cskilbeck/clock_monsieur/firmware/todo.txt

X add reset button
X use GPIO0 for one of the buttons
X fix usb/jtag
X half-bridge driver for anodes + n channel level shifter
X 4 layers
X shrink clock face radius
X flip clock leds, anode on the outside
X A15/A14 at the top (the long ones)
X test points everywhere
X tweak TLC5948 footprint
X fix esp-prog header pinout
X provisioning stuff in factory partition
X OTA firmware update
X measure/tweak cc drain capacitors
X save/load settings in NVS
X small font for menus
X diagnose esp-prog boot / reset problem
X back compatible settings format changes
X save timezone in settings
X Fix factory reset UI
X menus
    X 12/24
    X Seconds mode
    X Colon mode
    X Auto brightness on/off
    X Clock font
    X Brightness
    X Set timezone
    X Show mac address
    X Tick mode on/off/dim/track
X Auto-save settings
X bigger less ridiculous buttons
X put ambient light sensor on the front
X tweak Ambient light sensor gamma ramp
X fancy menu scrolling
X test timezone transition (poke something into the database)

- fancy scrolling in timezone chooser
- button auto-repeat
- AM/PM font for 12 hour clock
- frosted glass/gel problem
