cskilbeck/clock_monsieur/Clock Monsieur.docx

# Clock Monsieur

# Table of Contents

# Assembly

sdadads

# Wi-Fi Instructions

To set up the Wi-Fi on your device

1. On your phone, install App ESP BLE Provisioning

Note: App is not required for normal operation; you can remove it when the setup is complete

2. In the ESP BLE Provisioning app, scan the QR code on the back of the device
3. Select your Wi-Fi network
4. Enter Wi-Fi password (if there is one)

# Factory Reset

Lksdfjlksd flksd j

# Firmware Flashing

adsfasdfd

# Timezone

dssd

# Menus

asdasdas

# Troubleshooting

jkhkjh
