cskilbeck/clock_monsieur/pcb/Outputs/2026-02-18/Bill of Materials-clock_led.xlsx

Comment | Designator | Footprint | JLCPCB Part #
SW-SMD_YZA-072-7.0 | BOOT | FSM-SWITCH-6x6x7.0 | C722968
BUZZER_MLT-7525 | BUZZER | BUZZER_XHXDZ_SMD8530 | C95299
100nF | C1 | CAPC_0603_1608X08L | C7501158
100nF | C2 | CAPC_0603_1608X08L | C7501158
1uF | C3 | CAPC_1206_3216X16L | C5448921
100nF | C4 | CAPC_0603_1608X08L | C7501158
100pF | C5 | CAP_0402 | C1546
100pF | C6 | CAP_0402 | C1546
100pF | C7 | CAP_0402 | C1546
100pF | C8 | CAP_0402 | C1546
100pF | C9 | CAP_0402 | C1546
100pF | C10 | CAP_0402 | C1546
100pF | C11 | CAP_0402 | C1546
100pF | C12 | CAP_0402 | C1546
100pF | C13 | CAP_0402 | C1546
100pF | C14 | CAP_0402 | C1546
100pF | C15 | CAP_0402 | C1546
100pF | C16 | CAP_0402 | C1546
100pF | C17 | CAP_0402 | C1546
100pF | C18 | CAP_0402 | C1546
100pF | C19 | CAP_0402 | C1546
100pF | C20 | CAP_0402 | C1546
100nF | C21_D1 | CAP_0402 | ????
100nF | C21_D2 | CAP_0402 | ????
100nF | C21_D3 | CAP_0402 | ????
100nF | C21_D4 | CAP_0402 | ????
100nF | C21_D5 | CAP_0402 | ????
100nF | C21_D6 | CAP_0402 | ????
100nF | C21_D7 | CAP_0402 | ????
100nF | C21_D8 | CAP_0402 | ????
1uF | C22 | CAPC_1206_3216X16L | C5448921
100nF | C23 | CAPC_0603_1608X08L | C7501158
1uF | C24 | CAPC_1206_3216X16L | C5448921
1uF | C25 | CAPC_1206_3216X16L | C5448921
LED | D1 | LED_0402 | C25503345
LED | D2 | LED_0402 | C25503345
LED | D3 | LED_0402 | C25503345
LED | D4 | LED_0402 | C25503345
LED | D5 | LED_0402 | C25503345
LED | D6 | LED_0402 | C25503345
LED | D7 | LED_0402 | C25503345
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
SW-SMD_YZA-072-7.0 | SW3 | FSM-SWITCH-6x6x7.0 | C722968
SW-SMD_YZA-072-7.0 | SW4 | FSM-SWITCH-6x6x7.0 | C722968
GT-USB-7055BB | USB | USB-C-TH_GT-USB-7055BB | C7450621
ESP32-S3-WROOM-1-N4 | WiFi_Module | XCVR_ESP32-S3-WROOM-1-N16R2 | C2913197
