cskilbeck/clock_monsieur/pcb/Models/SW-SMD-6x6x5.5.step

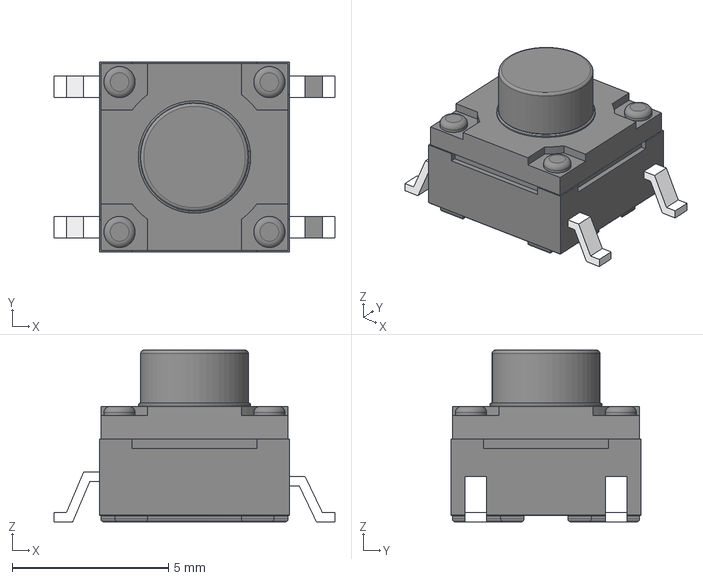
[picture p1: CAD file, 2025-12-19]
pcb/Models/SW-SMD-6x6x5.5.step
9.00 x 6.10 x 5.50 mm
