cskilbeck/clock_monsieur/pcb/Outputs/2026-02-18/clock_led.step

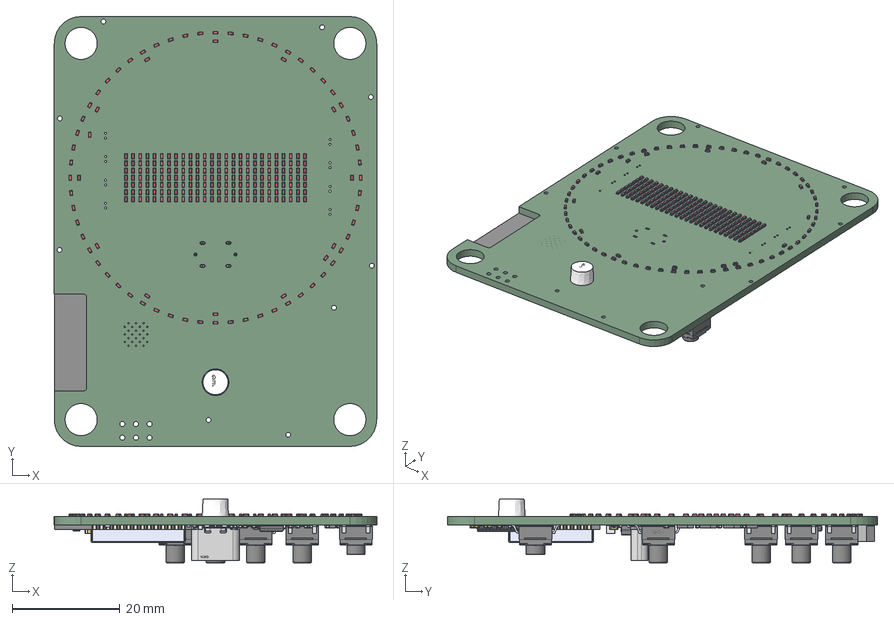
[picture p2: CAD file, 2026-02-19]
pcb/Outputs/2026-02-18/clock_led.step
60.0 x 80.0 x 11.8 mm
lead x 6
Leader x 27
BUZ-SMD_4P-L8.5-W8.5_FUET-8530-05~BUZ-SMD_4P-L8.5-W8.5-H3.0_ FUET-8530-05~5bKo x 9
0402 resistor x 8
EVERLIGHT_ALS-PT243-3C
SW-SMD-6x6x7.0 x 5
DFN-8_L2.0-W2.0-P0.50-BL-EP~DFN-8_L2.0-W2.0-H0.8-P0.50~jj2n x 8
SW-SMD-6x6x5.5
Lead x 3
Tab
USB-C-TH_GT-USB-7055BB_ORIGIN
LED0402 x 256
