cskilbeck/clock_monsieur/enclosure/stand.SLDPRT

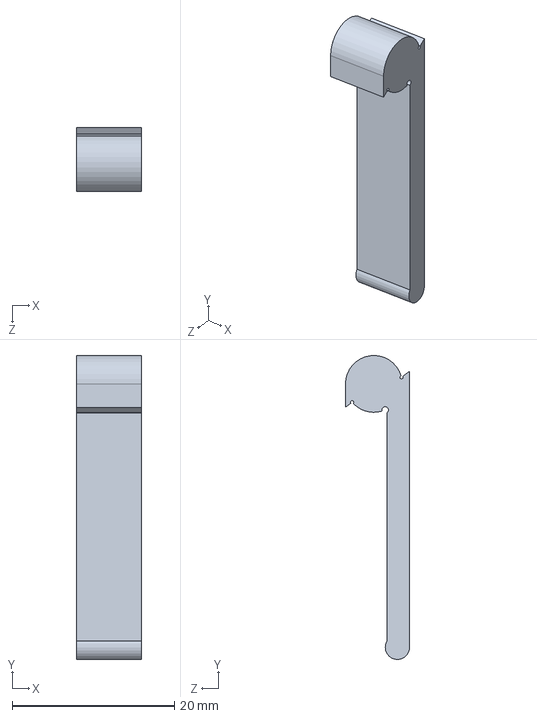
[picture p3: CAD file, 2026-02-23]
enclosure/stand.SLDPRT
8.00 x 37.4 x 7.90 mm
