cskilbeck/clock_monsieur/pcb/Models/SW-SMD-6x6x7.0.step

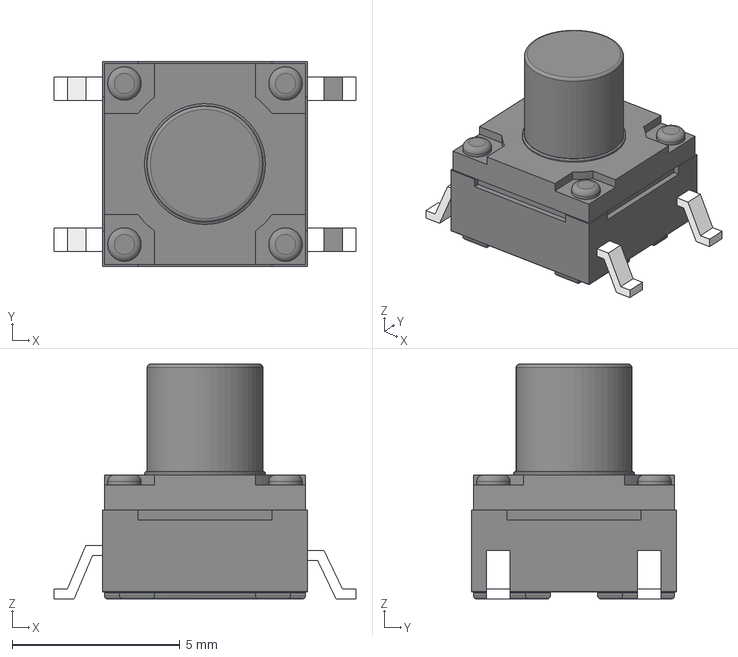
[picture p4: CAD file, 2025-12-19]
pcb/Models/SW-SMD-6x6x7.0.step
9.00 x 6.10 x 7.00 mm
