cskilbeck/clock_monsieur/enclosure/glass.SLDPRT

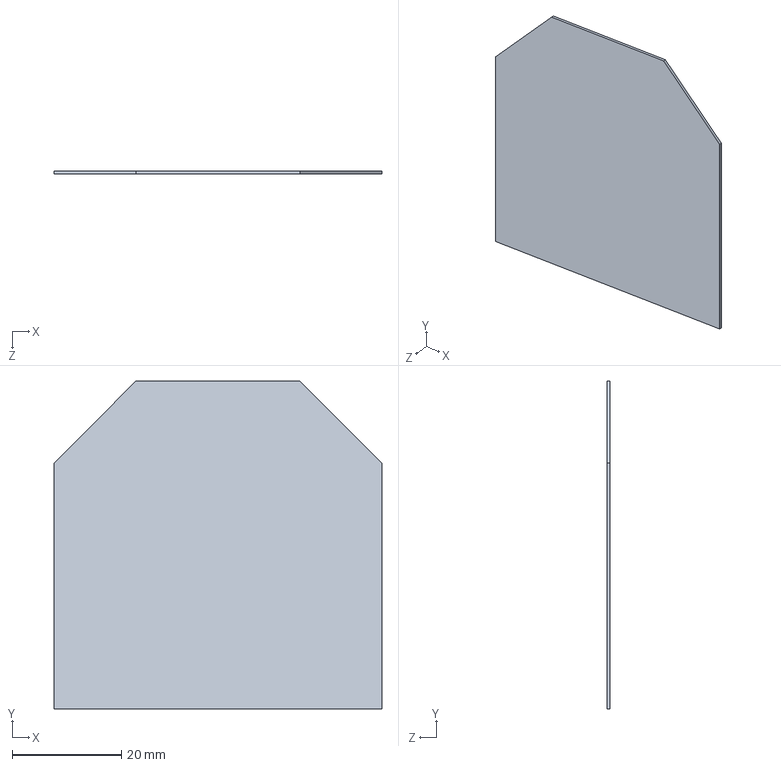
[picture p5: CAD file, 2026-02-23]
enclosure/glass.SLDPRT
60.0 x 60.0 x 0.61 mm
