cskilbeck/clock_monsieur/enclosure/screw_st2_2x6_5_c_0.SLDPRT

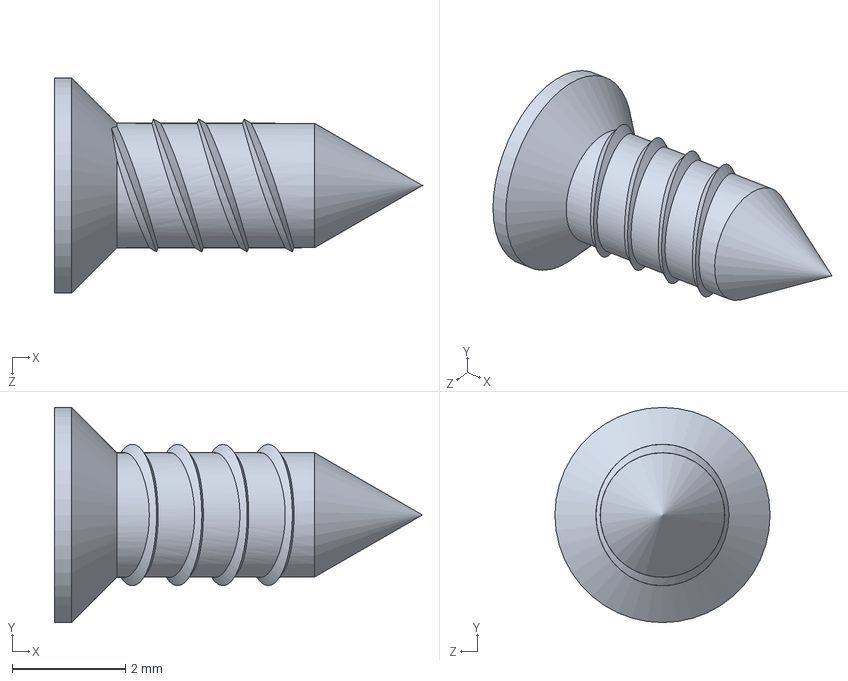
[picture p6: CAD file, 2025-12-19]
enclosure/screw_st2_2x6_5_c_0.SLDPRT
6.50 x 3.80 x 3.80 mm
