cskilbeck/clock_monsieur/pcb/Outputs/2025-11-04/clock_led.step

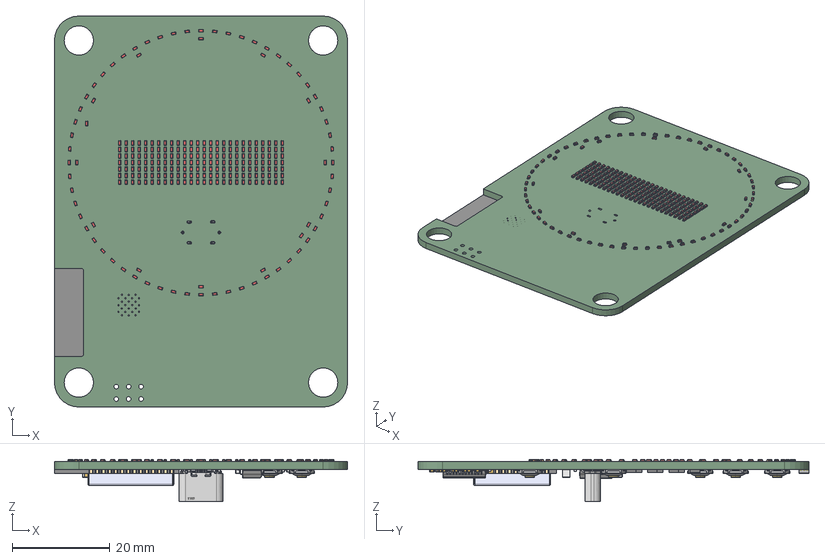
[picture p7: CAD file, 2025-11-04, an earlier design]
pcb/Outputs/2025-11-04/clock_led.step
60.0 x 80.0 x 8.62 mm
swt0220-016016gsa x 6
Leader x 24
Thermal_Shape x 8
Pin_Shape x 64
0402 resistor x 5
U1~TDFN-6_L2.0-W2.0-P0.65-BL~TDFN-6_L2.0-W2.0-H0.8-P0.65-BL~aoMD - TDFN-6_L2.0-W2.0-P0.65-BL~TDFN-6_L2.0-W2.0-H0.8-P0.65-BL~aoMD
Lead x 3
Tab
USB-C-TH_GT-USB-7055BB_ORIGIN
LED0402 x 256
