cskilbeck/clock_monsieur/enclosure/clock_monsieur.SLDASM

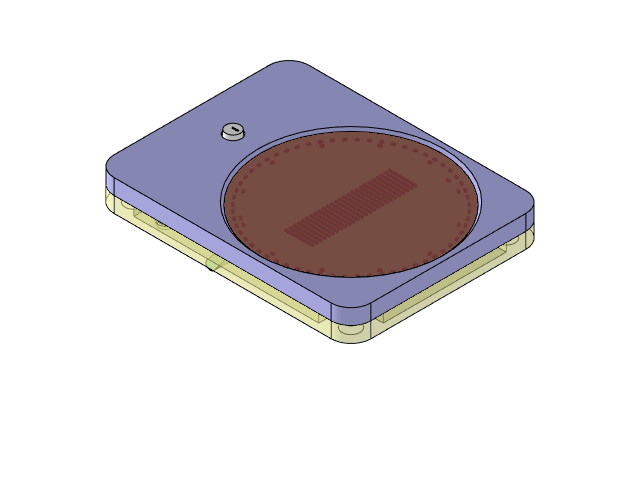
[picture p8: CAD file, 2026-02-23]
enclosure/clock_monsieur.SLDASM
front
glass
back
screw_st2_2x6_5_c_0
stand
clock_led_pcb
