cskilbeck/clock_monsieur/enclosure/enclosure.SLDASM

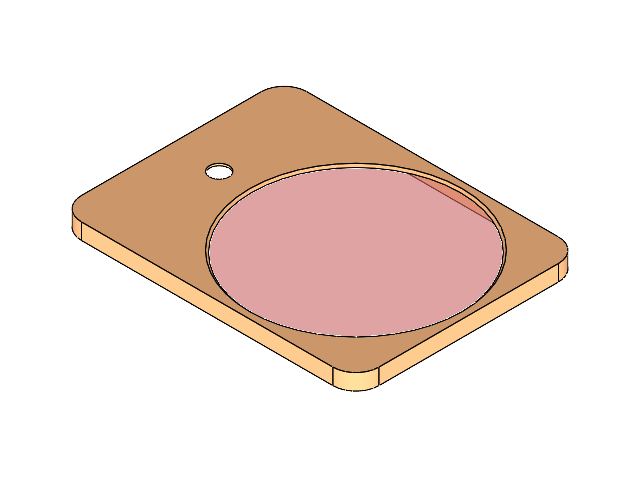
[picture p9: CAD file, 2026-02-23]
enclosure/enclosure.SLDASM
front
glass
back
