cskilbeck/clock_monsieur/(list of files, cad)

Other CAD files:
enclosure/front.SLDPRT
enclosure/clock_led_pcb.SLDPRT
enclosure/back.SLDPRT
enclosure/clock_led.step
pcb/Outputs/2025-12-19/clock_led.step
pcb/Outputs/2025-12-22/clock_led.step
pcb/Outputs/2026-01-08/clock_led.step
pcb/Outputs/2026-01-17/clock_led.step
