cskilbeck/clock_monsieur/Instructions.docx

Clock Monsieur

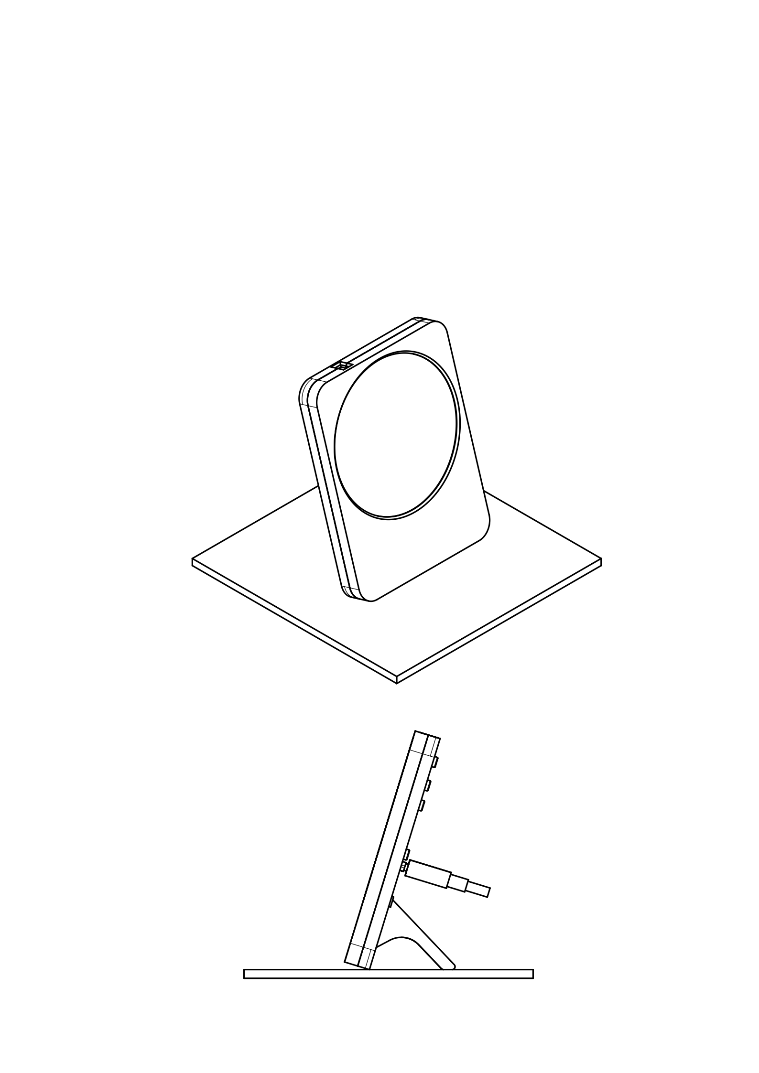
[picture p10: figure]

# Features

- The clock is Wi-Fi enabled, so it's ALWAYS right
- Continuously monitors multiple network time servers for redundancy
- Global timezone database stores all Daylight Savings Times to the exact second
- Daylight savings time is updated instantly at the correct millisecond
- Select timezone manually or automatically (using Geo-IP database lookup)
- Bright LED display is super visible in any conditions
- Ambient light sensor for auto brightness
- Fully configurable display - seconds, font, colon etc
- Wi-Fi provisioning via standard Espressif App (ESP BLE Provisioning)
- Over-the-air firmware update capability

# Dimensions

- Display 60mm diameter
- Digits 10mm high
- Body 63mm wide, 84mm tall, 10mm deep

# Connectivity

- Wi-Fi (Global time synchronization, firmware update)
- USB-C (Power, firmware update)

# Power

- USB 5V, 500mA

# Buttons

There are 6 buttons…

- Reset – reset the clock
- Up/Down/Left/Right – Navigate menus
- Select – select menu item
- Hold any of Up/Down/Left/Right/Select while the clock is reset or powering up to enter Factory Reset mode.

# Factory Reset

How to factory reset.

# Provisioning

To provision your device…

# Menus

Press the Select key to activate the menu system.

| Menu | | | Function
| Settings
| | Mode | | Choose clock 12/24-hour mode
| | Brightness | | Brightness settings
| | | Auto/Fixed | Set Auto/Fixed brightness
| | | Level | Brightness Level - Low, Medium, High, Max
| | Seconds | | Set Seconds mode
| | | Single | Only current second
| | | Fixed | All seconds so far in this minute
| | | Long | Long tail of seconds
| | | Medium | Medium tail of seconds
| | | Short | Short tail of seconds
| | Colon | | Set colon mode
| | | Off | No colon
| | | On | Colon normal
| | | Dim | Colon dimmed
| | | Pulse | Colon pulses at 0.5Hz
| | Ticks
| | | On | 5-minute Ticks are always on
| | | Off | Ticks always off
| | | Dim | Ticks always dim
| | | Track | Ticks track seconds
| | Font | | Choose clock time font Normal/Square
| | Fade | | Set second-to-second fade
| | | Low | 0.25 second fade
| | | Medium | 0.5 second fade
| | | High | 1 second fade
| | | Off | No fade, seconds/time instant transition
| Timezone | | | Timezone settings
| | Auto | | Use IP lookup for auto timezone location
| | Select | | Choose timezone location manually
| System | | | System info/settings
| | Version | | Show software version
| | IP Address | | Show IP address
| | MAC Address | | Show MAC Address
| | Factory reset | | Factory reset (all user and wifi settings)
