cskilbeck/clock_monsieur/pcb/Outputs/2026-02-18/clock_led.pdf

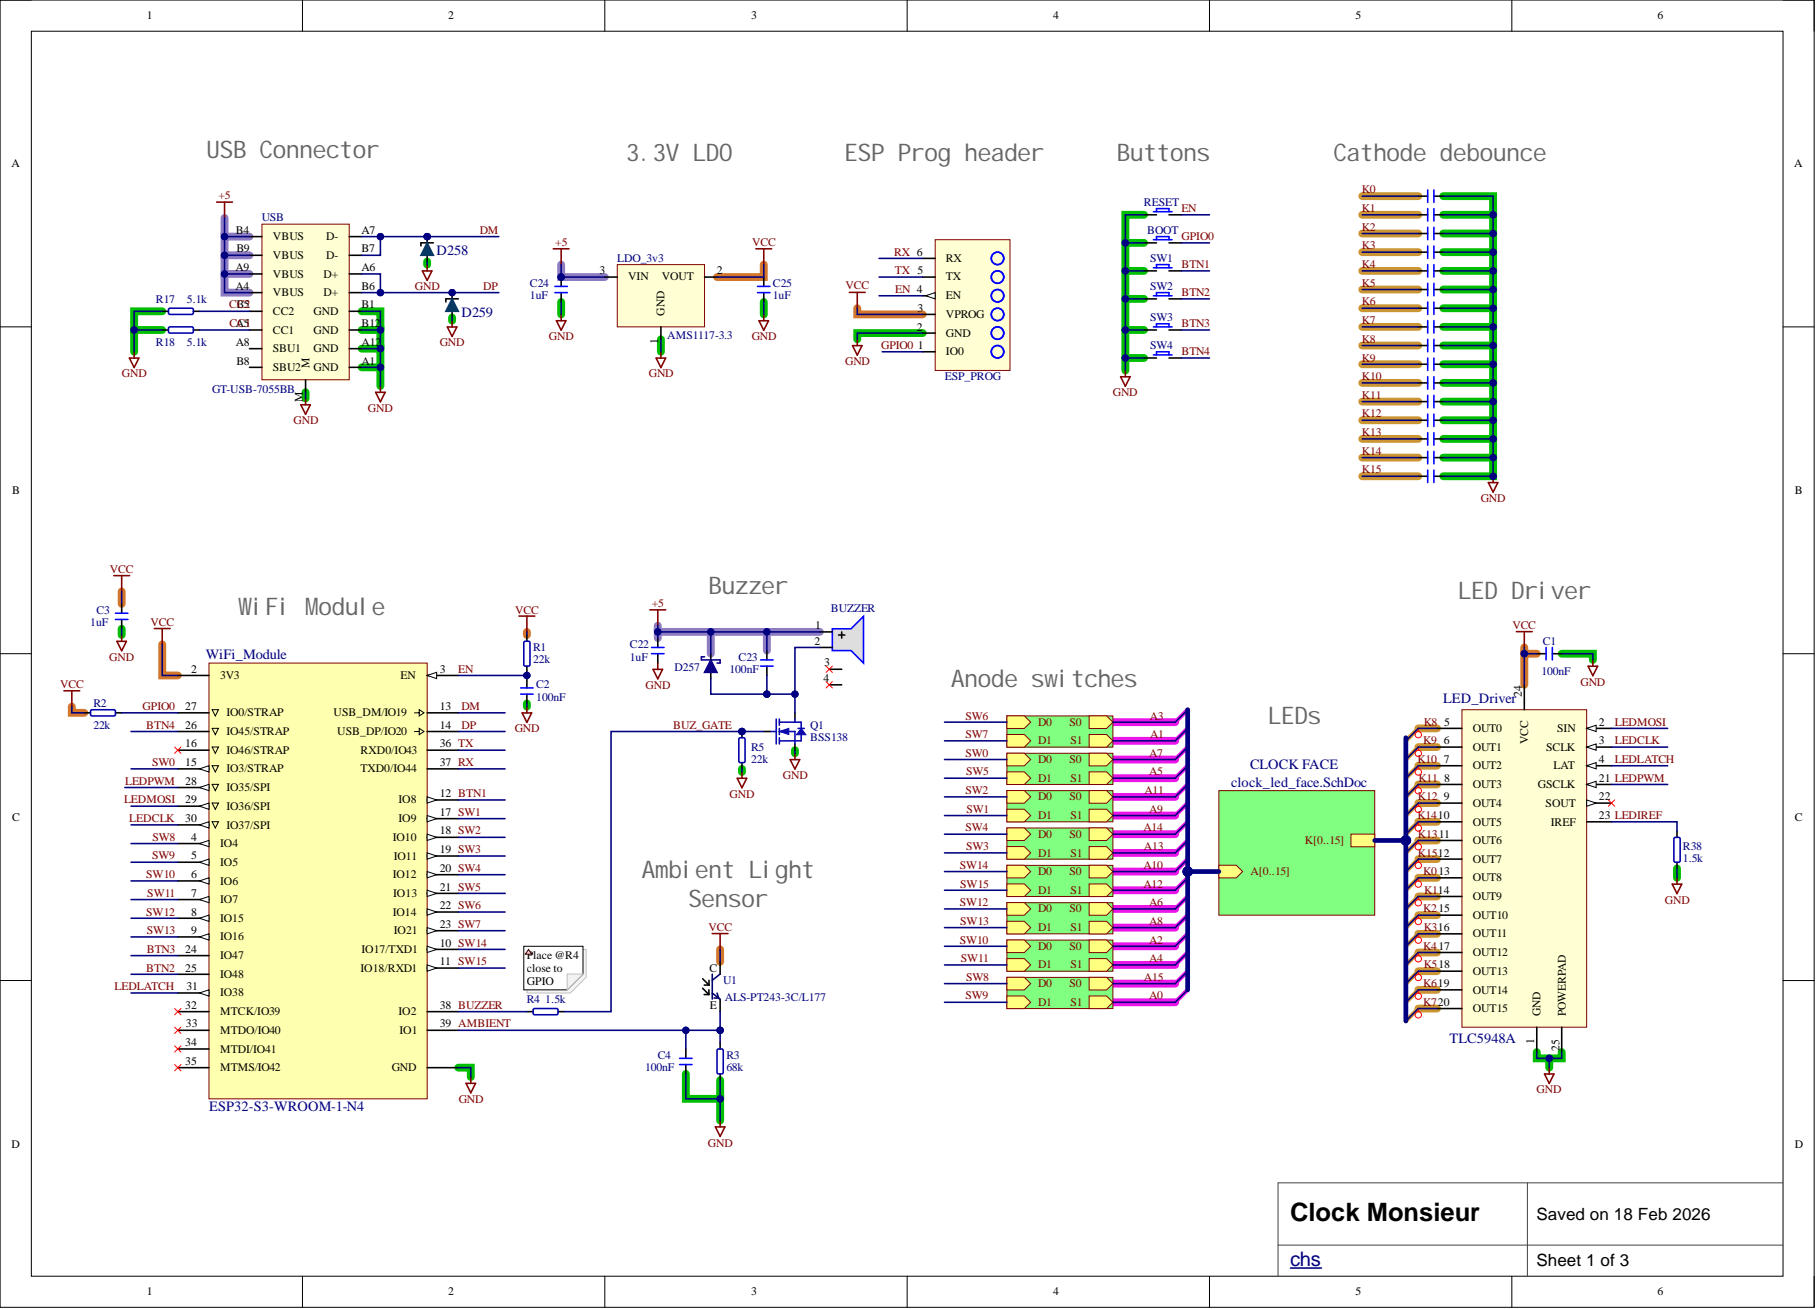
[picture p11: page 1]

A 9 | A 6
A4

Sheet 1 of 3 Saved on 18 Feb 2026

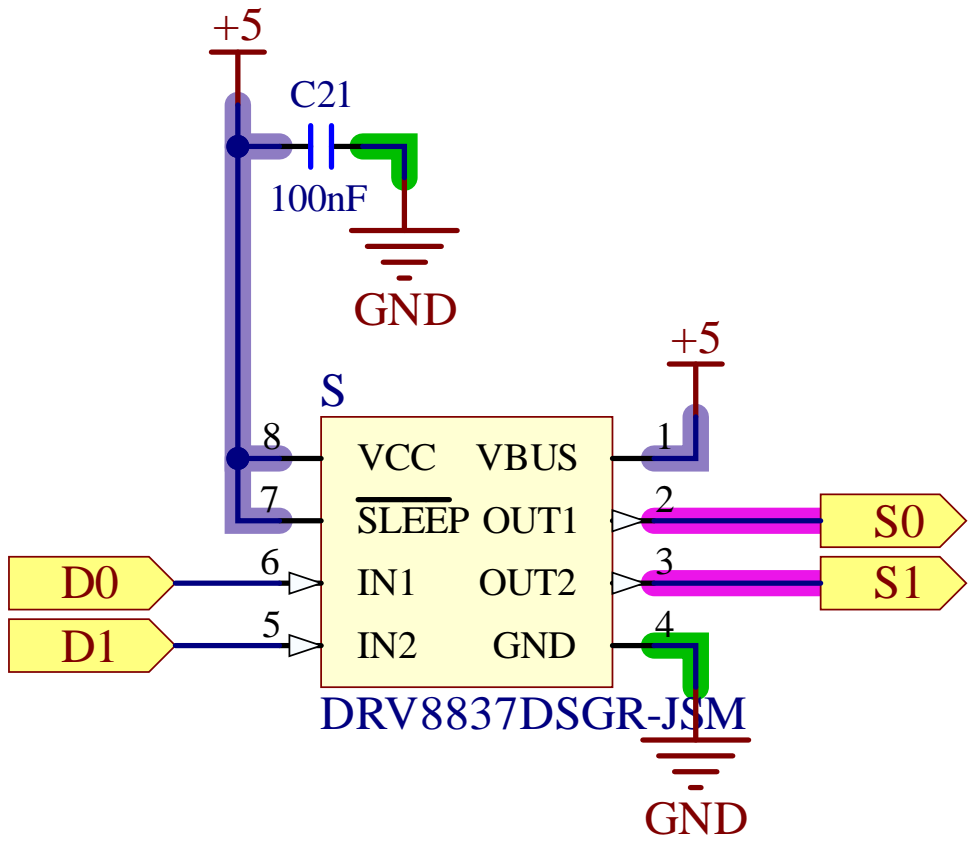
[picture p12: page 2]

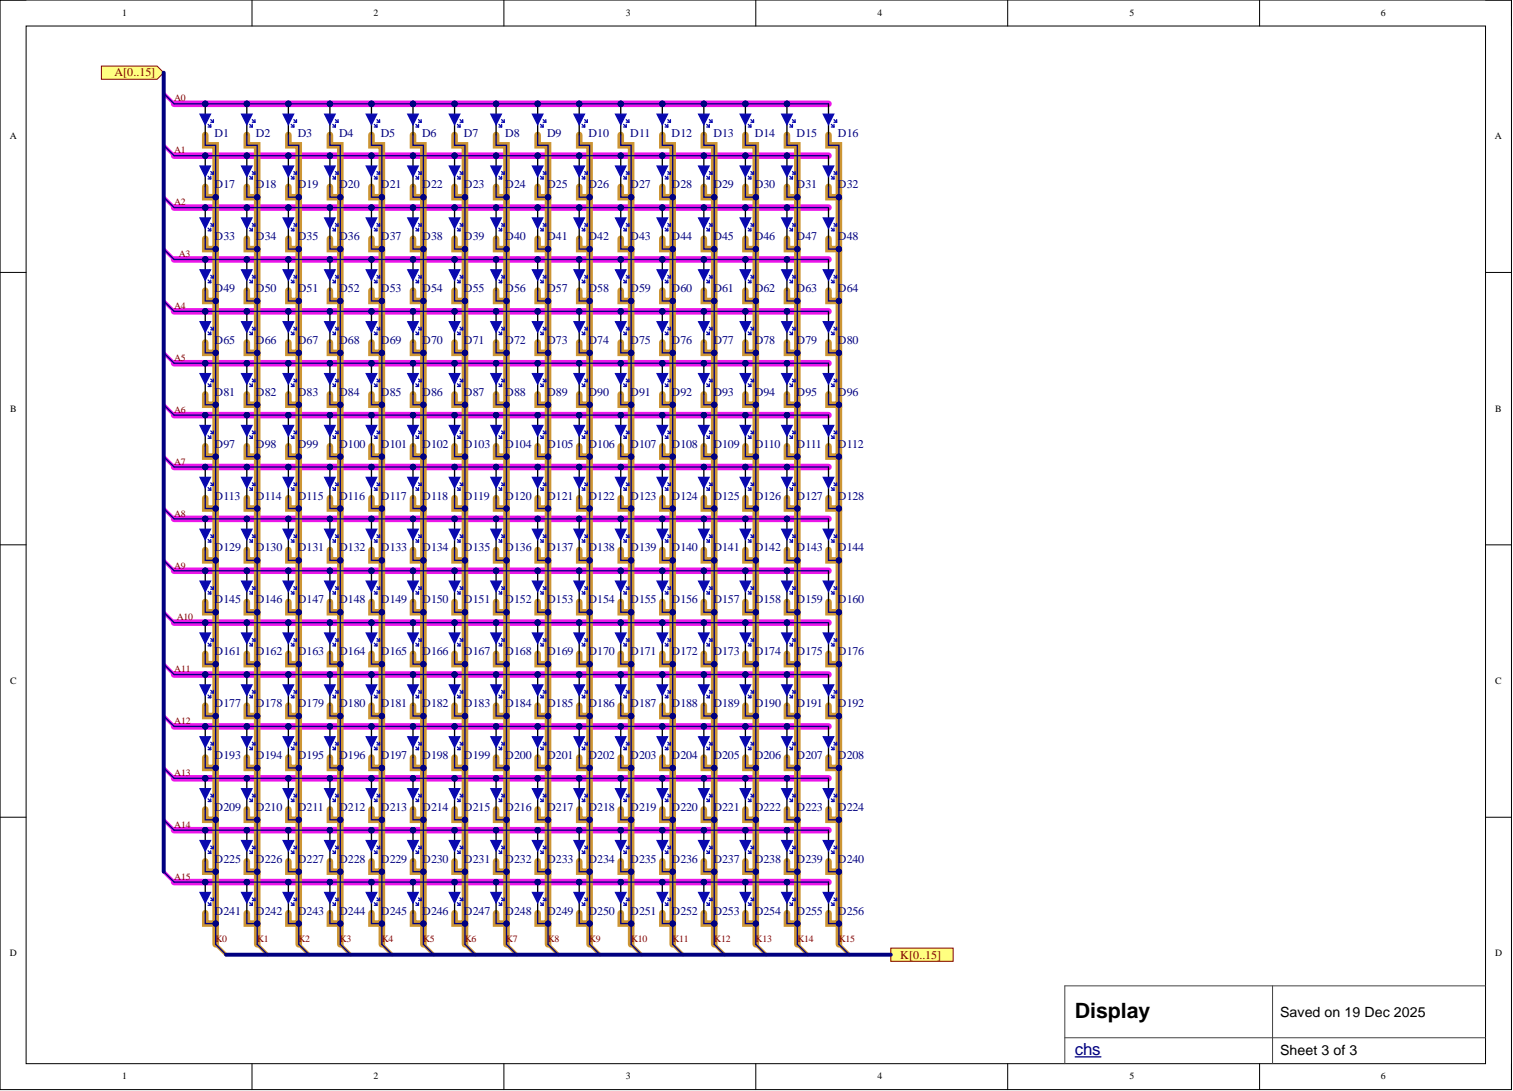
[picture p13: page 3]

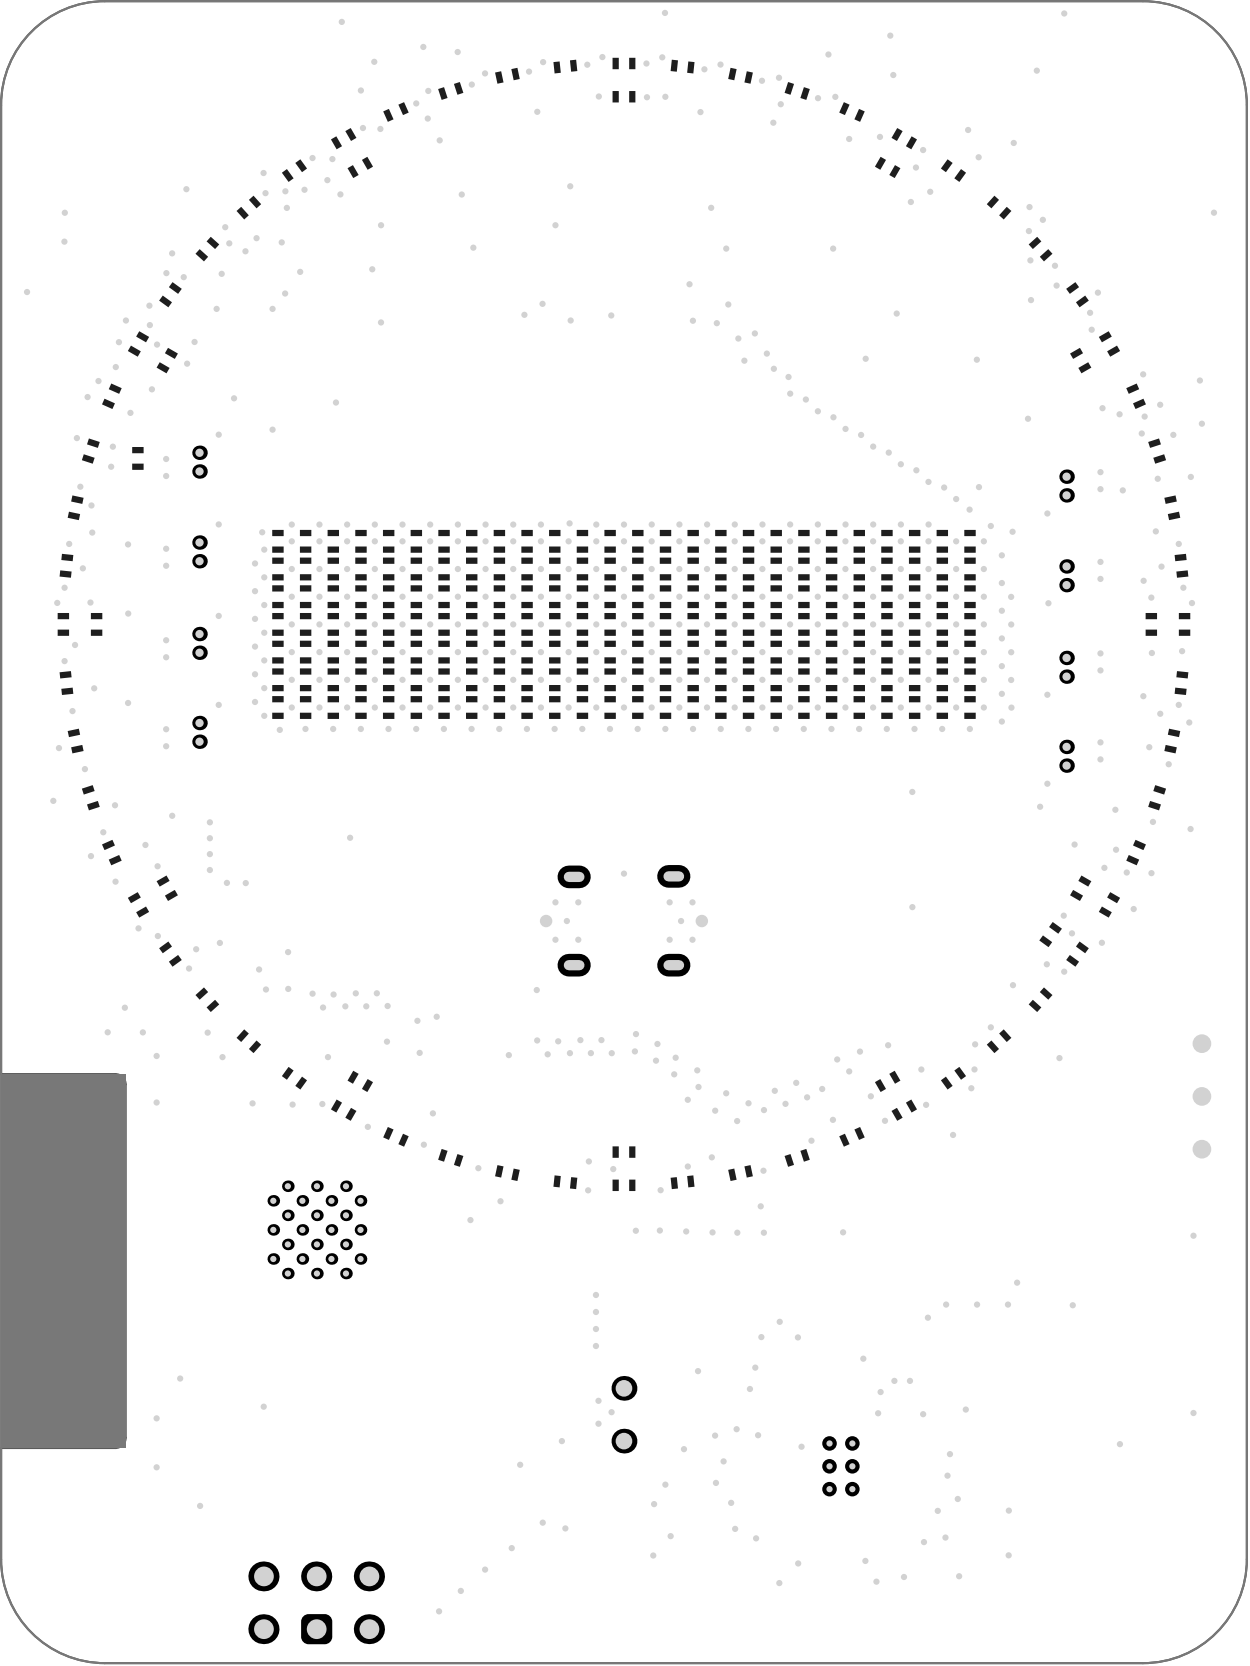
[picture p14: page 4]

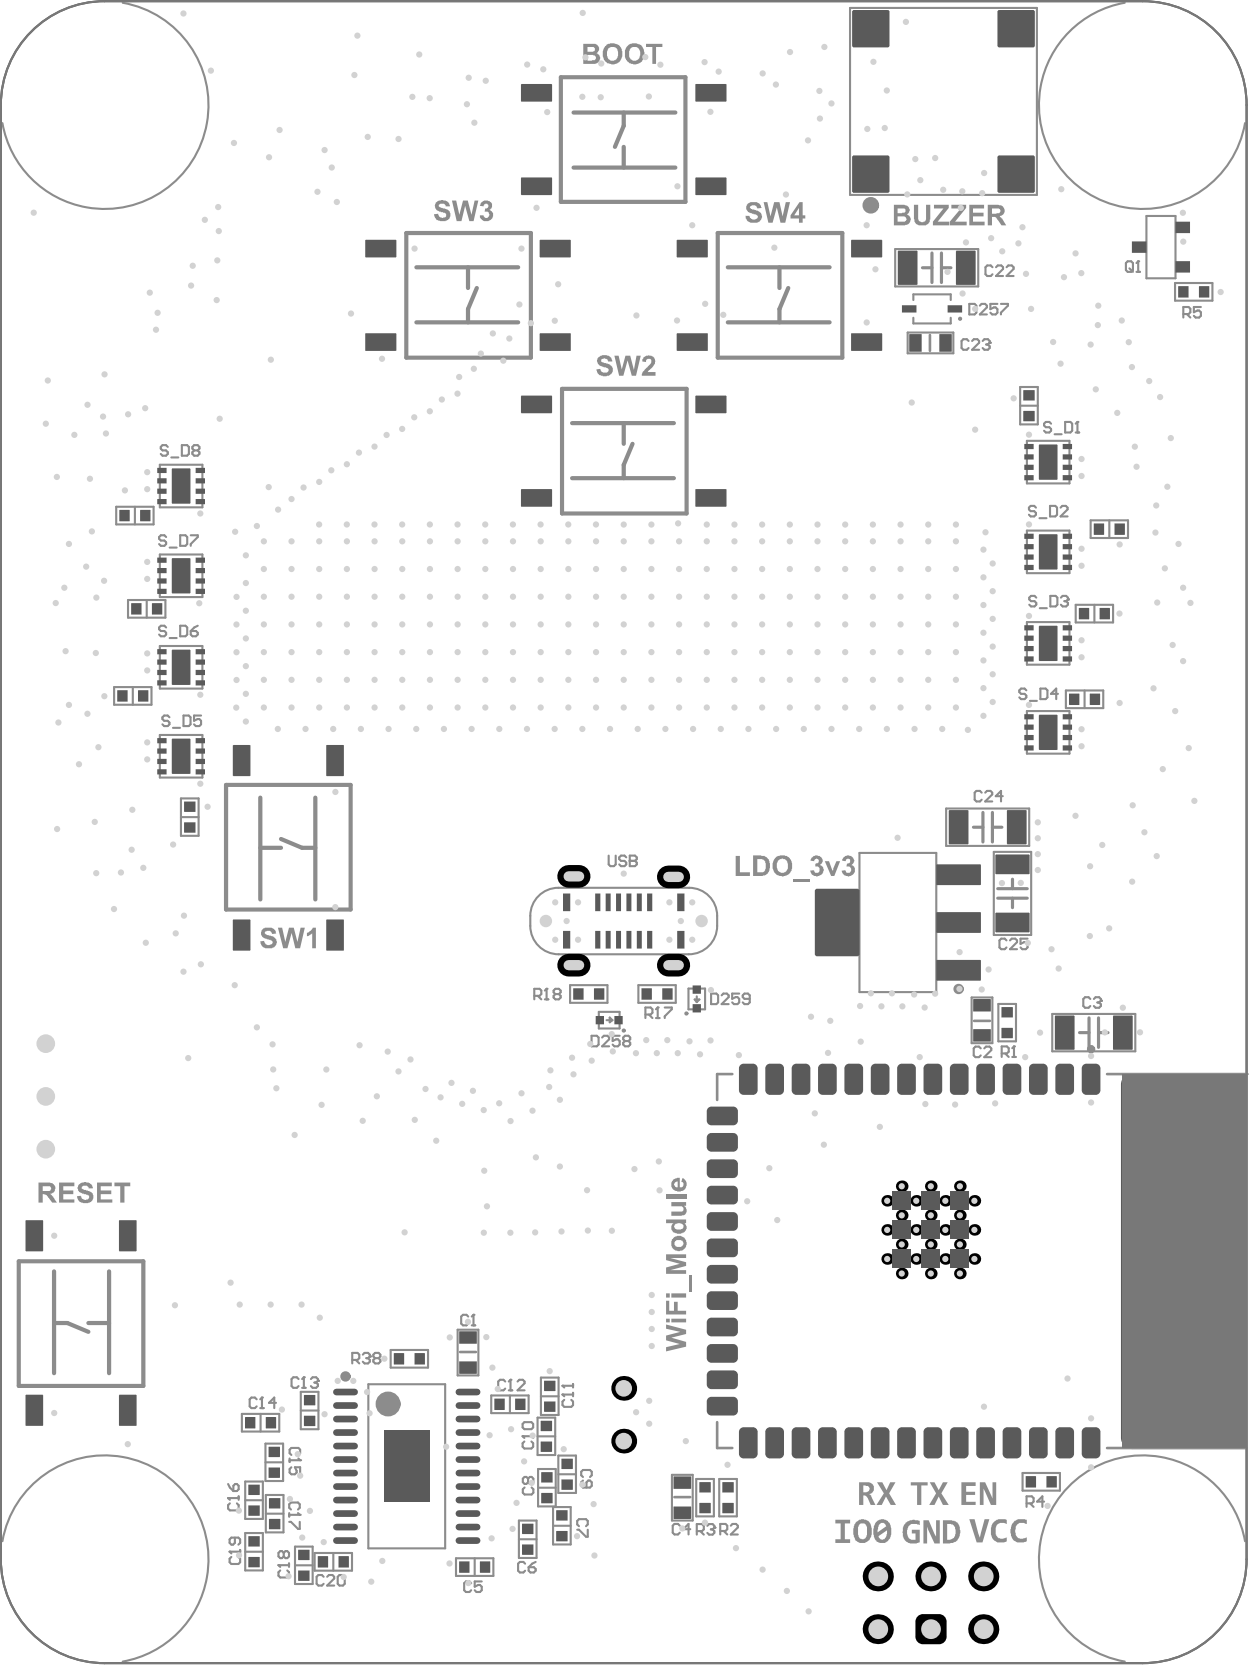
[picture p15: page 5]

# Electrical Rules Check Report

Class | Document | Message Successful Compile for clock_led.PrjPcb
Wednesday 18 Feb 2026 11:54:08 PM | Page 1 of 1

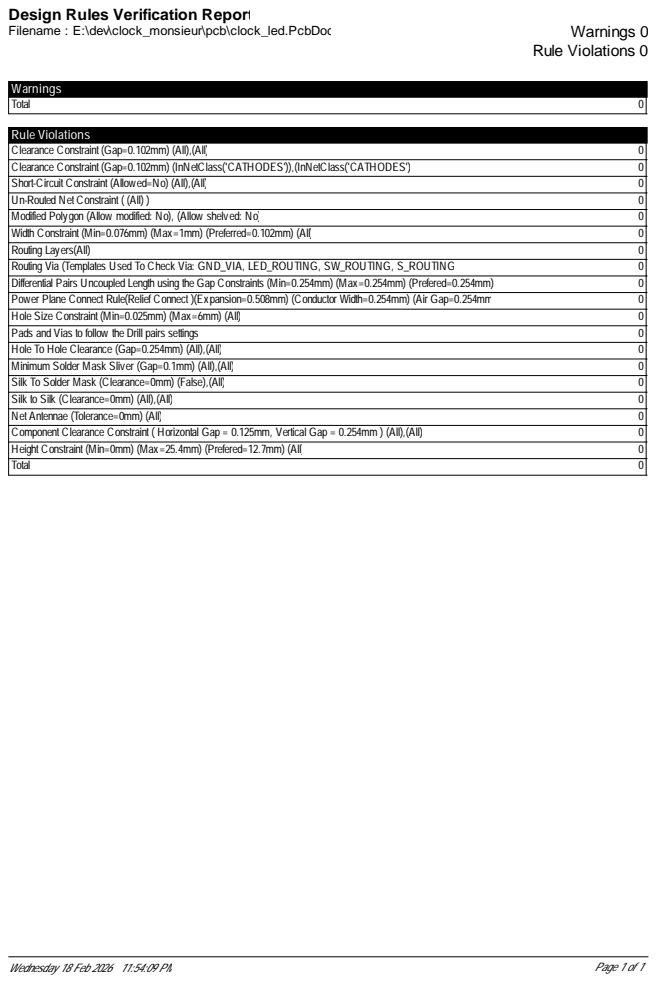
[picture p16: page 7]

Design Rules Verification Report

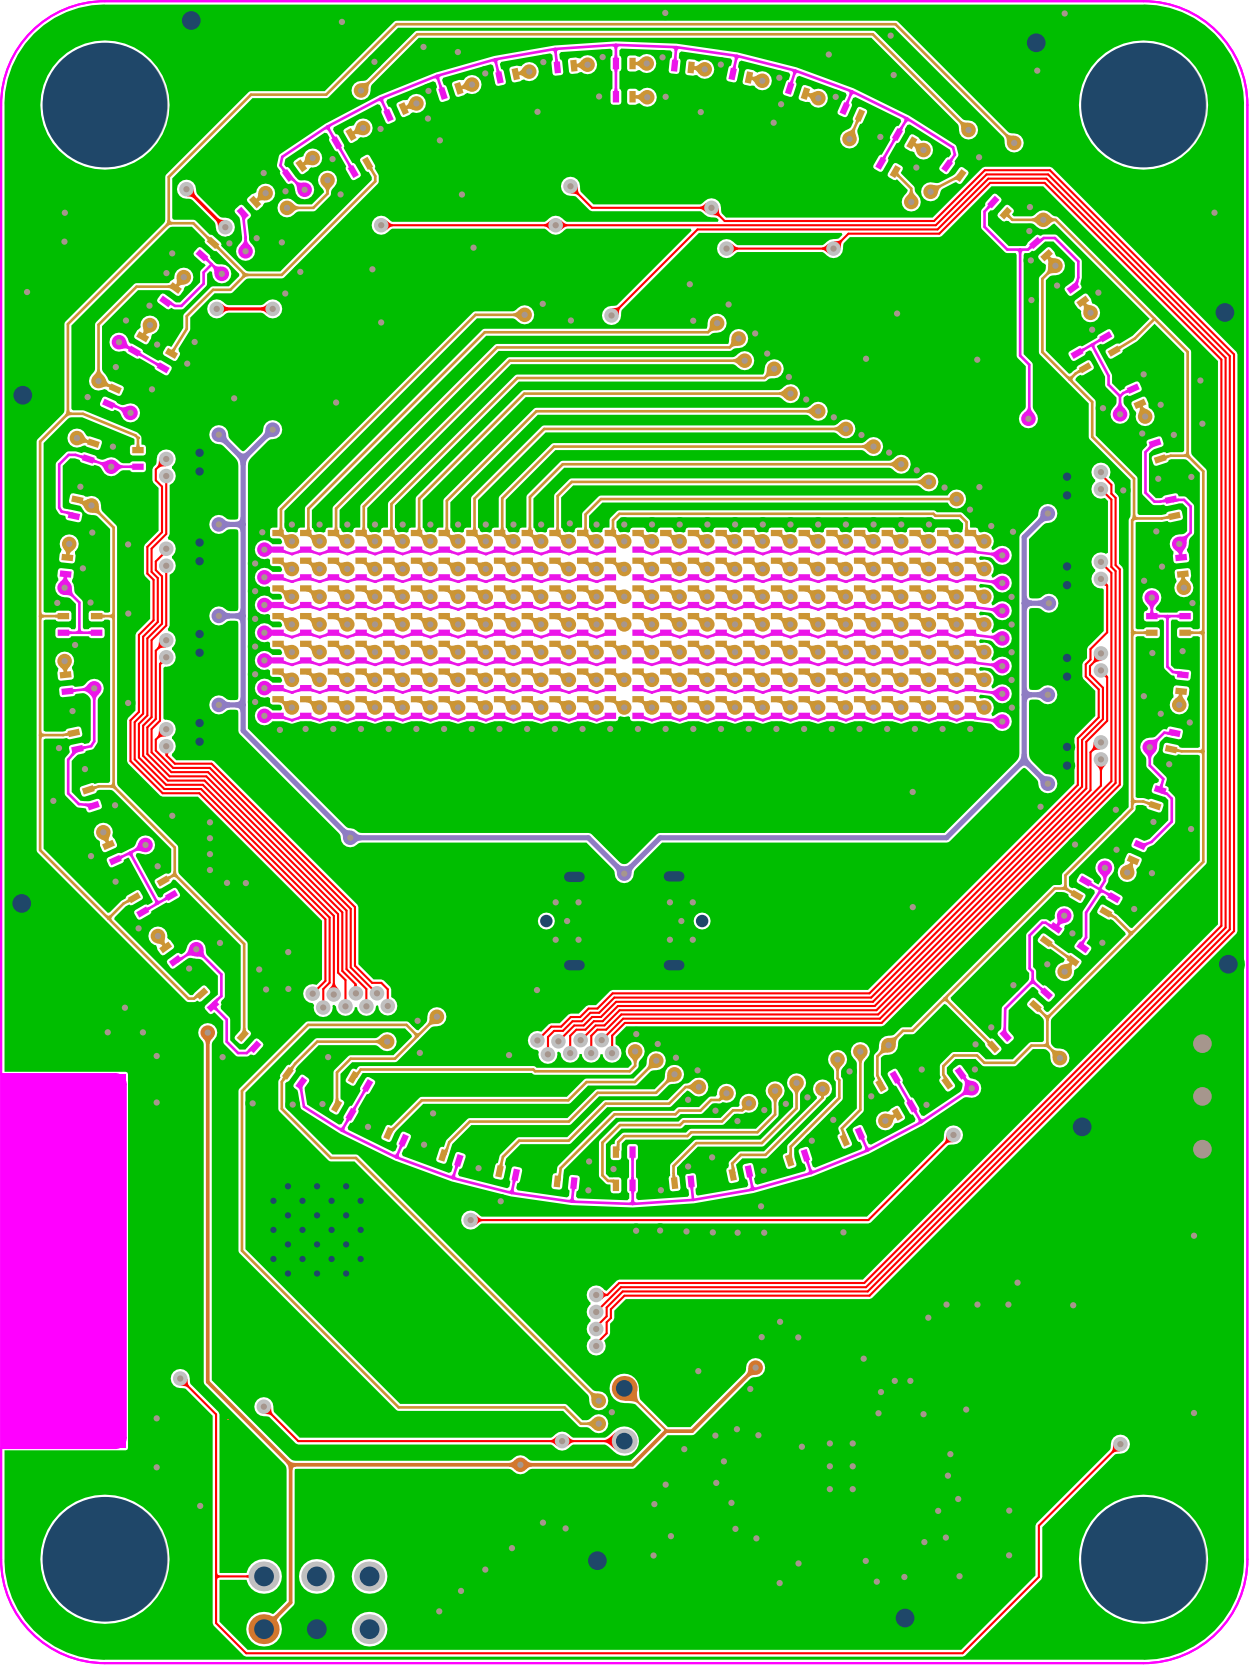
[picture p17: page 8]

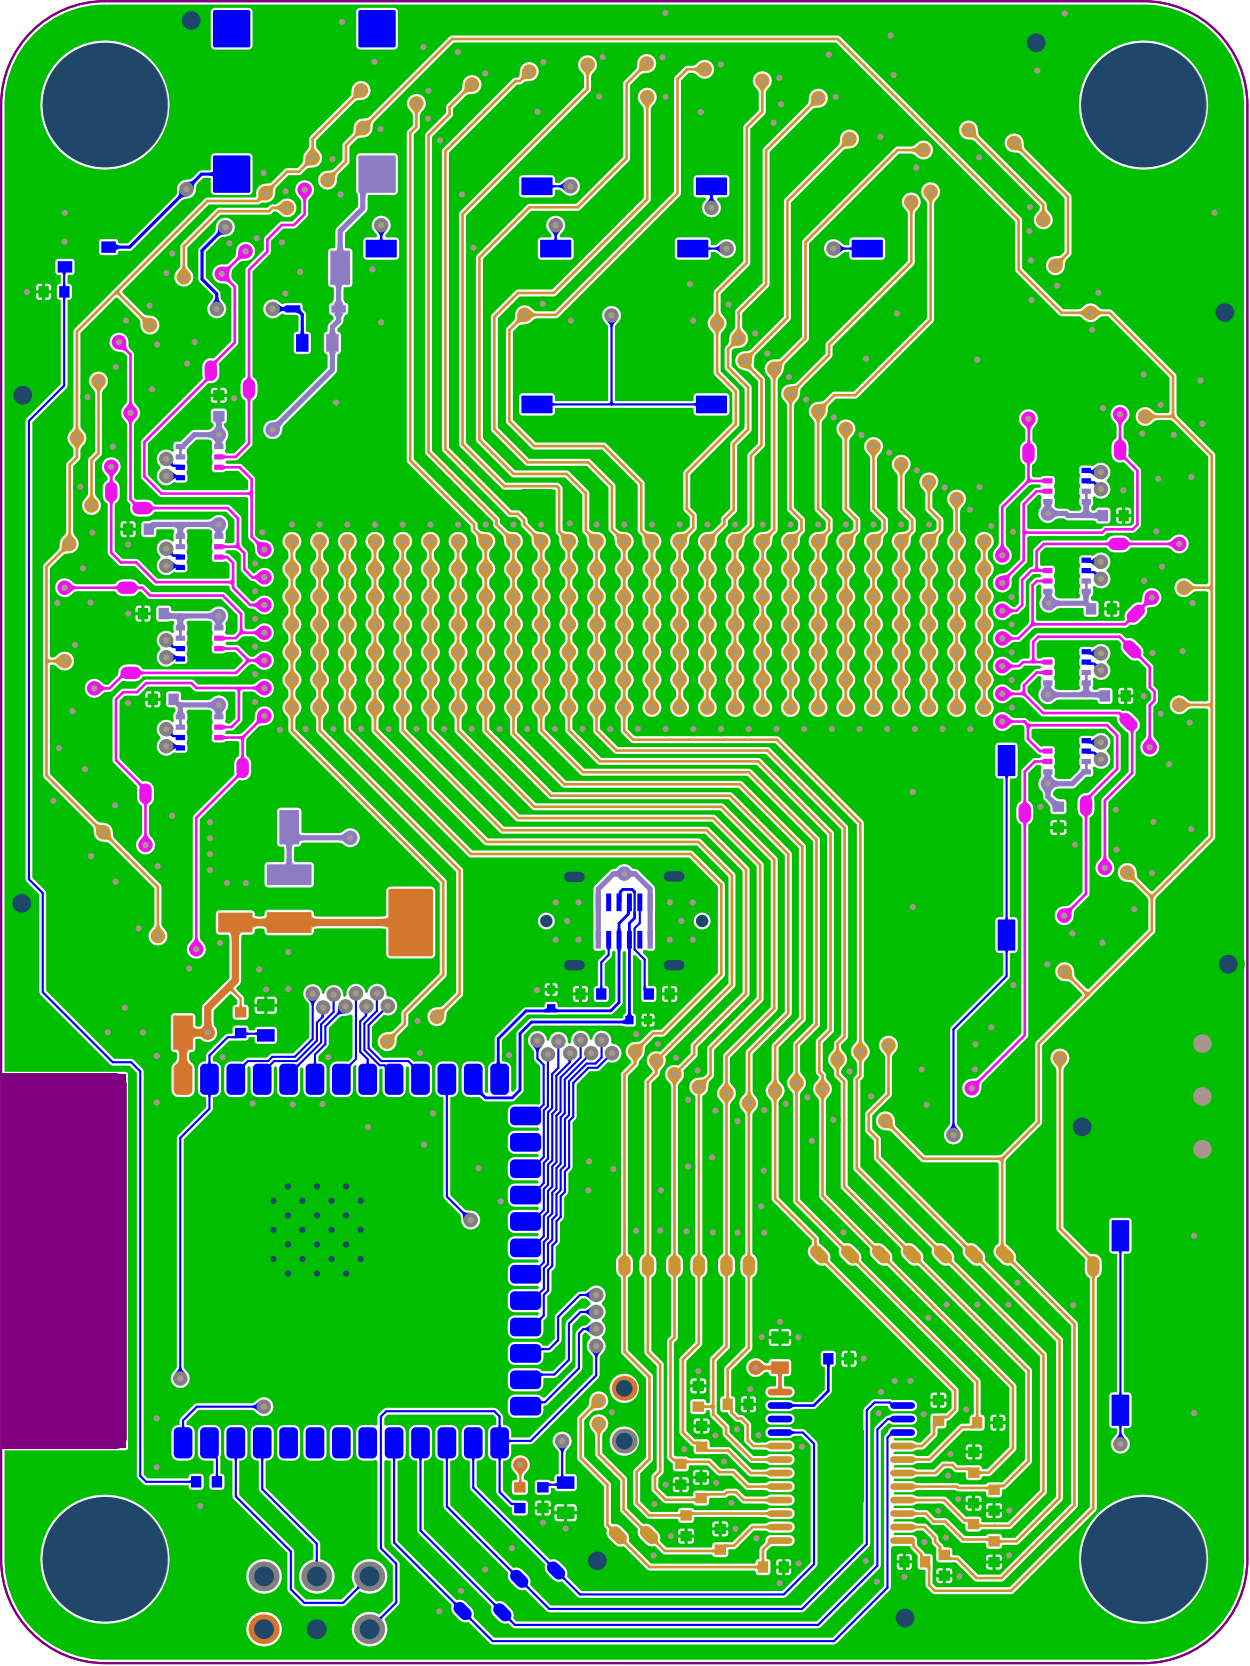
[picture p18: page 9]

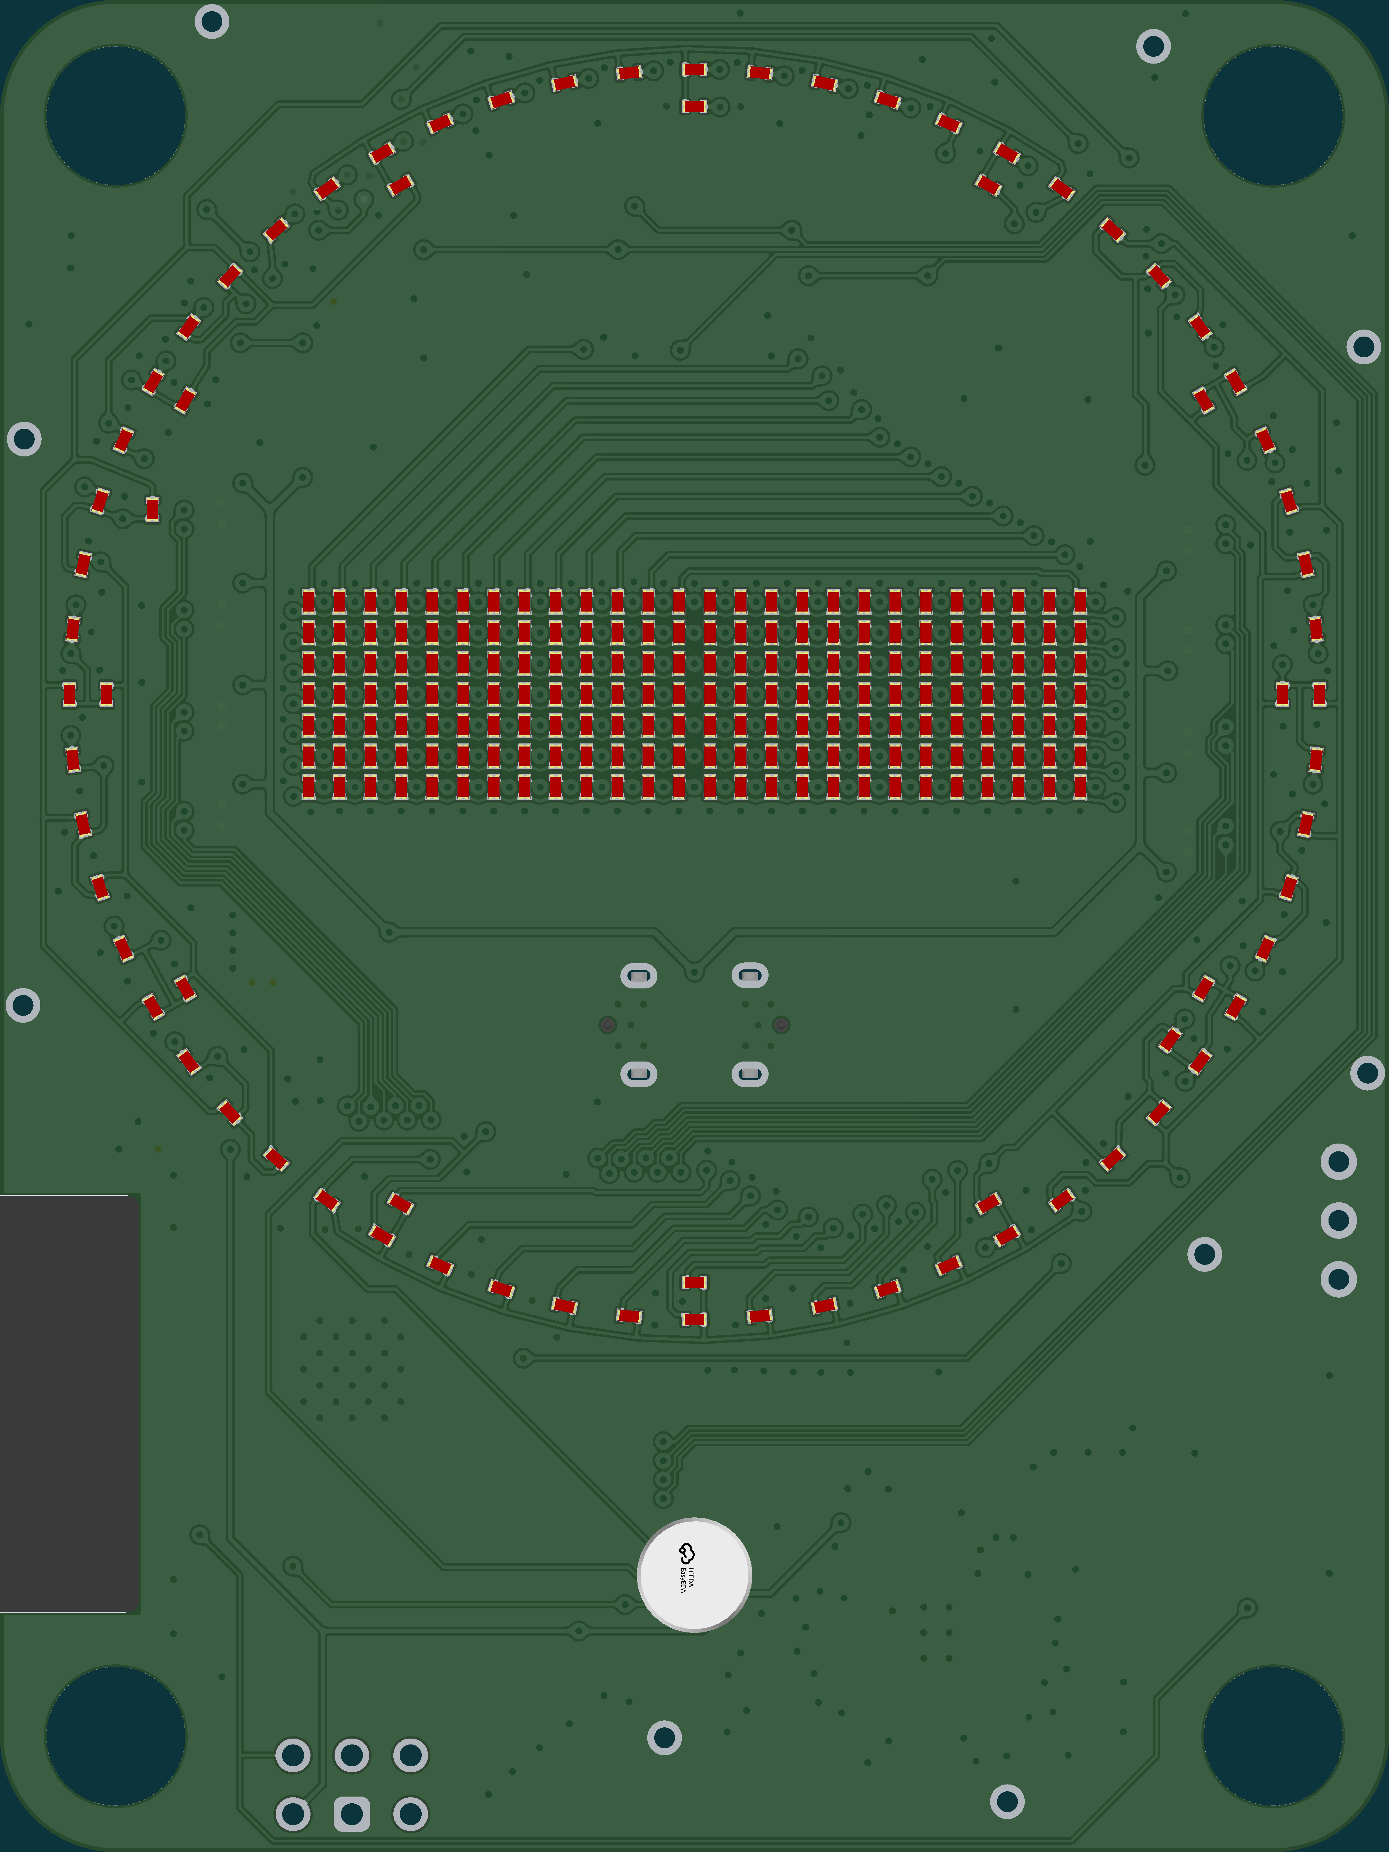
[picture p19: page 10]

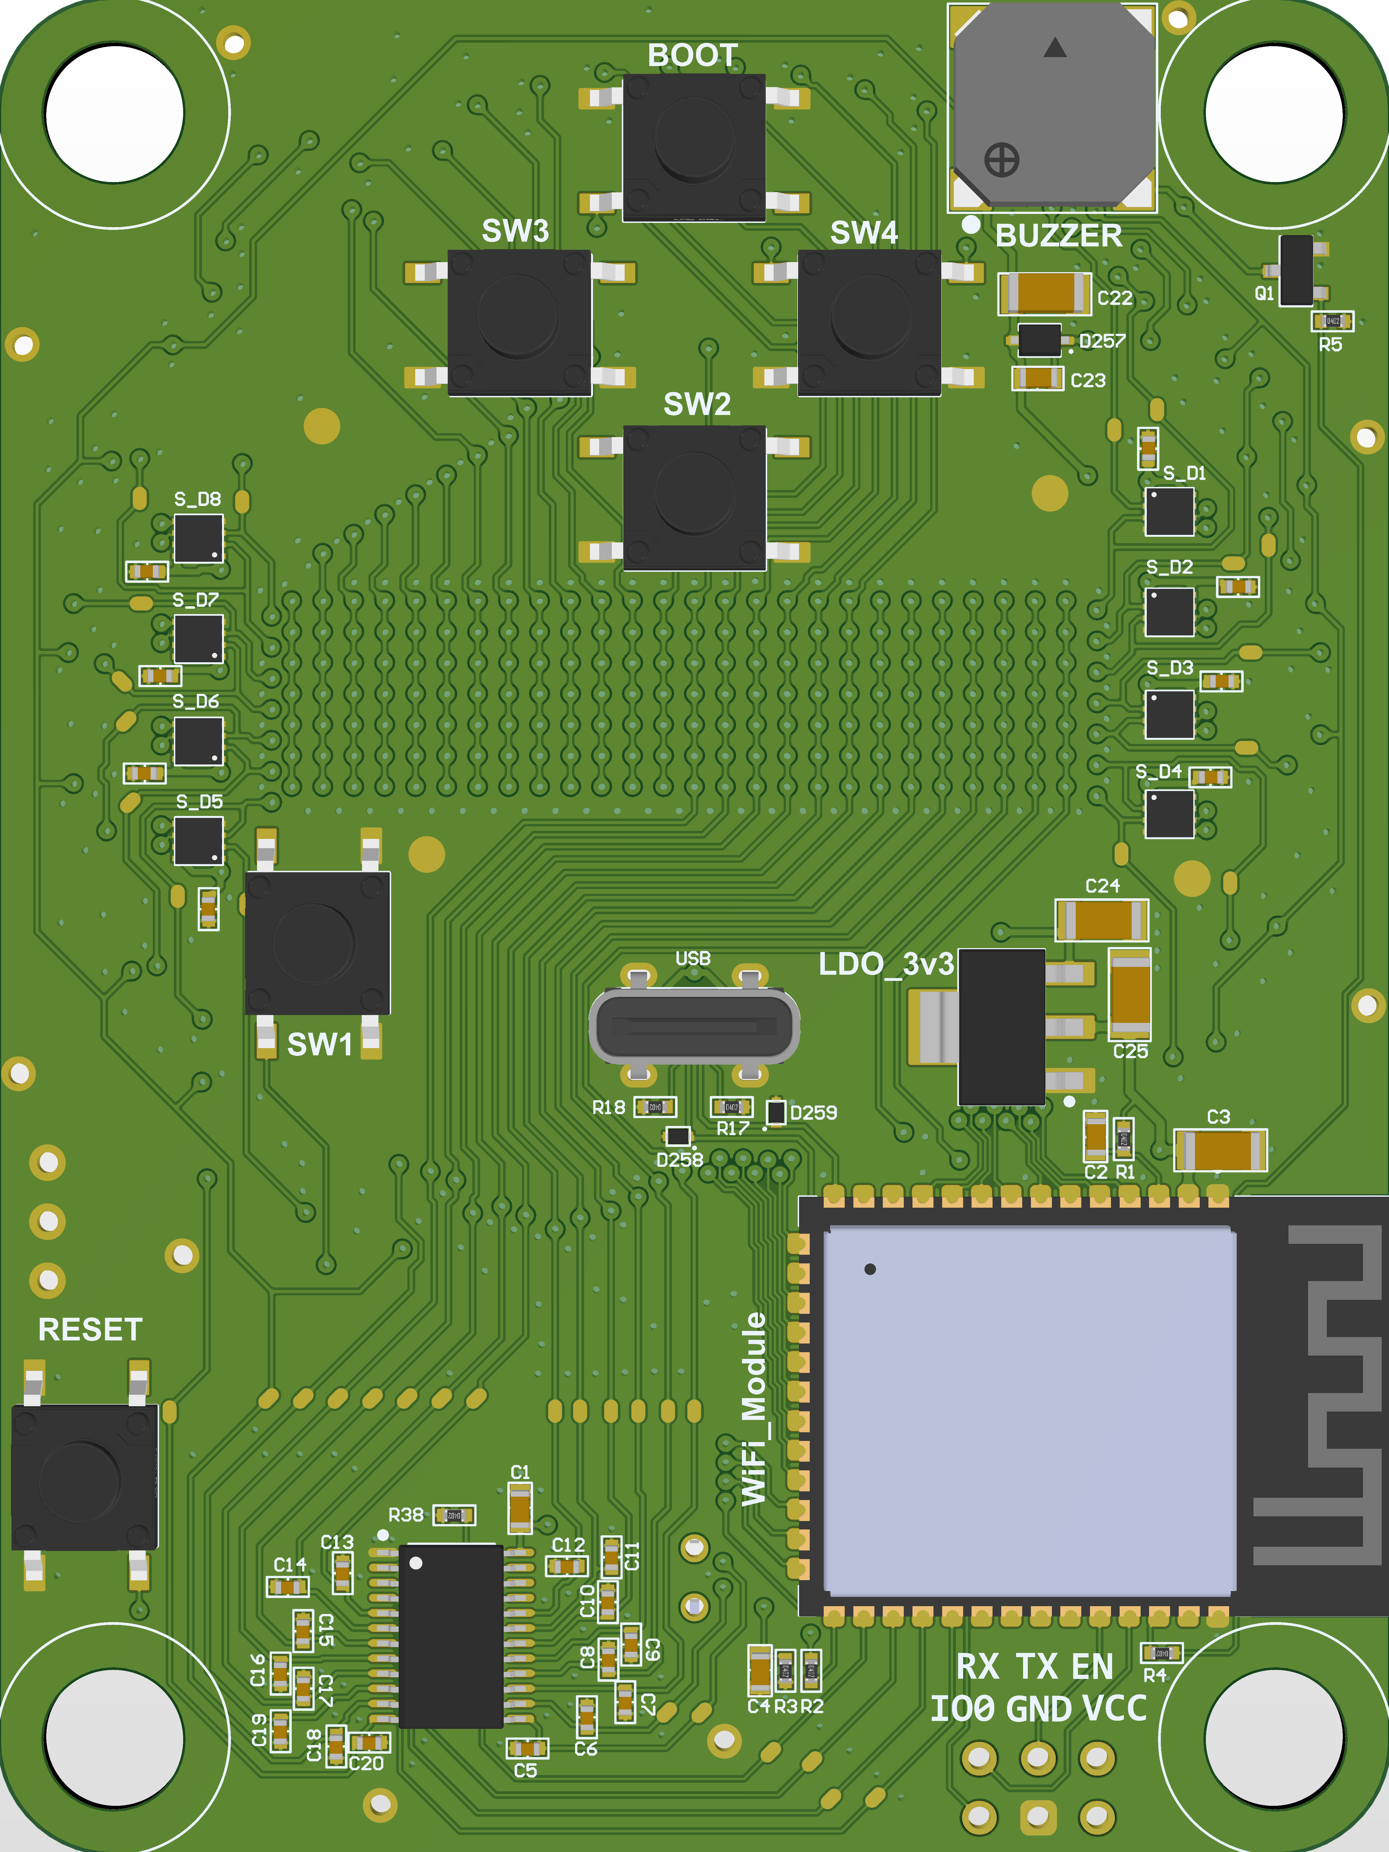
[picture p20: page 11]
