cskilbeck/clock_monsieur/pcb/Outputs/2026-01-17/clock_led.pdf

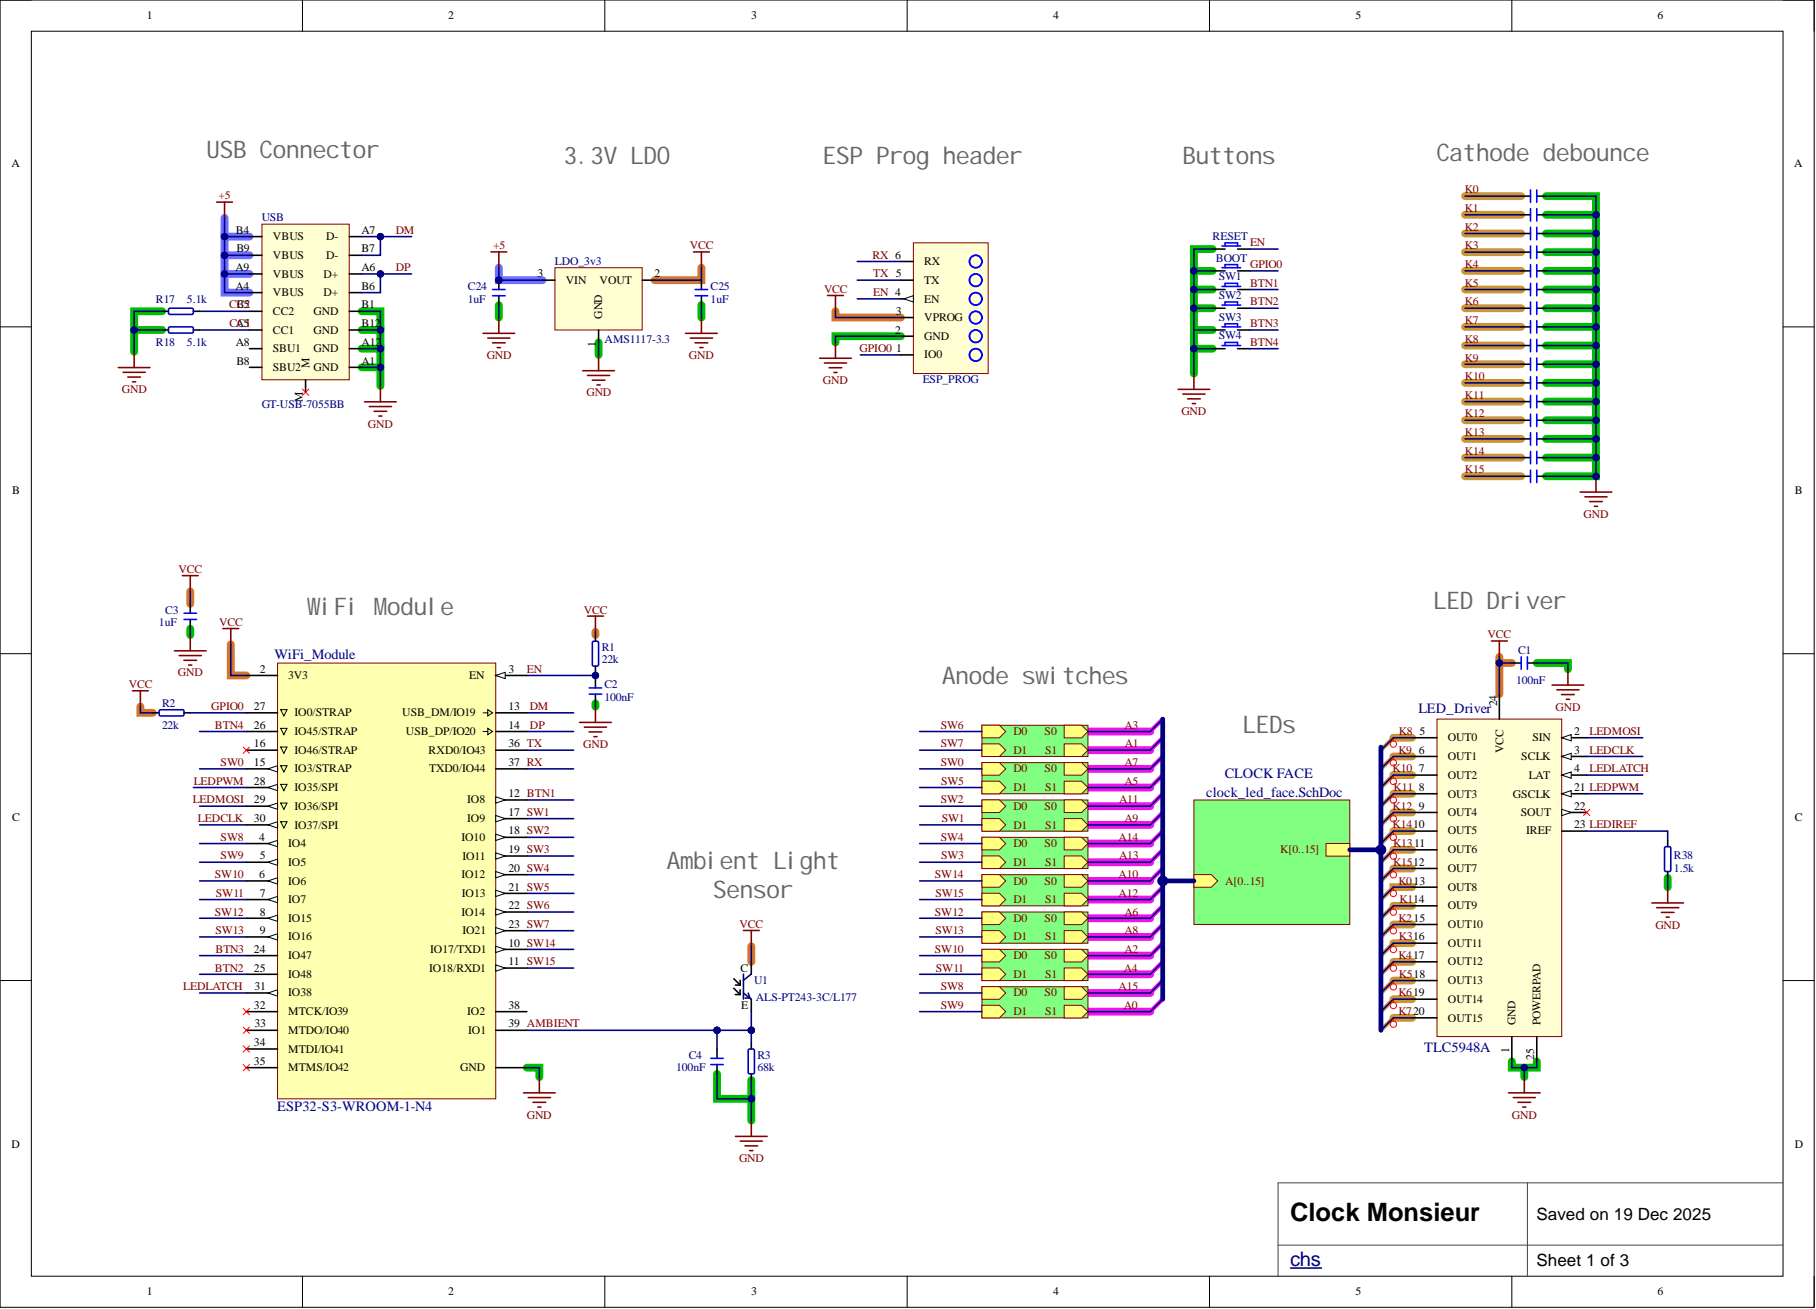
[picture p21: page 1]

A 9 | A 6
A4

Sheet 1 of 3 Saved on 19 Dec 2025

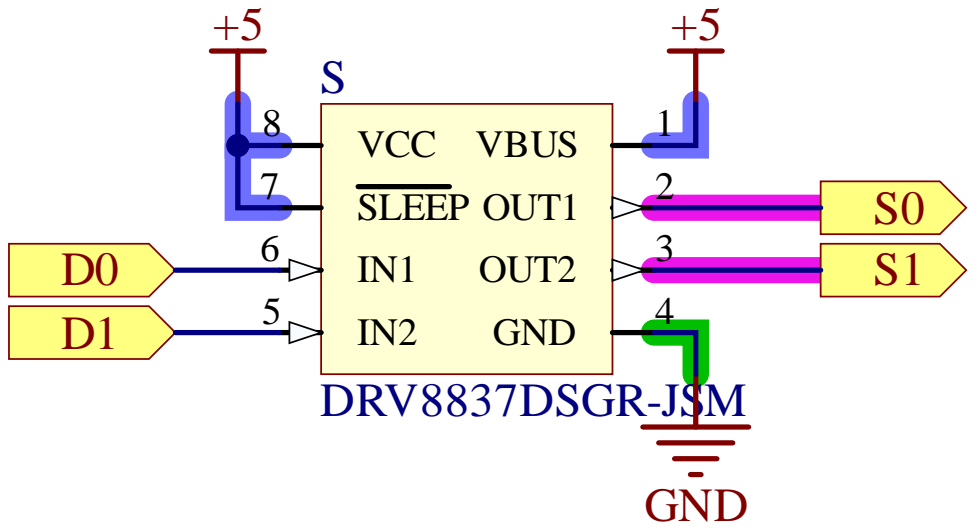
[picture p22: page 2]

Sheet 2 of 3 Saved on 19 Dec 2025


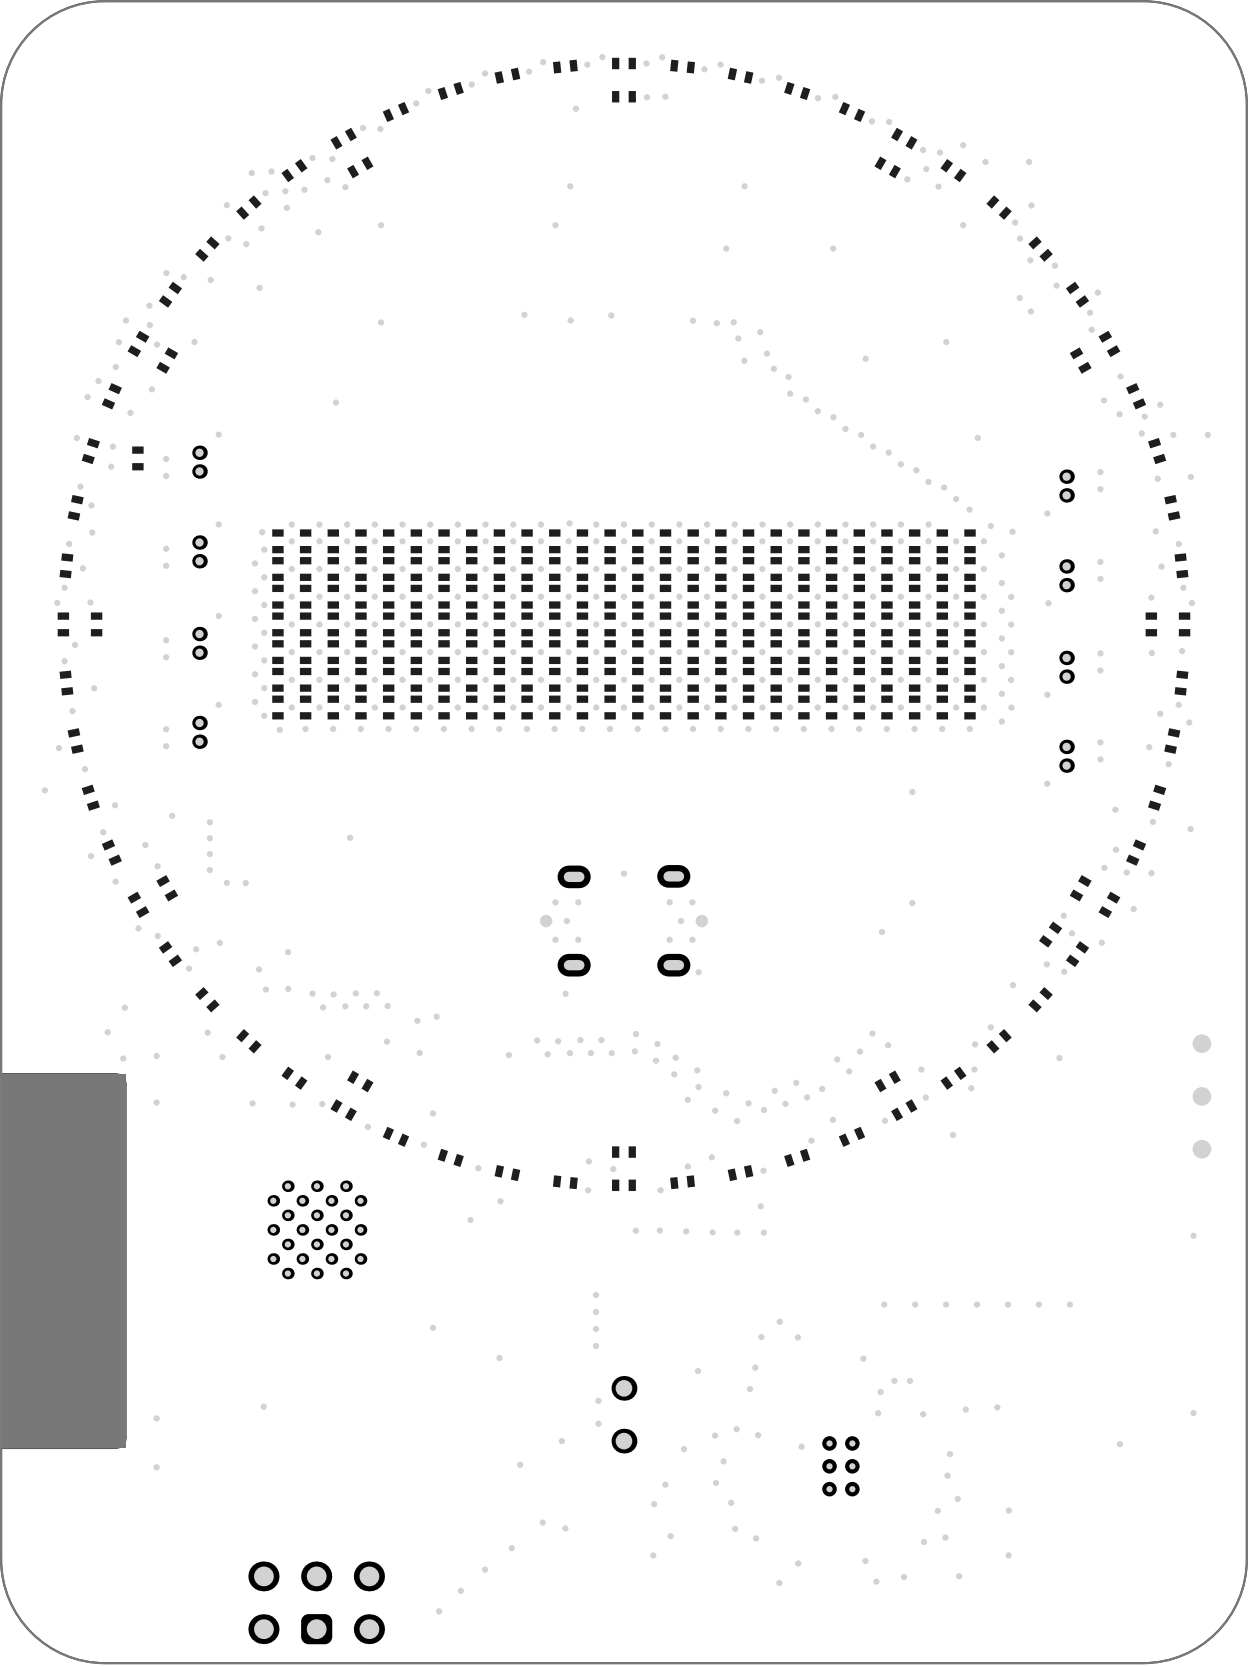
[picture p23: page 4]

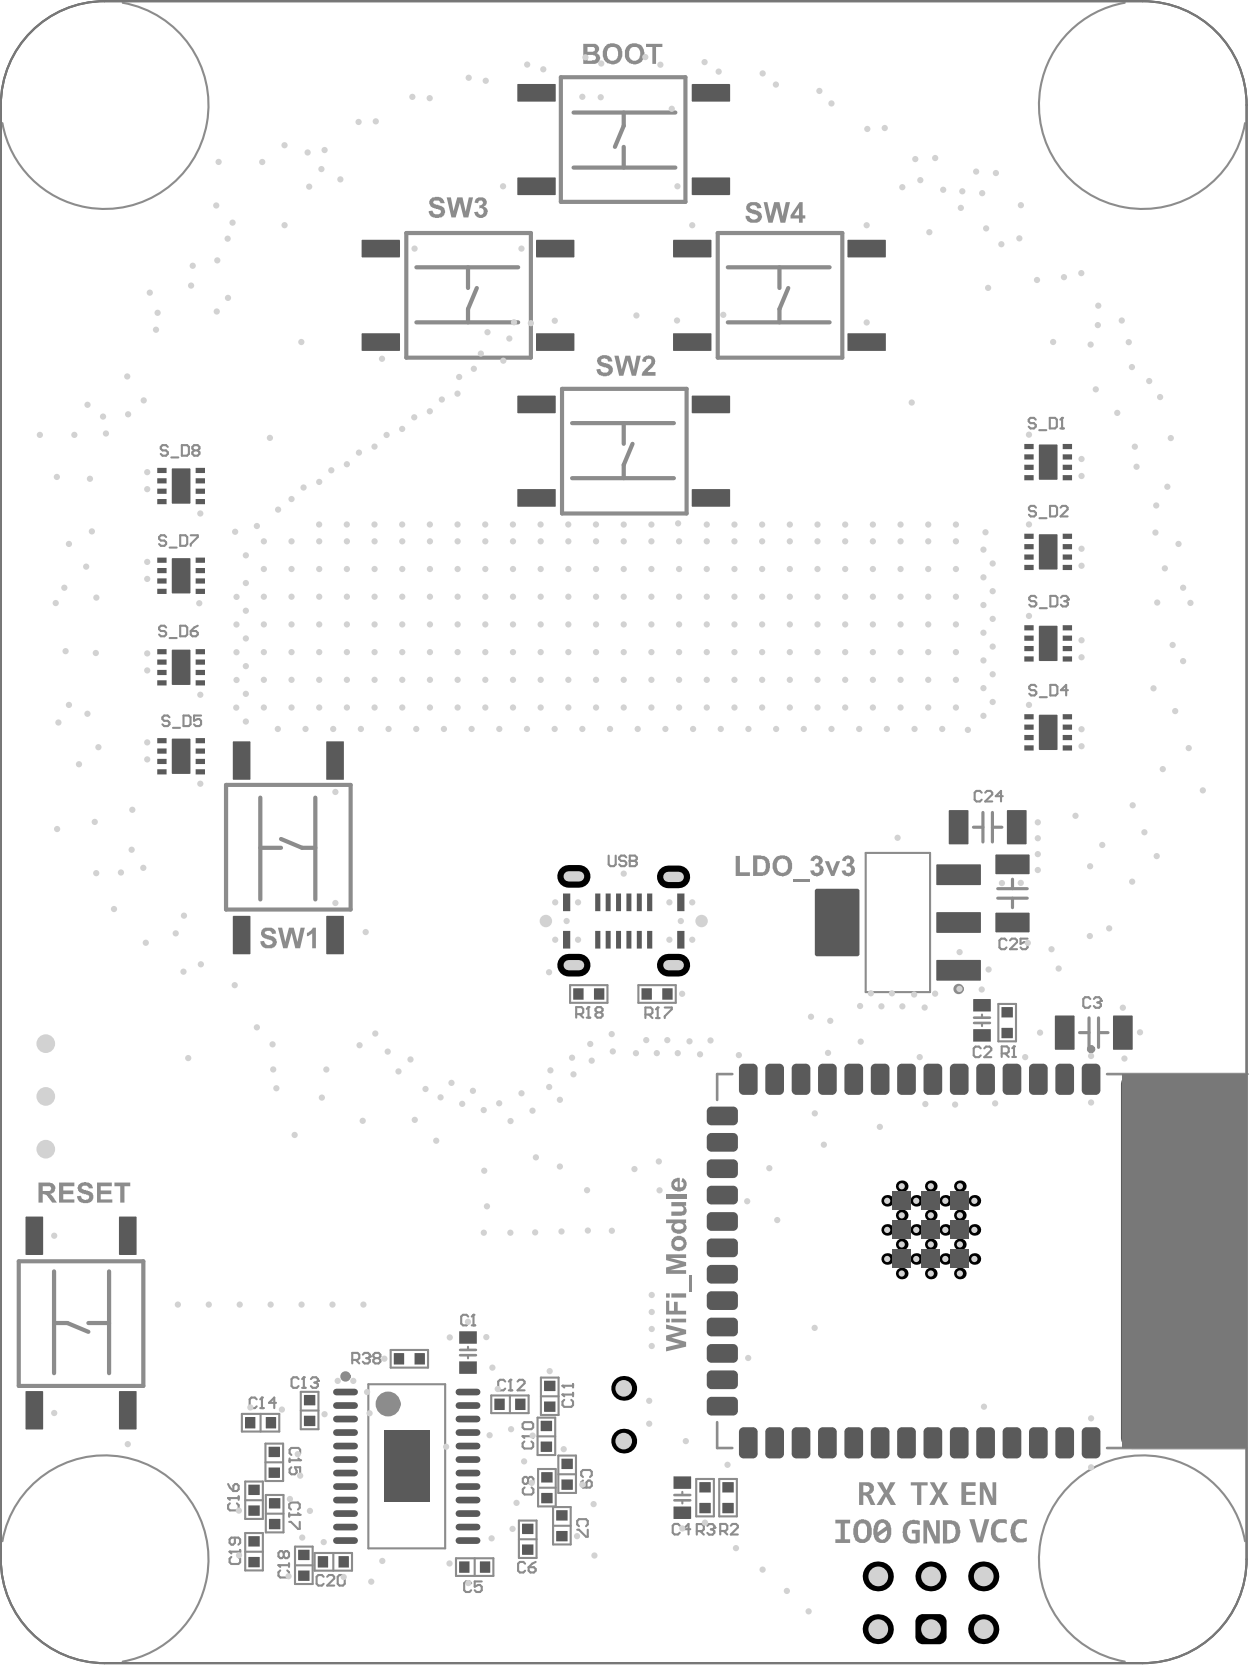
[picture p24: page 5]

### Electrical Rules Check Report

Class | Document | Message Successful Compile for clock_led.PrjPcb
Saturday 17 Jan 2026 11:38:24 AM | Page 1 of 1

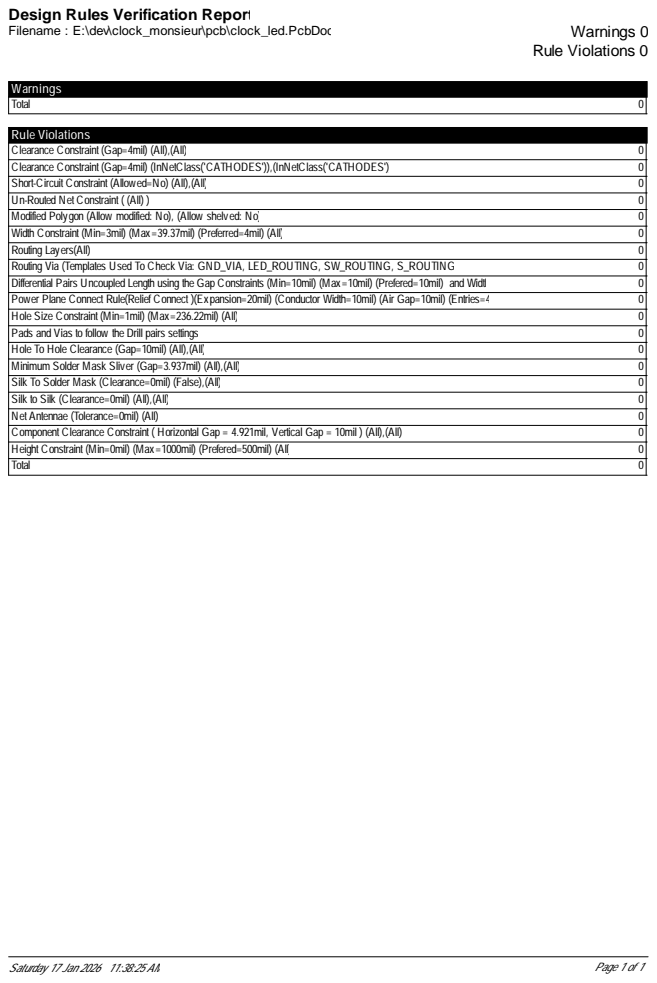
[picture p25: page 7]

Design Rules Verification Report

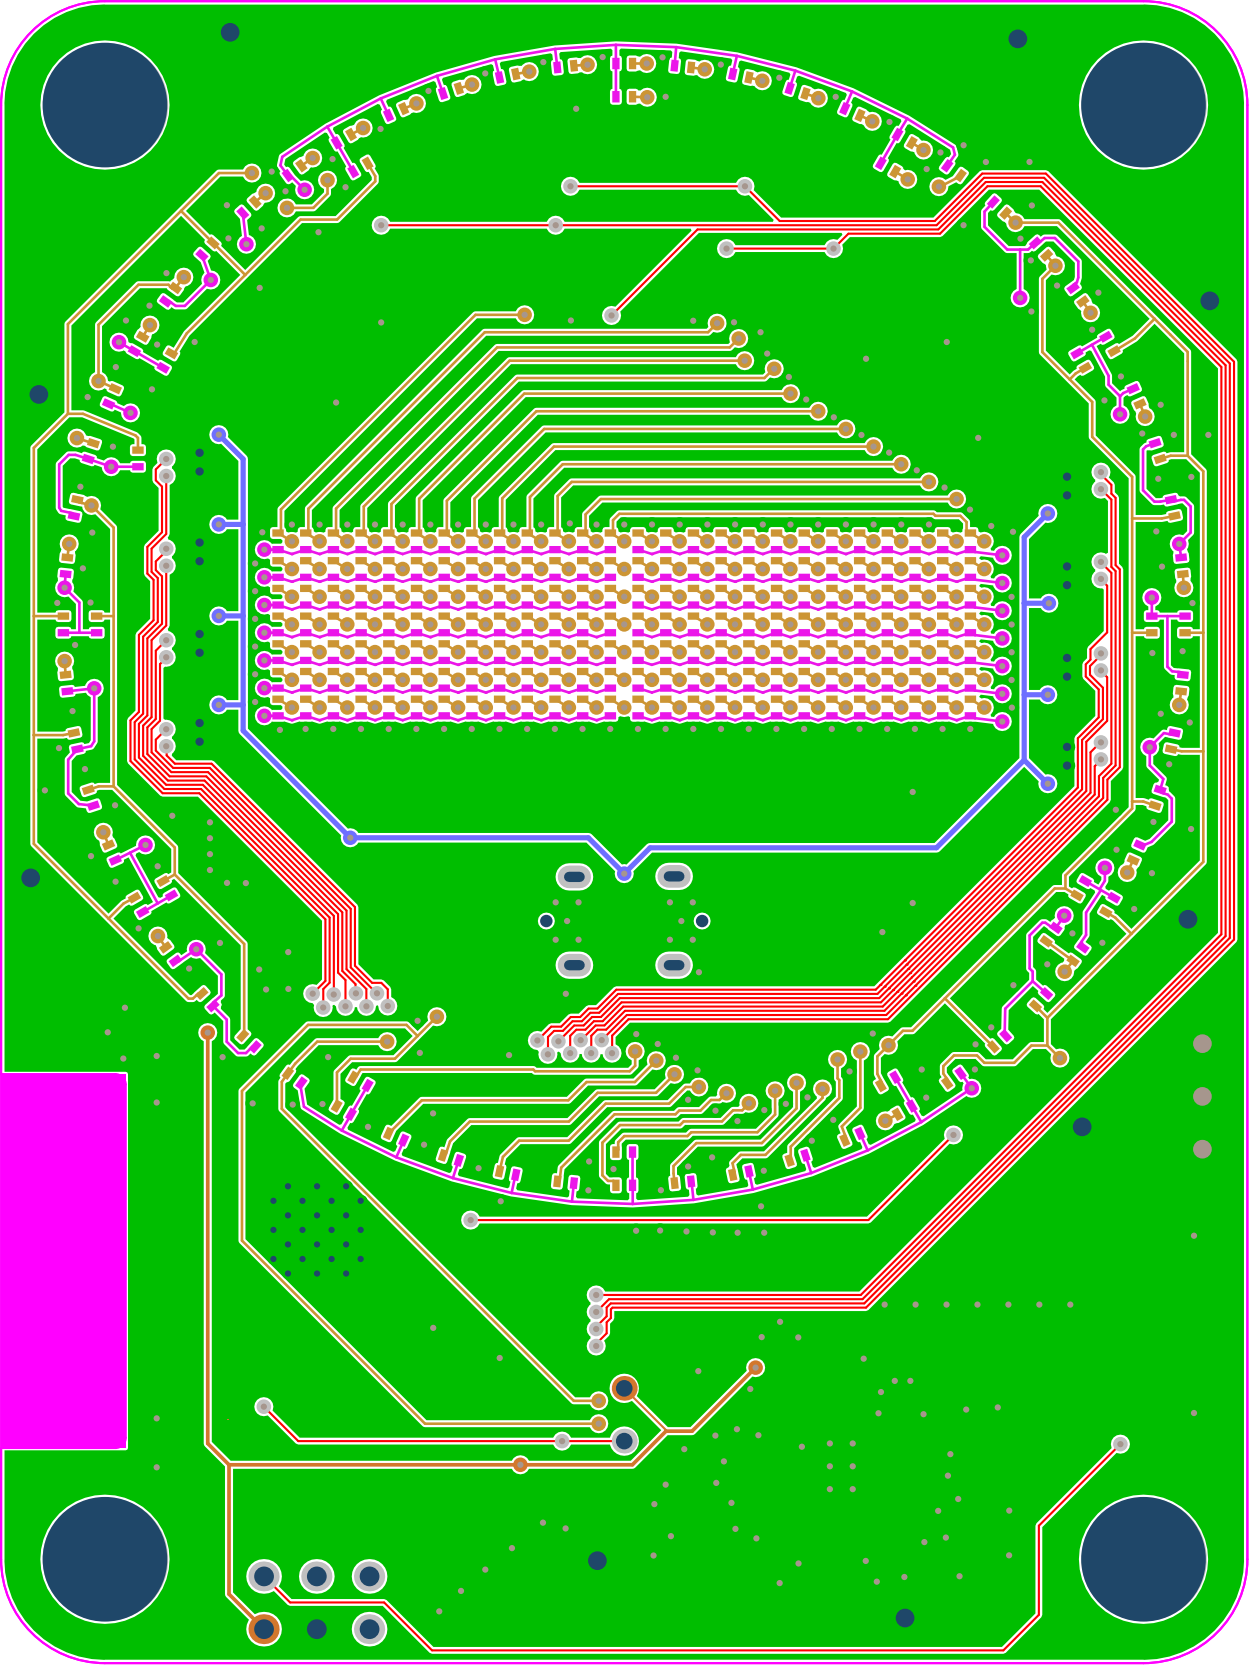
[picture p26: page 8]

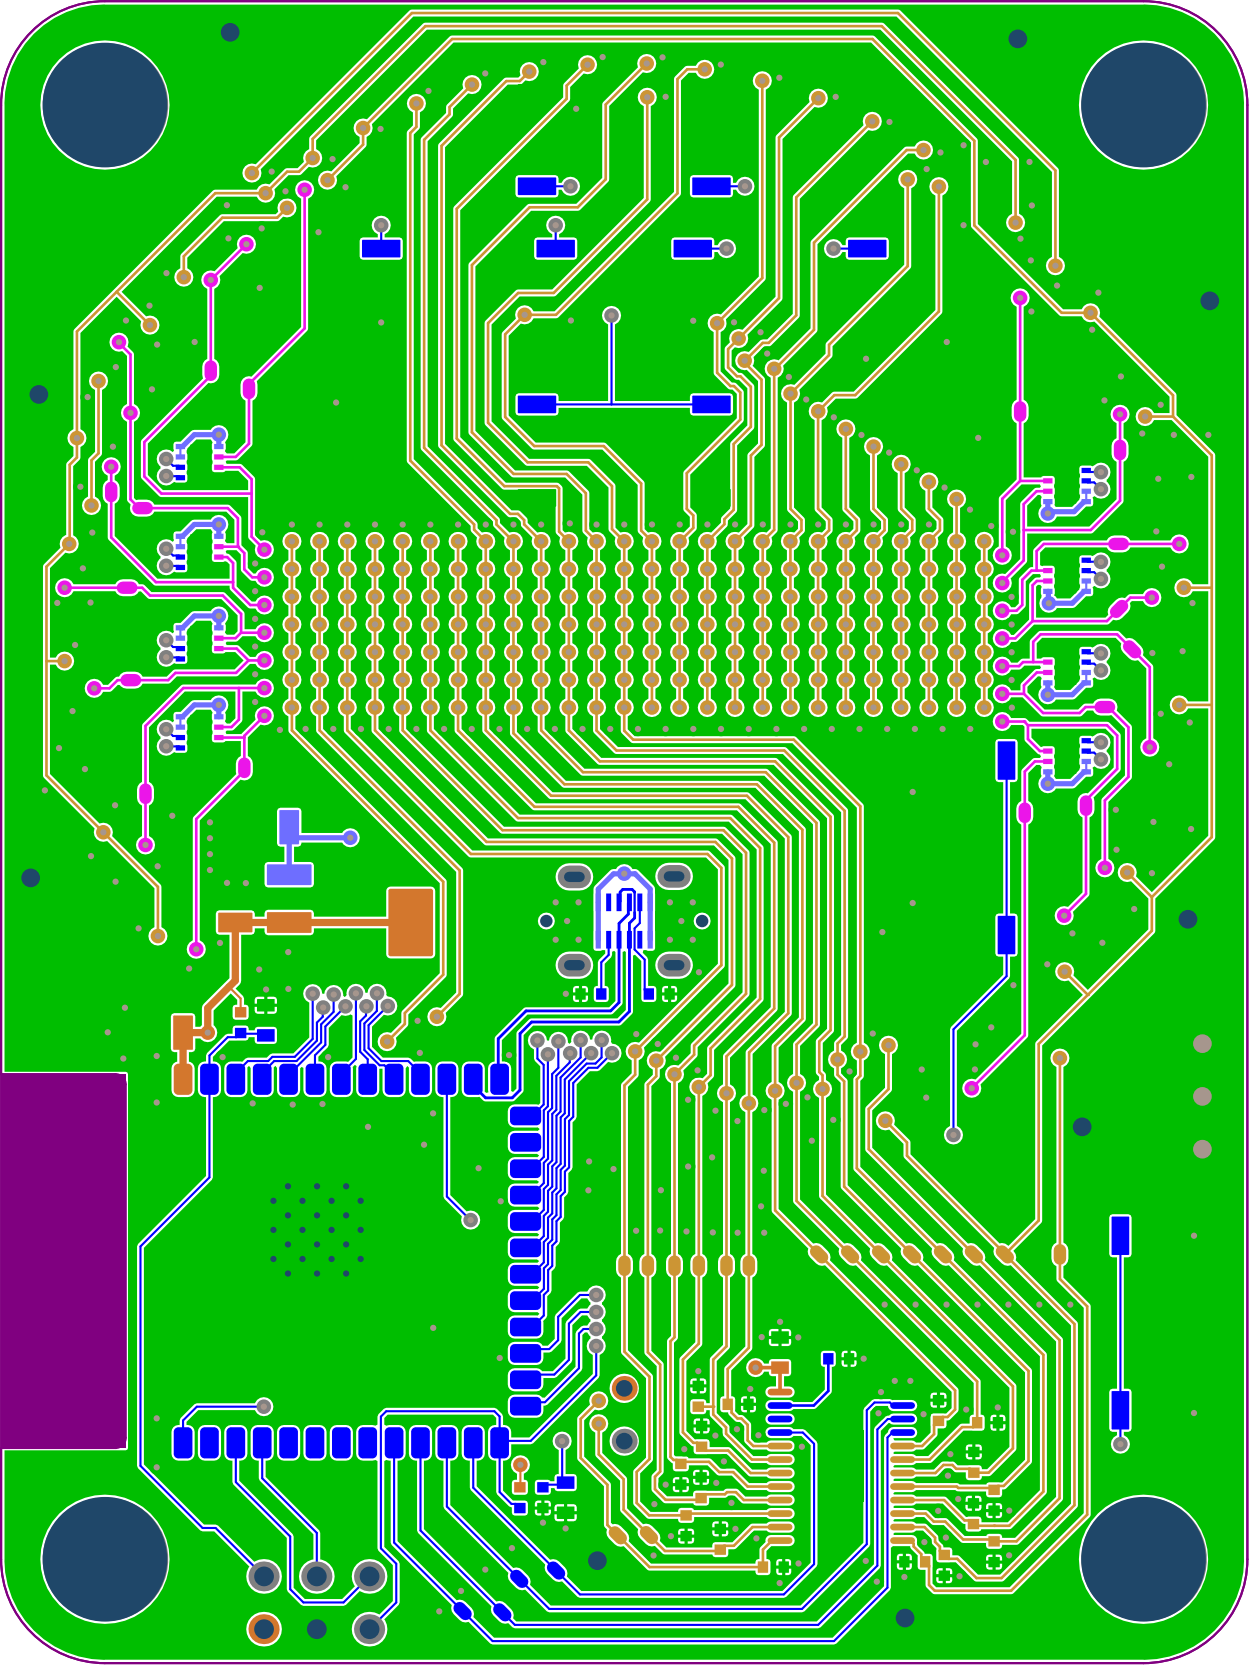
[picture p27: page 9]

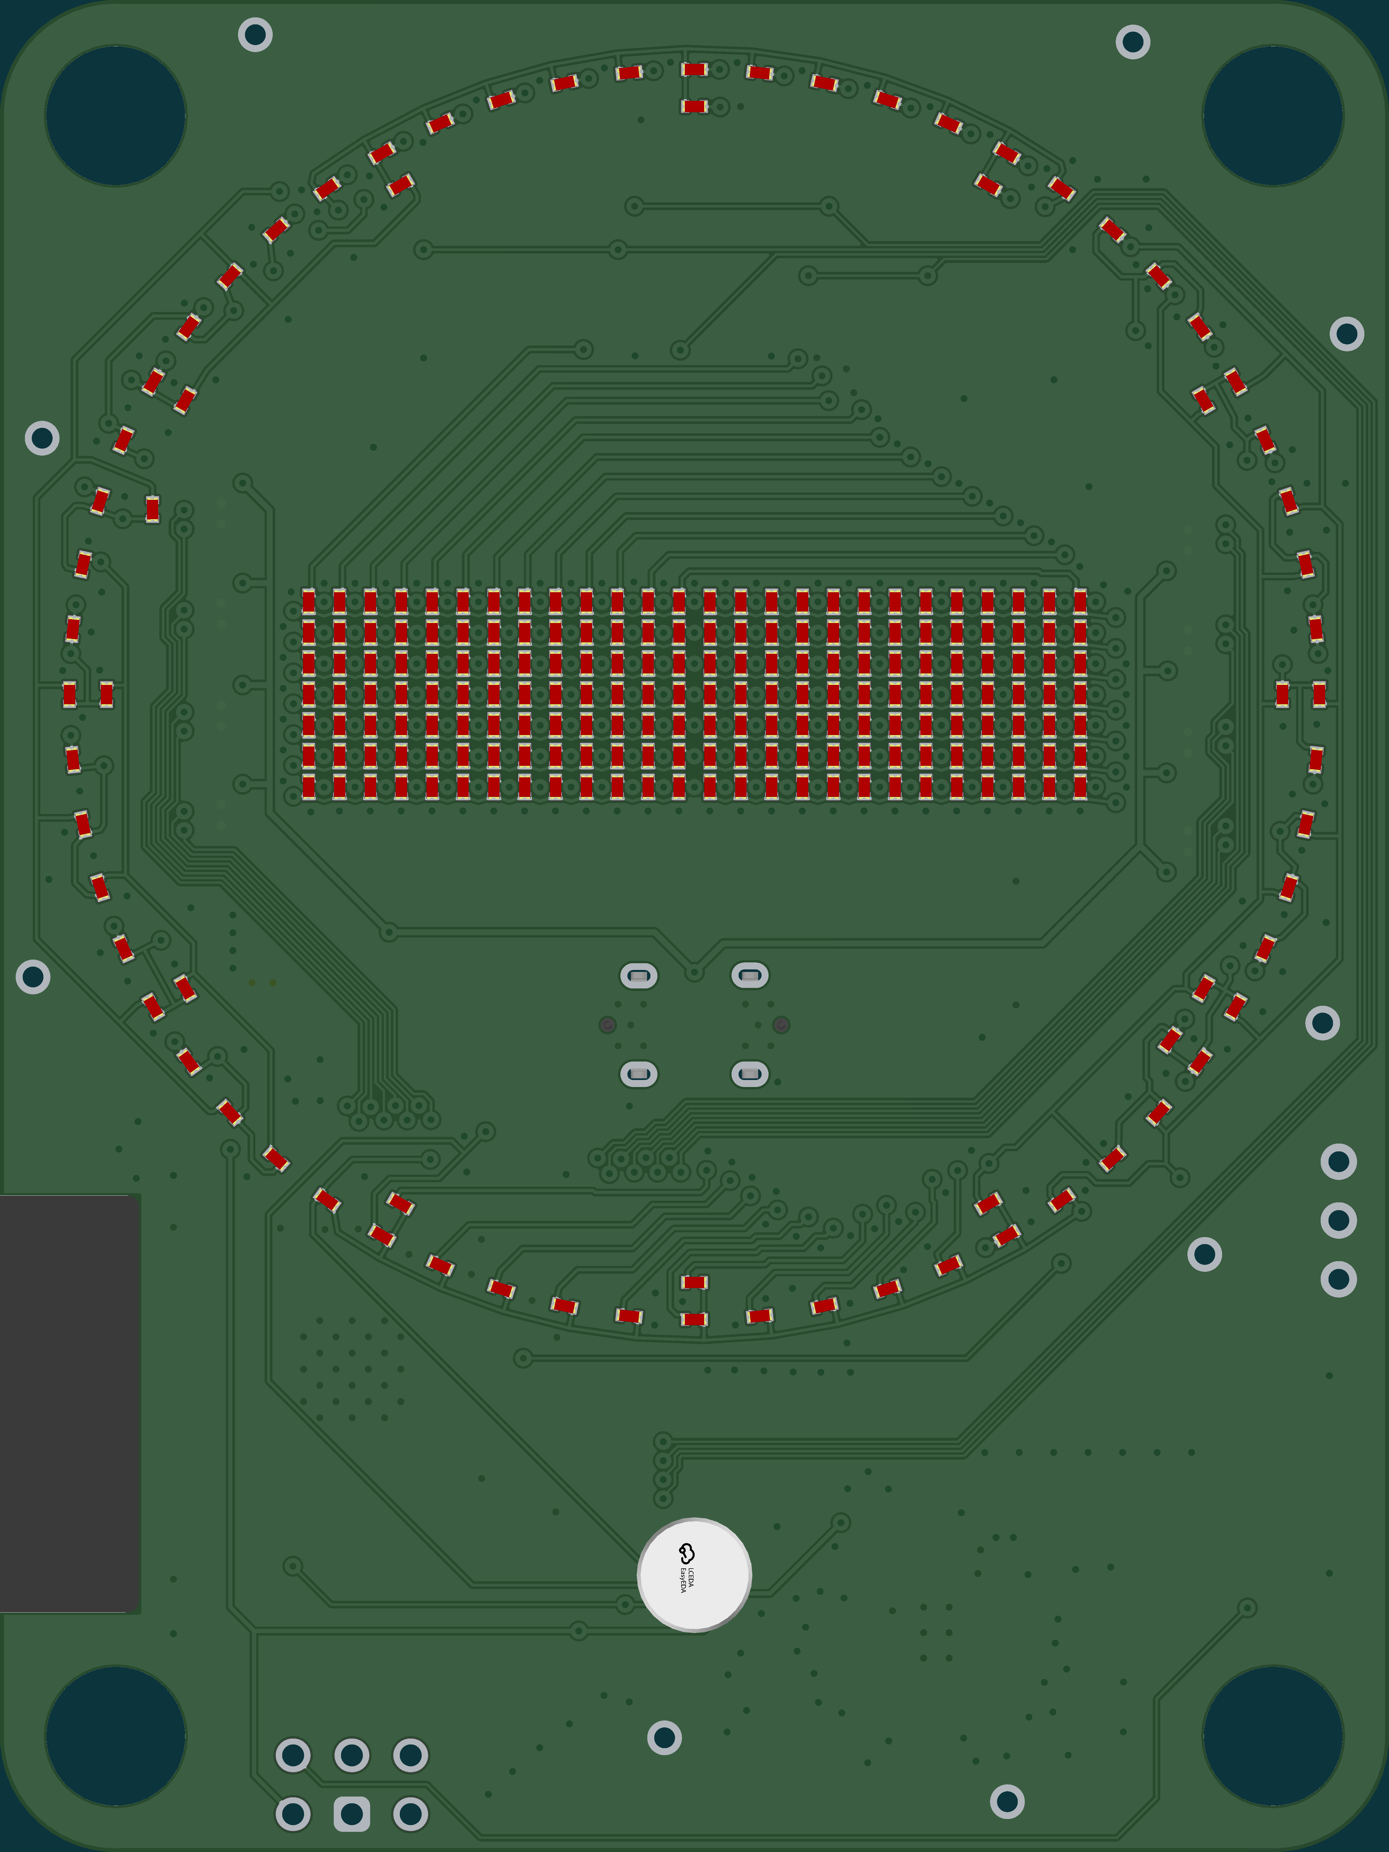
[picture p28: page 10]

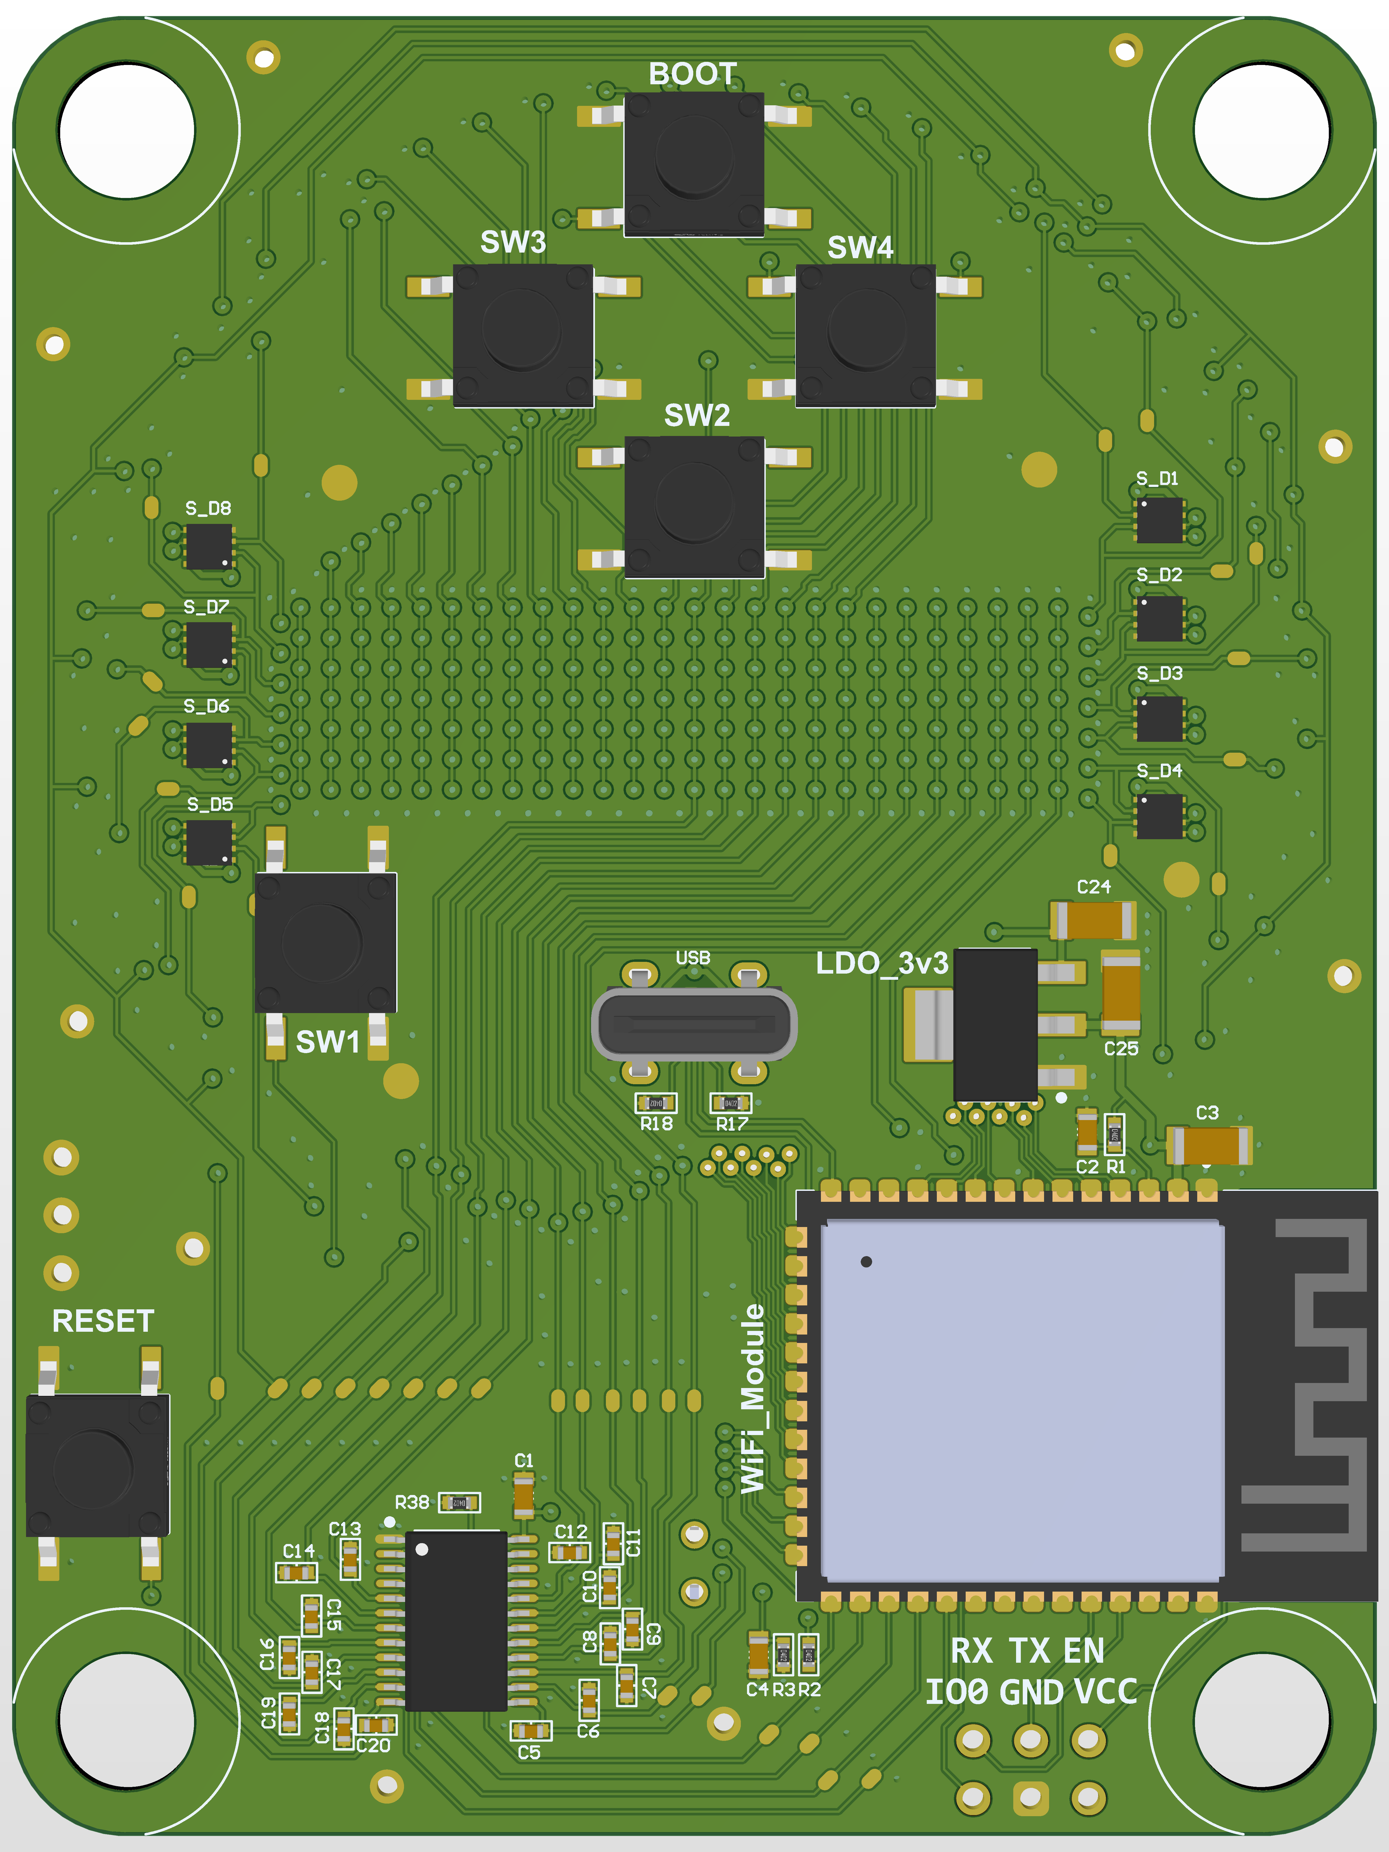
[picture p29: page 11]
