cskilbeck/clock_monsieur/pcb/Outputs/2026-01-08/clock_led.pdf

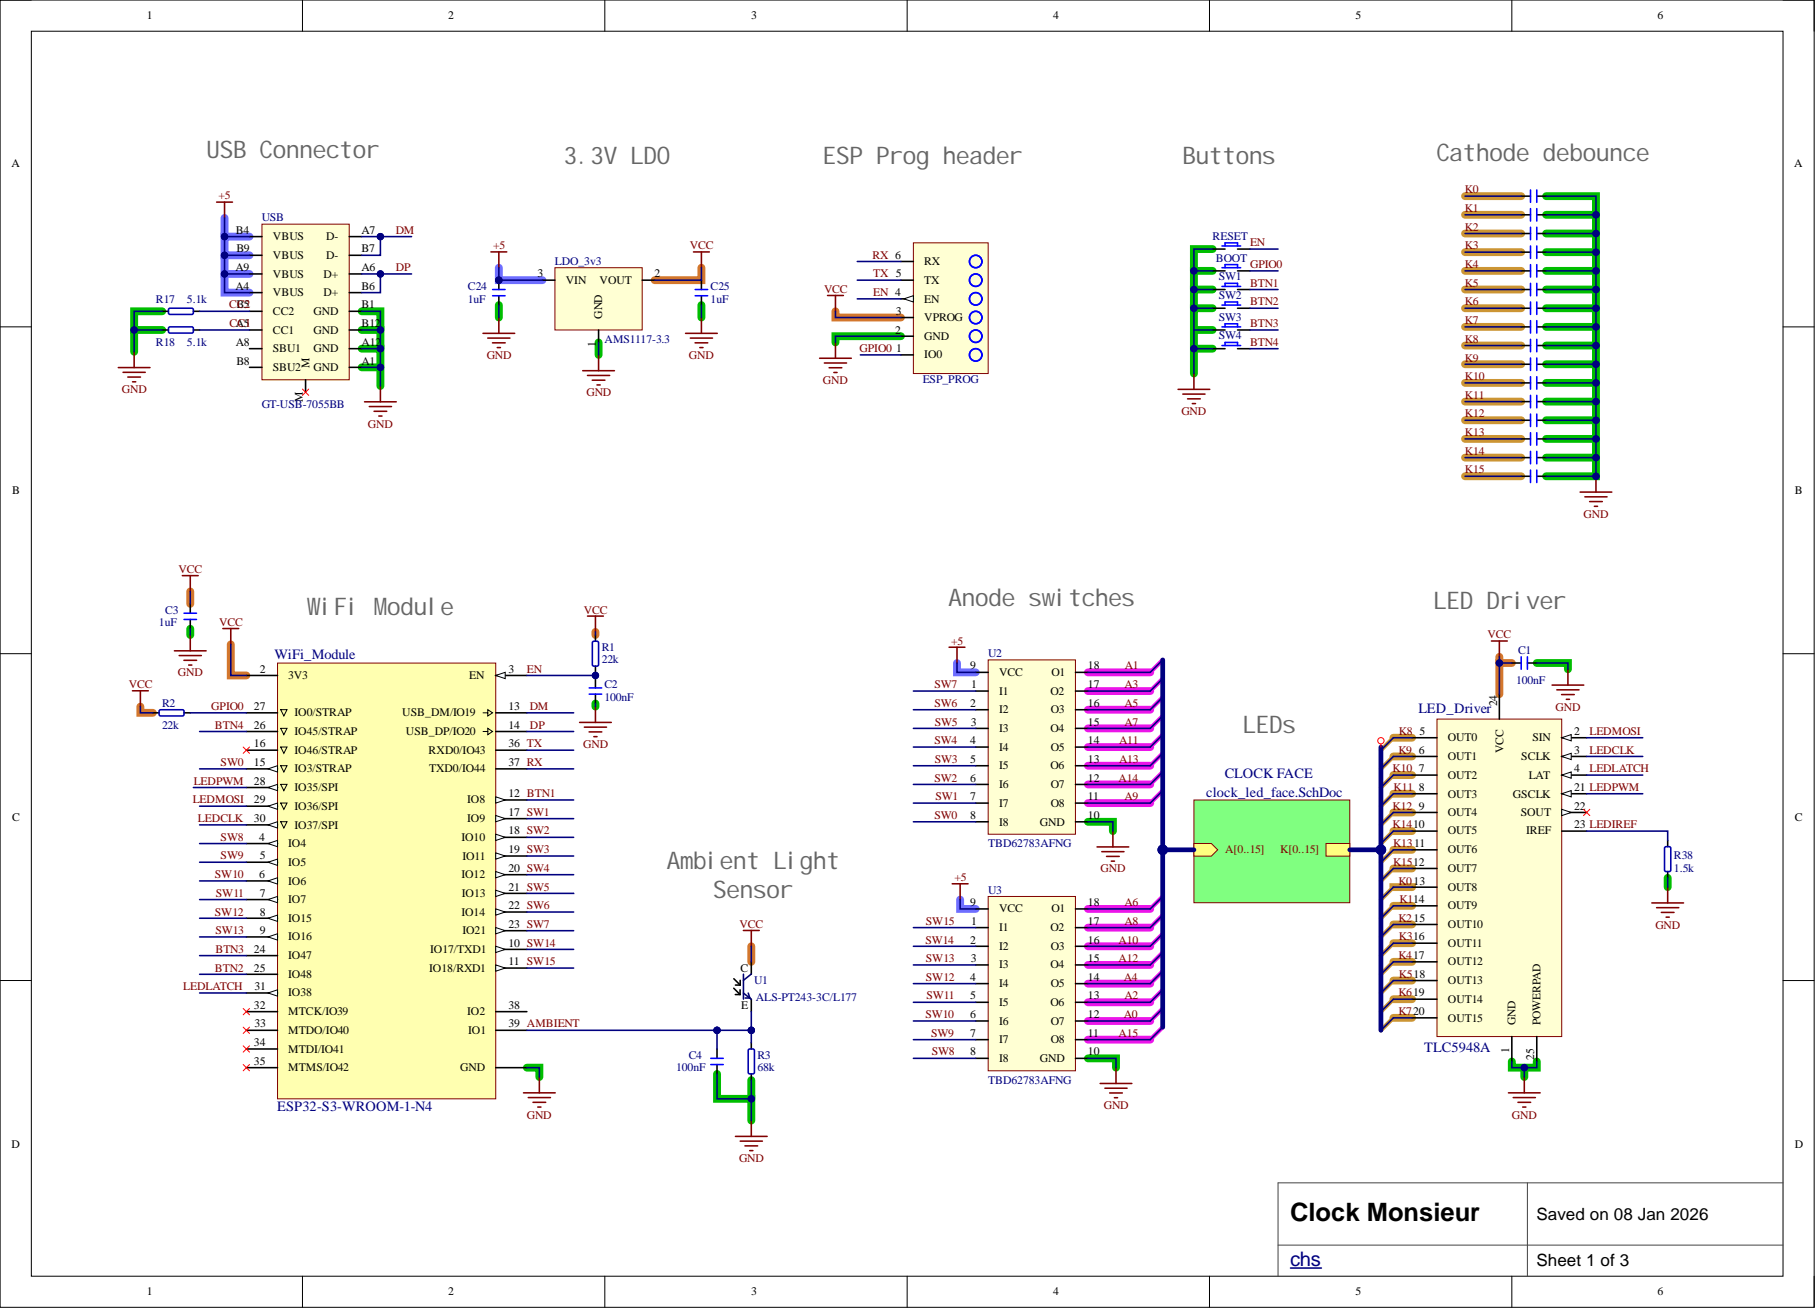
[picture p30: page 1]

A 9 | A 6
A4

Sheet 1 of 3 Saved on 08 Jan 2026

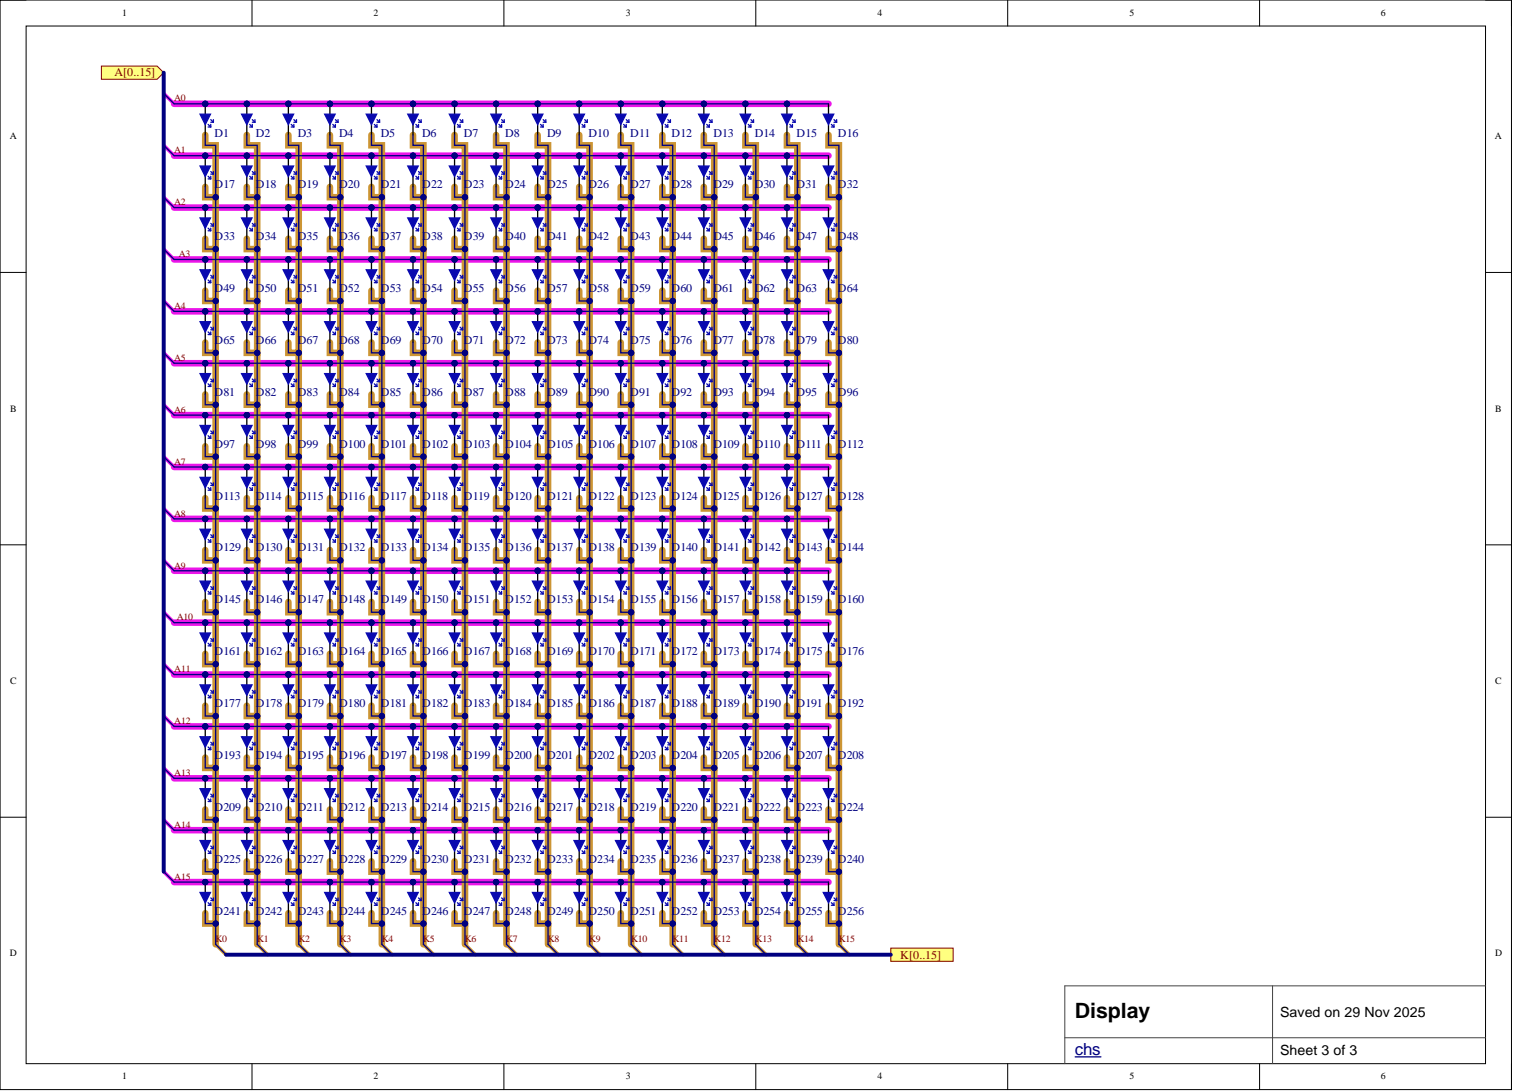
[picture p31: page 2]

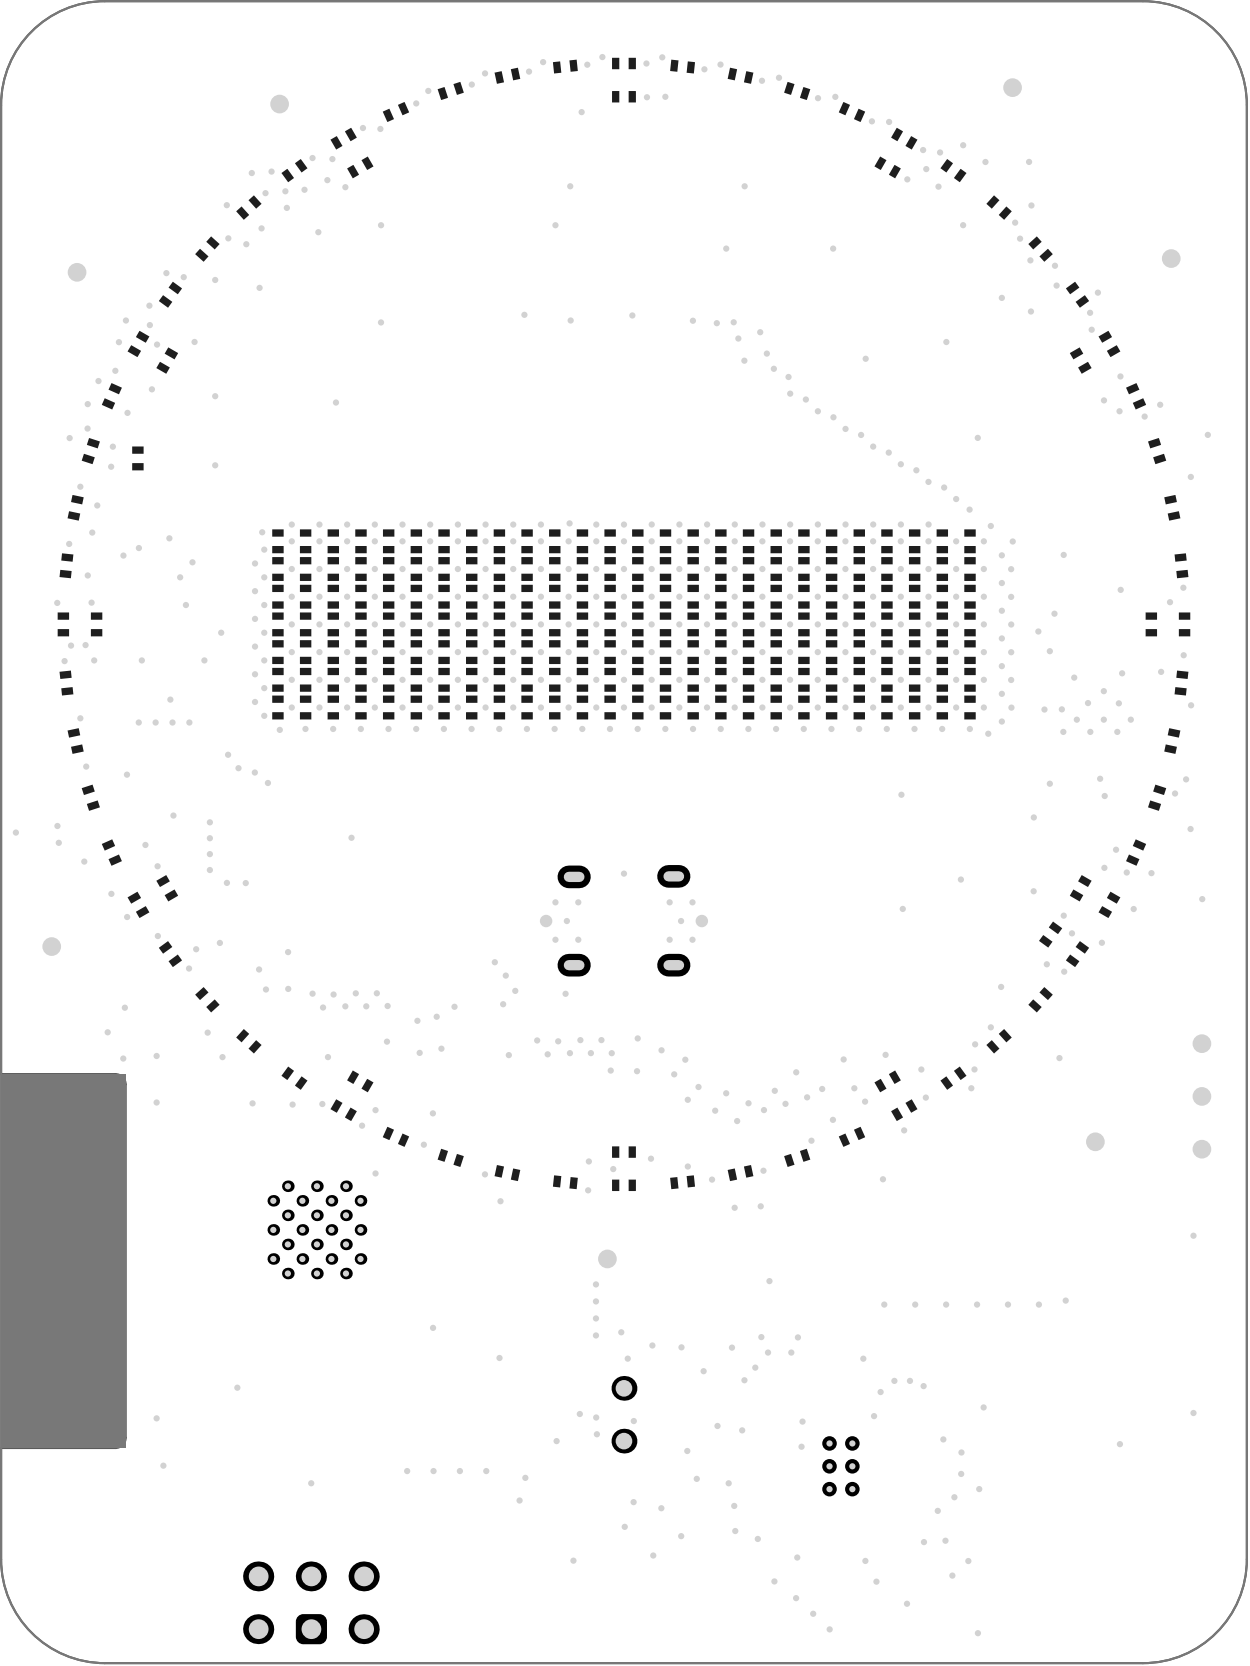
[picture p32: page 3]

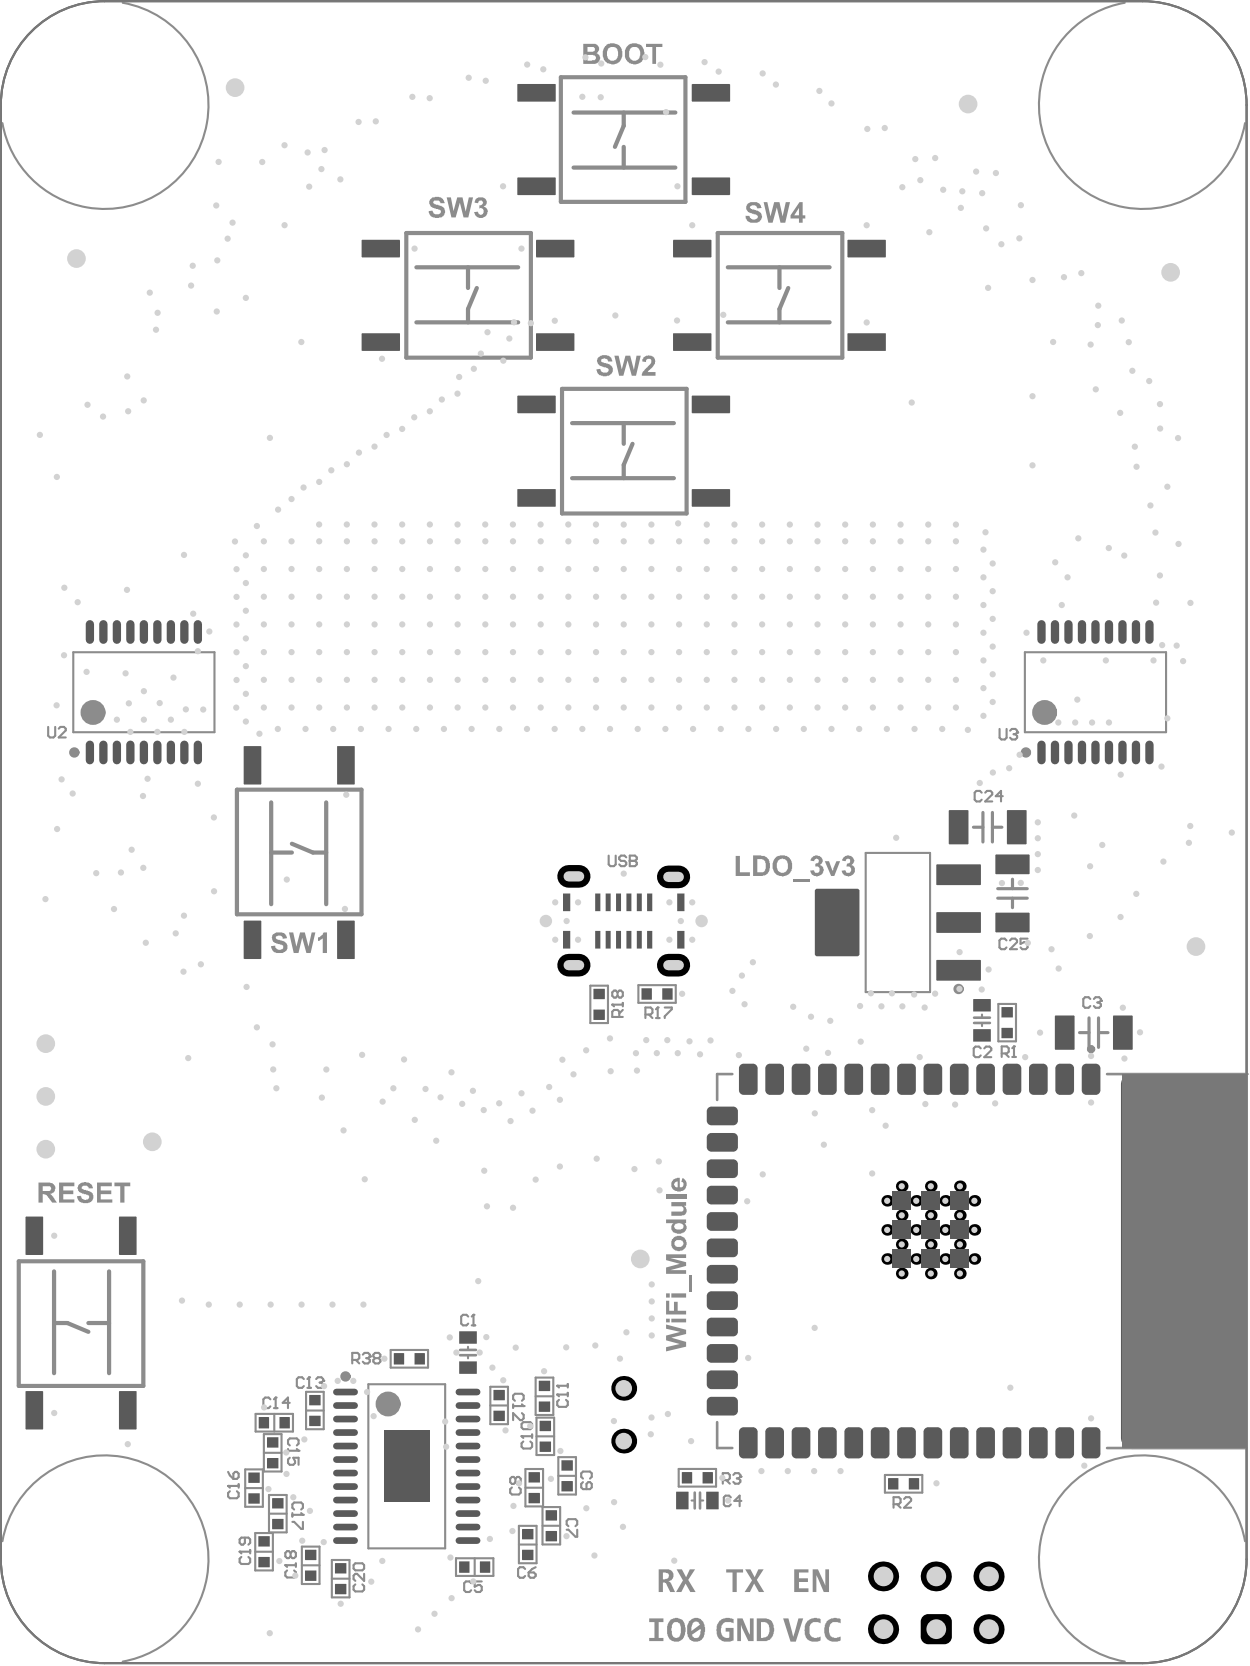
[picture p33: page 4]

### Electrical Rules Check Report

Class | Document | Message Successful Compile for clock_led.PrjPcb
Thursday 8 Jan 2026 4:26:20 PM | Page 1 of 1

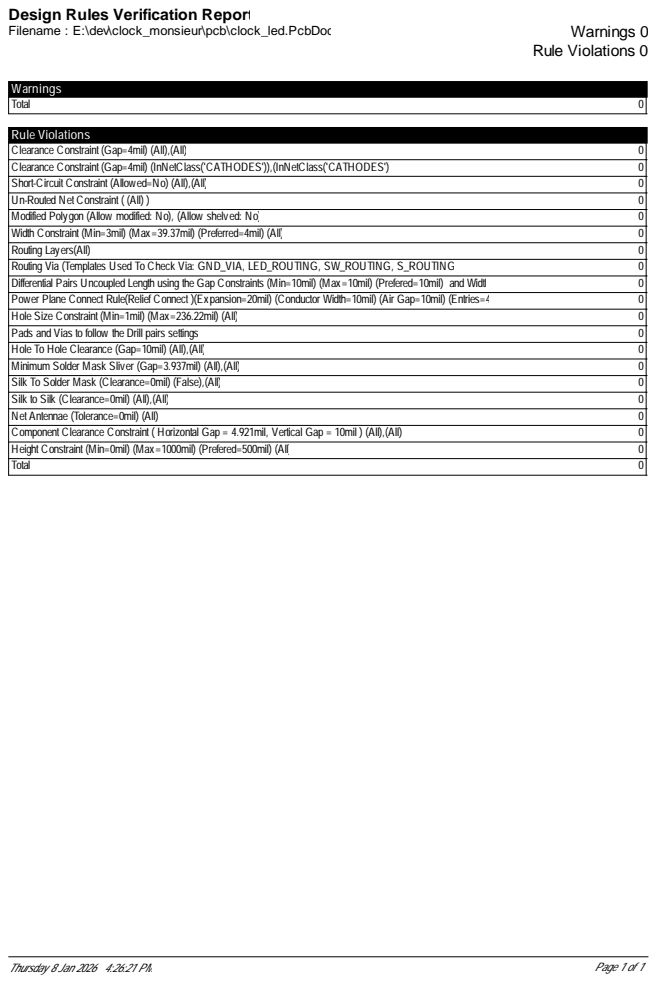
[picture p34: page 6]

Design Rules Verification Report

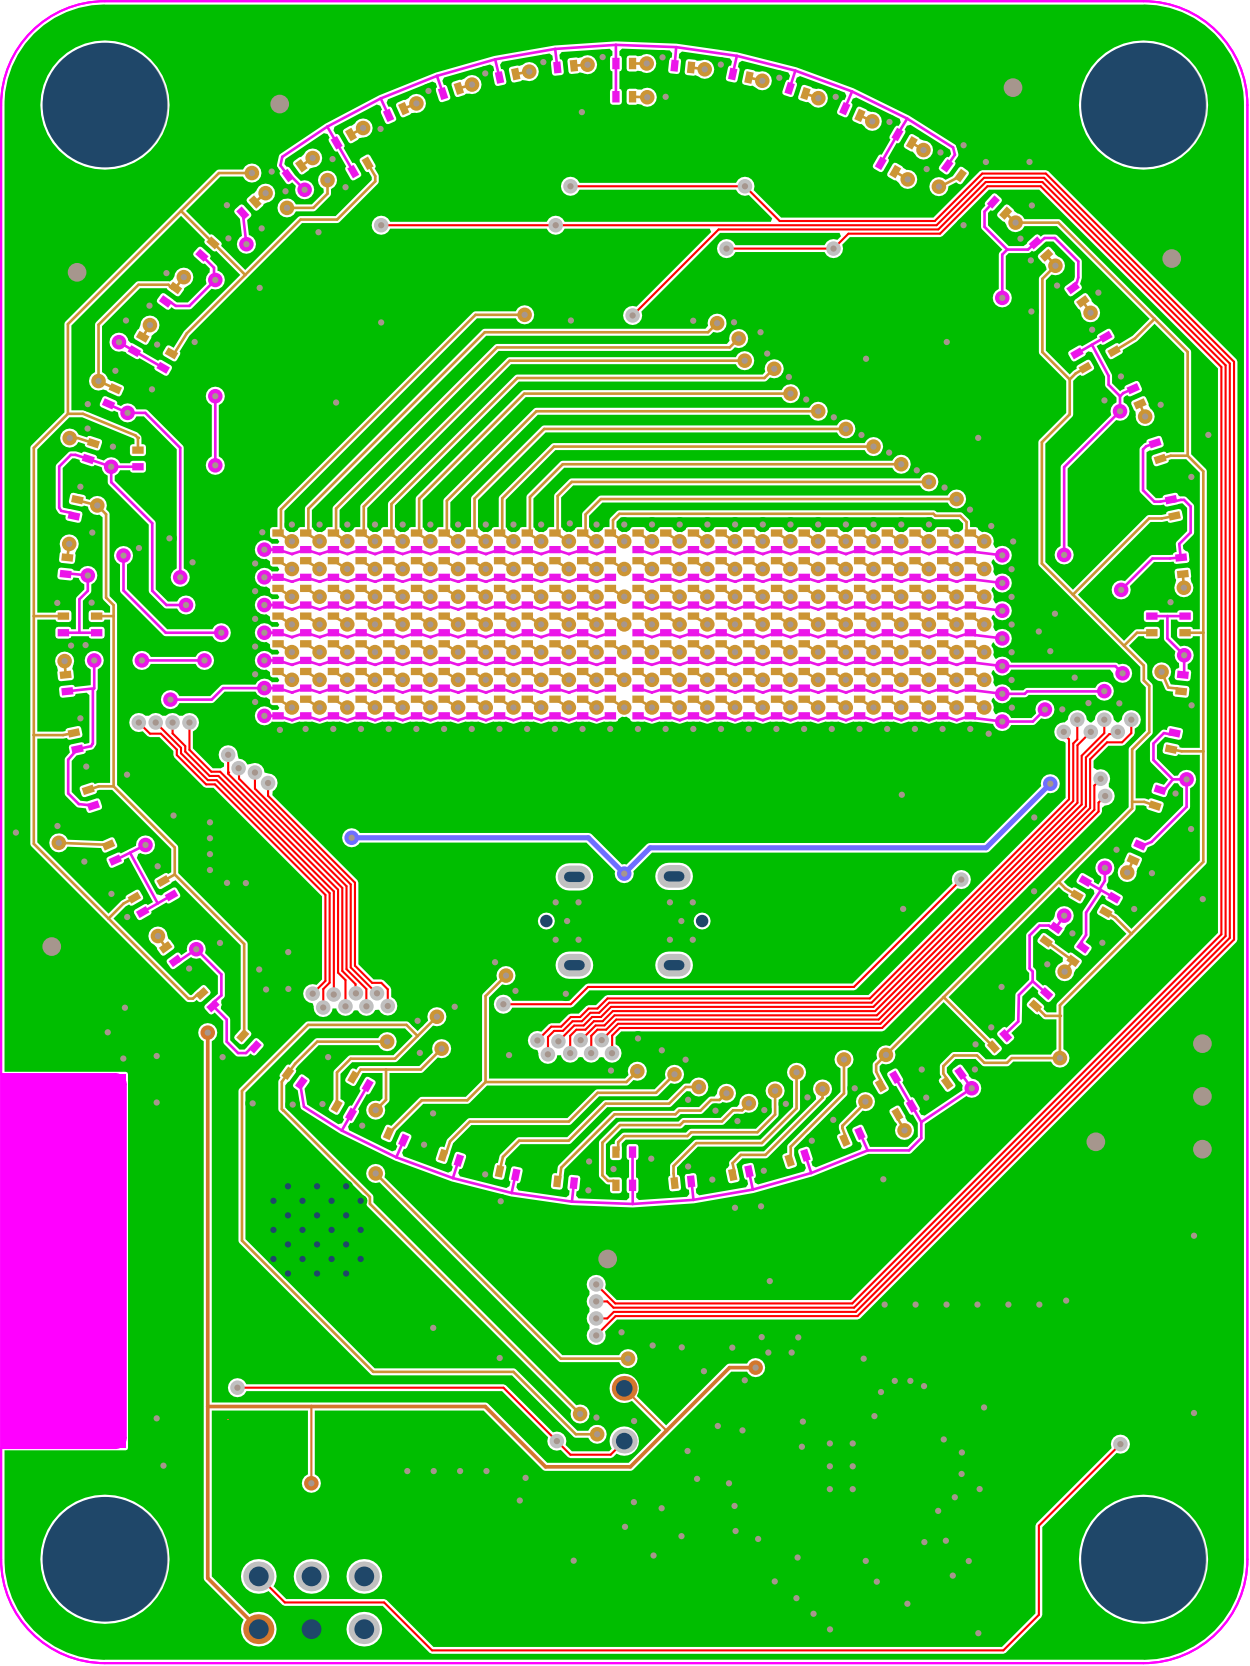
[picture p35: page 7]

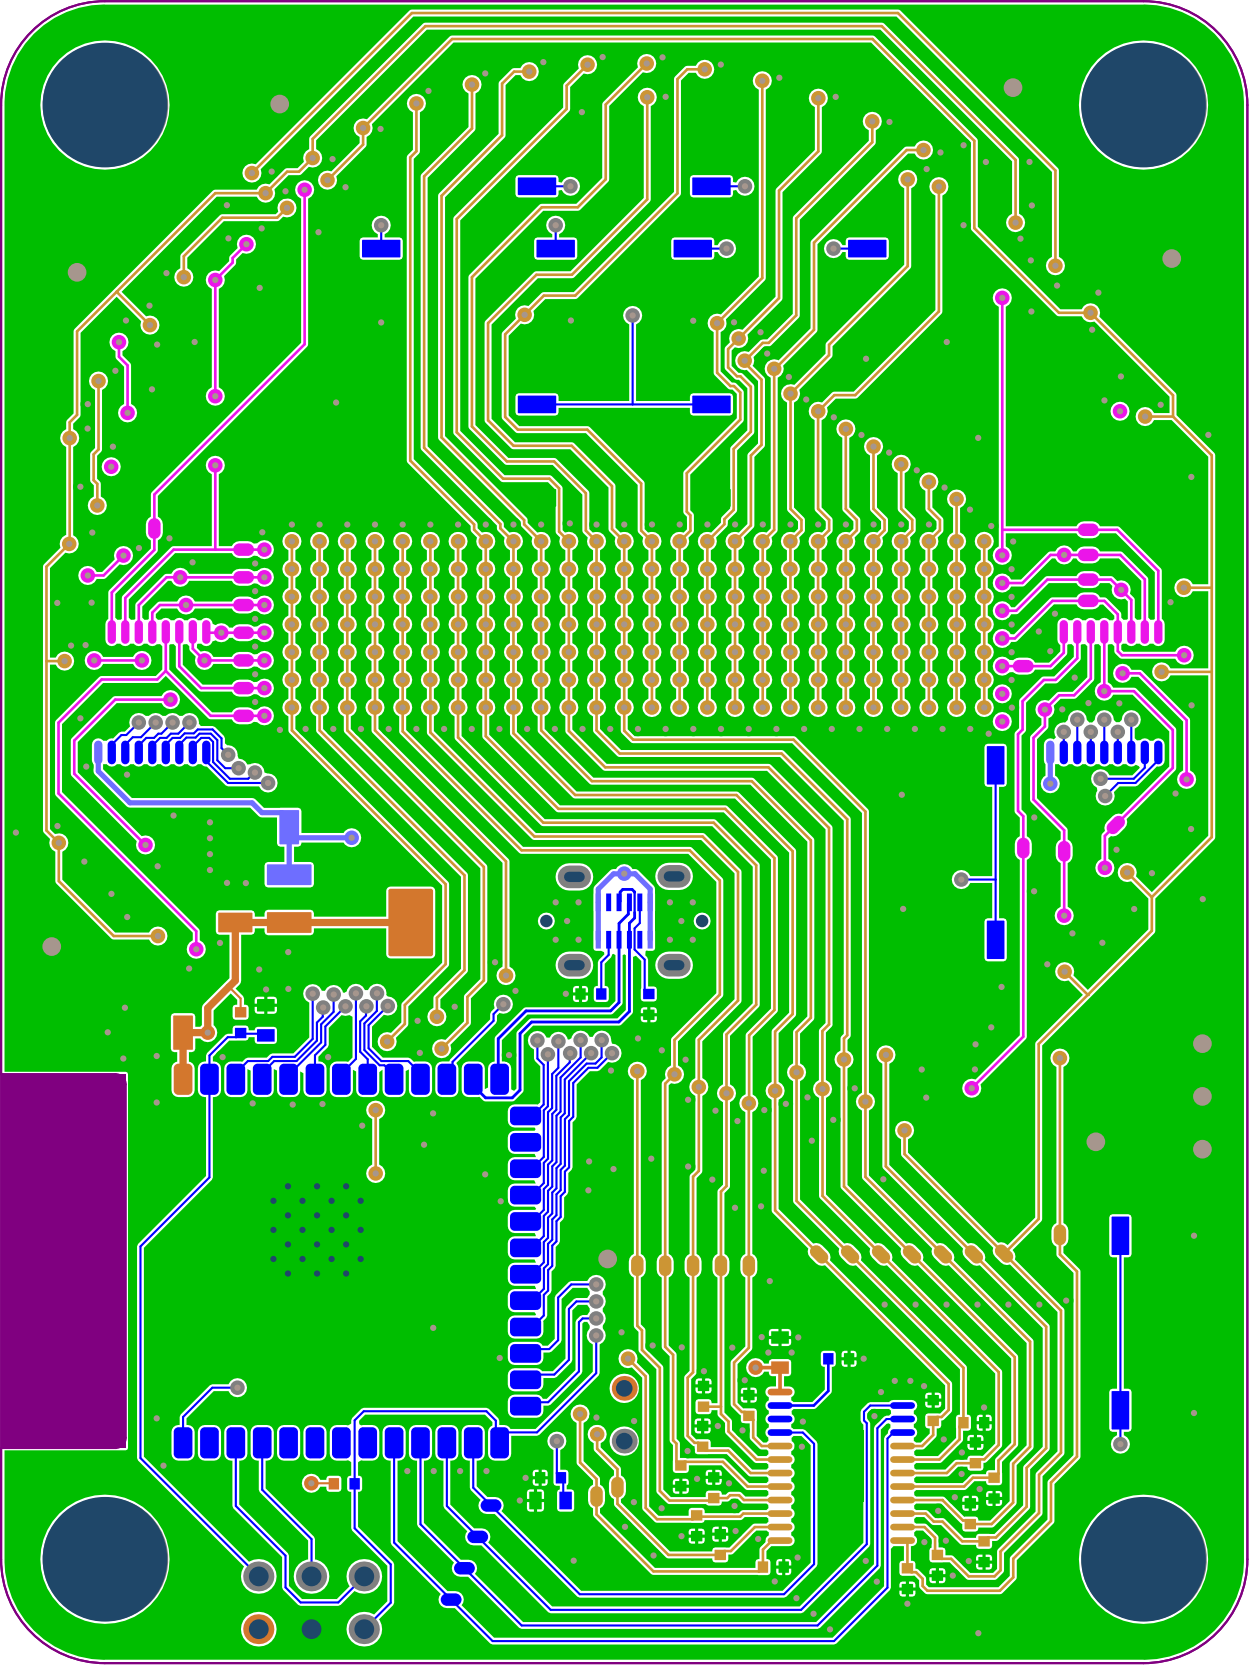
[picture p36: page 8]

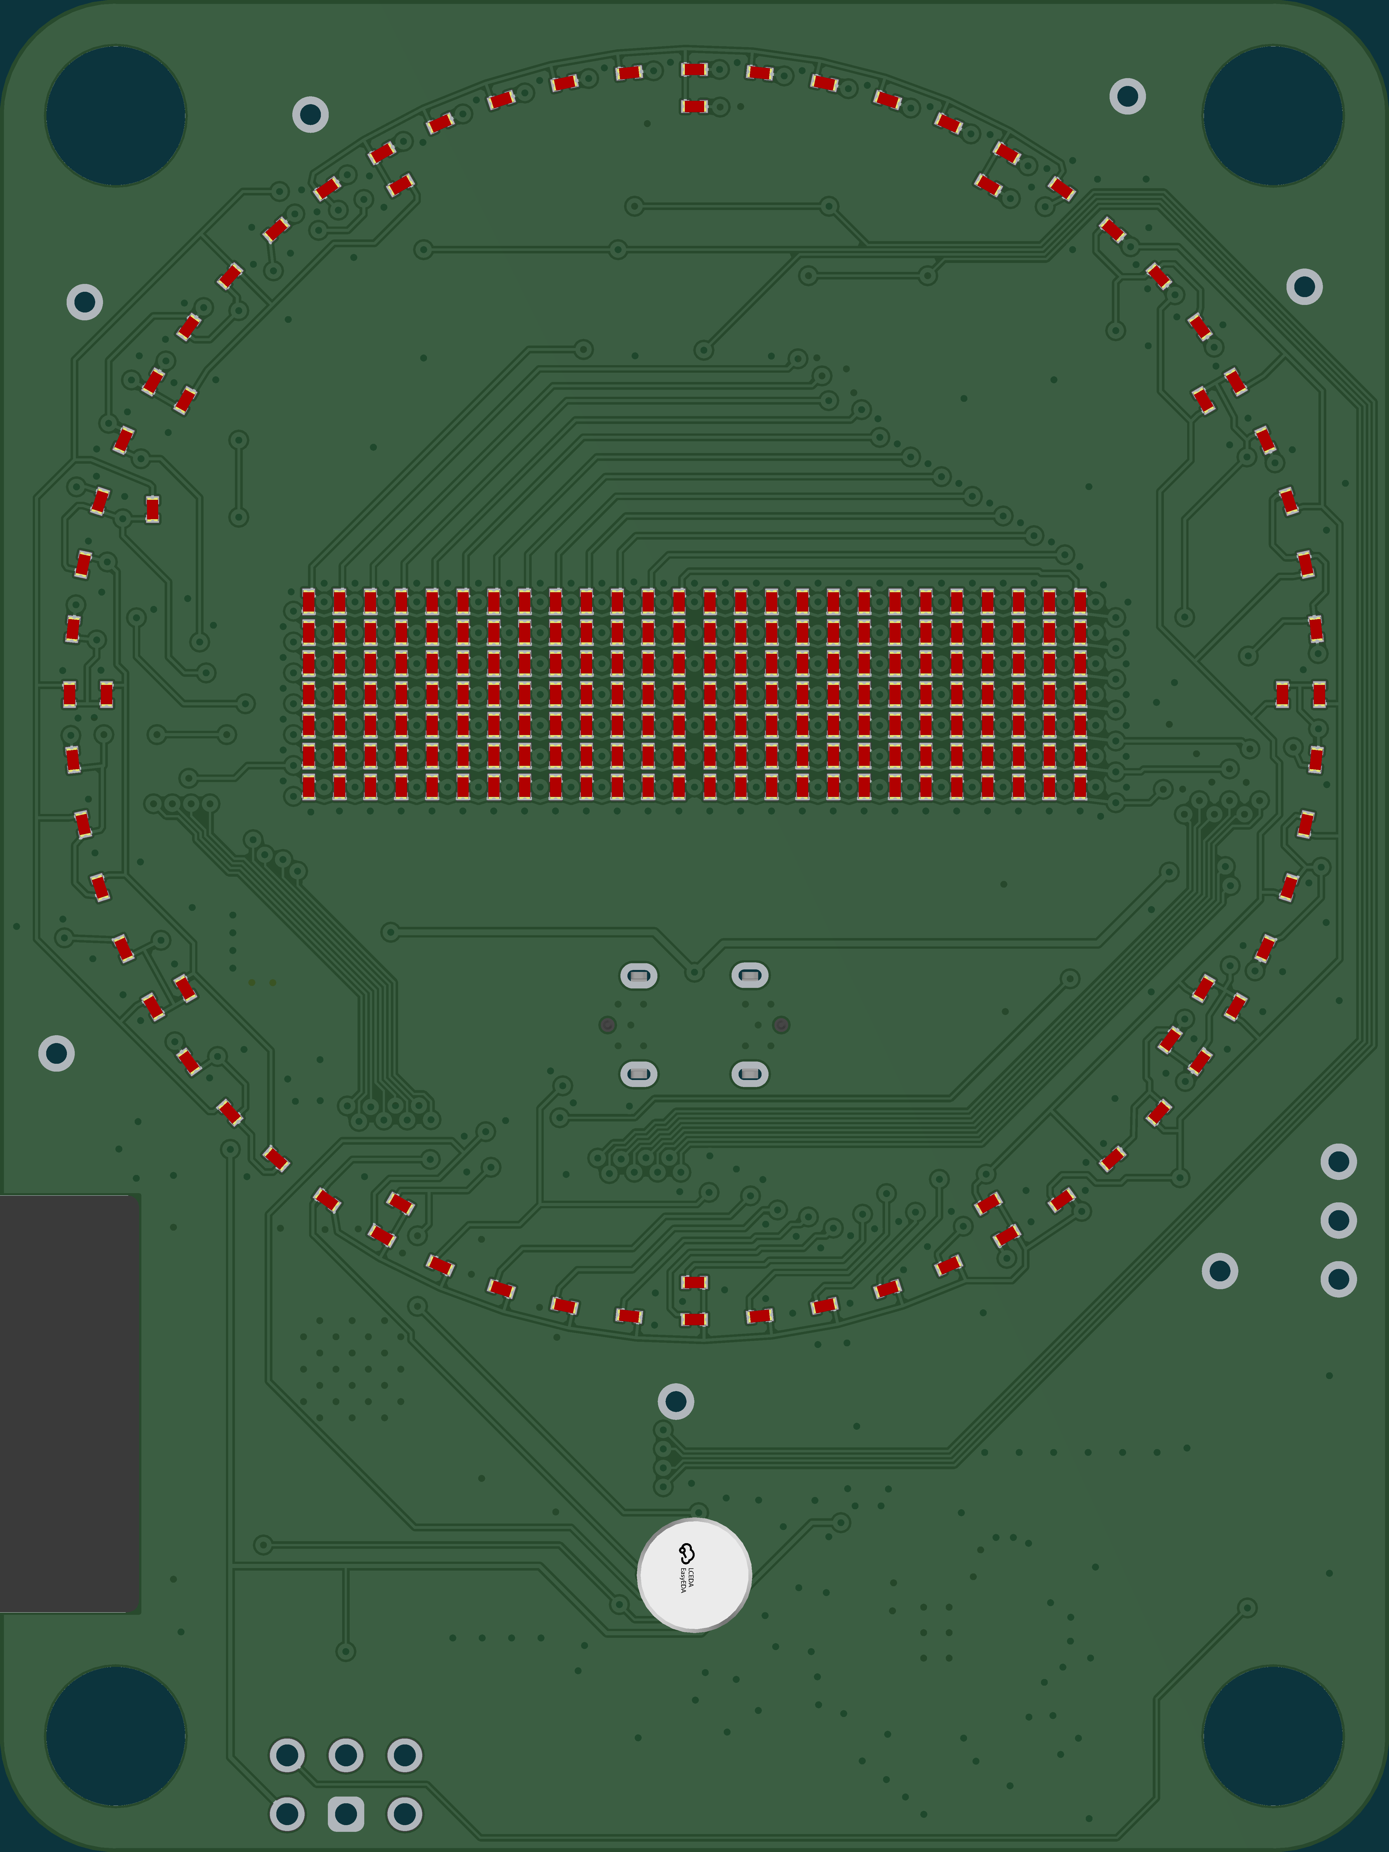
[picture p37: page 9]

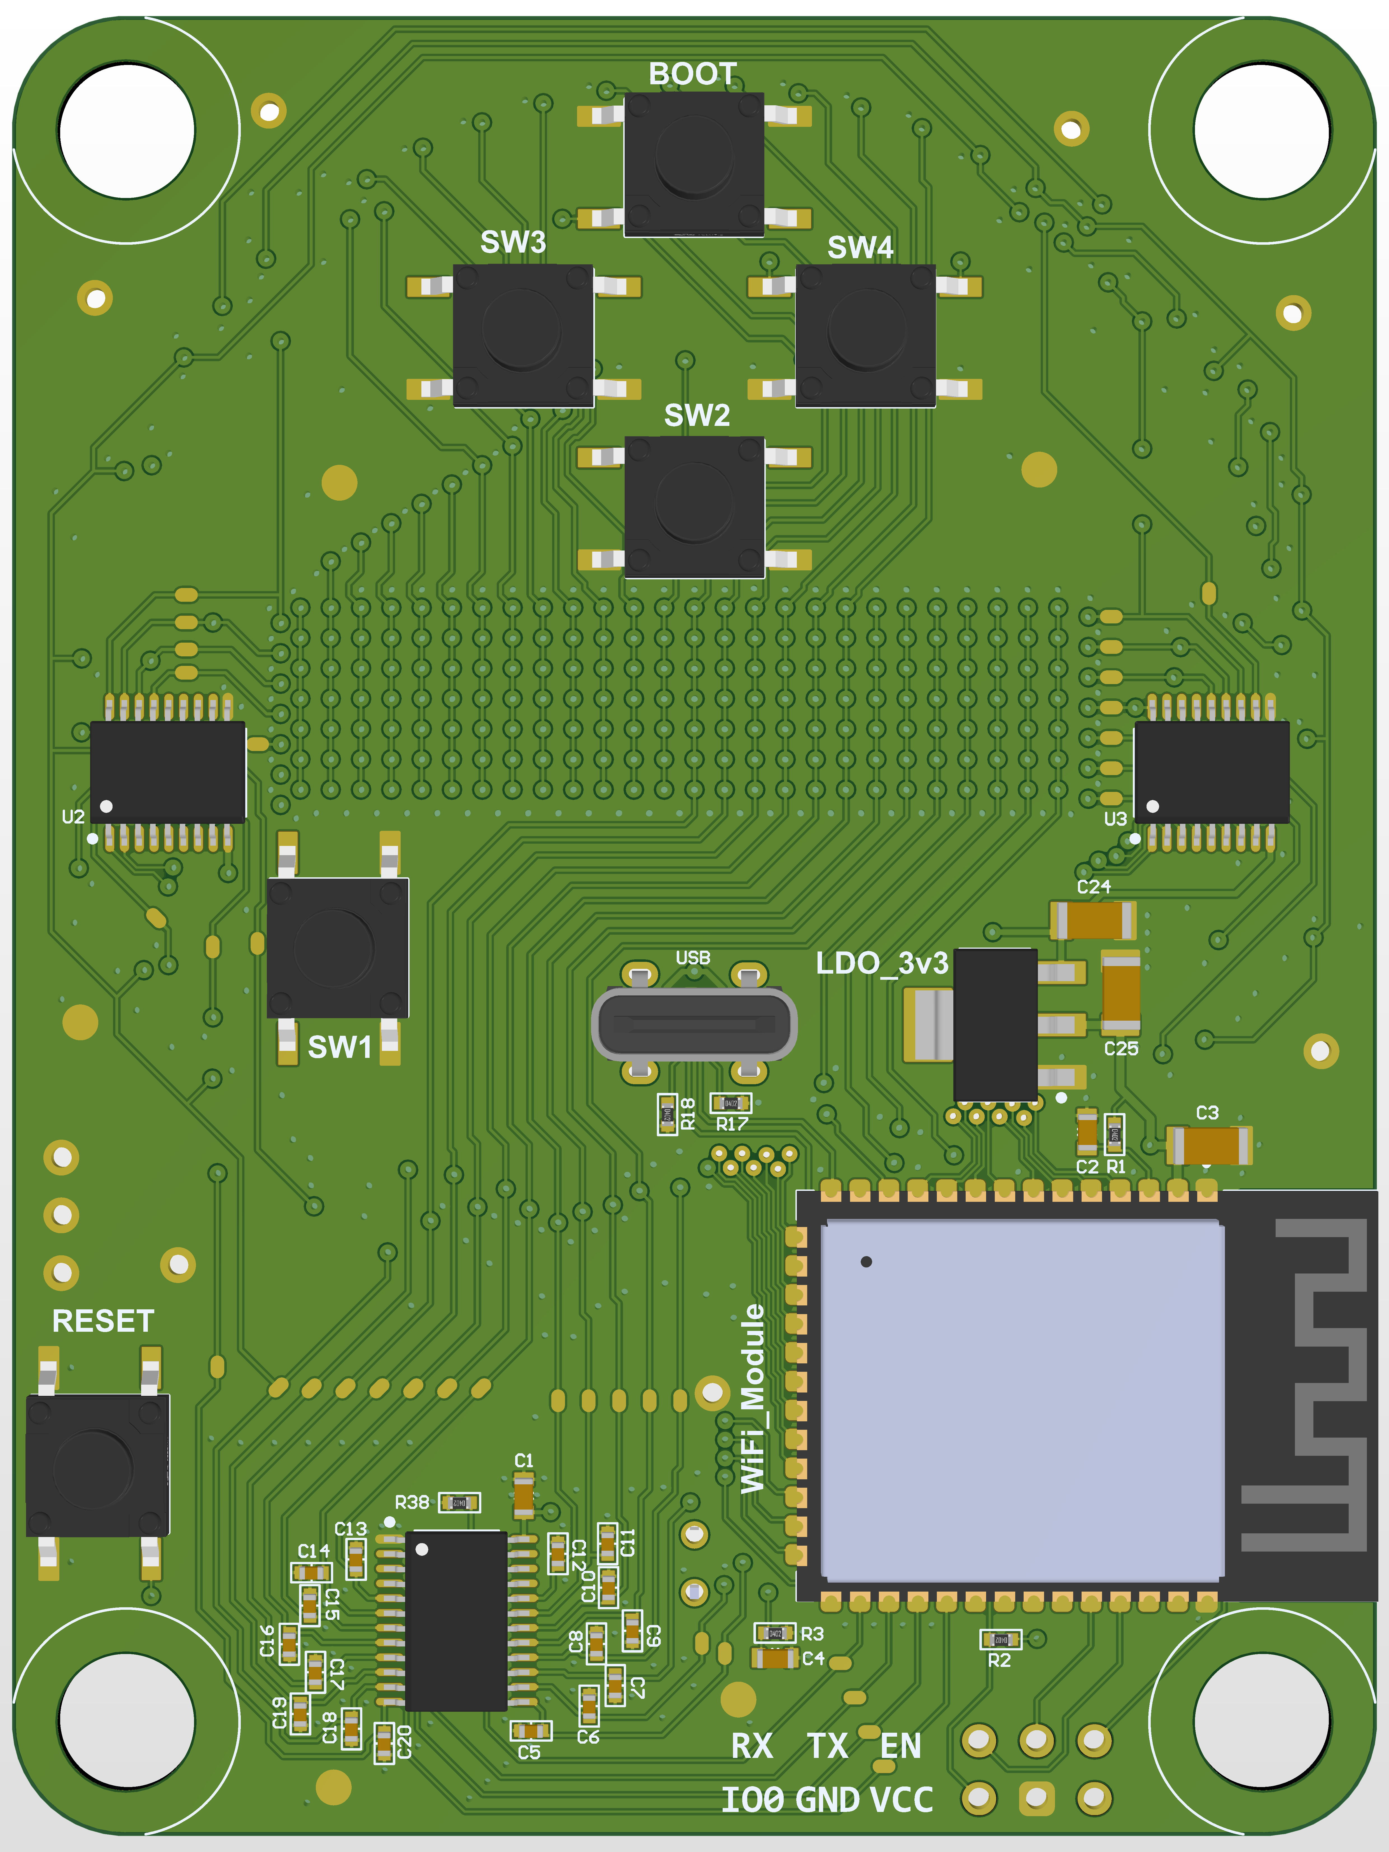
[picture p38: page 10]
