cskilbeck/clock_monsieur/pcb/Outputs/2025-12-22/clock_led.pdf

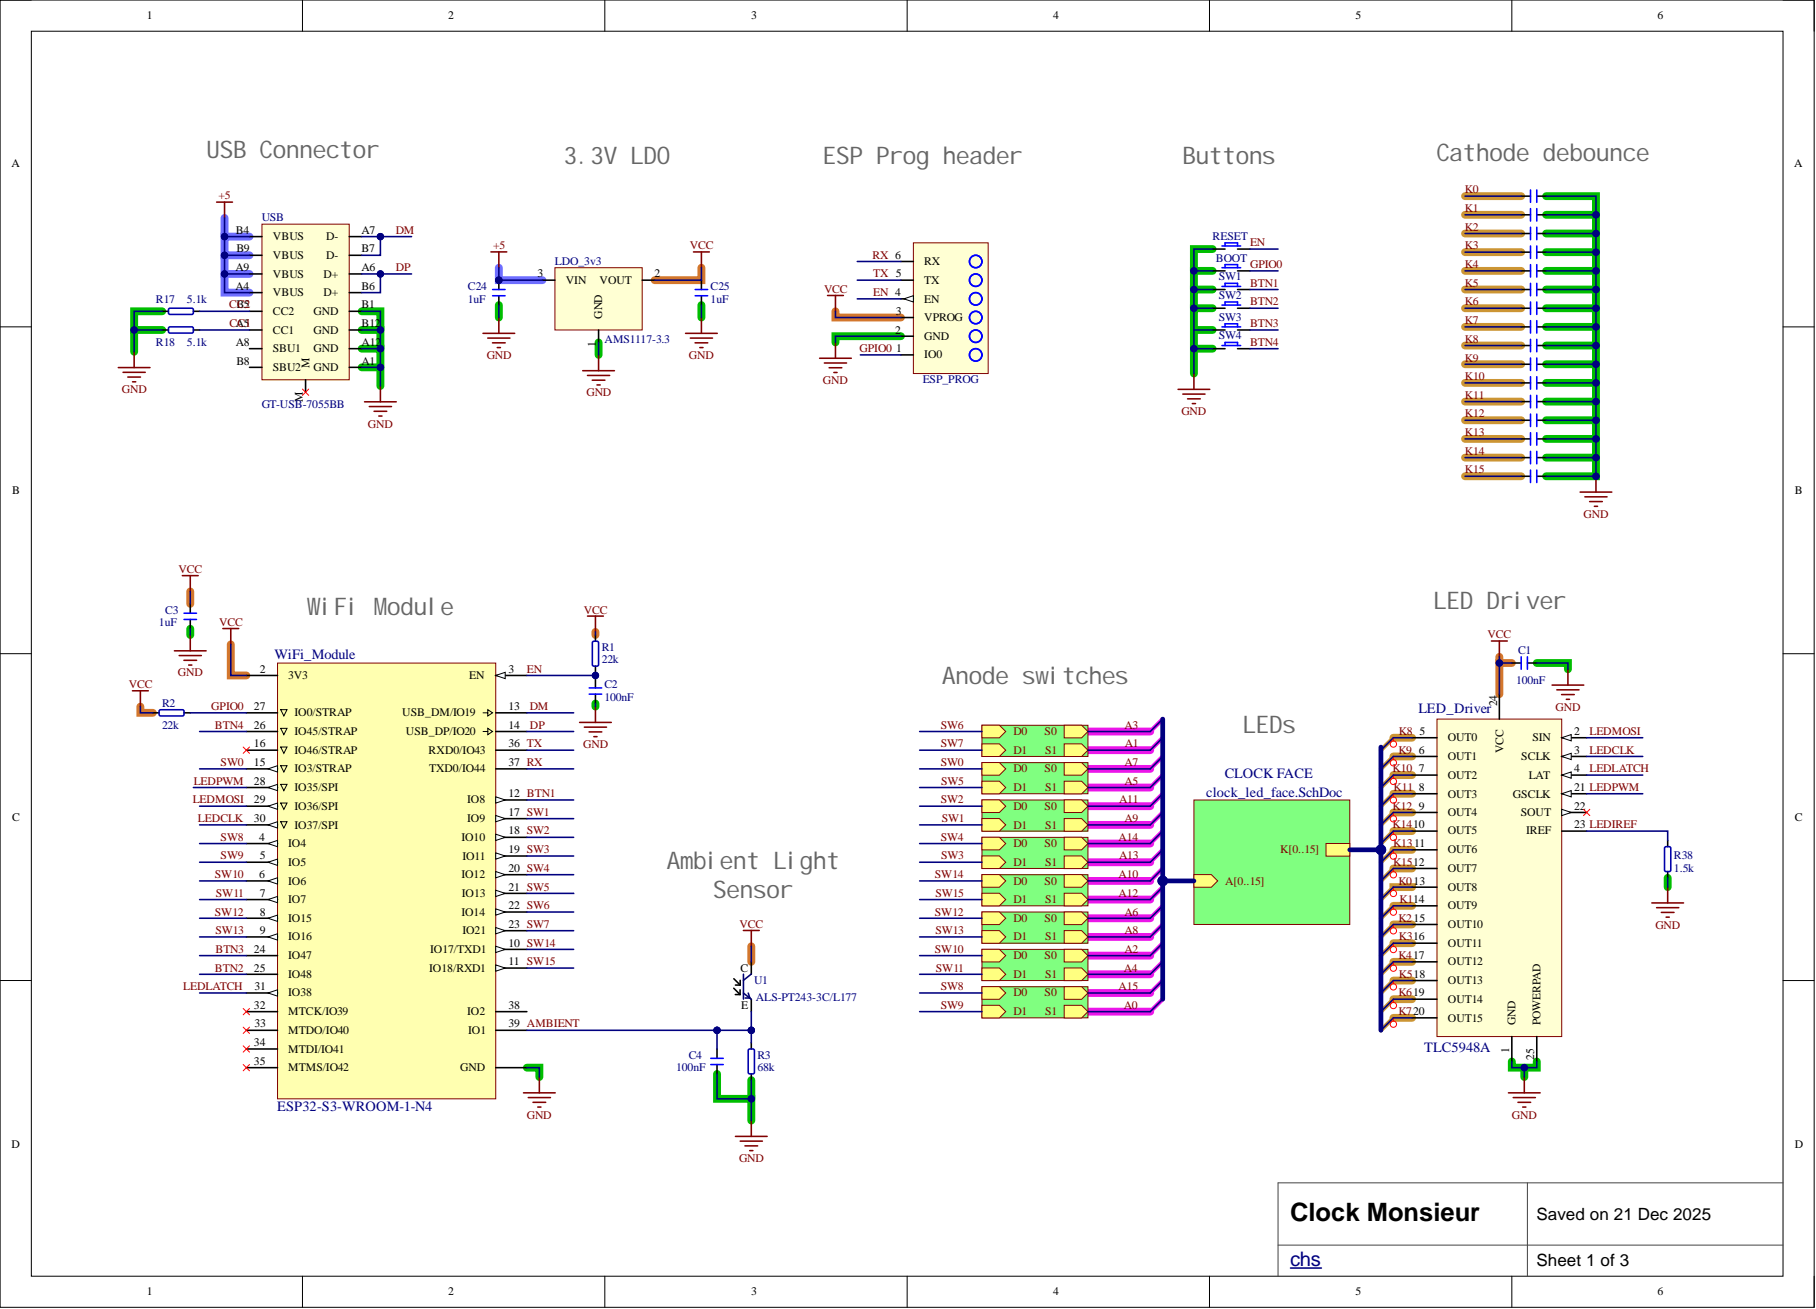
[picture p39: page 1]

A 9 | A 6
A4

Sheet 1 of 3 Saved on 21 Dec 2025


Sheet 2 of 3 Saved on 18 Dec 2025


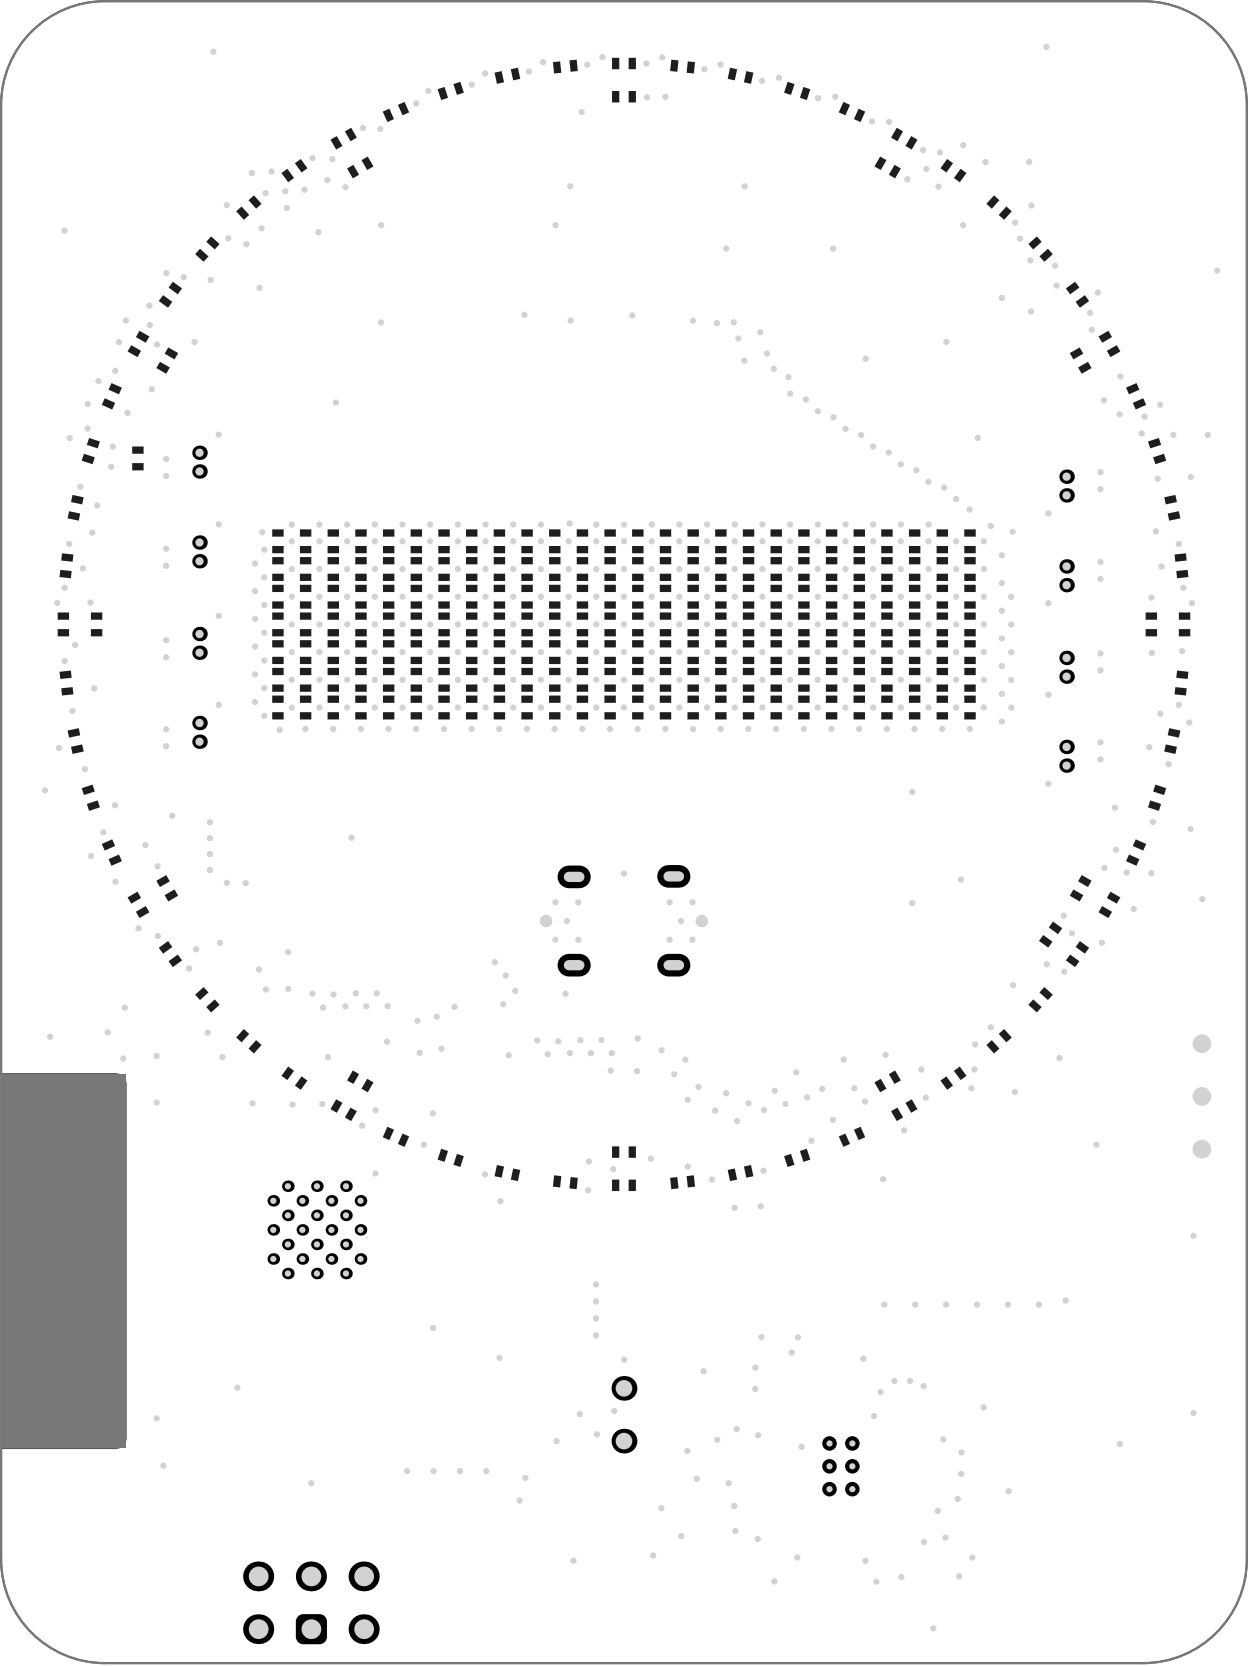
[picture p40: page 4]

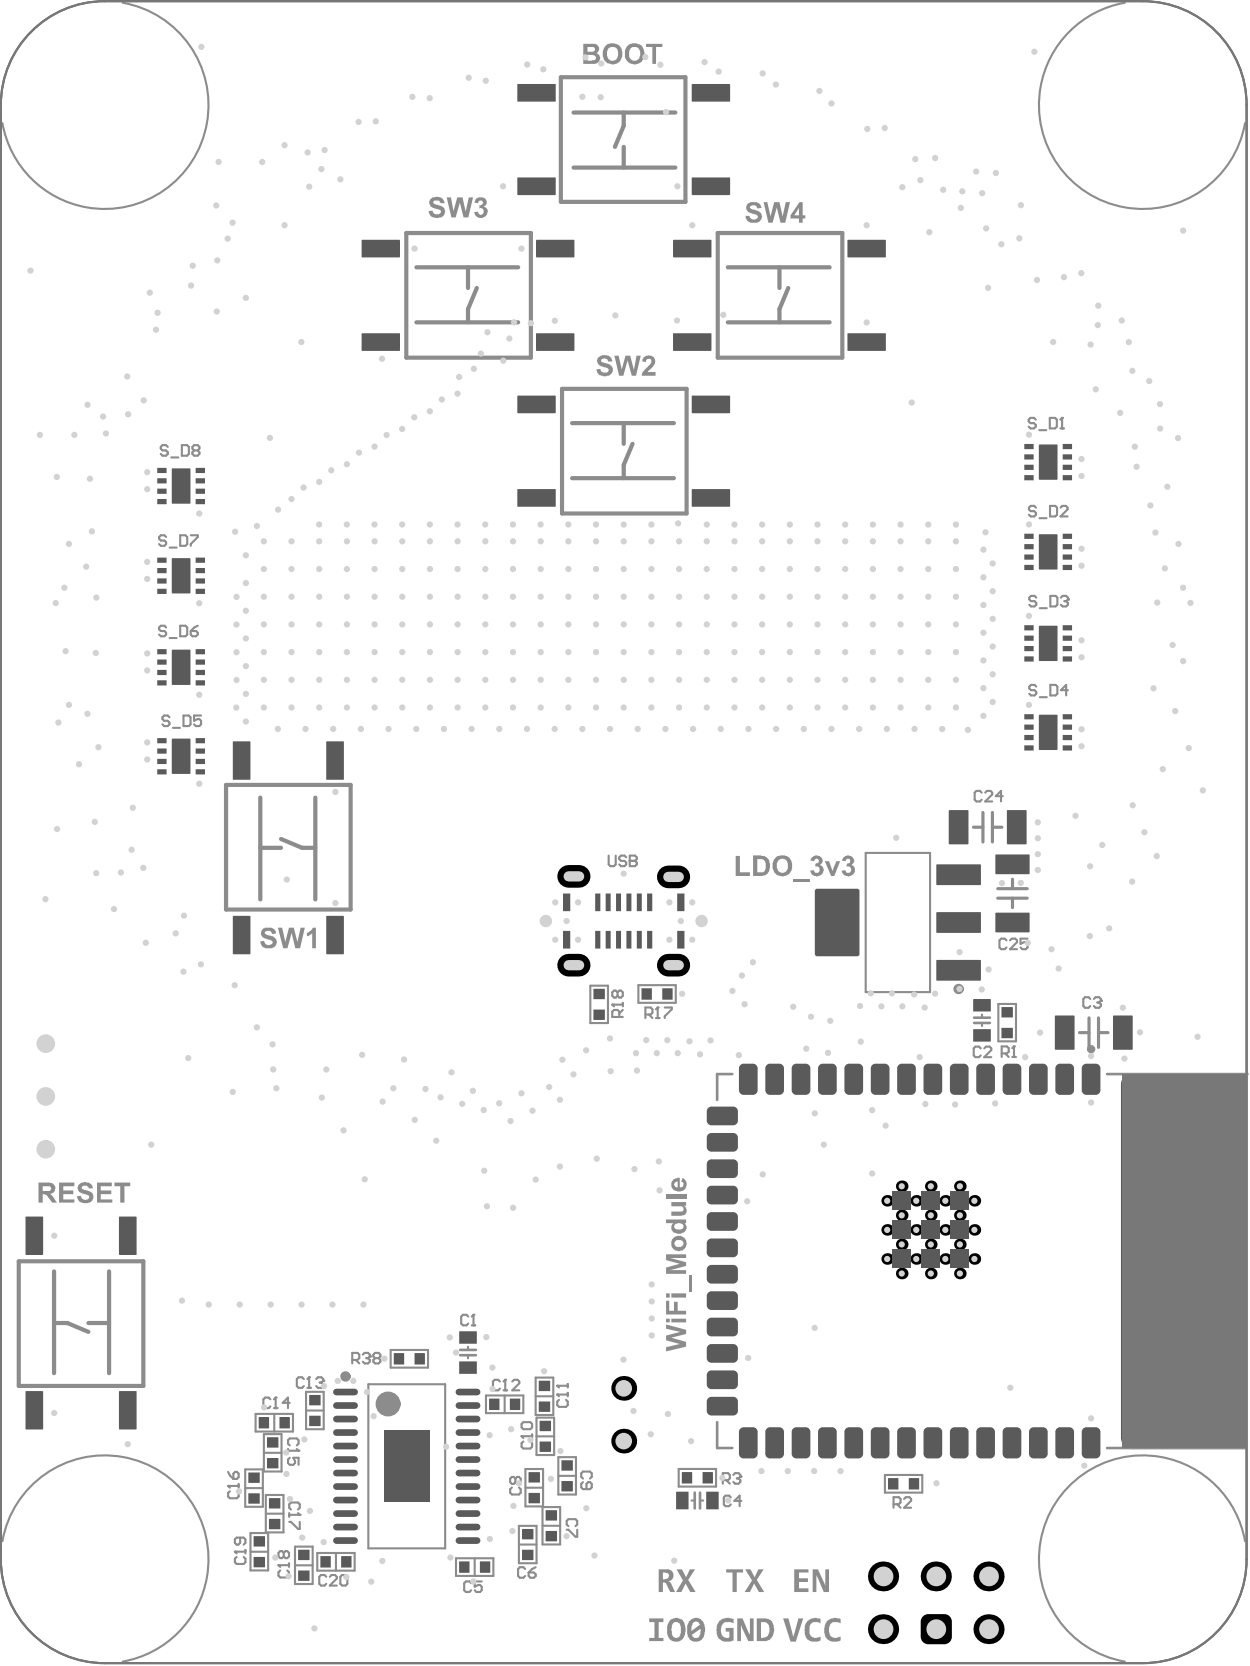
[picture p41: page 5]

### Electrical Rules Check Report

Class | Document | Message Successful Compile for clock_led.PrjPcb
Monday 22 Dec 2025 2:40:53 PM | Page 1 of 1

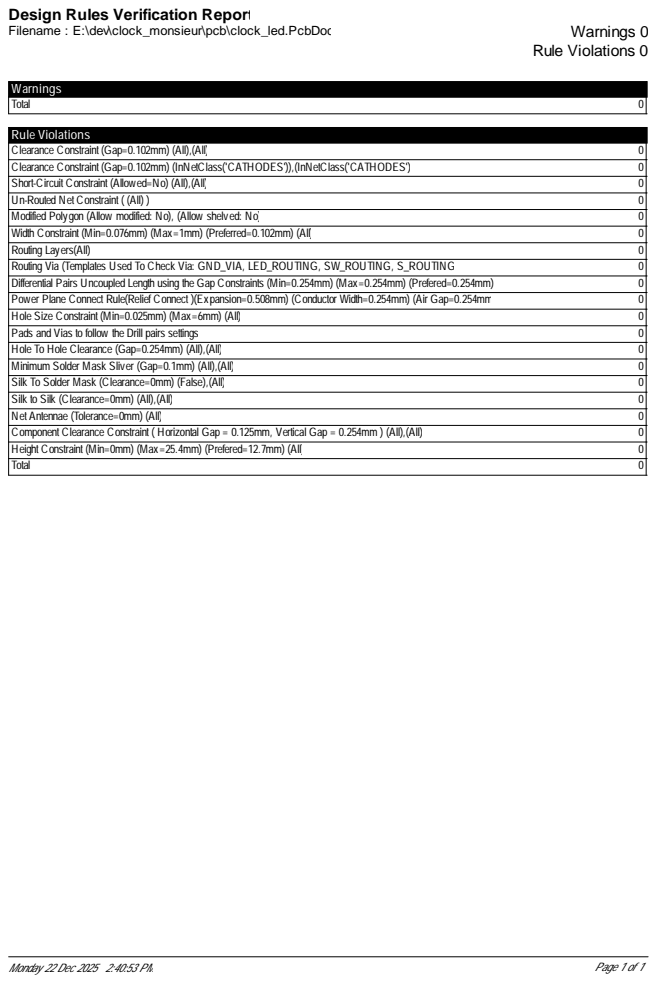
[picture p42: page 7]

Design Rules Verification Report

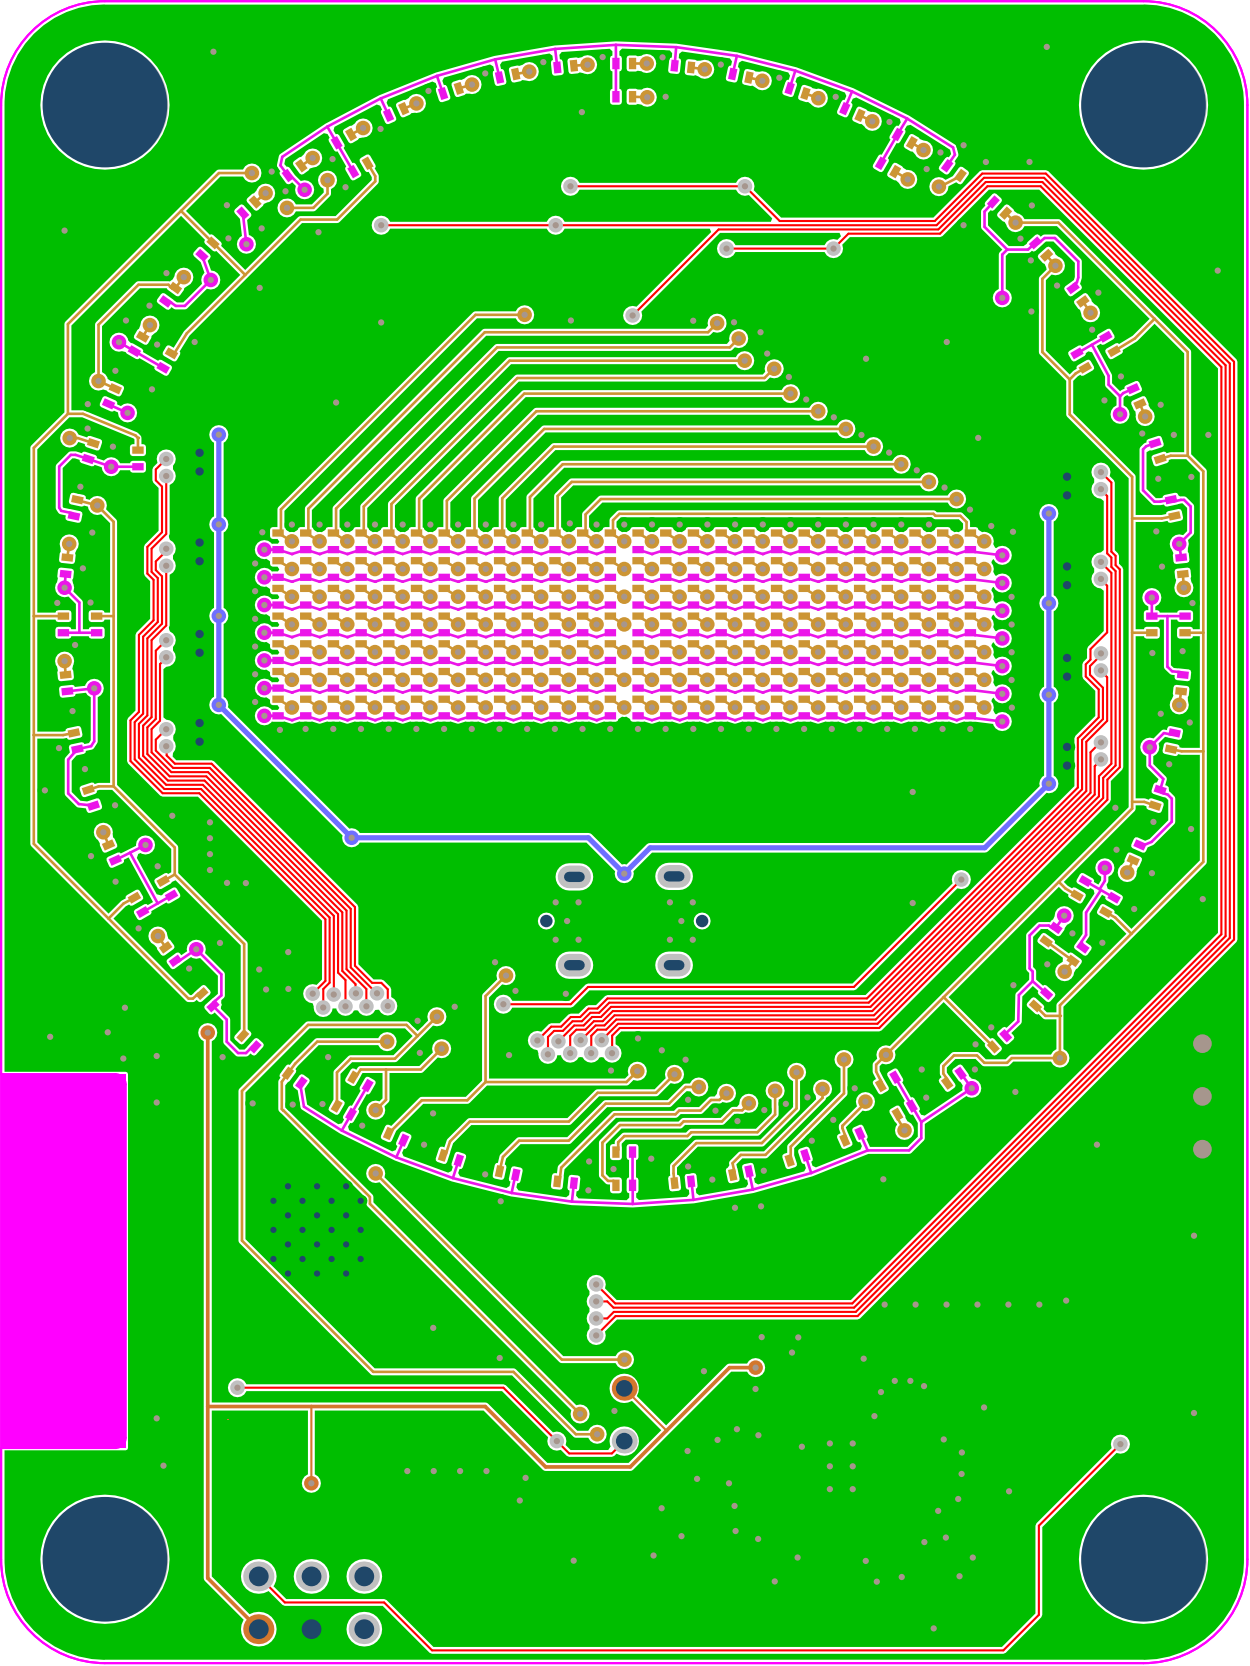
[picture p43: page 8]

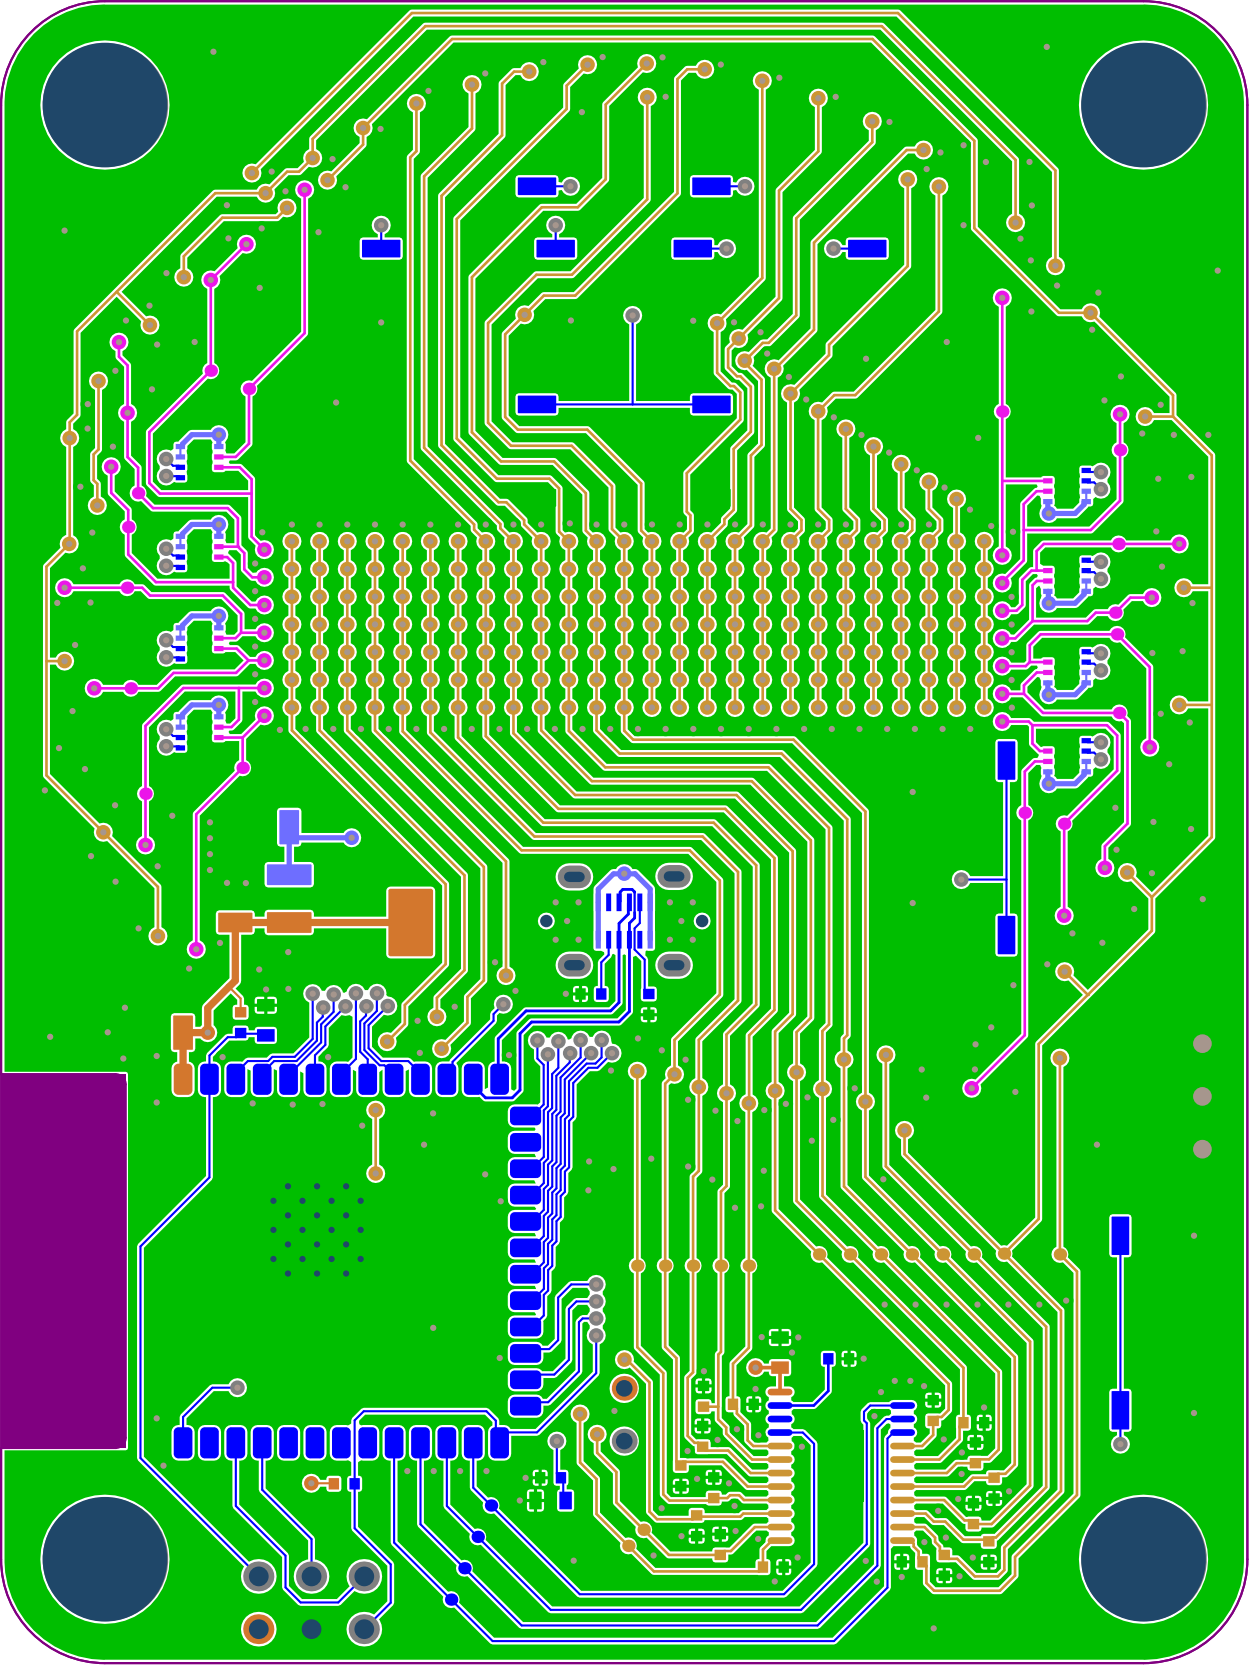
[picture p44: page 9]

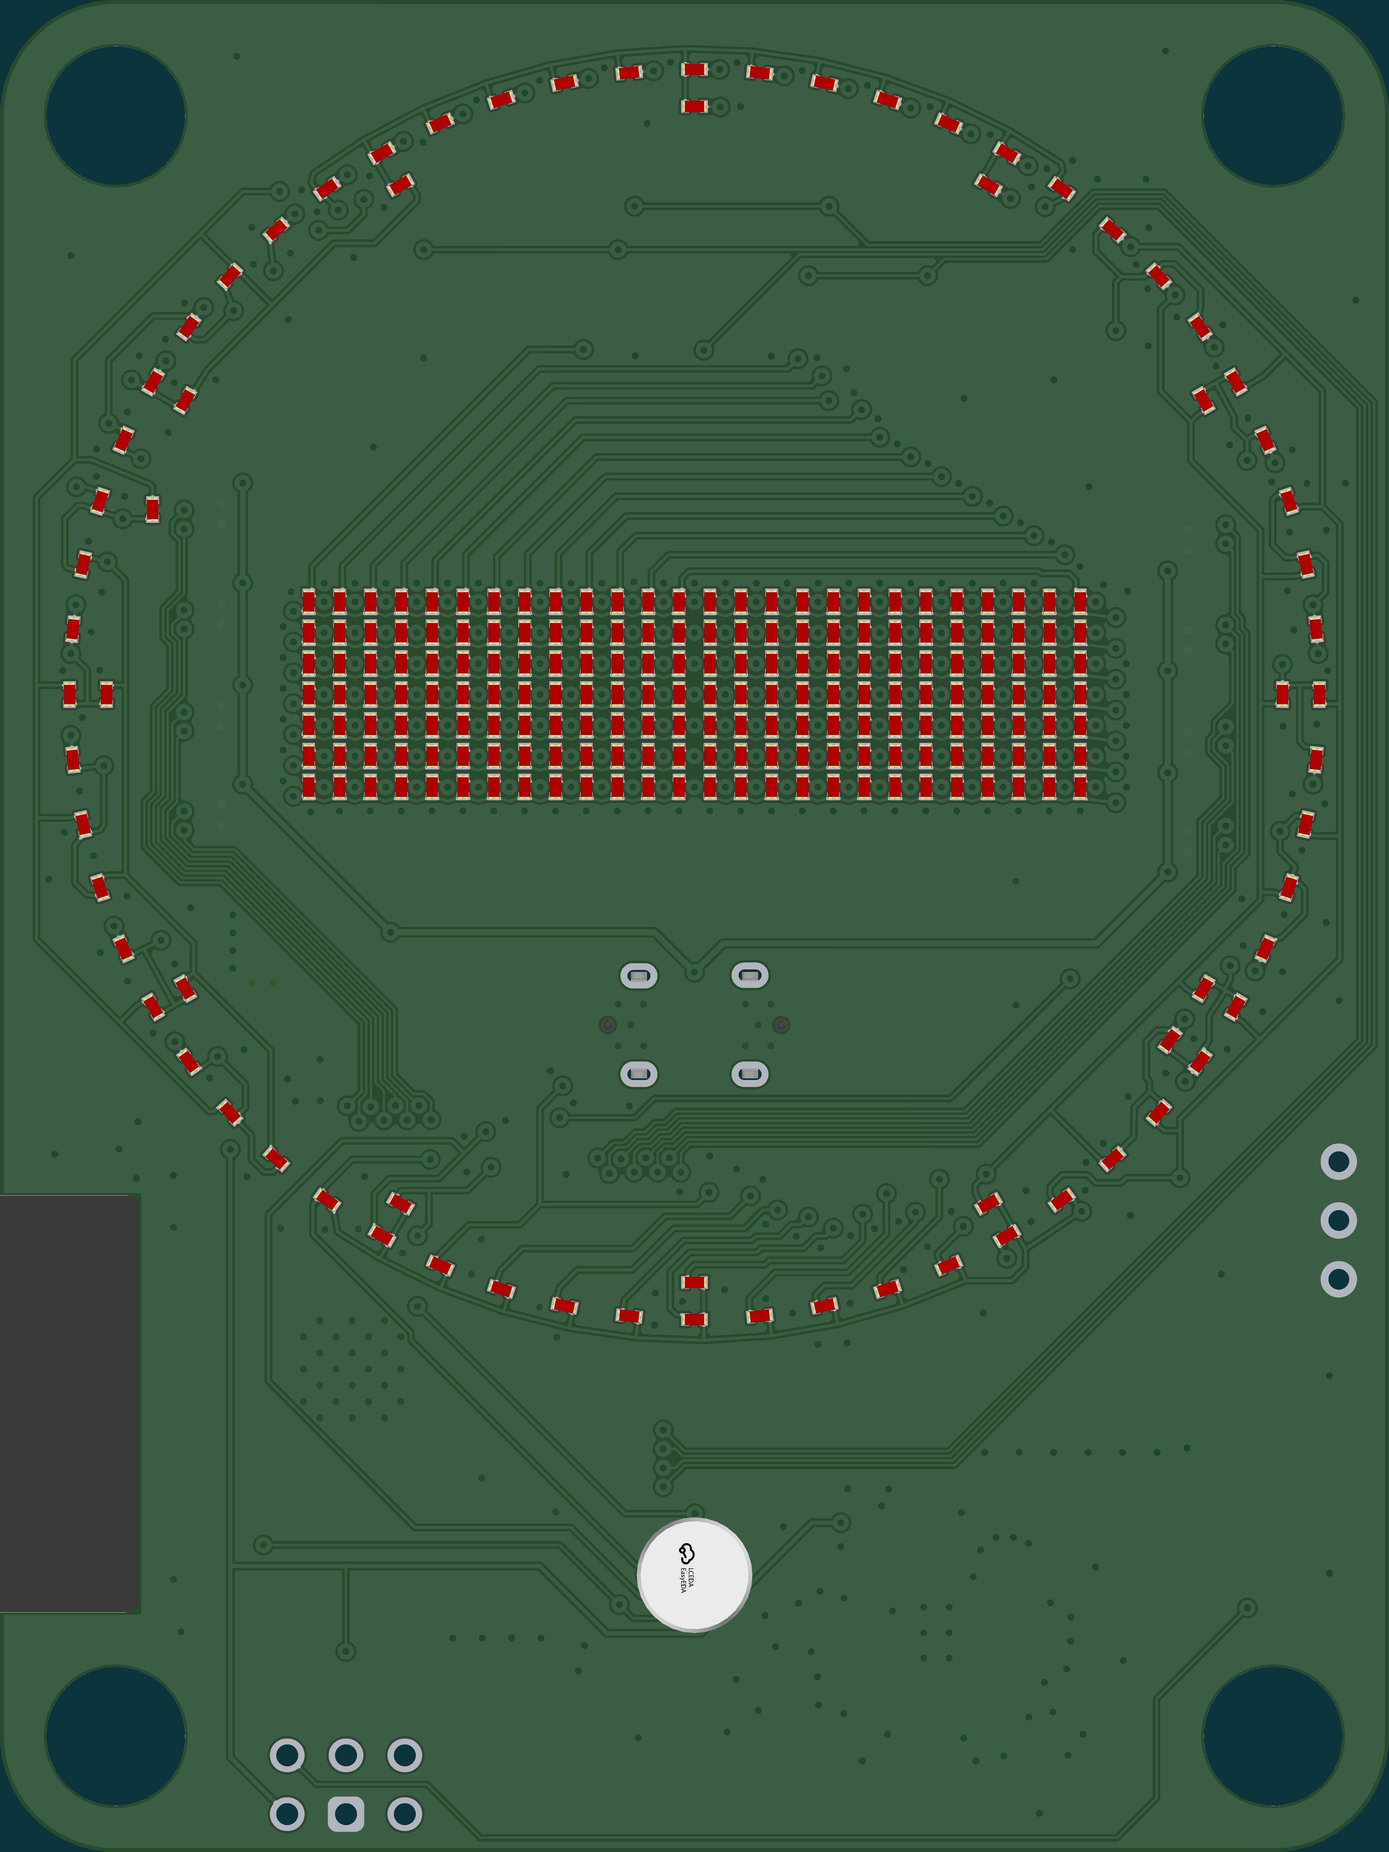
[picture p45: page 10]

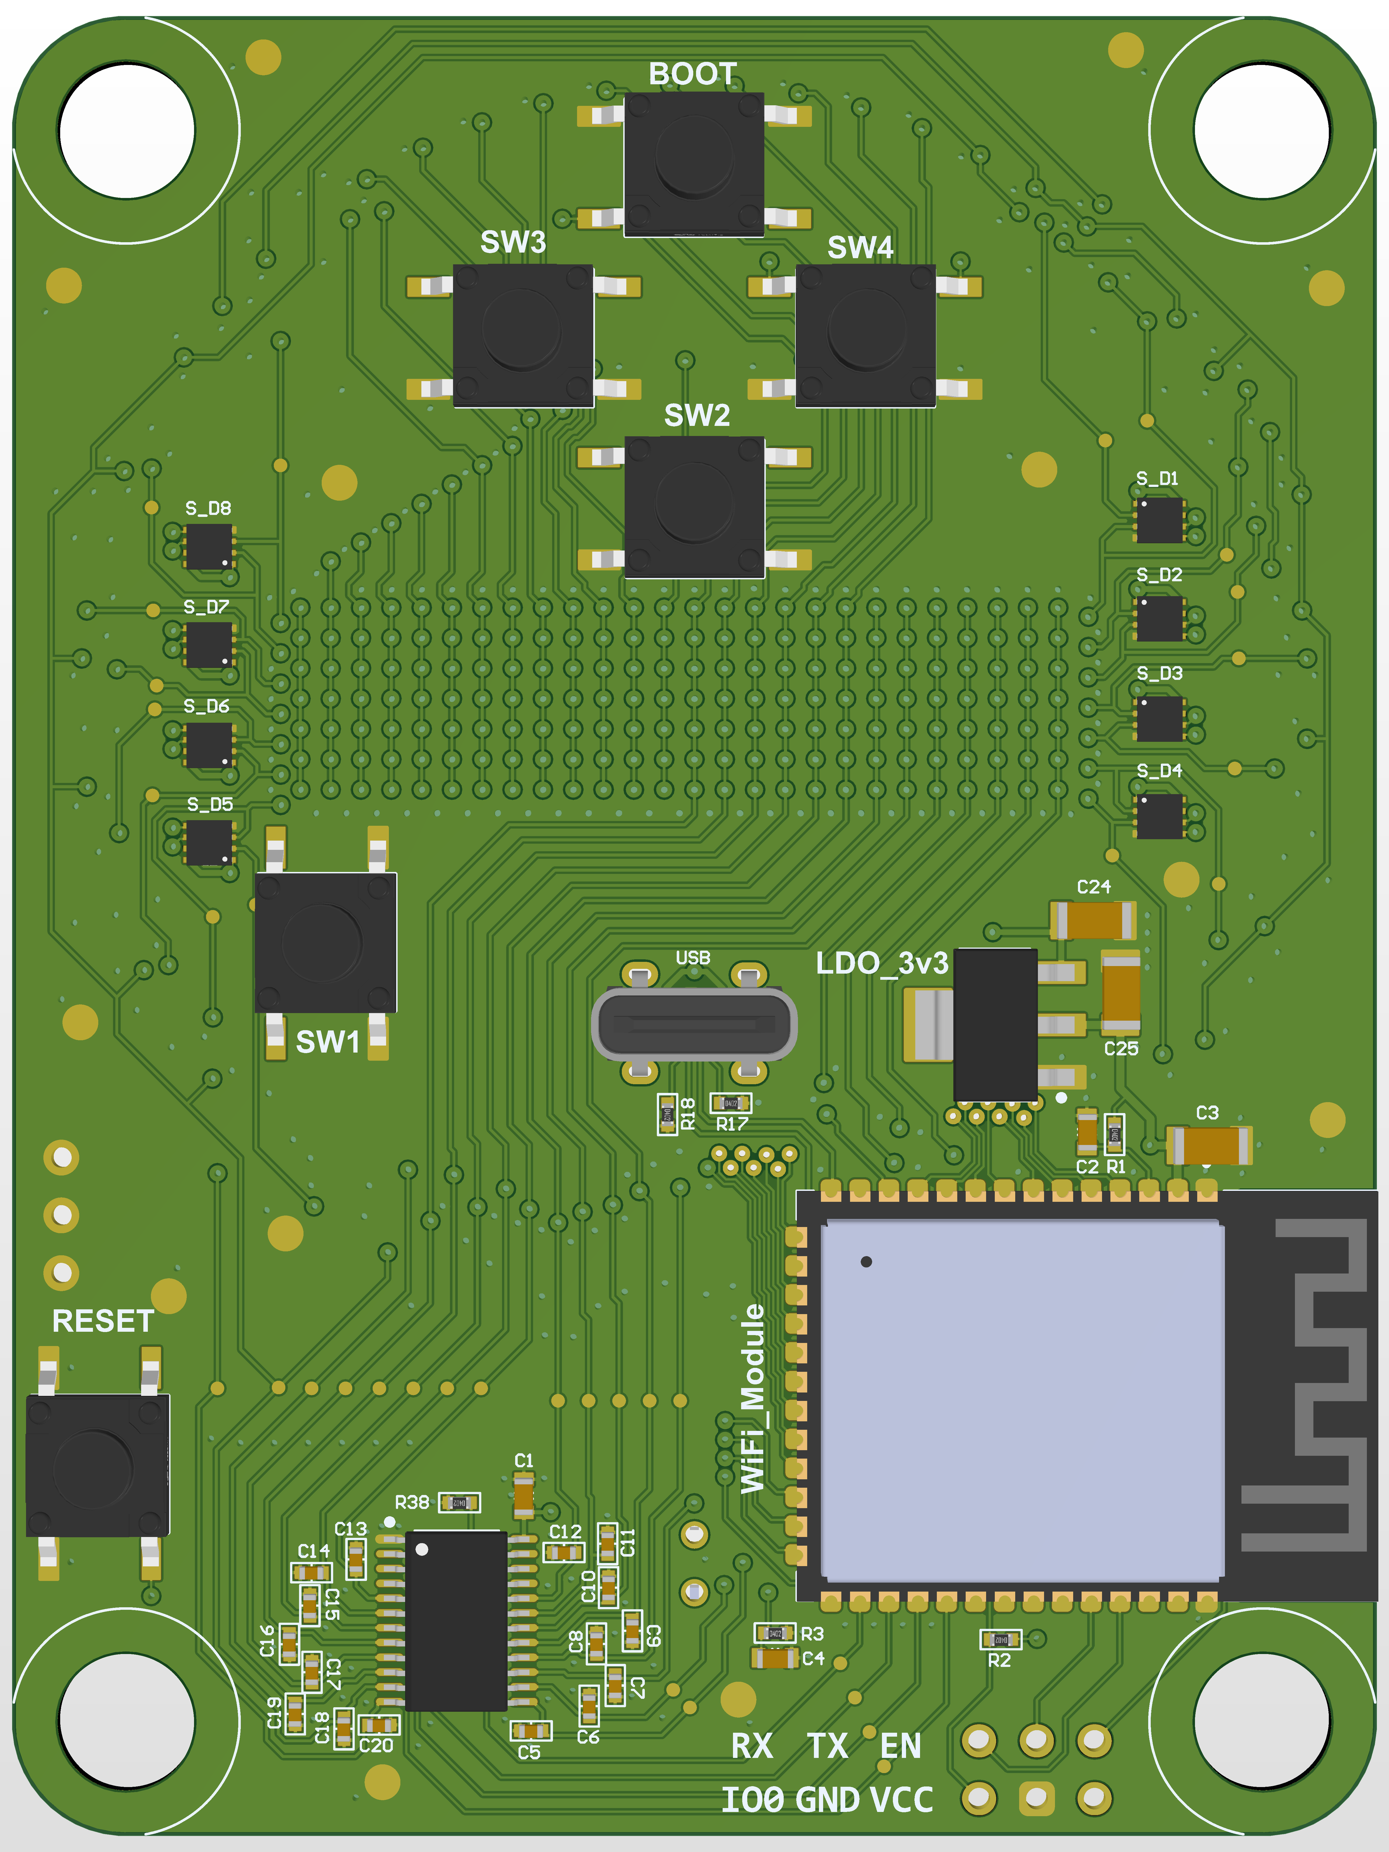
[picture p46: page 11]
