cskilbeck/clock_monsieur/pcb/Outputs/2025-12-19/clock_led.pdf

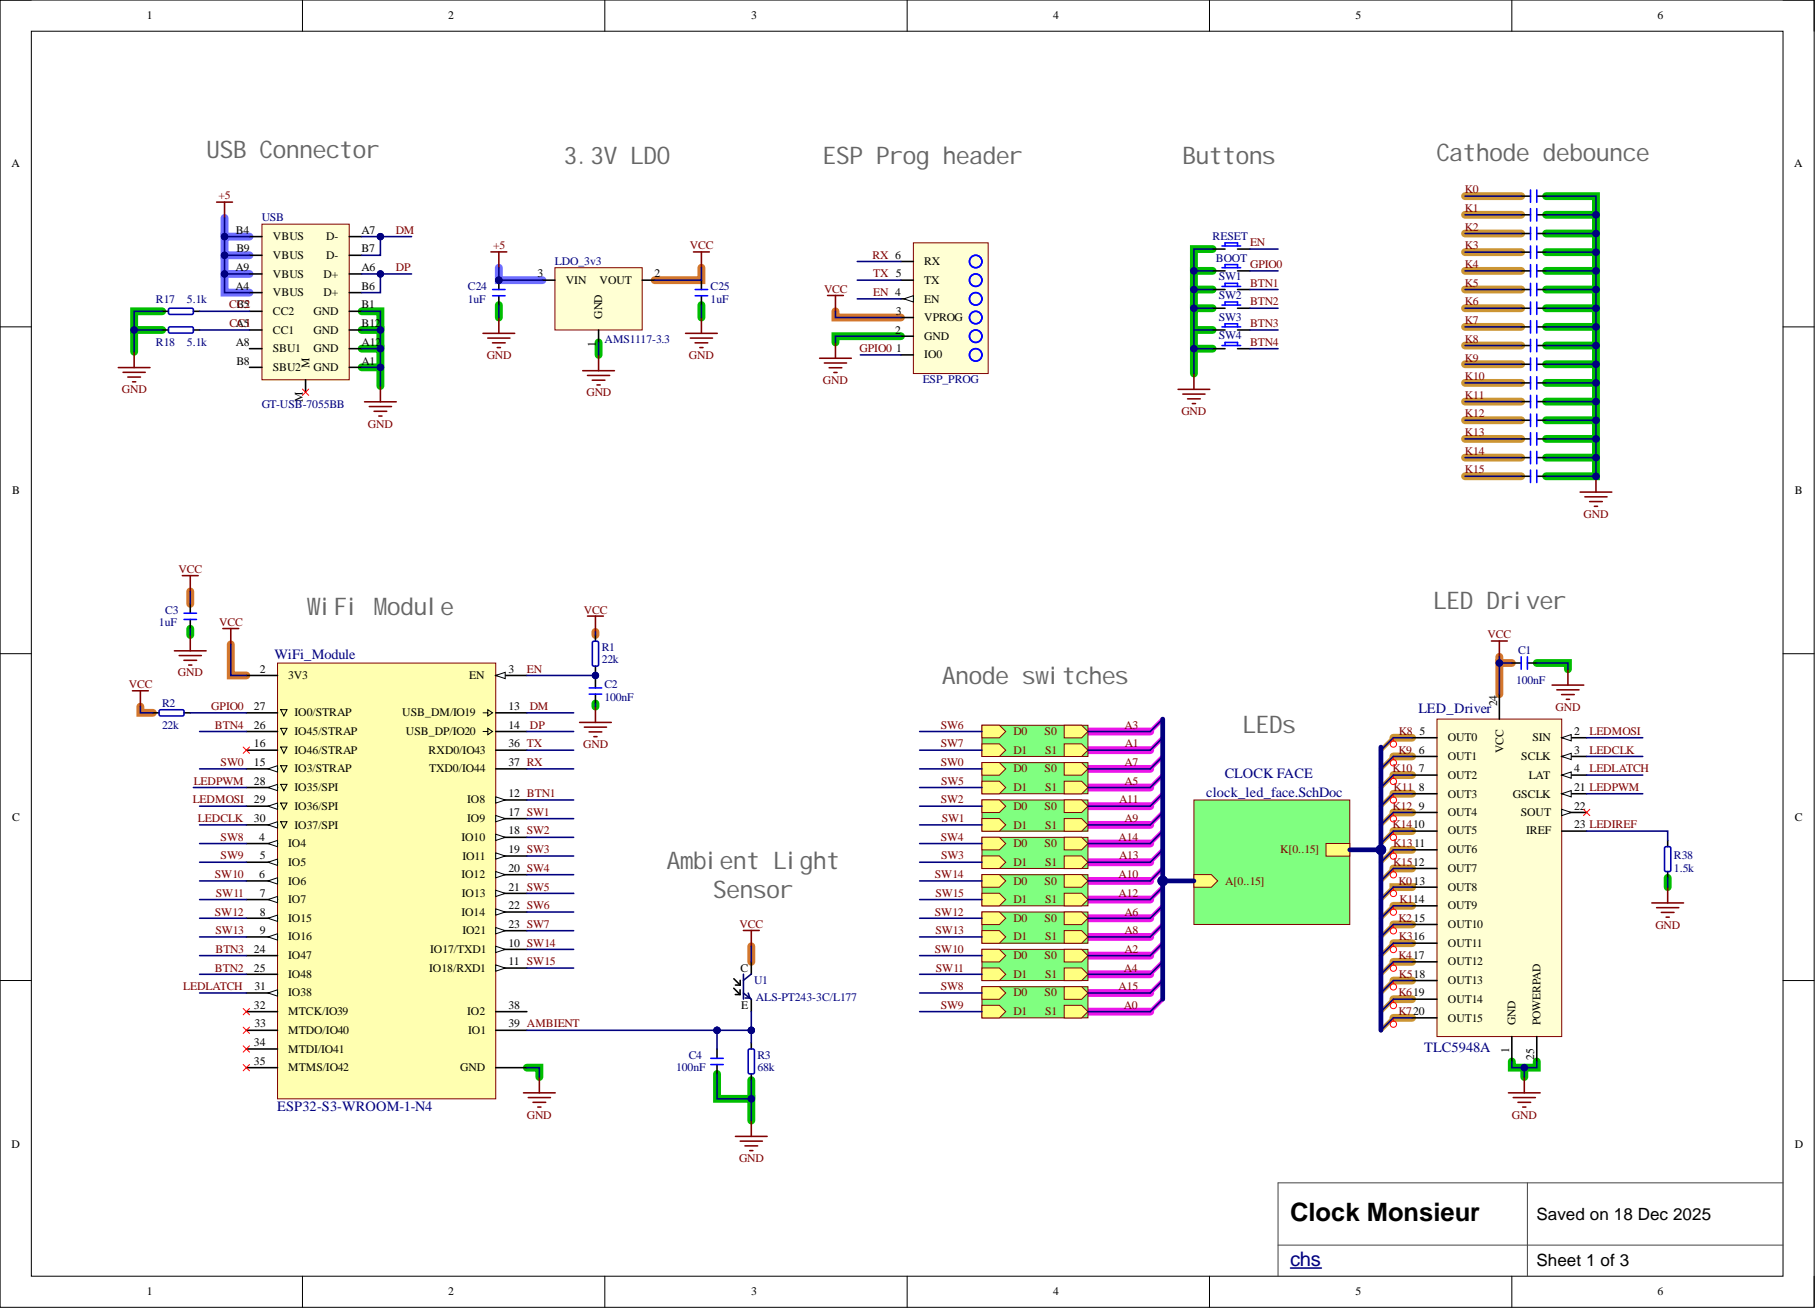
[picture p47: page 1]

A 9 | A 6
A4

Sheet 1 of 3 Saved on 18 Dec 2025


Sheet 2 of 3 Saved on 18 Dec 2025


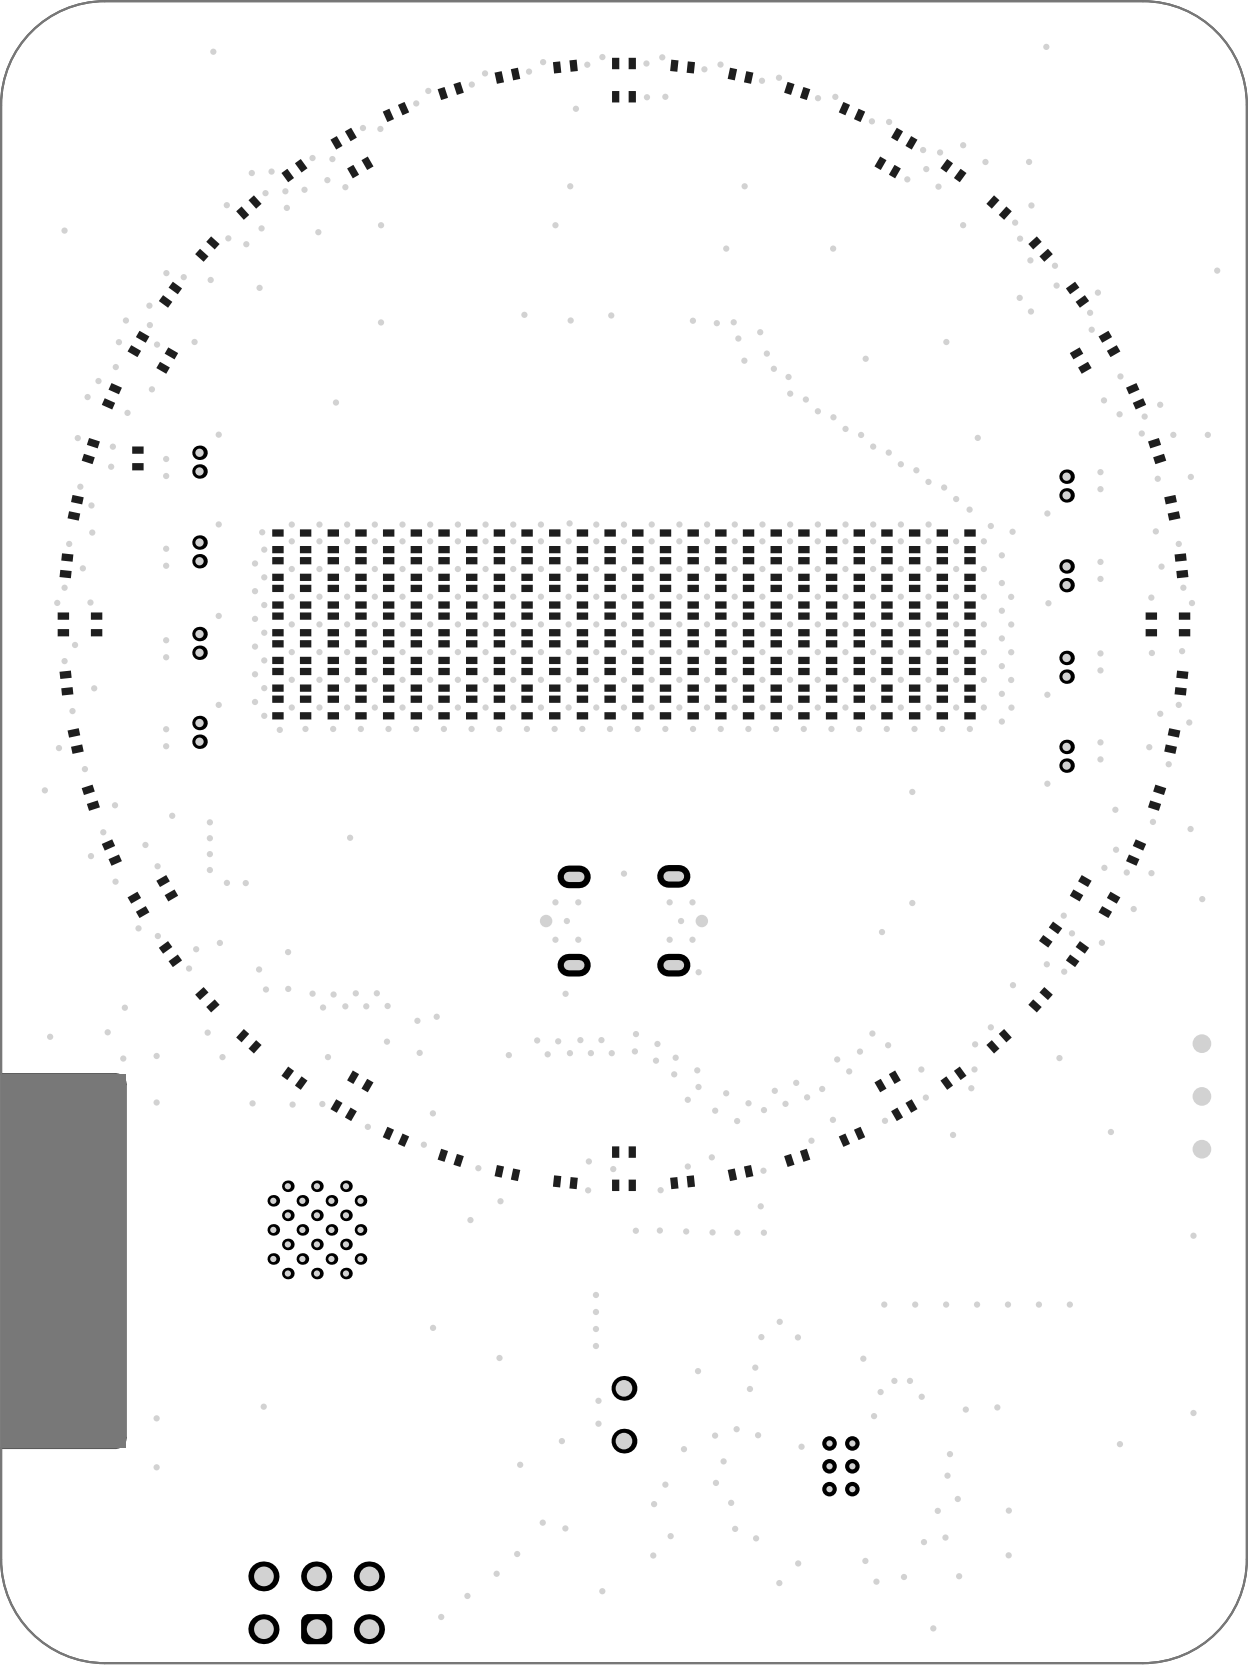
[picture p48: page 4]

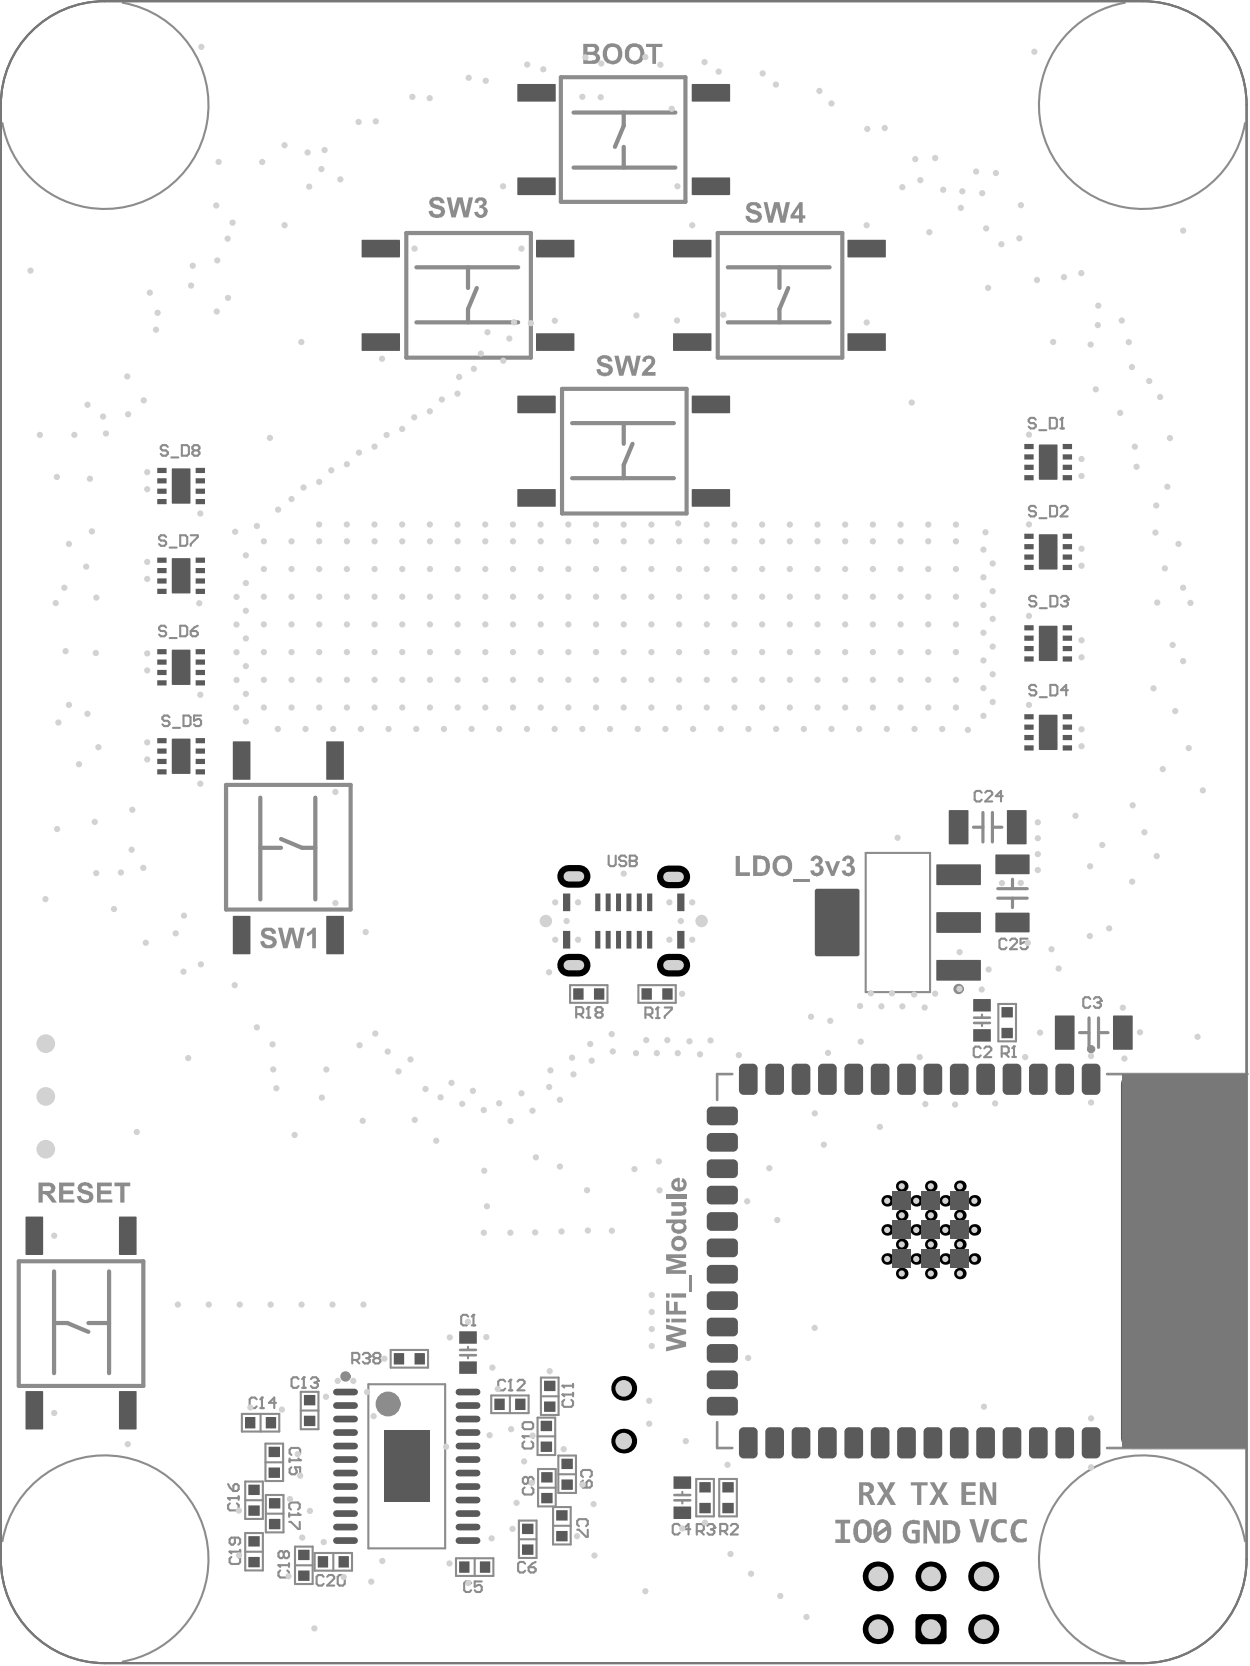
[picture p49: page 5]

### Electrical Rules Check Report

Class | Document | Message Successful Compile for clock_led.PrjPcb
Friday 19 Dec 2025 10:45:51 AM | Page 1 of 1

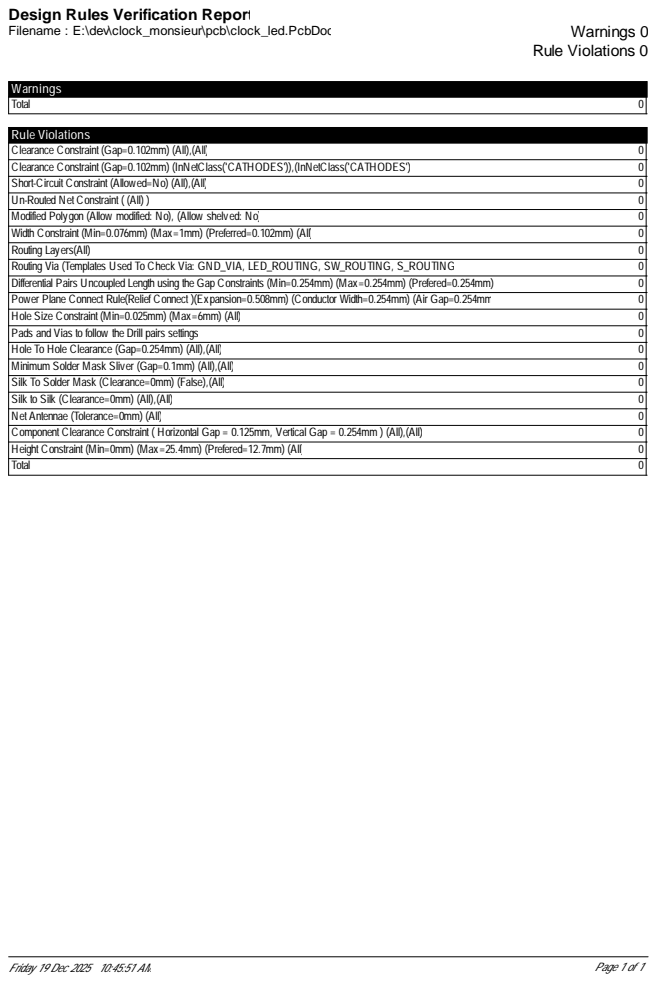
[picture p50: page 7]

Design Rules Verification Report

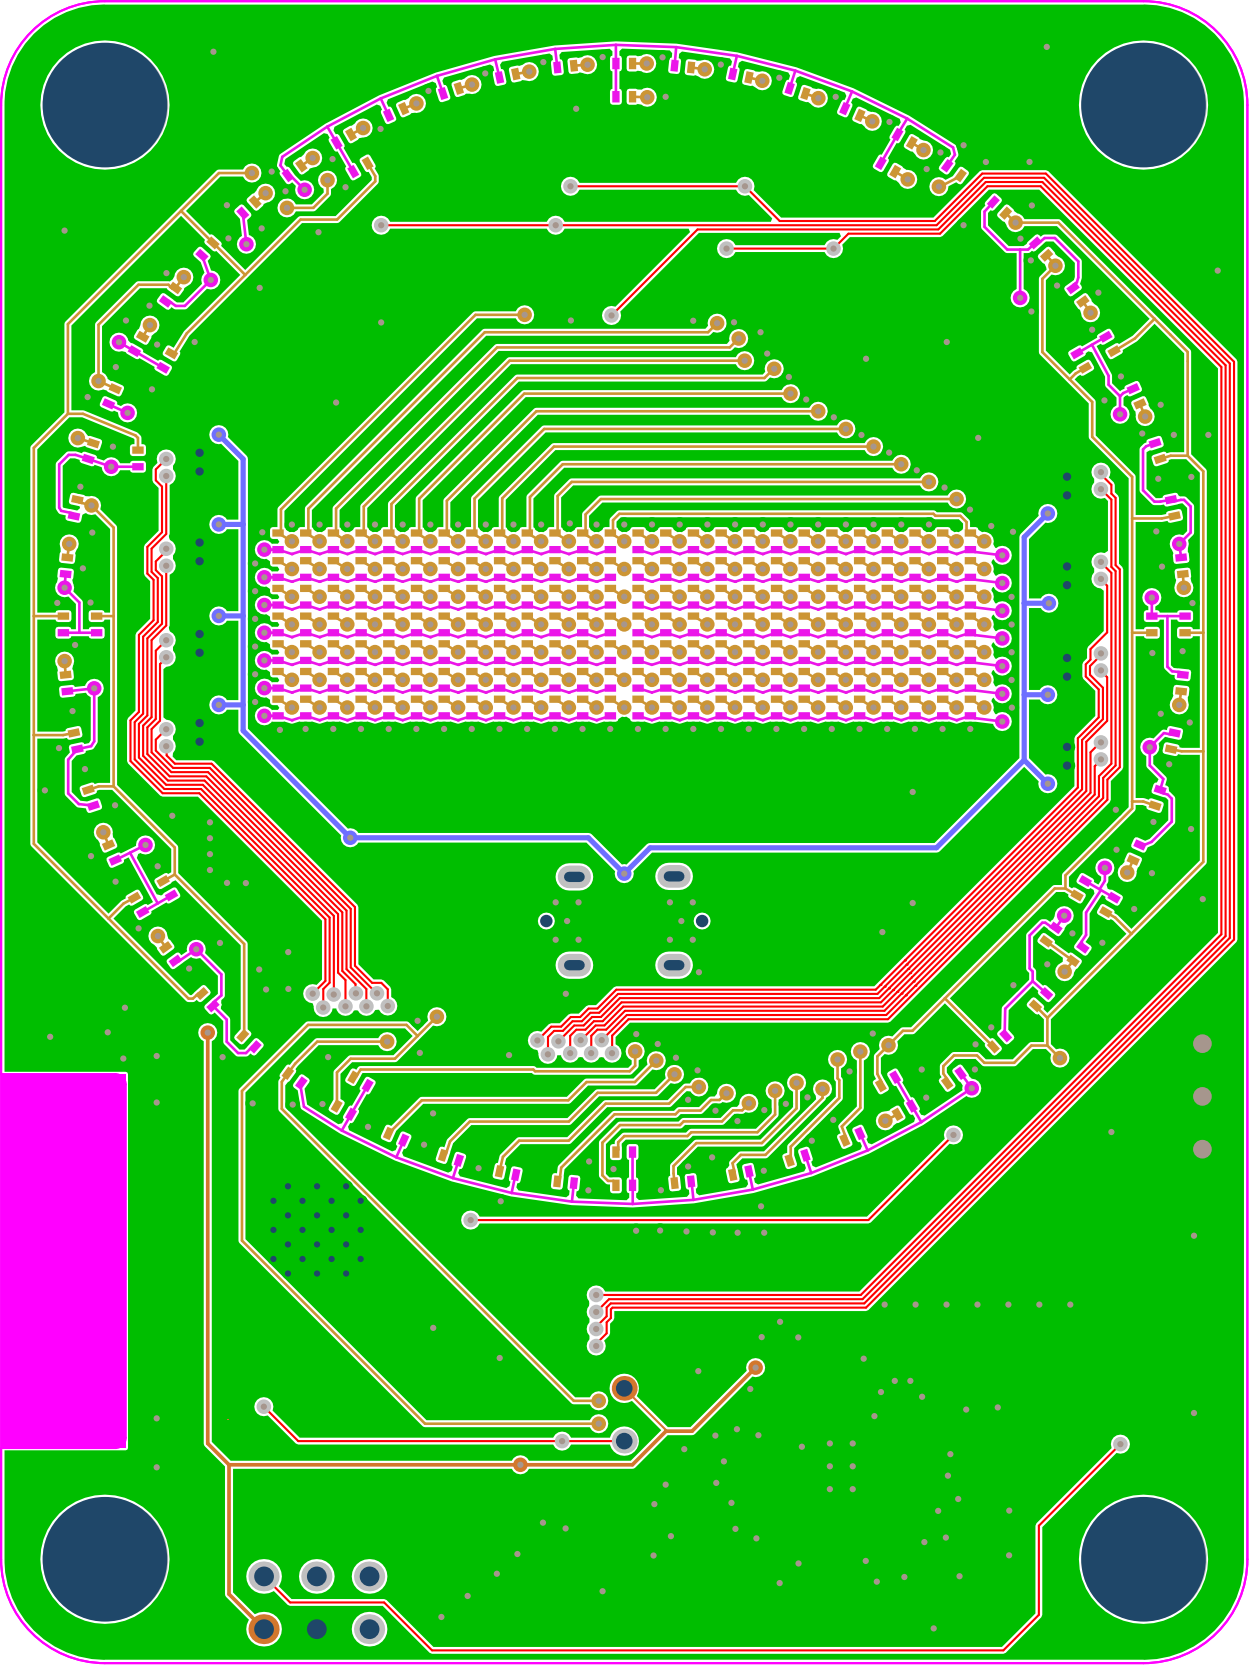
[picture p51: page 8]

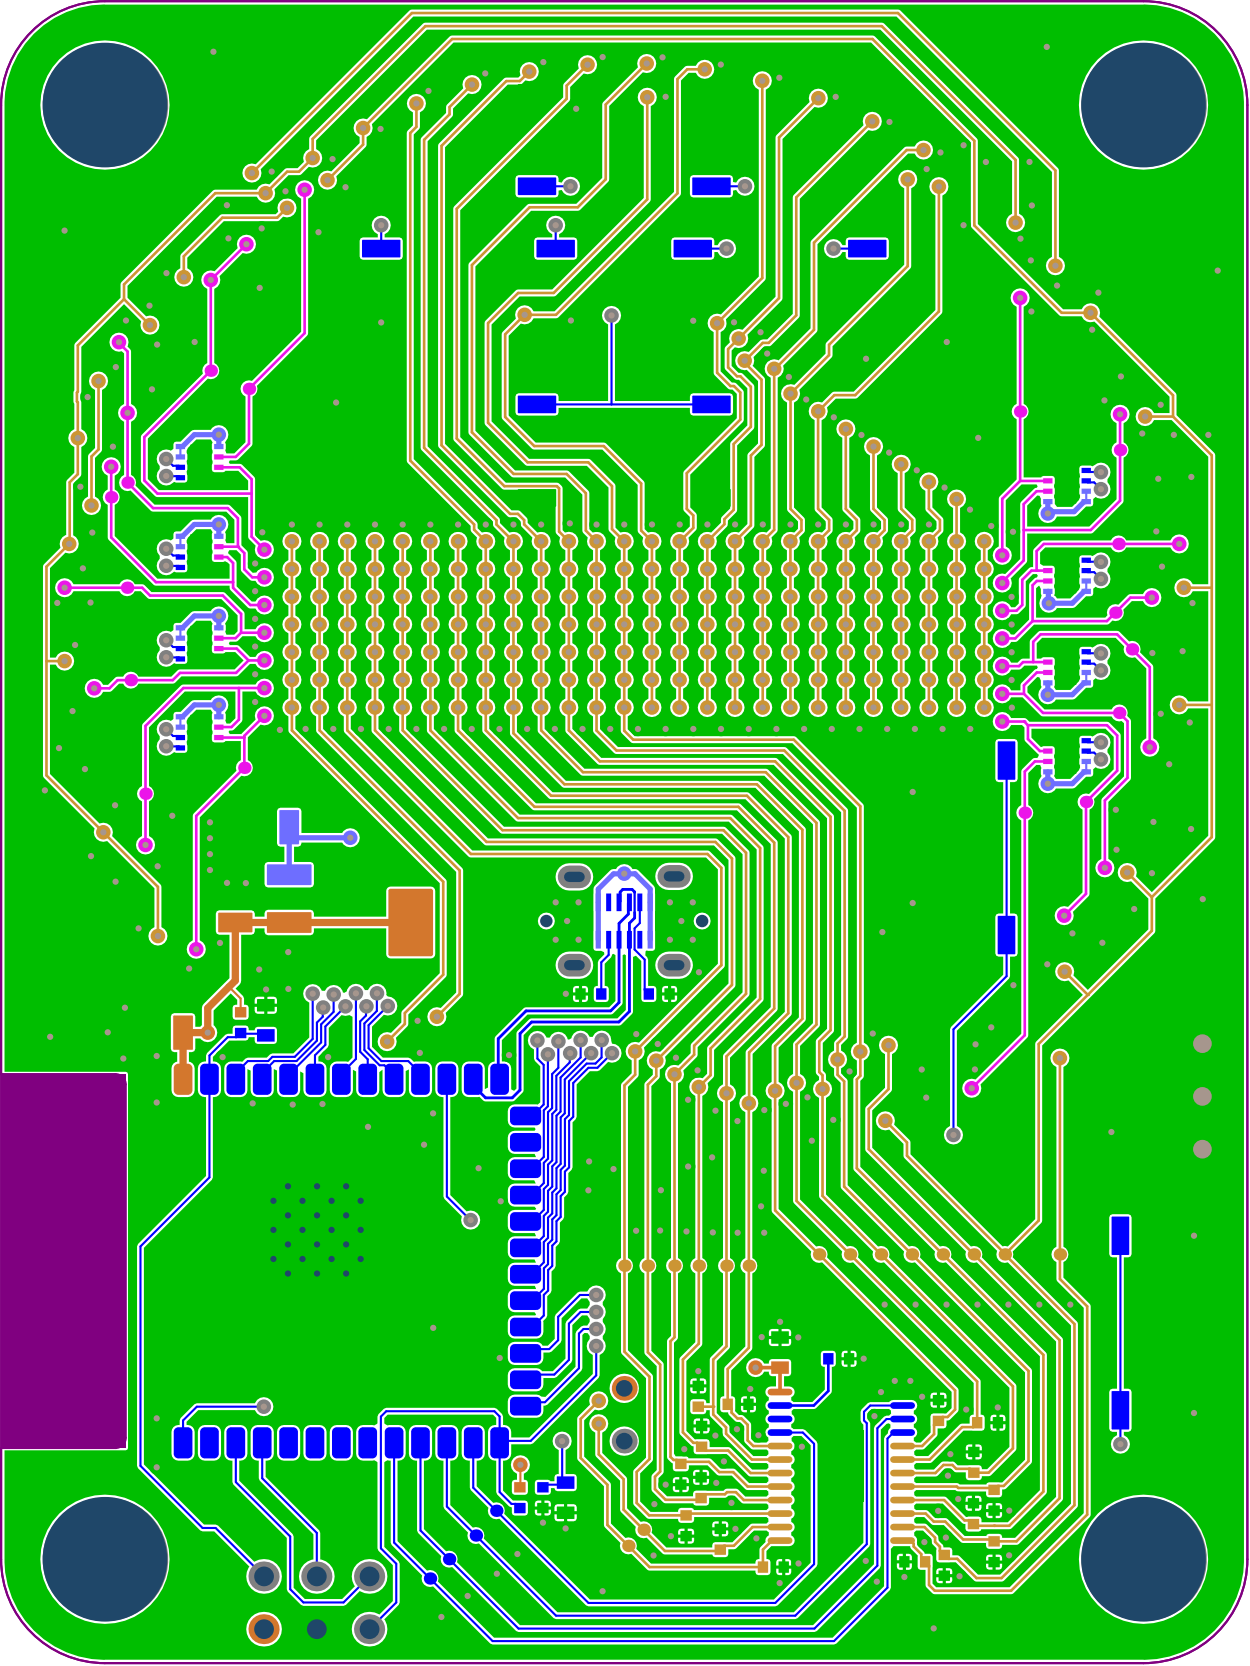
[picture p52: page 9]

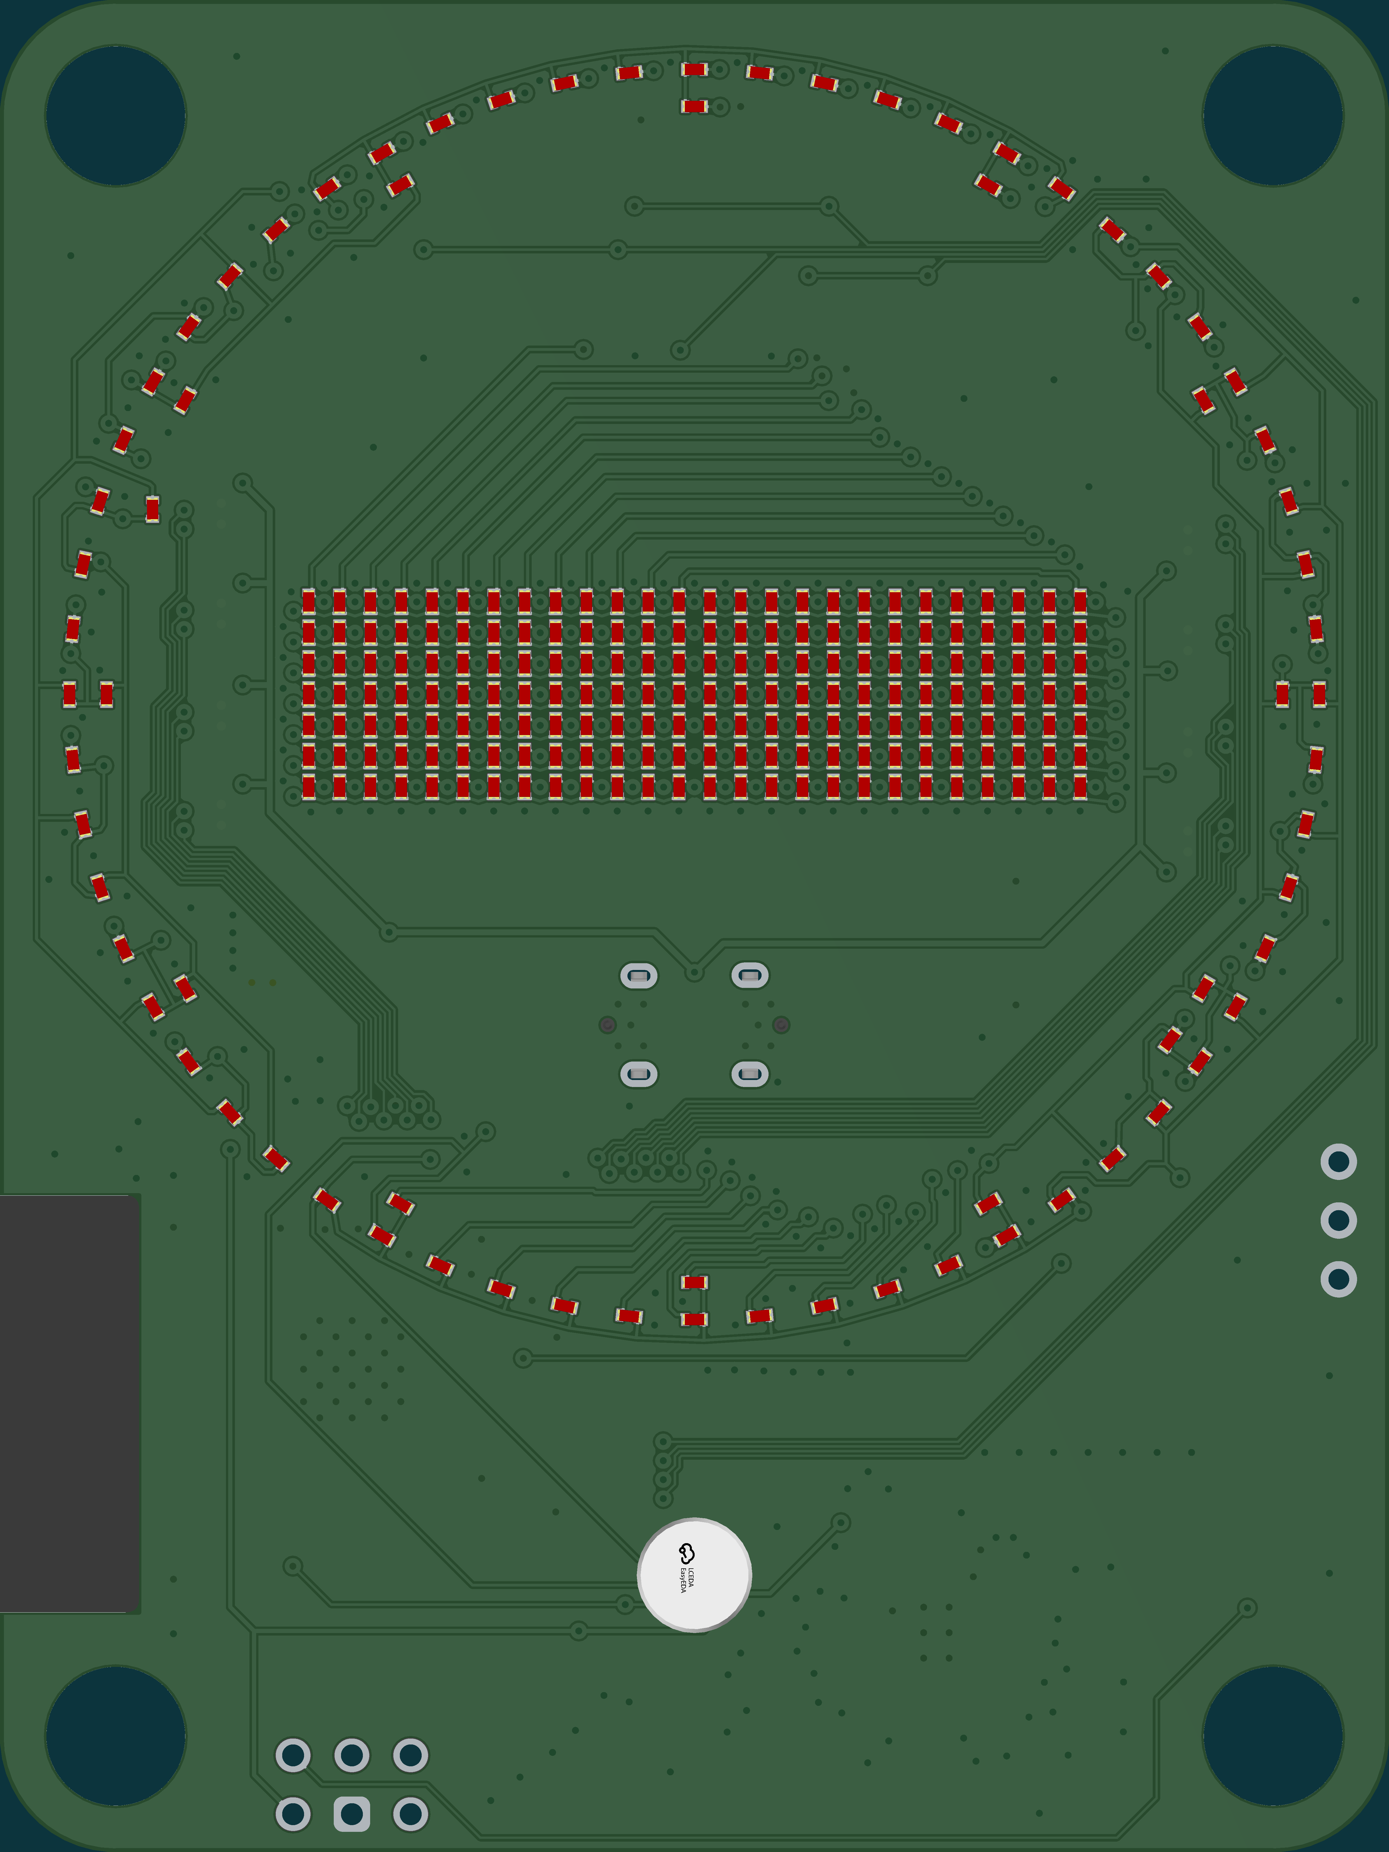
[picture p53: page 10]

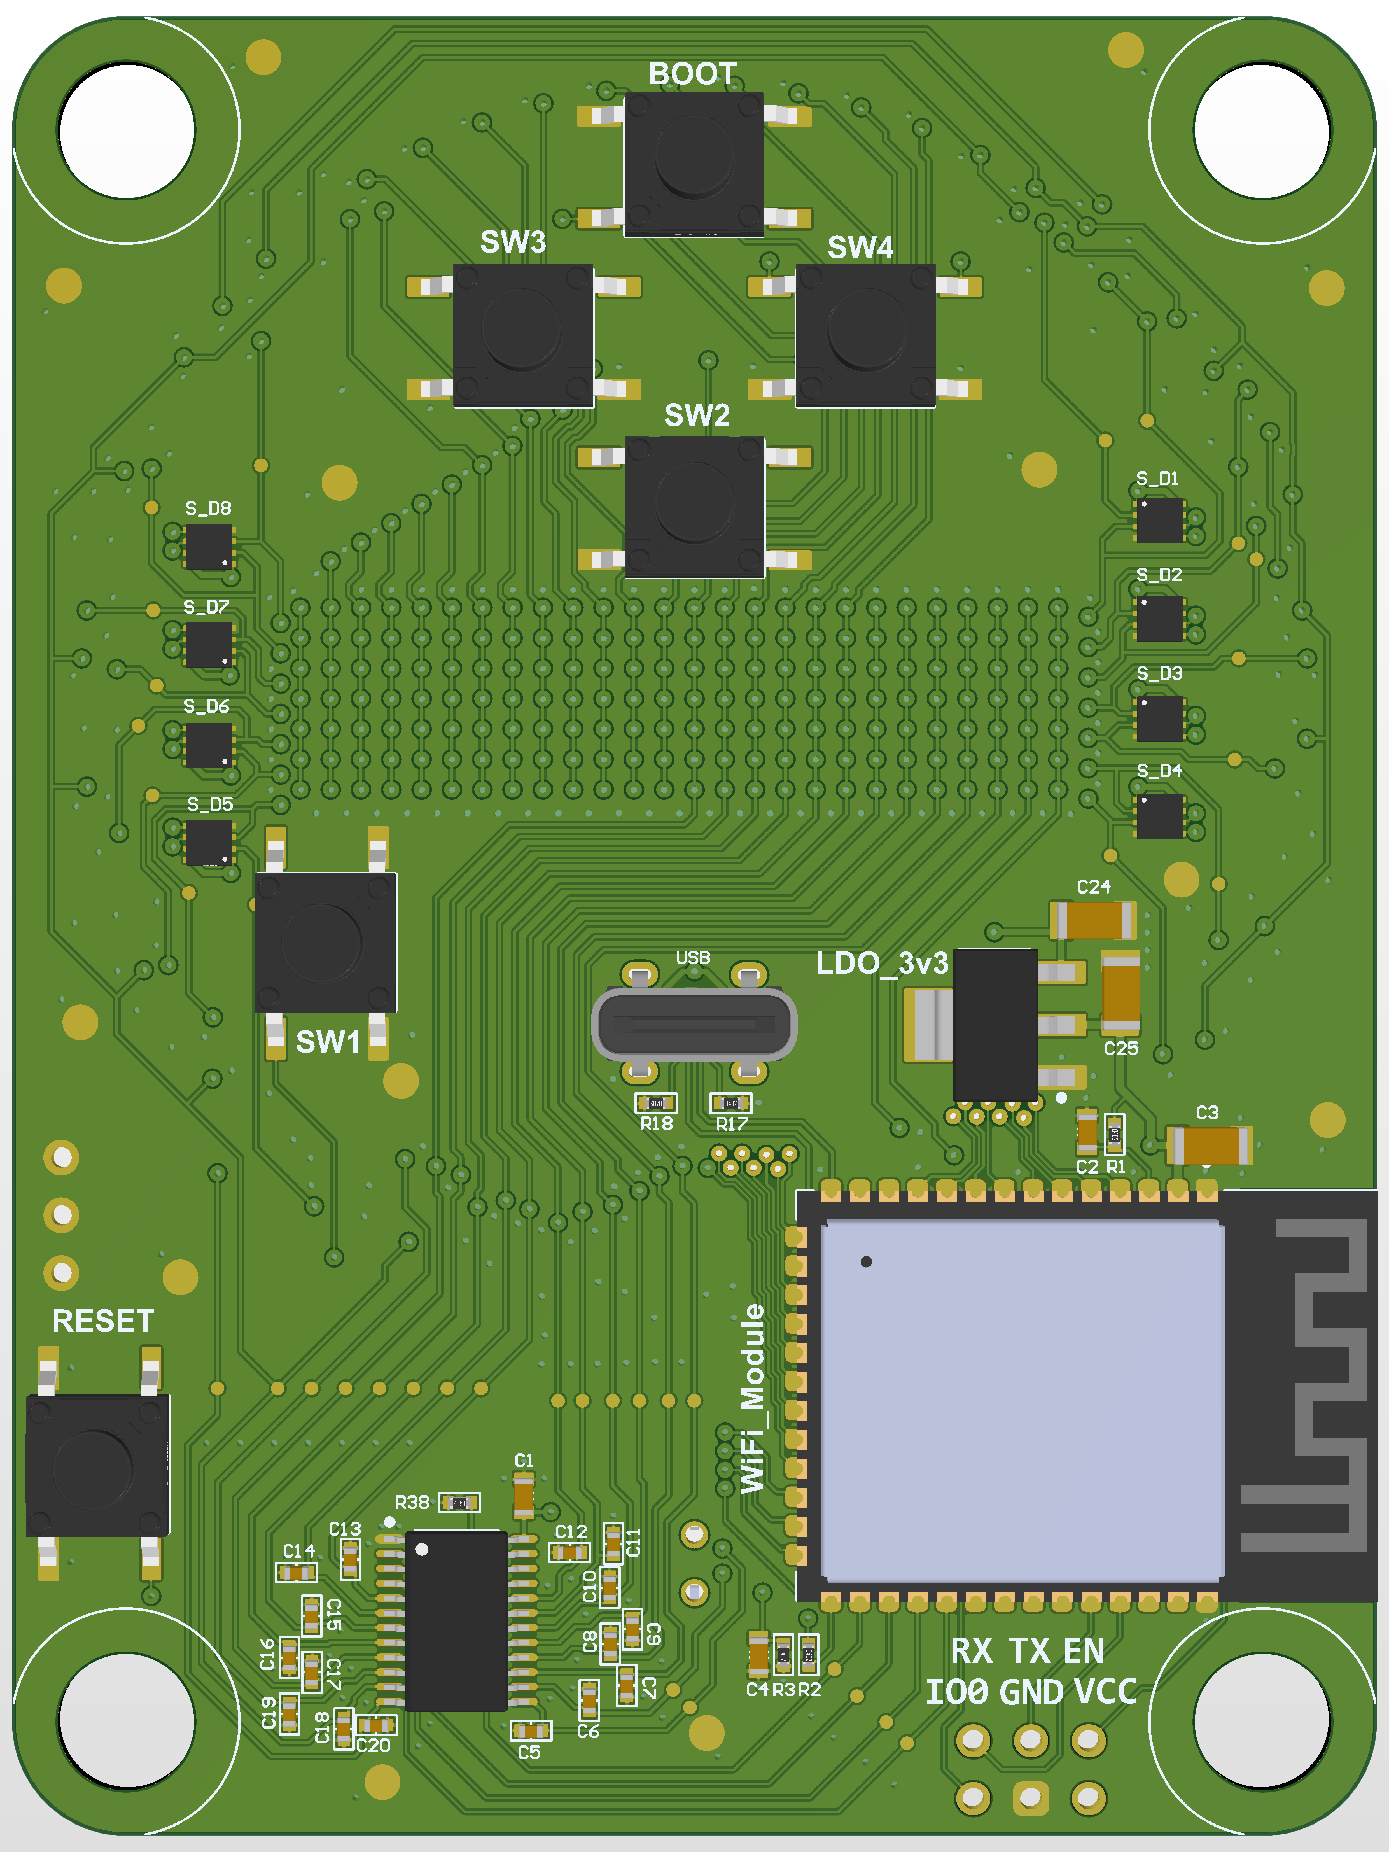
[picture p54: page 11]
