cskilbeck/clock_monsieur/pcb/Outputs/2025-11-04/clock_led.pdf

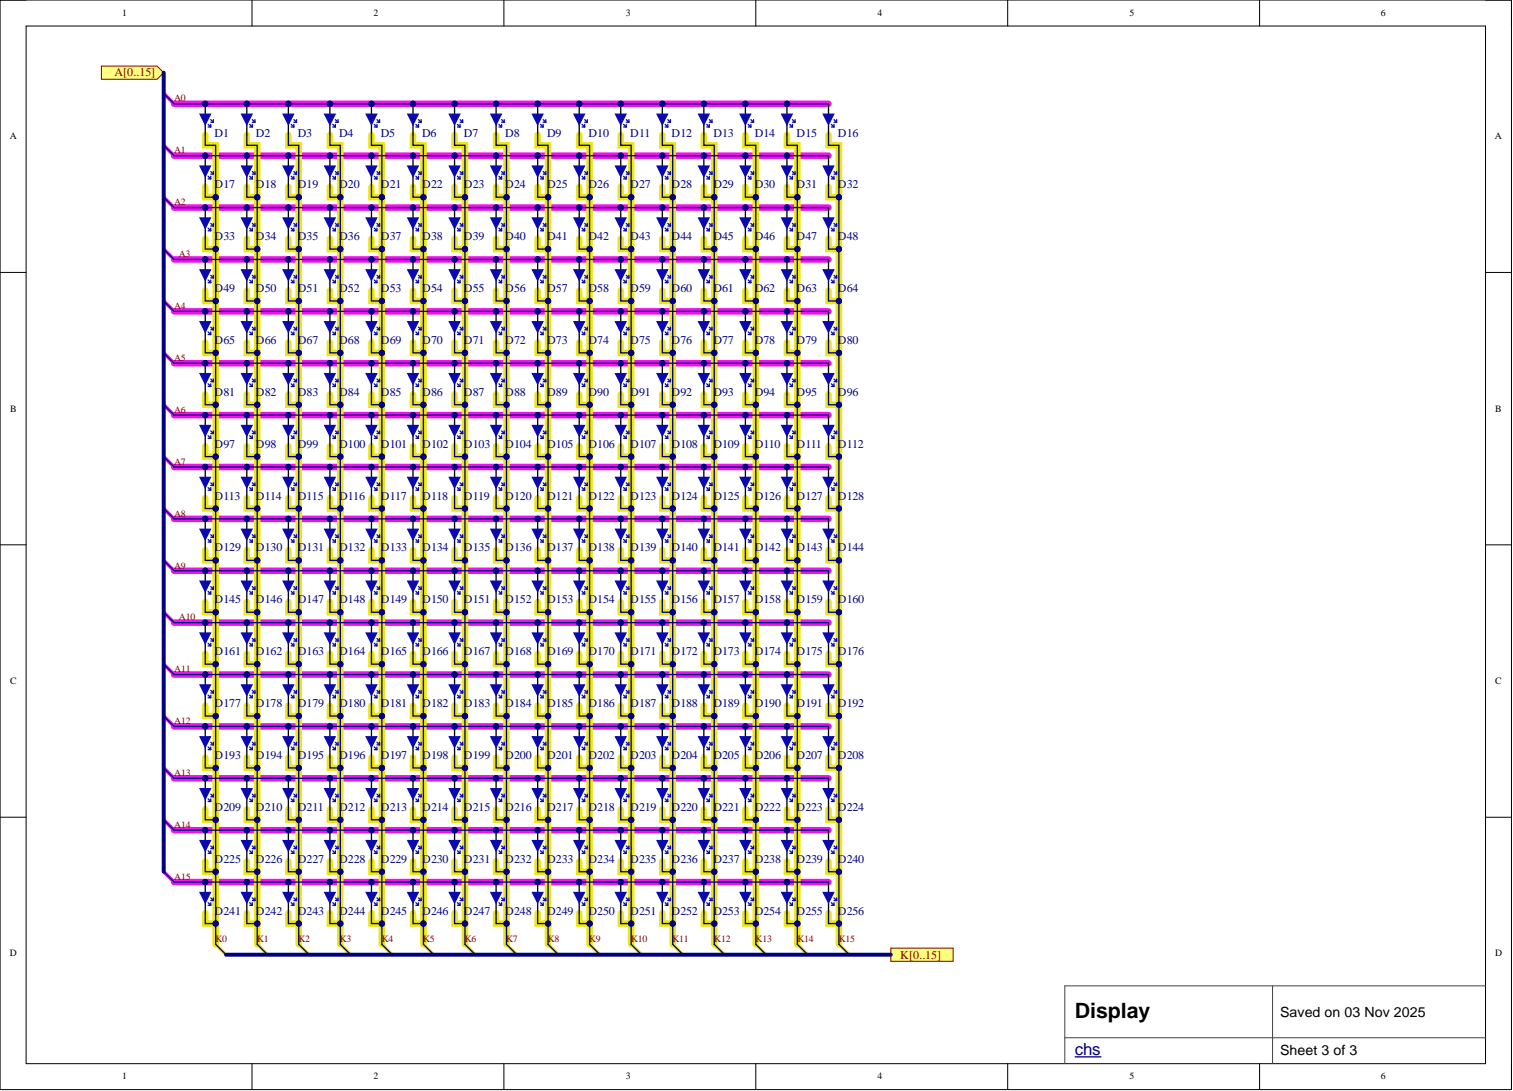
[picture p55: page 1]

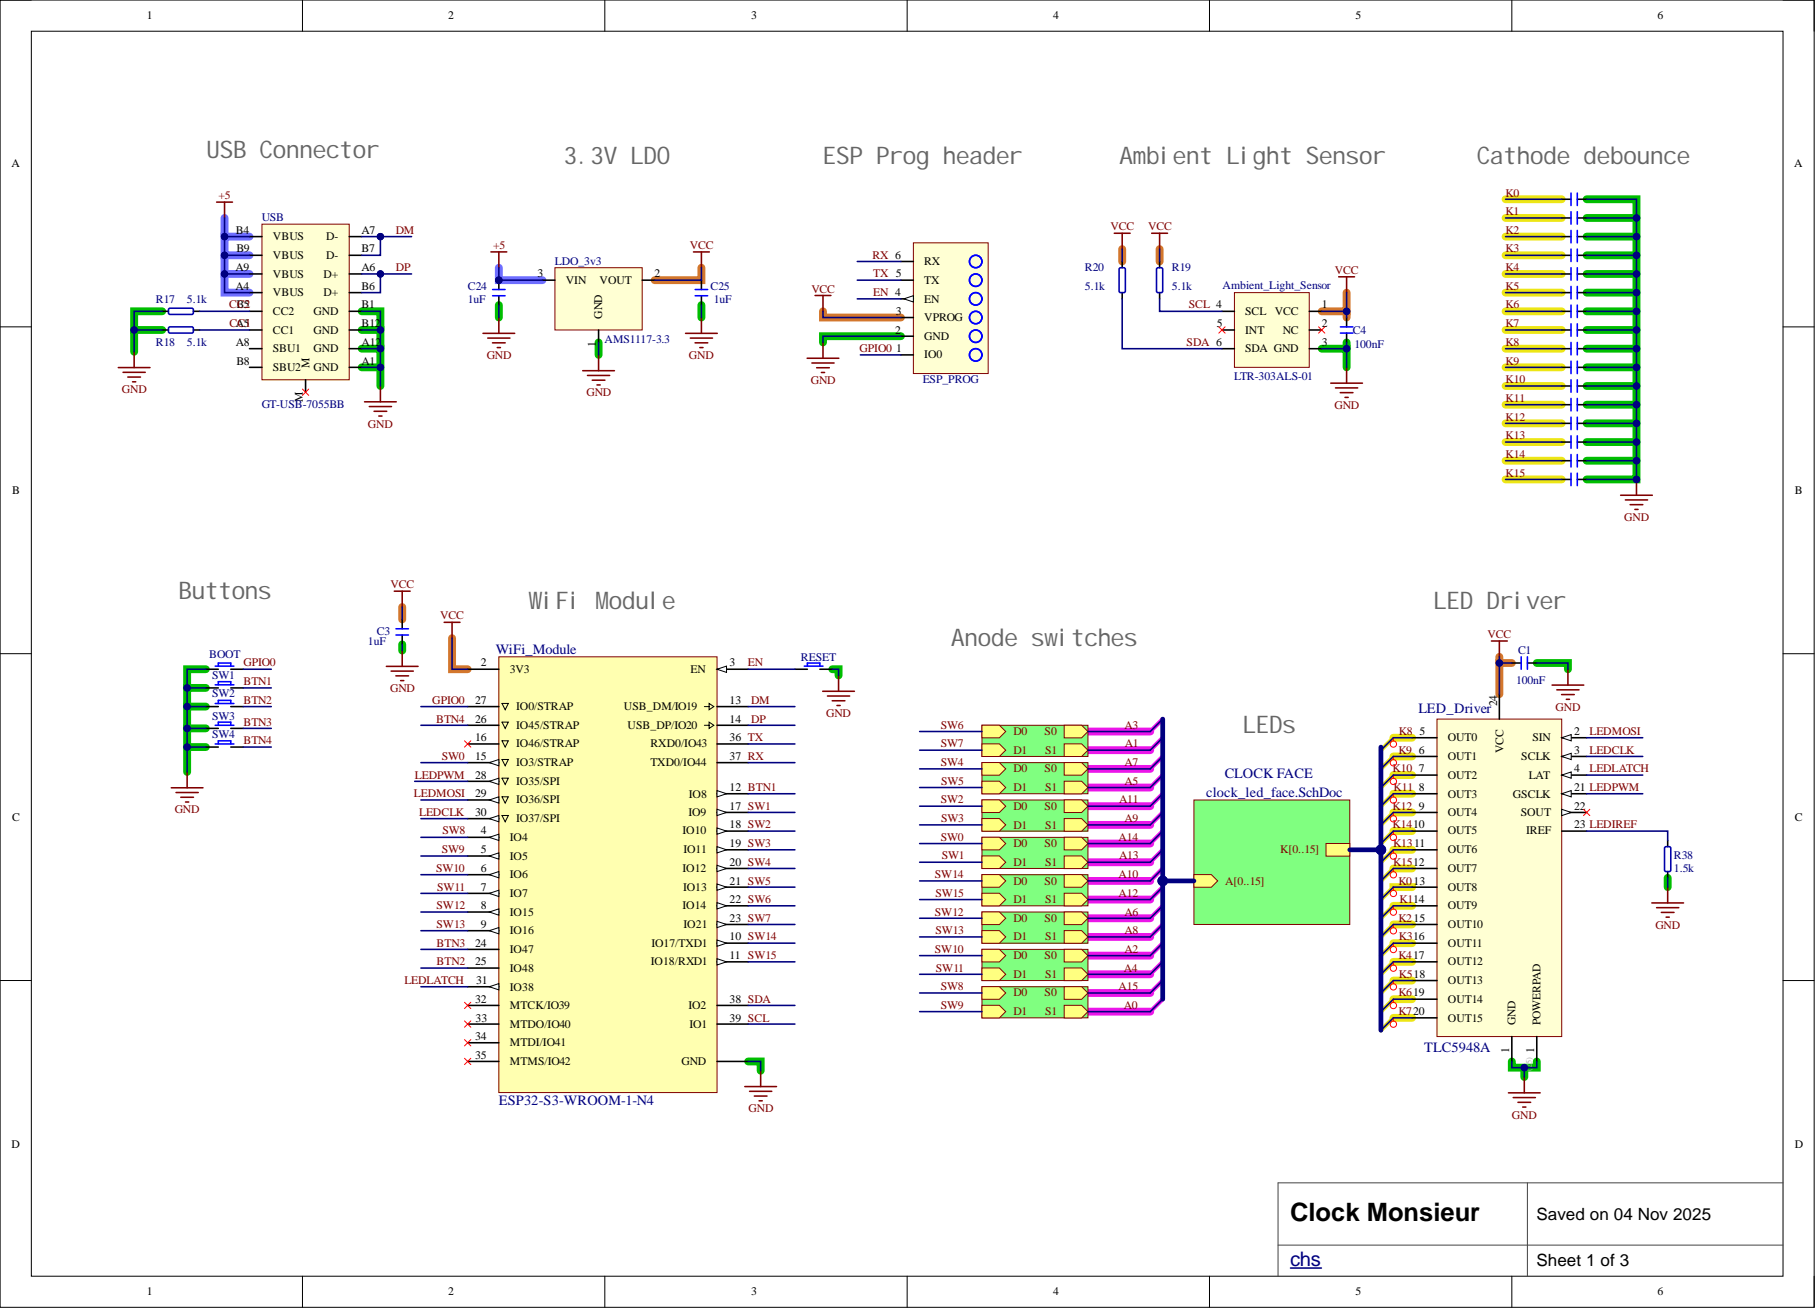
[picture p56: page 2]

A 9 | A 6
A4

Sheet 1 of 3 Saved on 04 Nov 2025

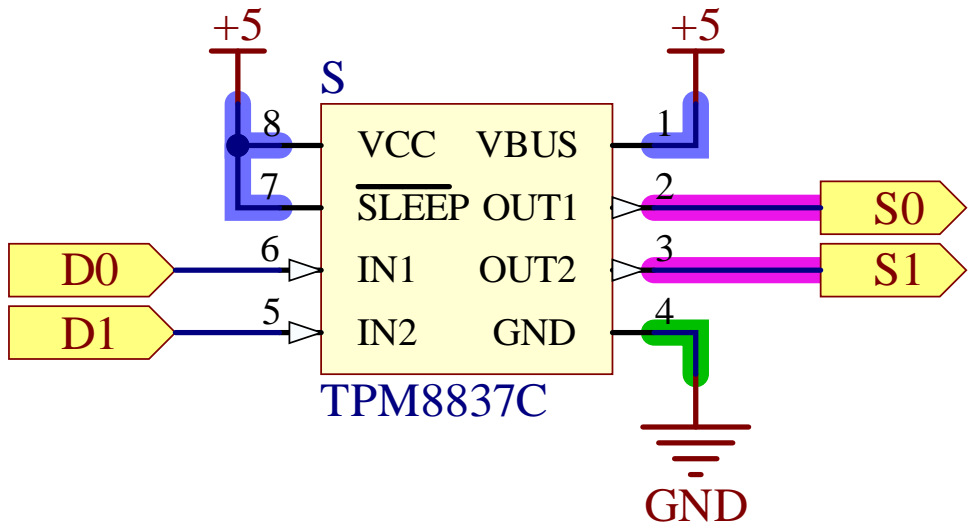
[picture p57: page 3]

Sheet 2 of 3 Saved on 03 Nov 2025

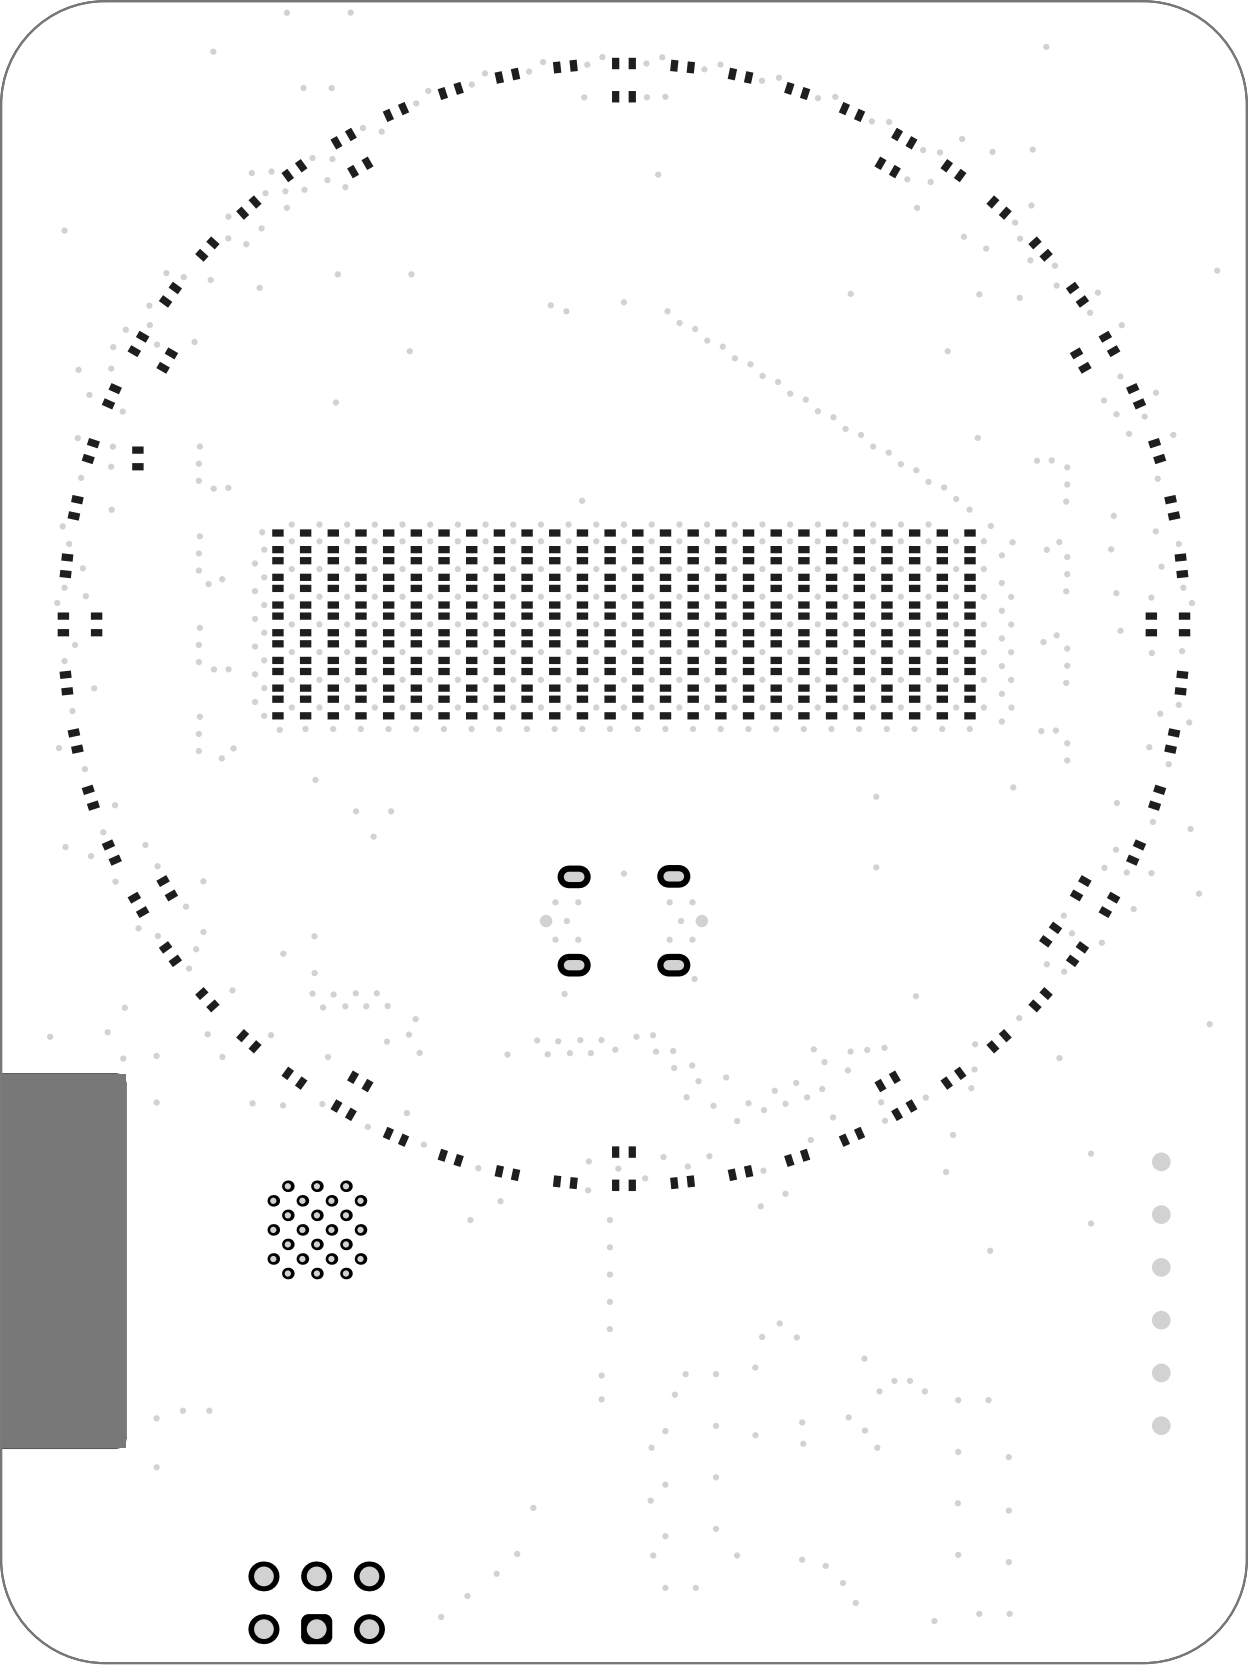
[picture p58: page 4]

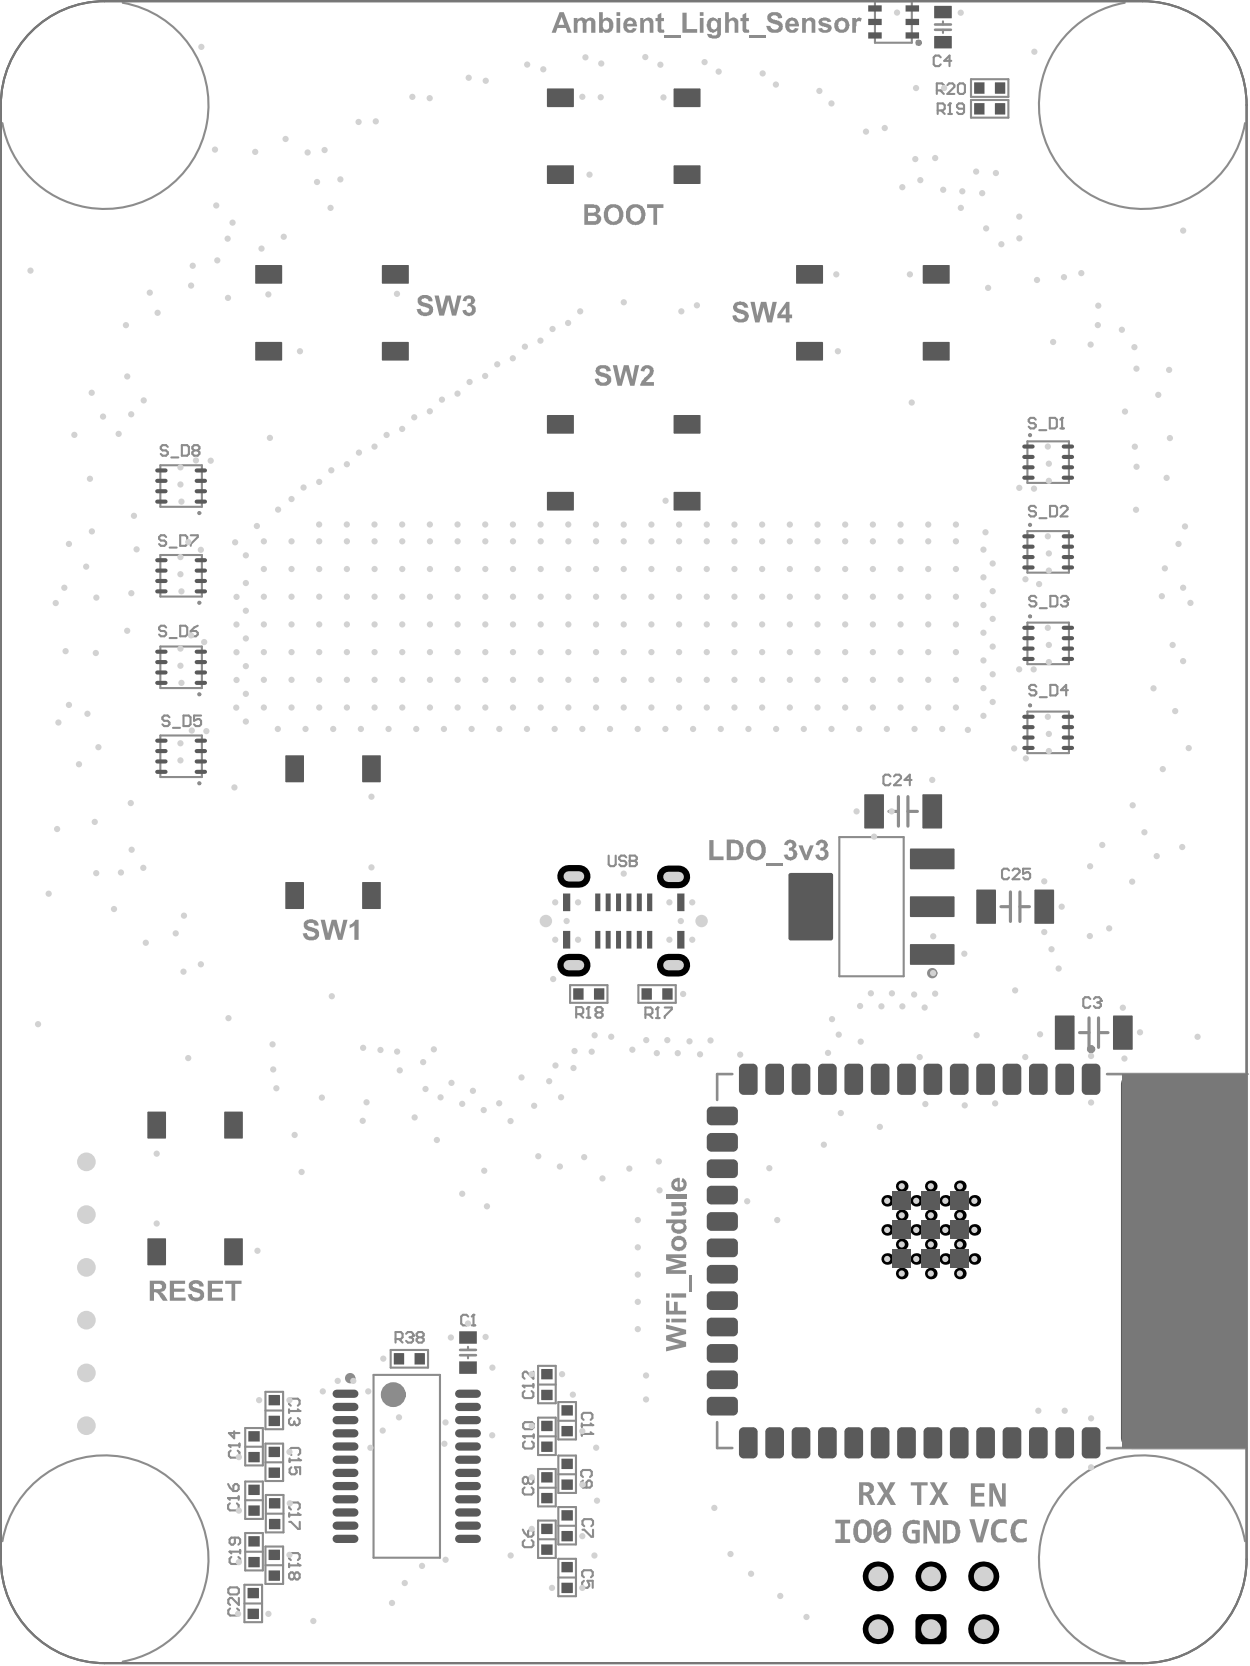
[picture p59: page 5]

### Electrical Rules Check Report

Class | Document | Message Successful Compile for clock_led.PrjPcb
Tuesday 4 Nov 2025 9:28:34 AM | Page 1 of 1

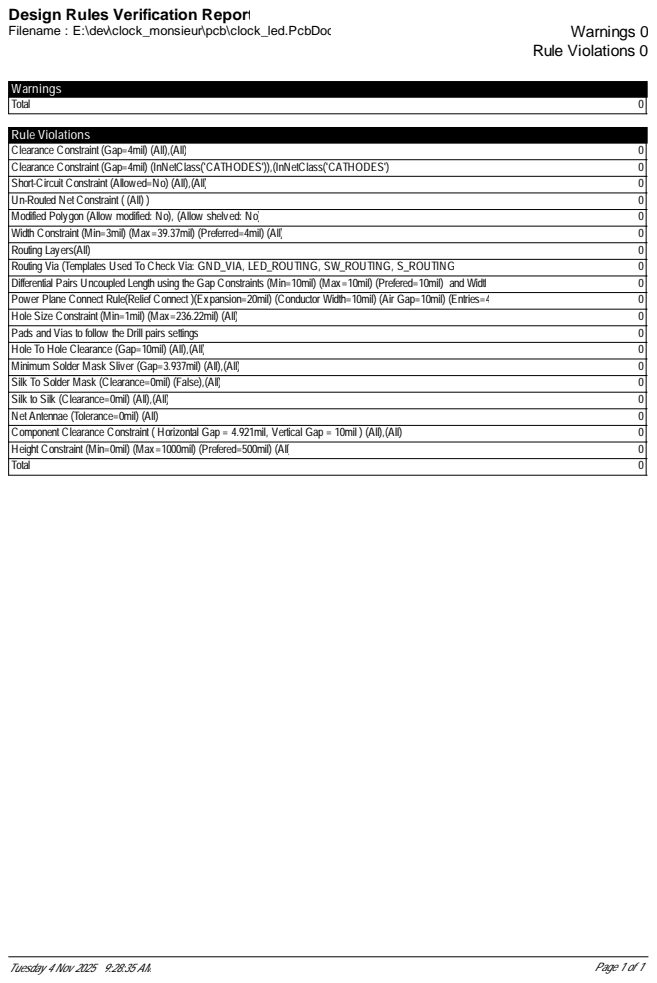
[picture p60: page 7]

Design Rules Verification Report

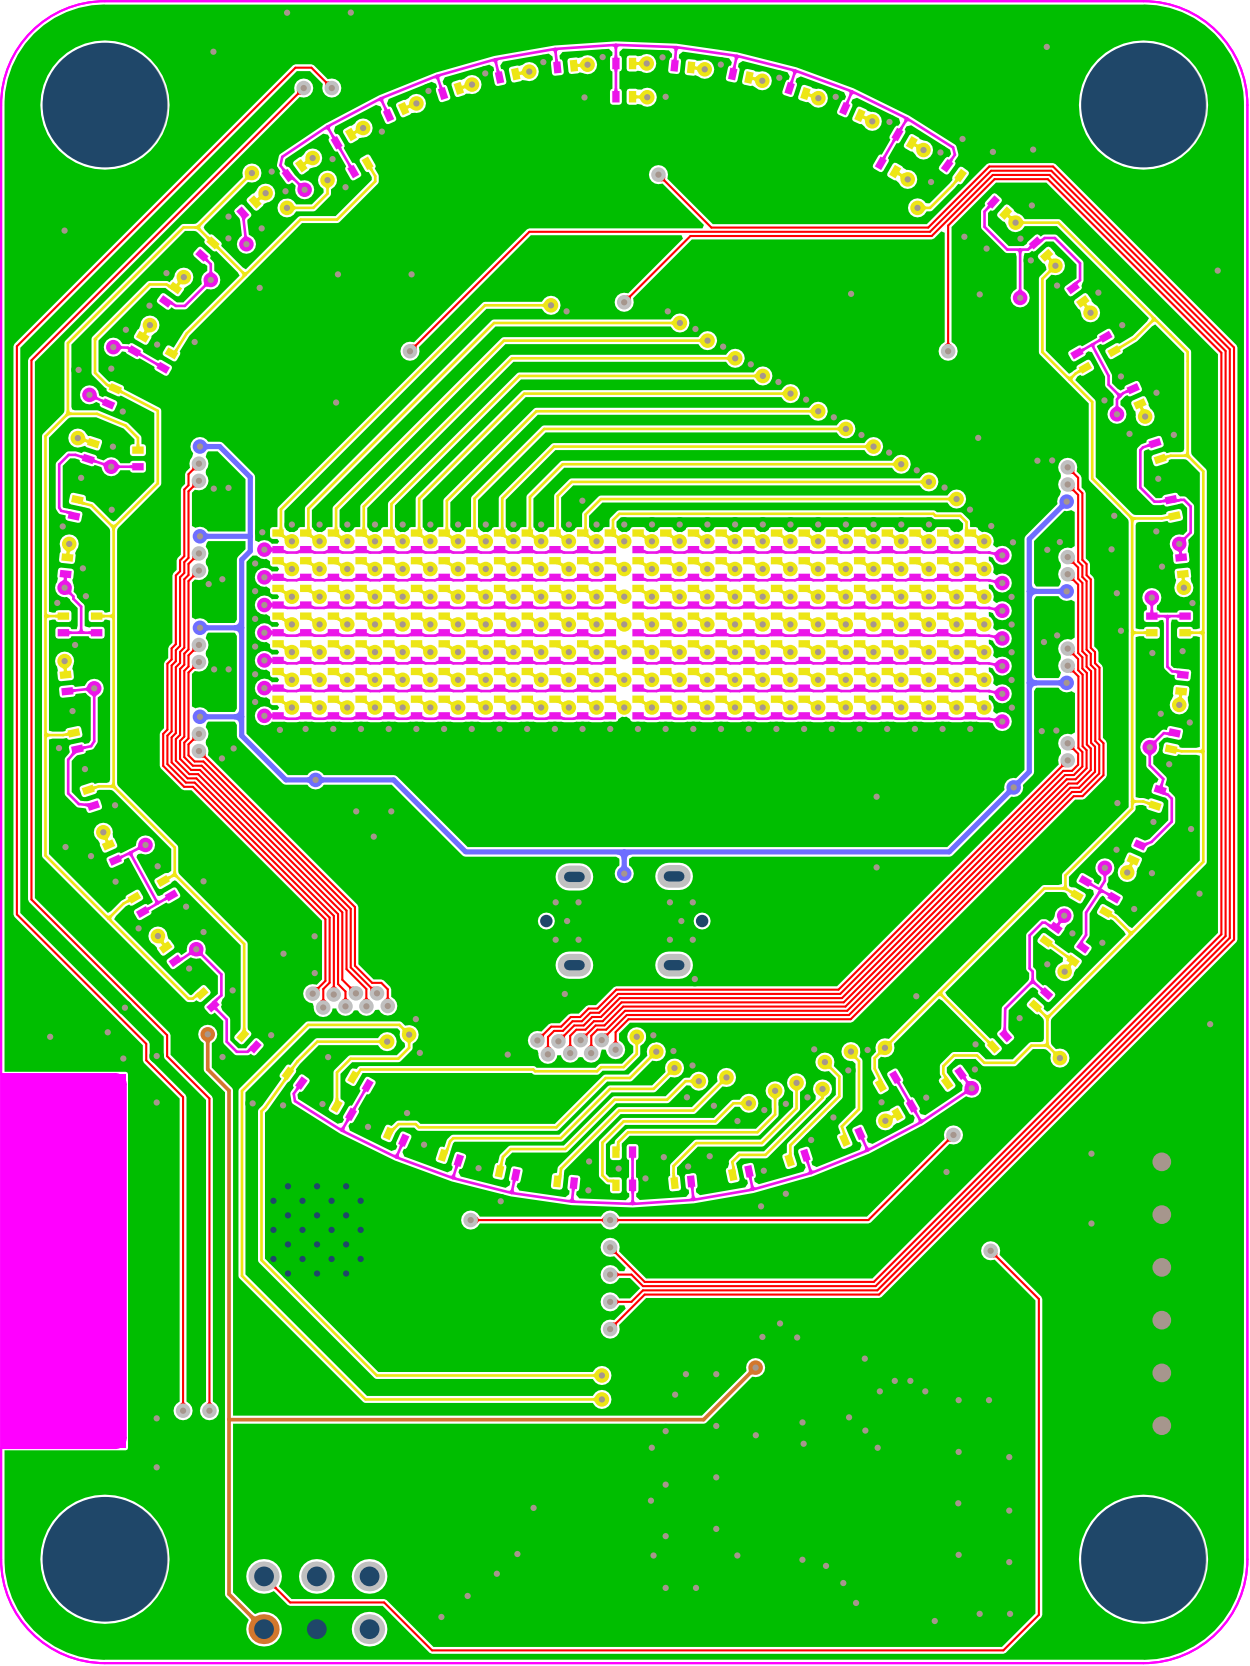
[picture p61: page 8]

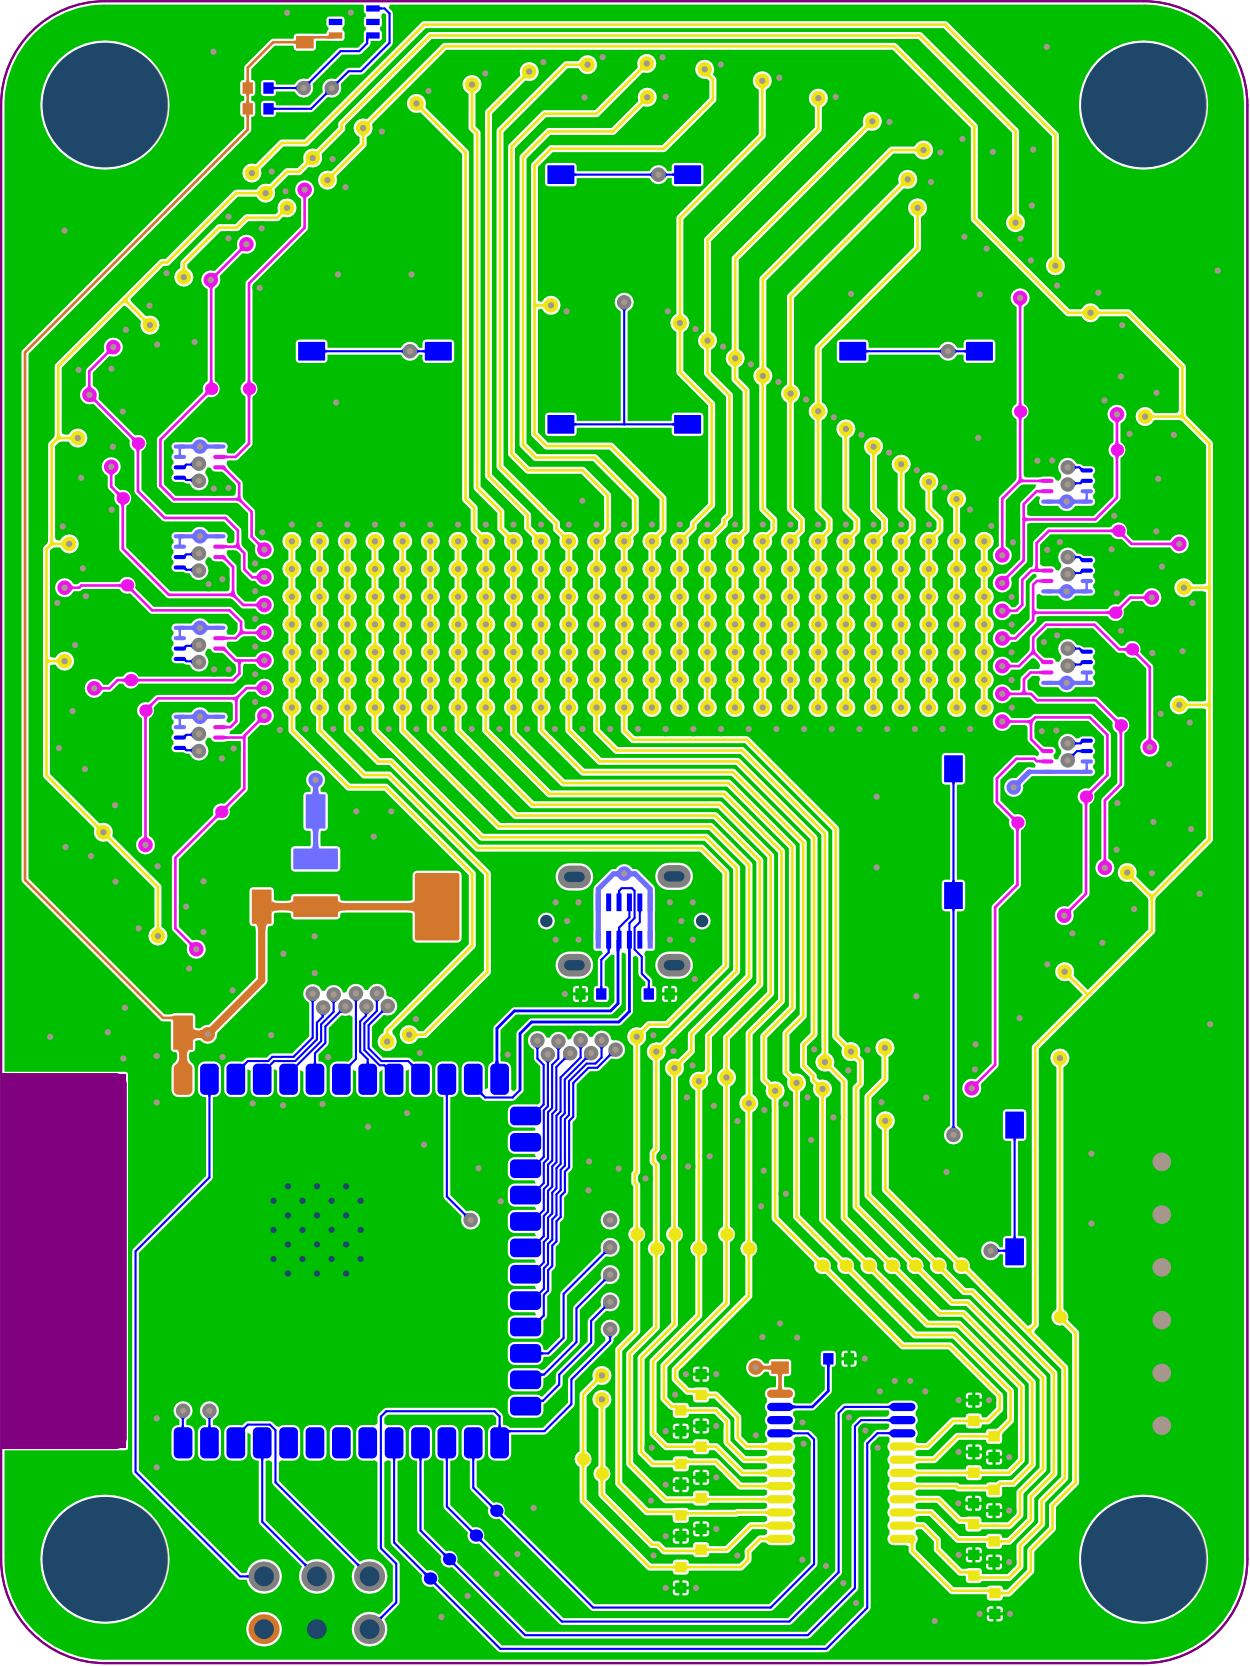
[picture p62: page 9]

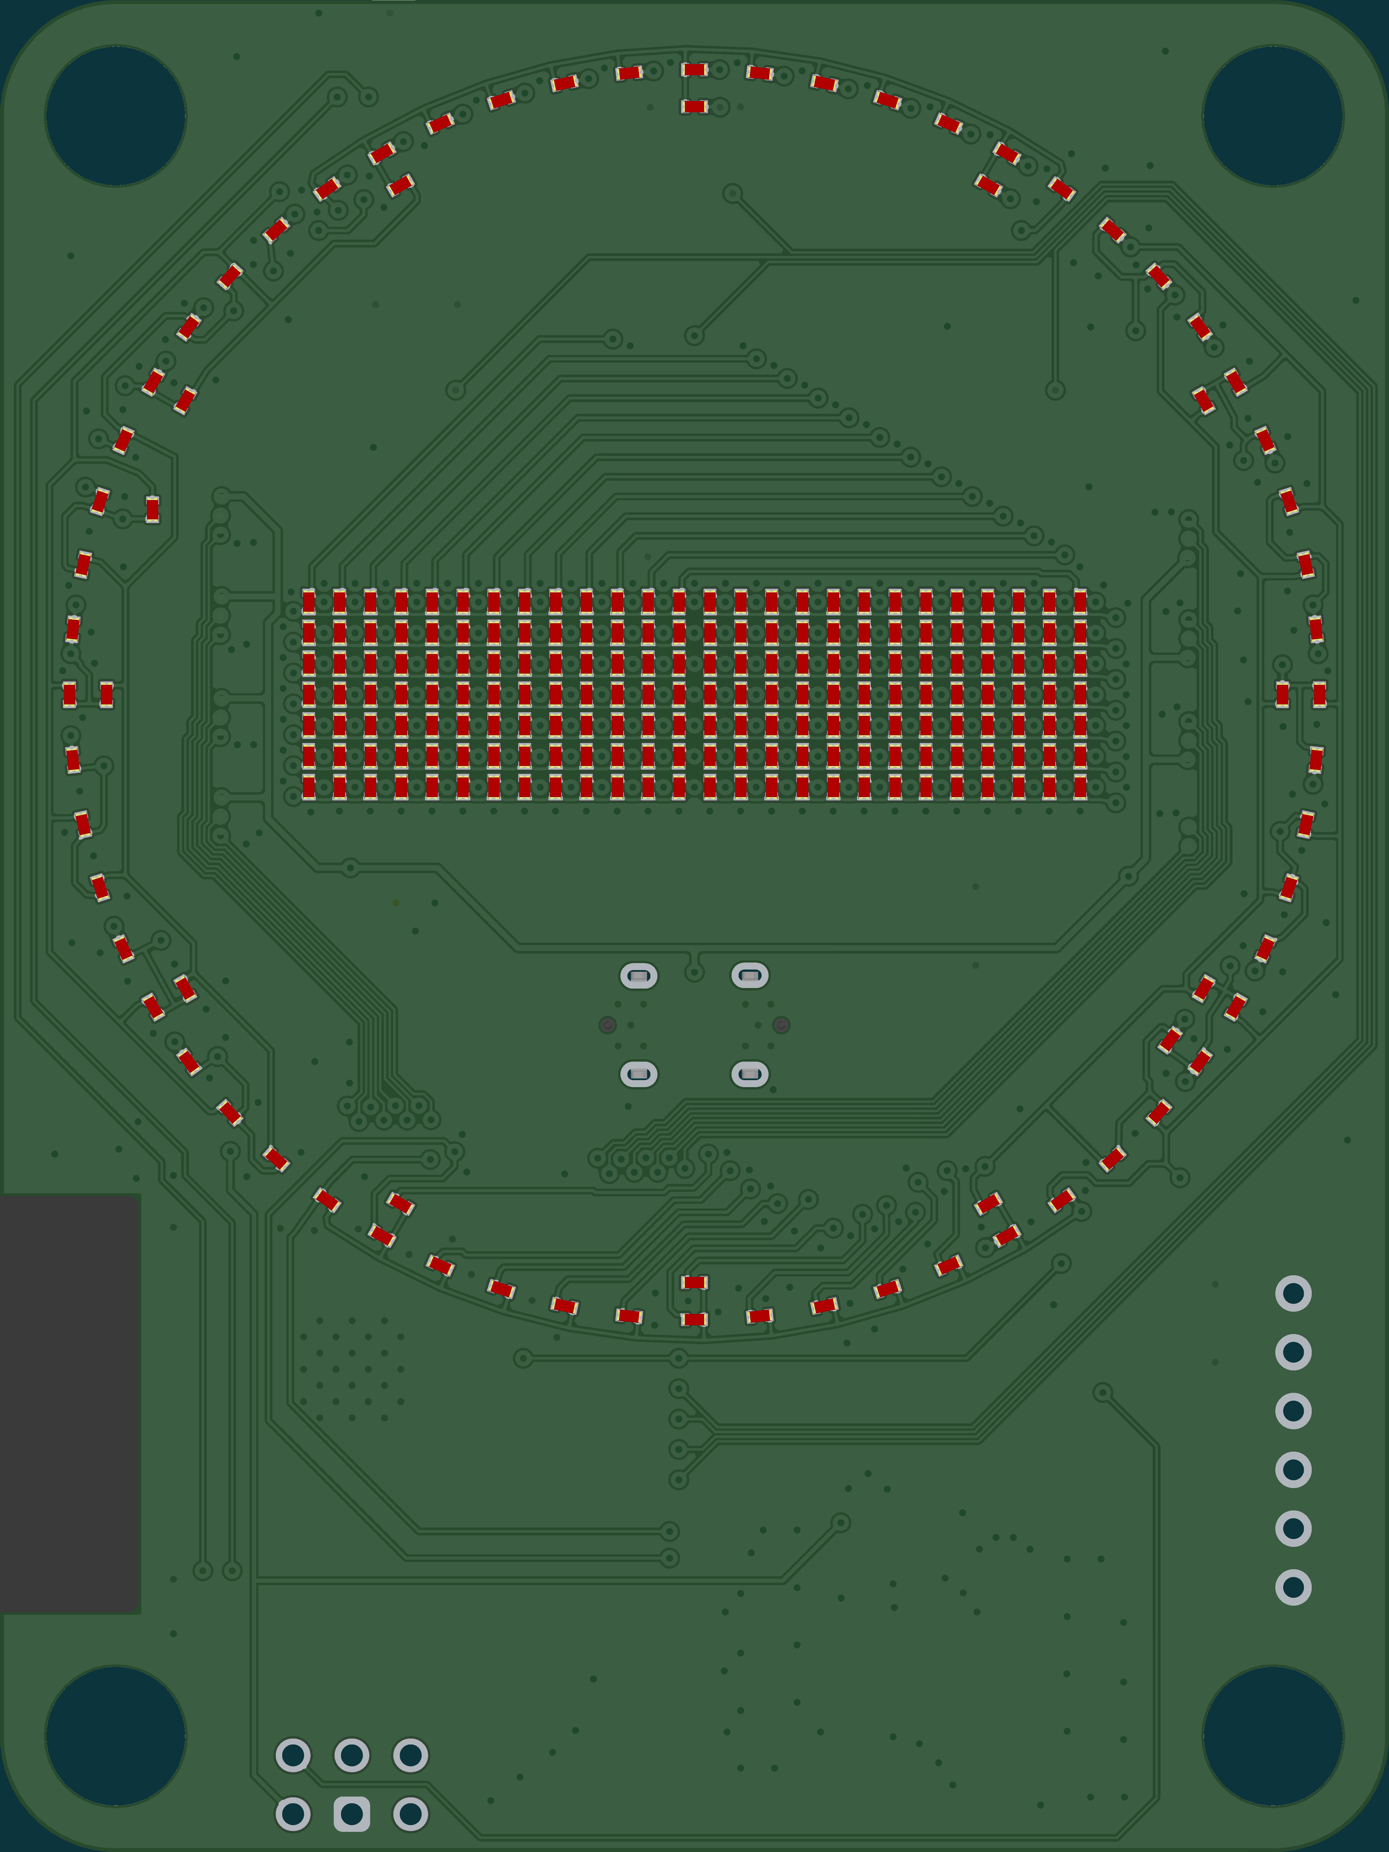
[picture p63: page 10]

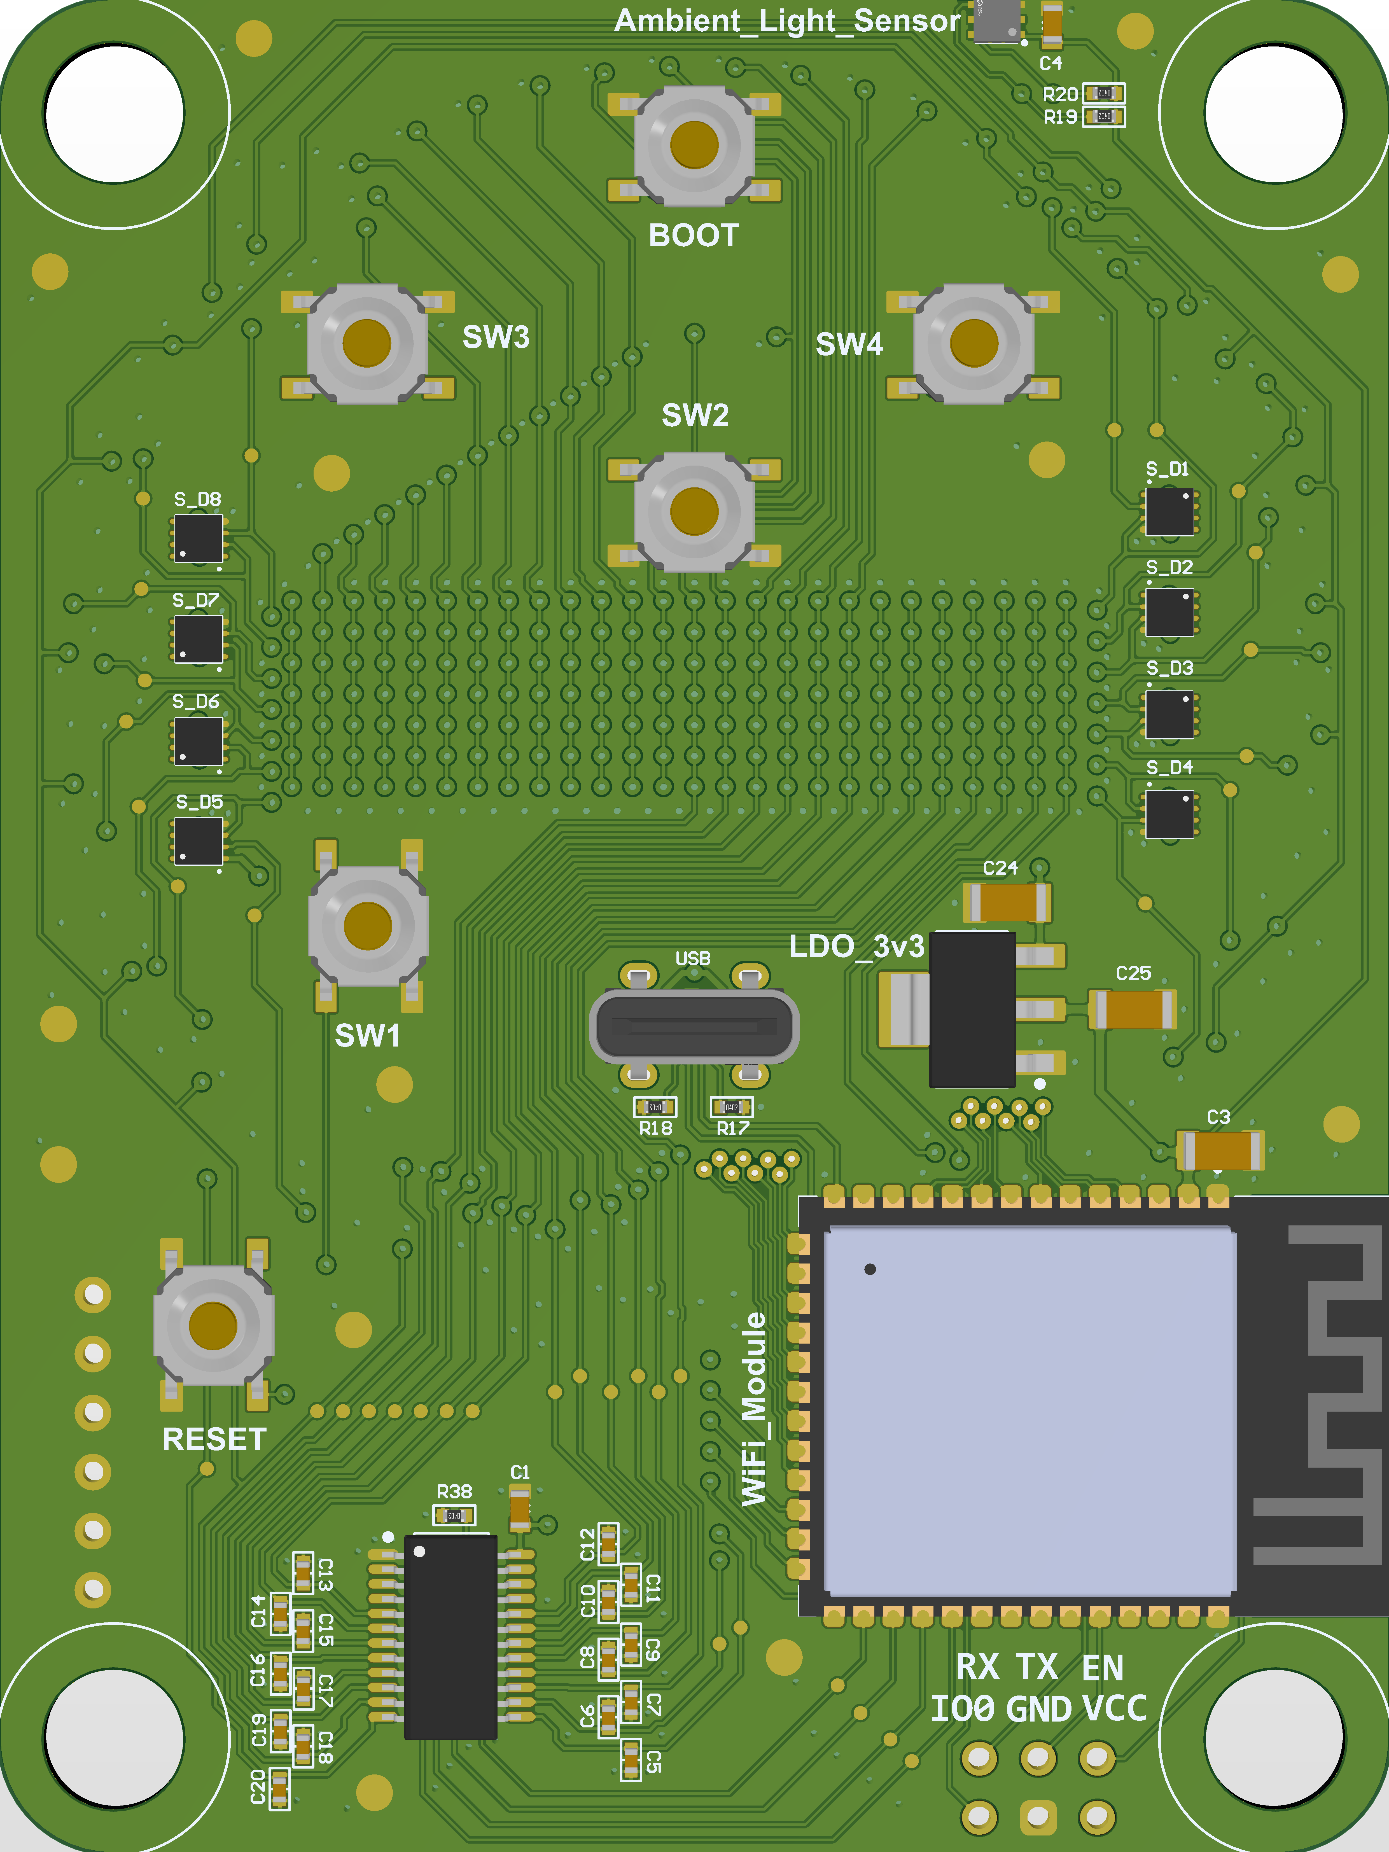
[picture p64: page 11]
