cskilbeck/clock_monsieur/pcb/Outputs/2025-11-01/clock_led.pdf

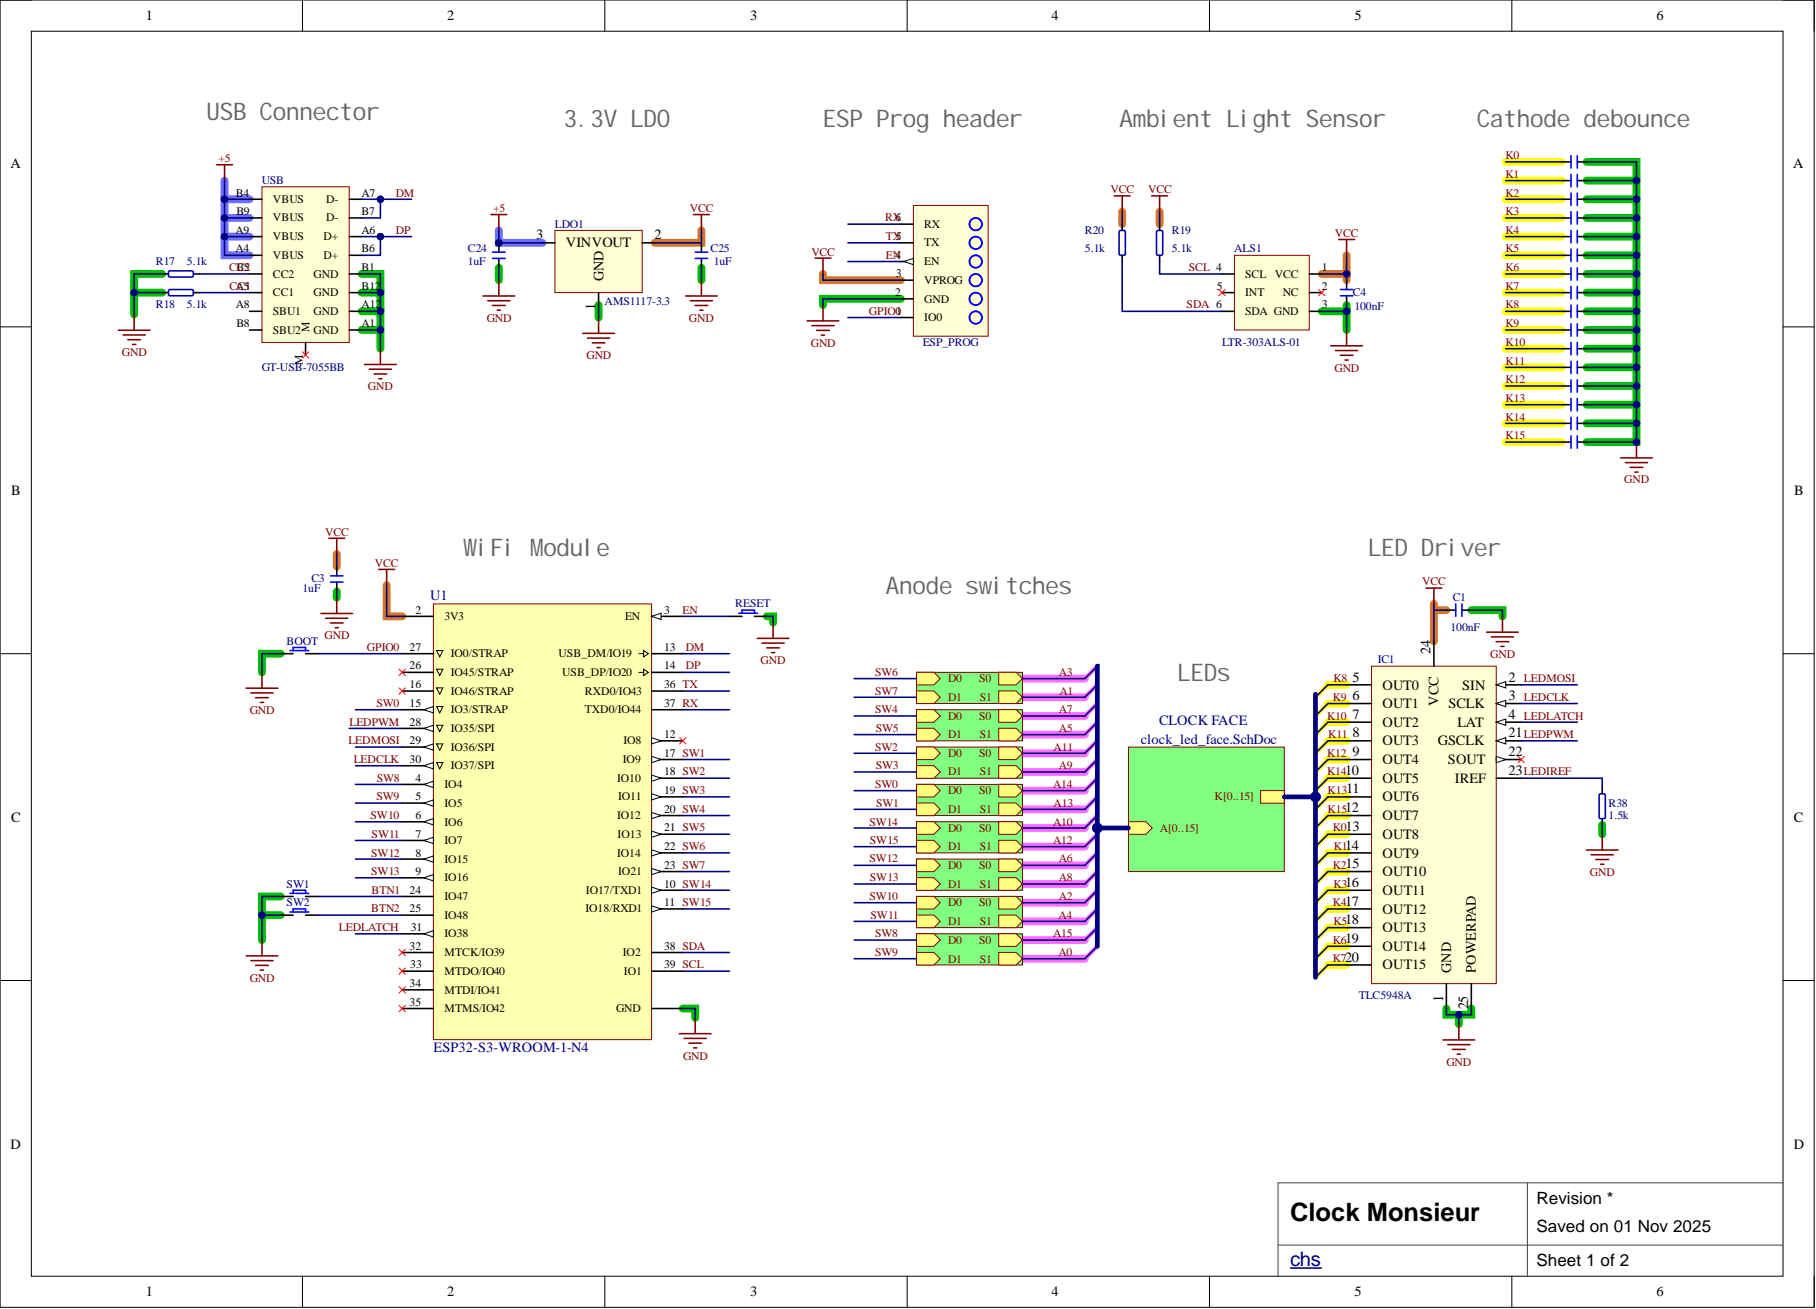
[picture p65: page 1]

A 9 | A 6
A4

Revision *
Sheet 1 of 2 Saved on 01 Nov 2025

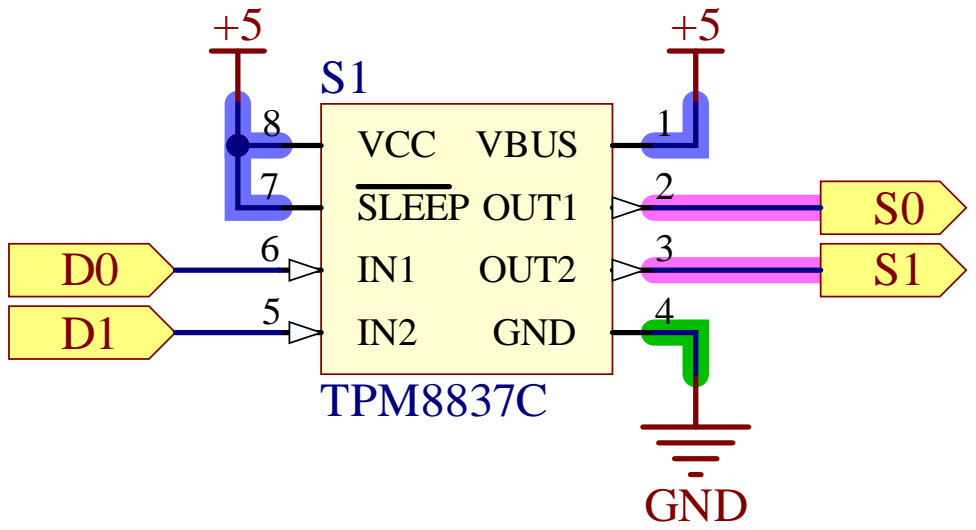
[picture p66: page 2]

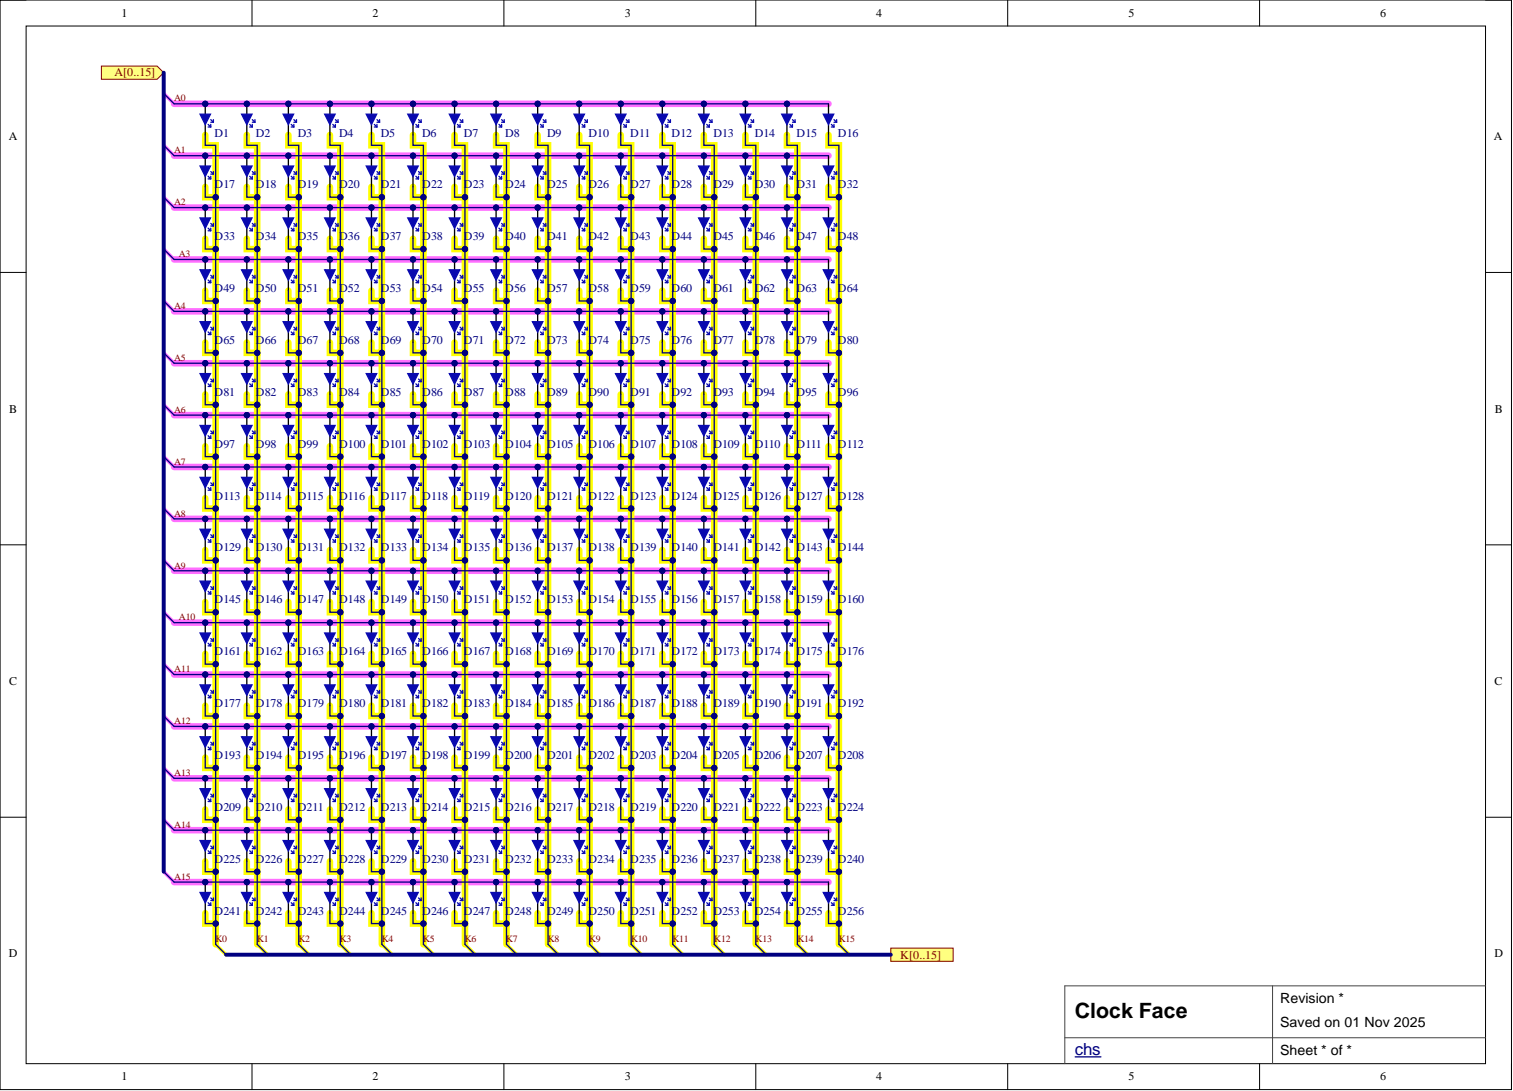
[picture p67: page 3]

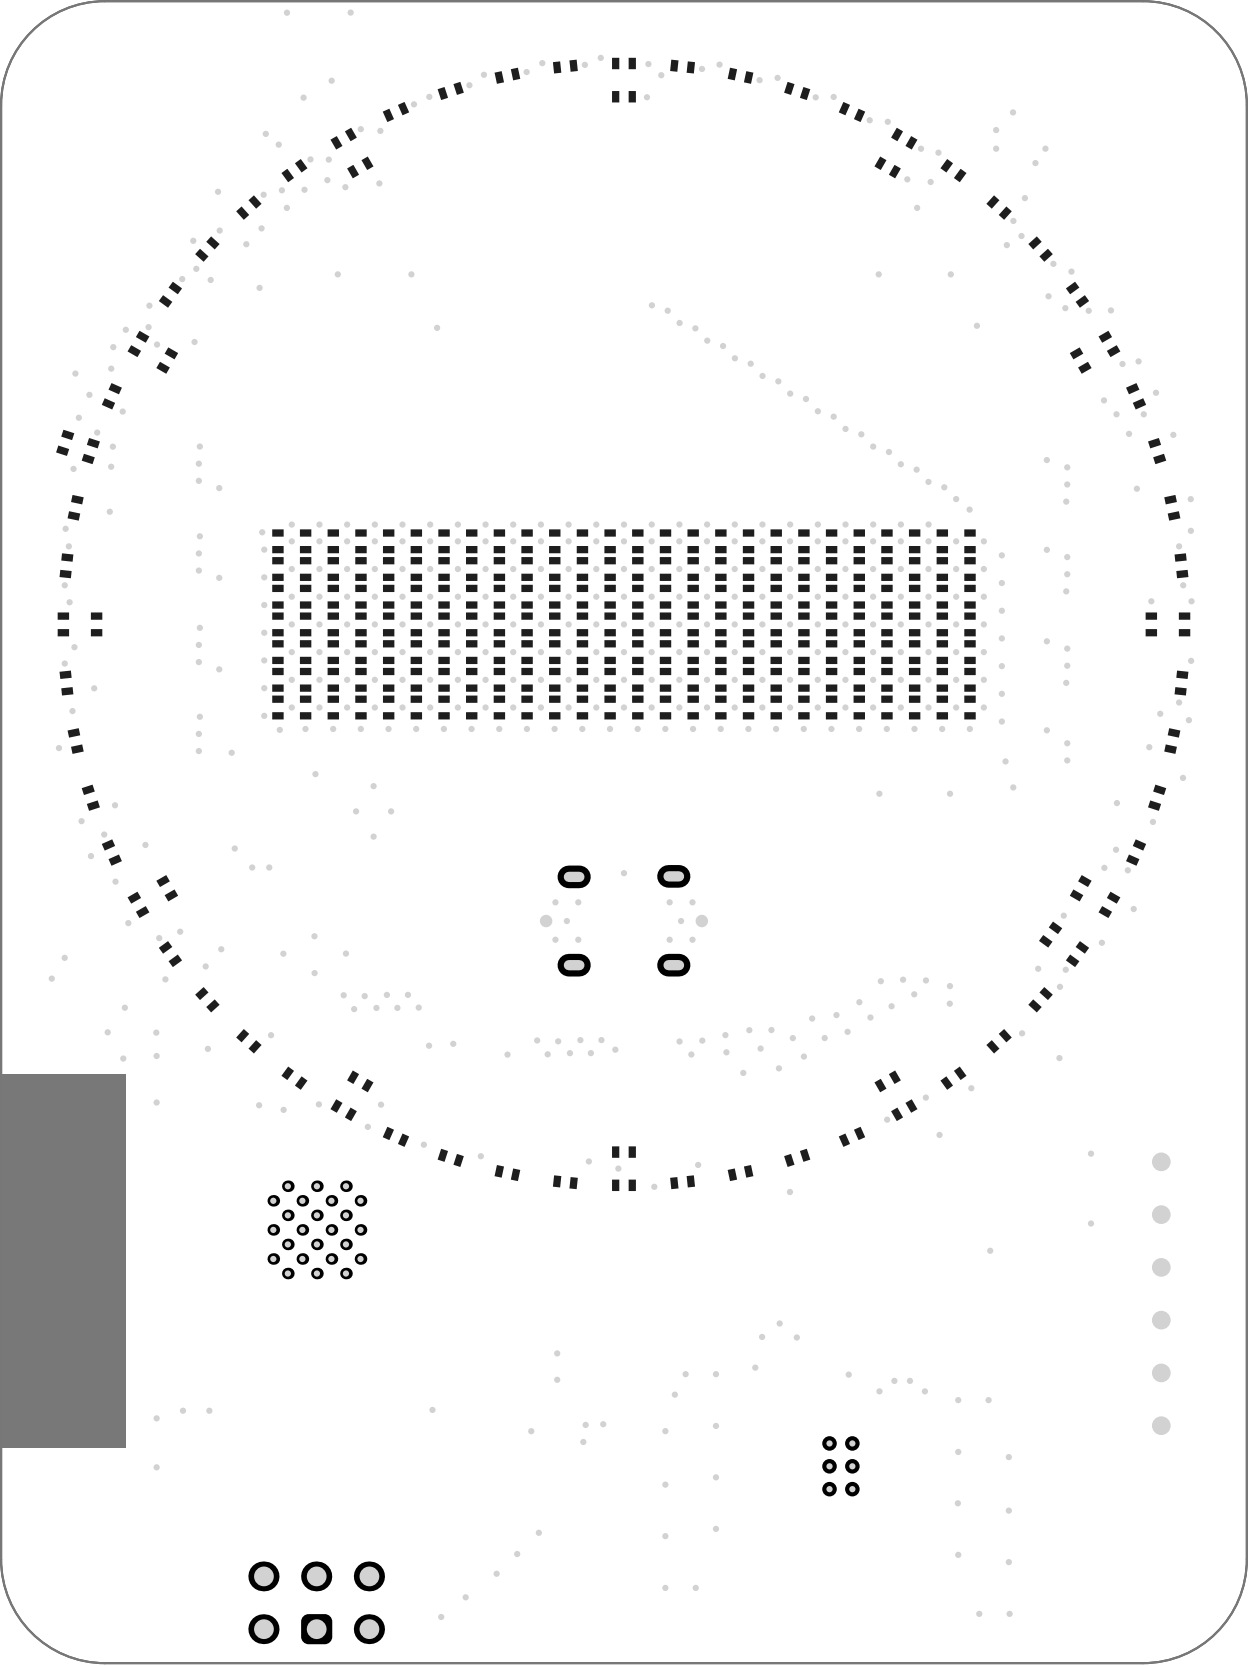
[picture p68: page 4]

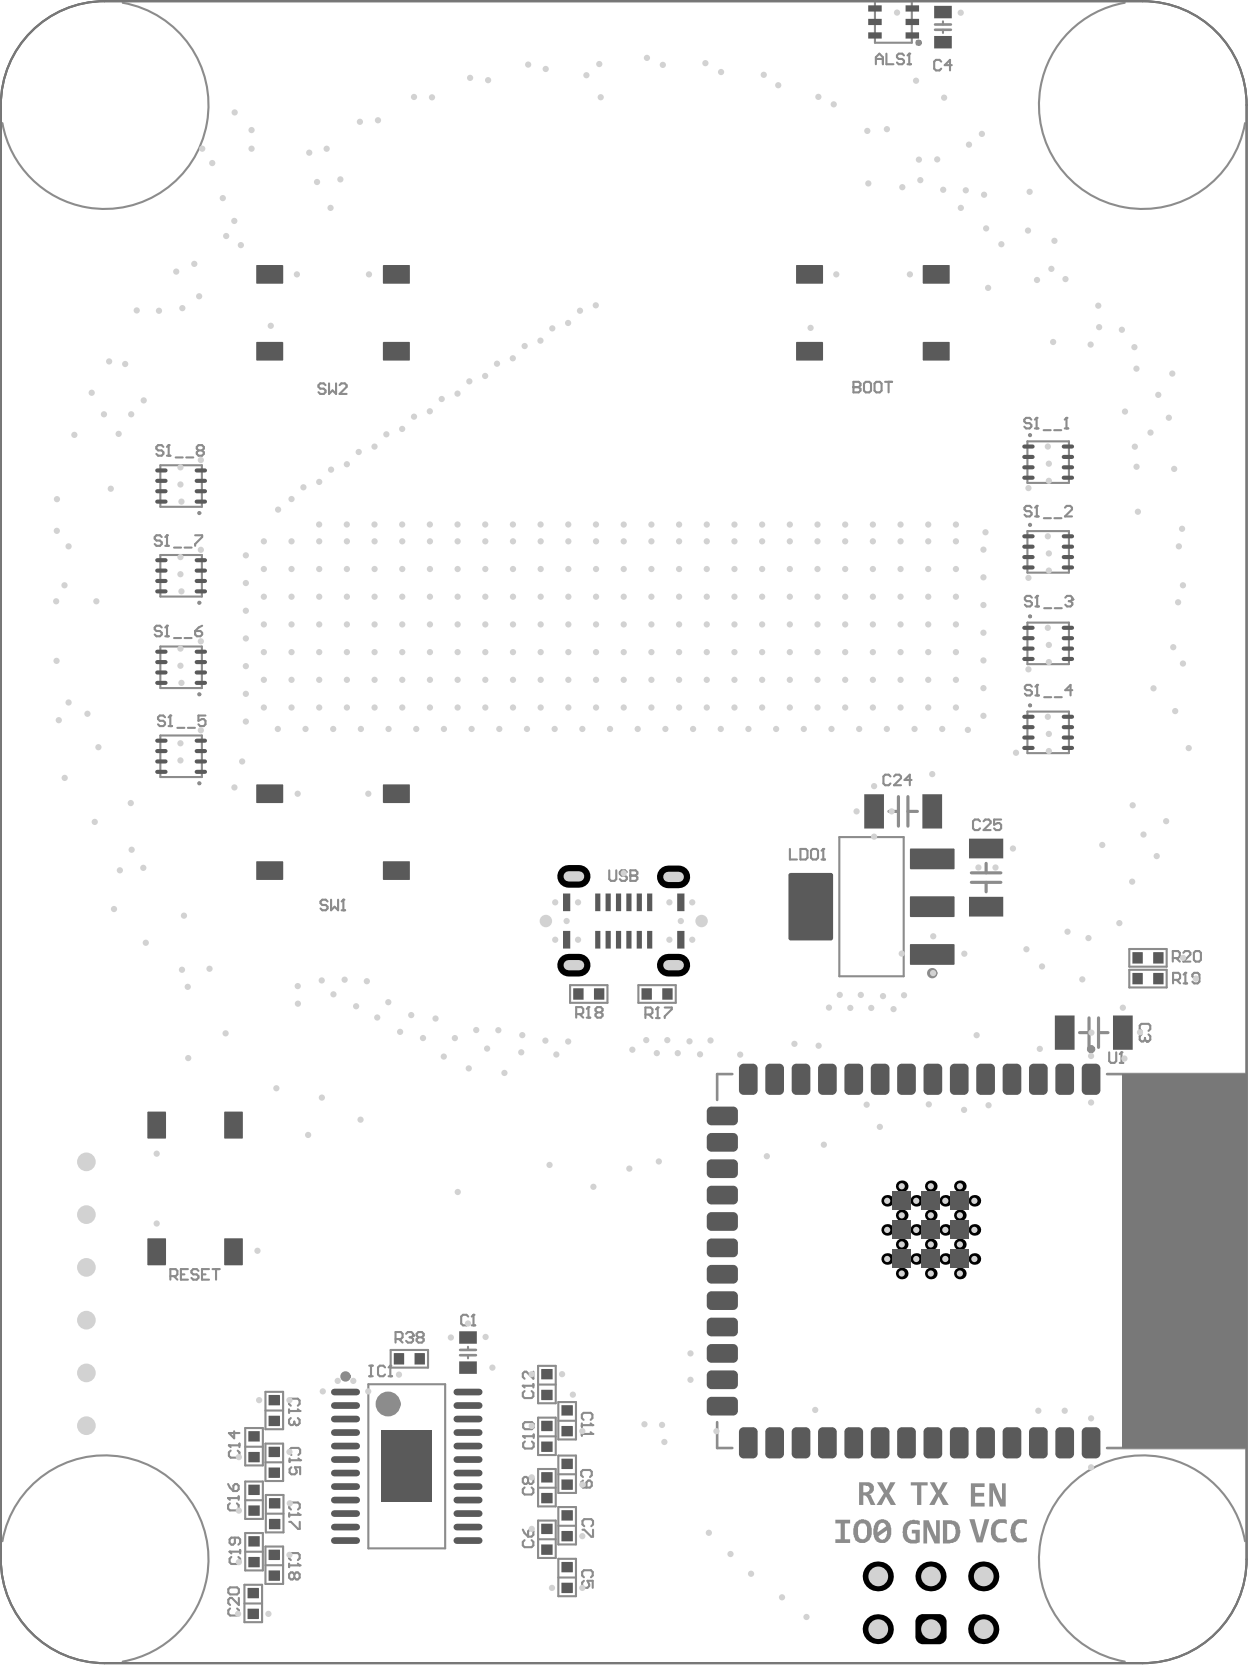
[picture p69: page 5]

# Electrical Rules Check Report

Class | Document | Message Successful Compile for clock_led.PrjPcb
Saturday 1 Nov 2025 12:09:40 PM | Page 1 of 1

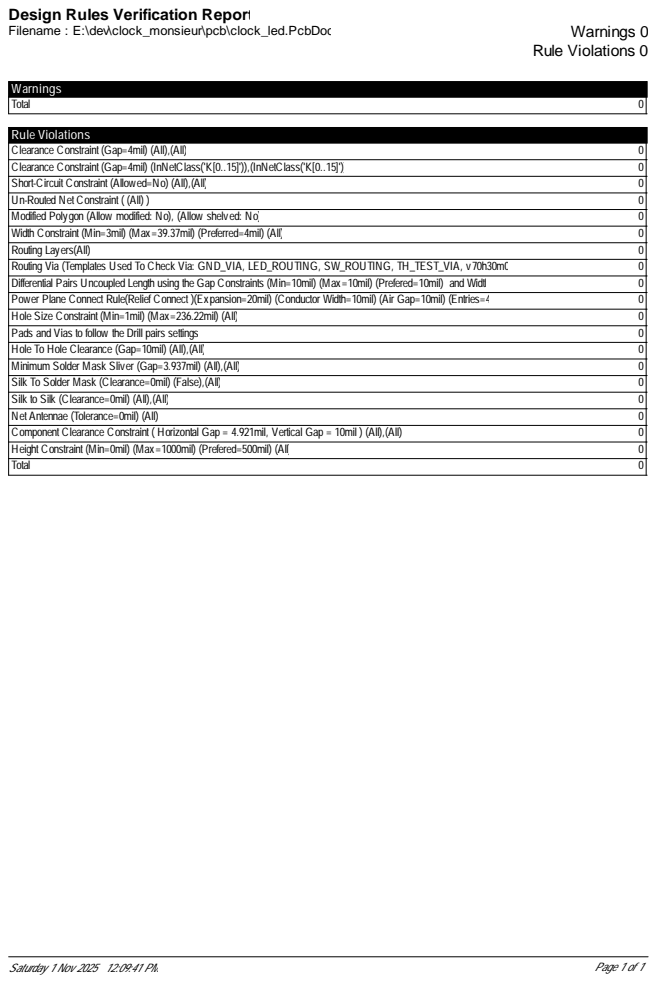
[picture p70: page 7]

Design Rules Verification Report
