cskilbeck/clock_monsieur/pcb/Outputs/2025-10-31/clock_led.pdf

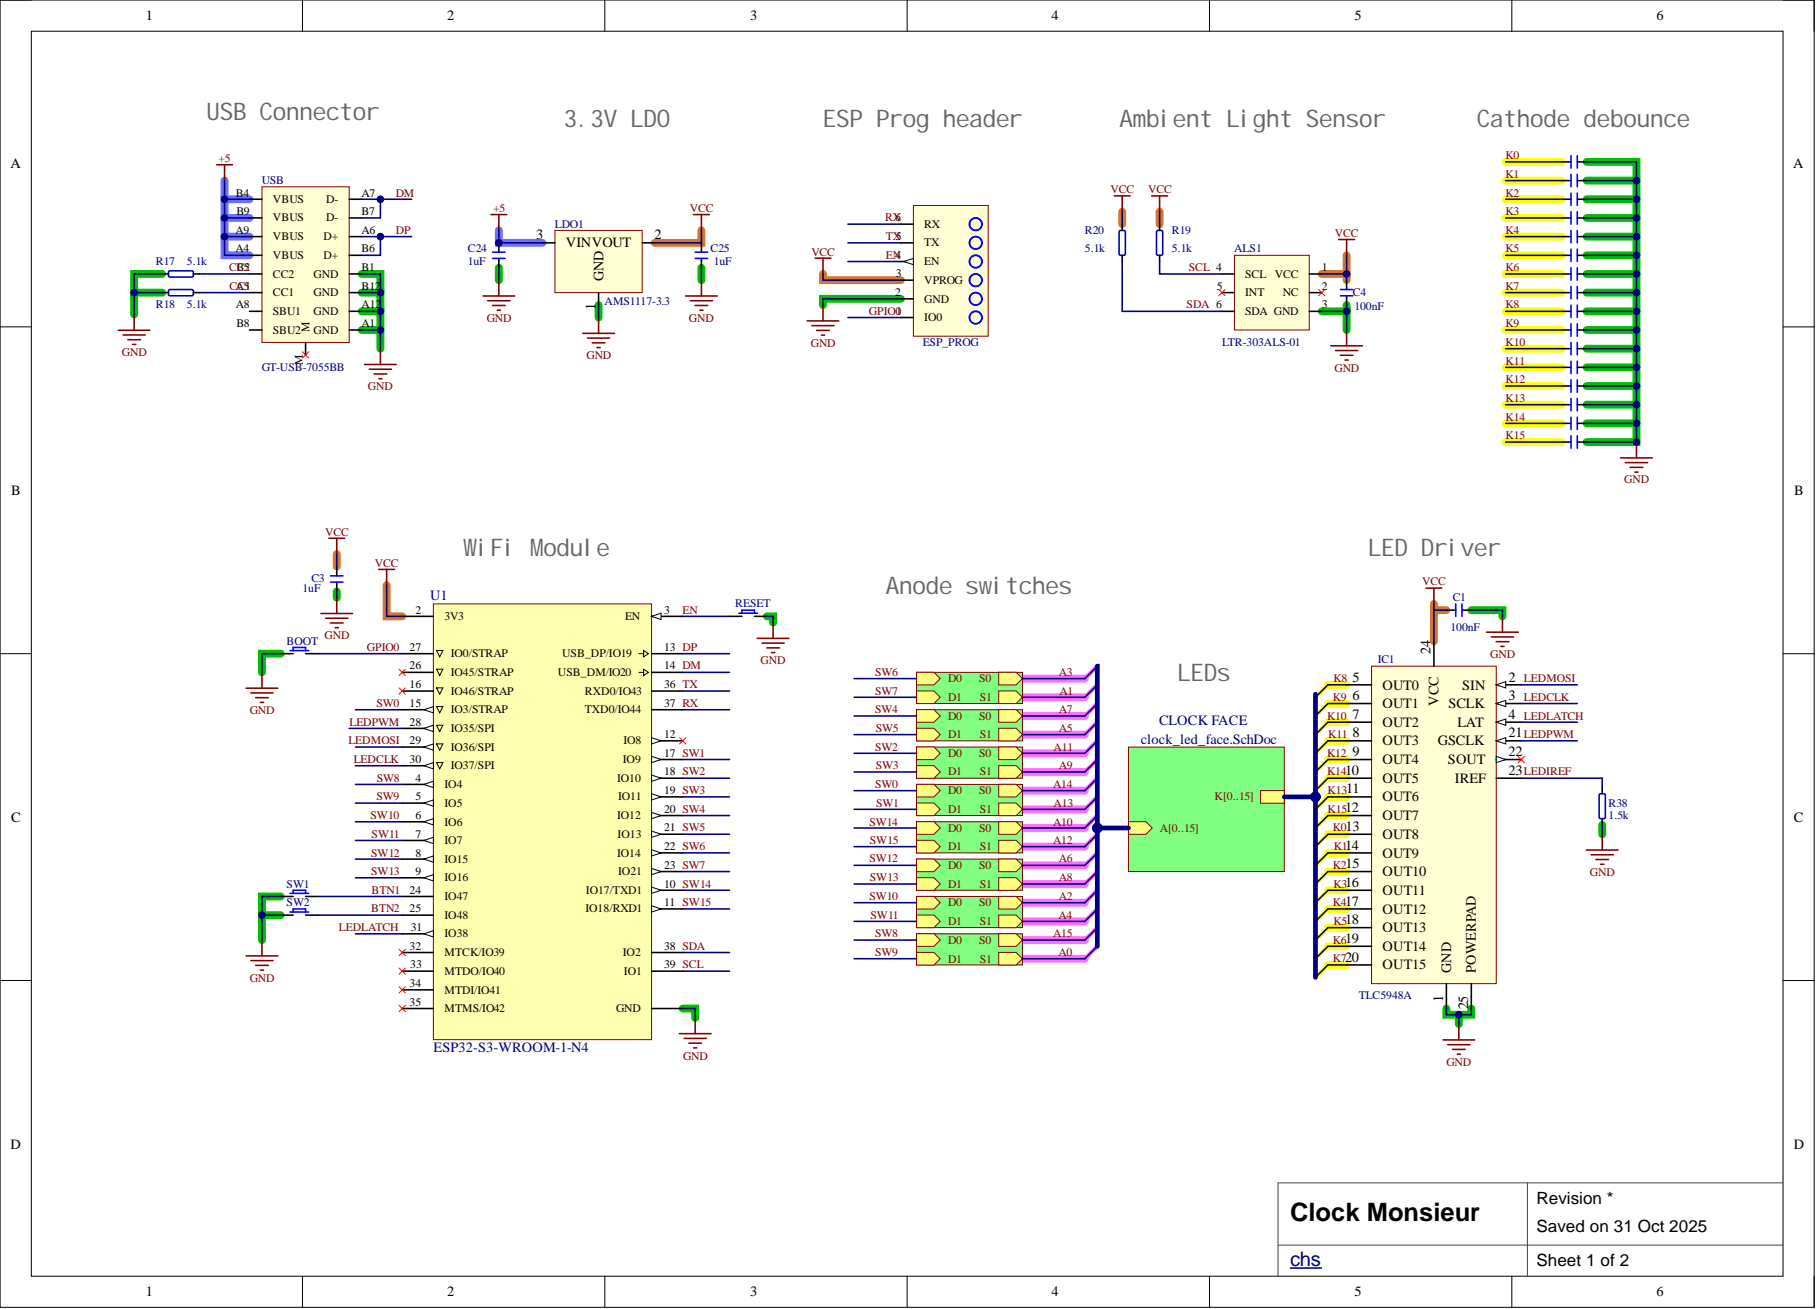
[picture p71: page 1]

A 9 | A 6
A4

Revision *
Sheet 1 of 2 Saved on 31 Oct 2025


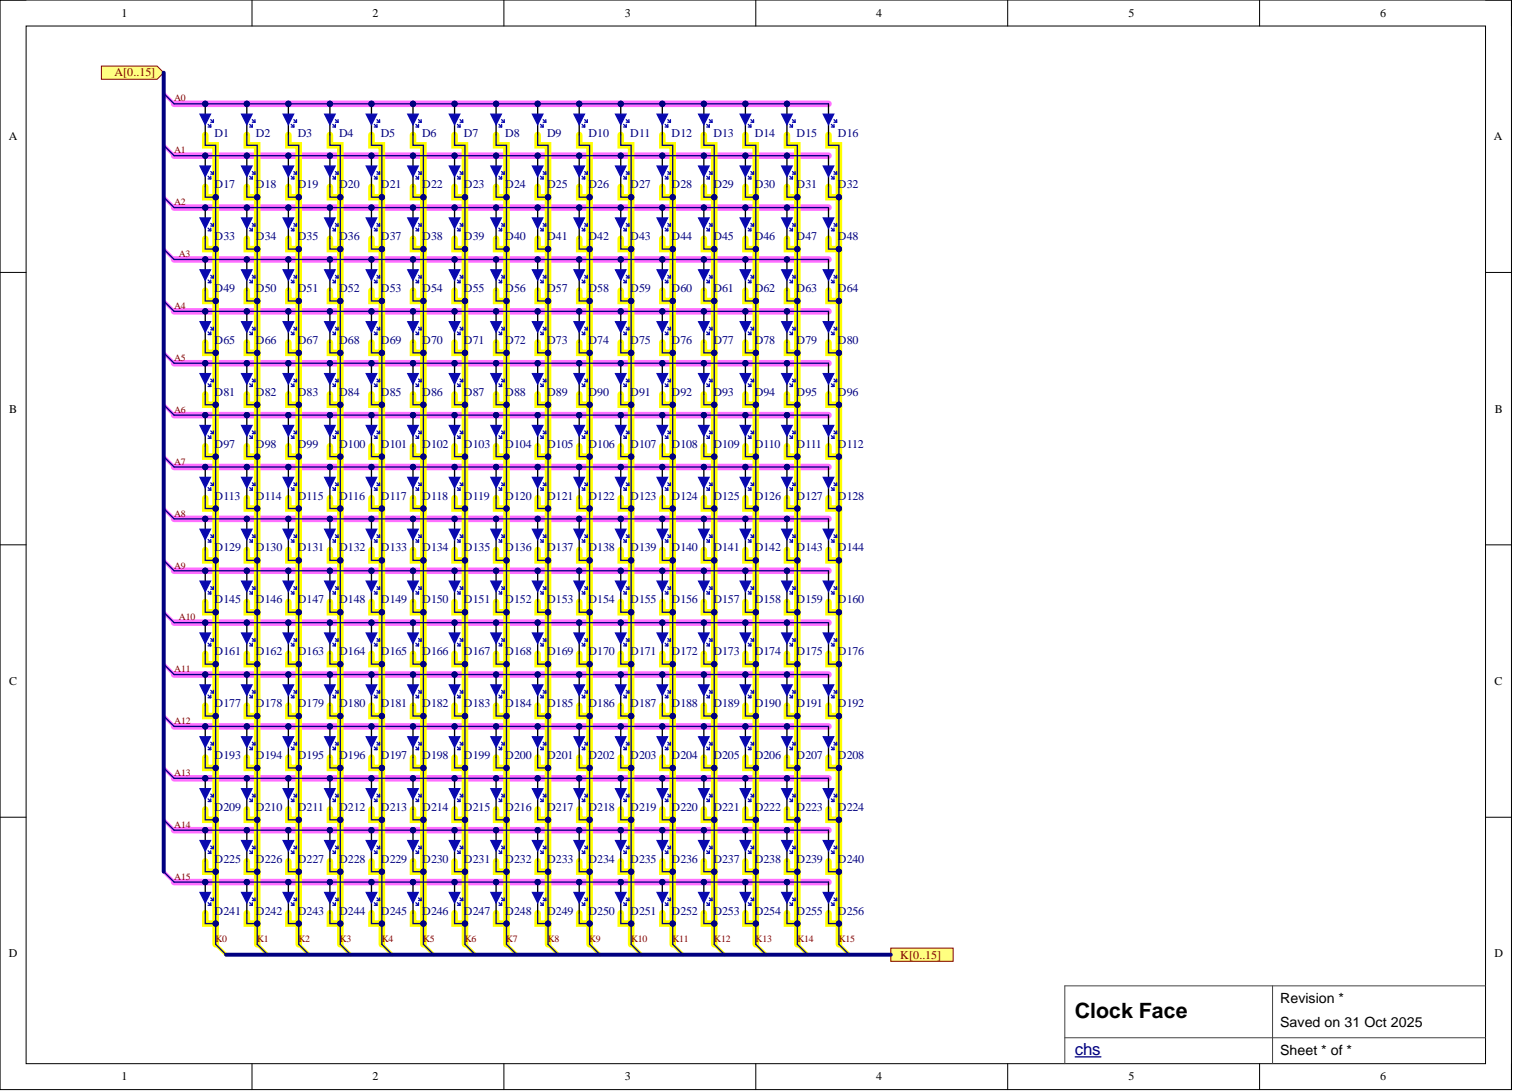
[picture p72: page 3]

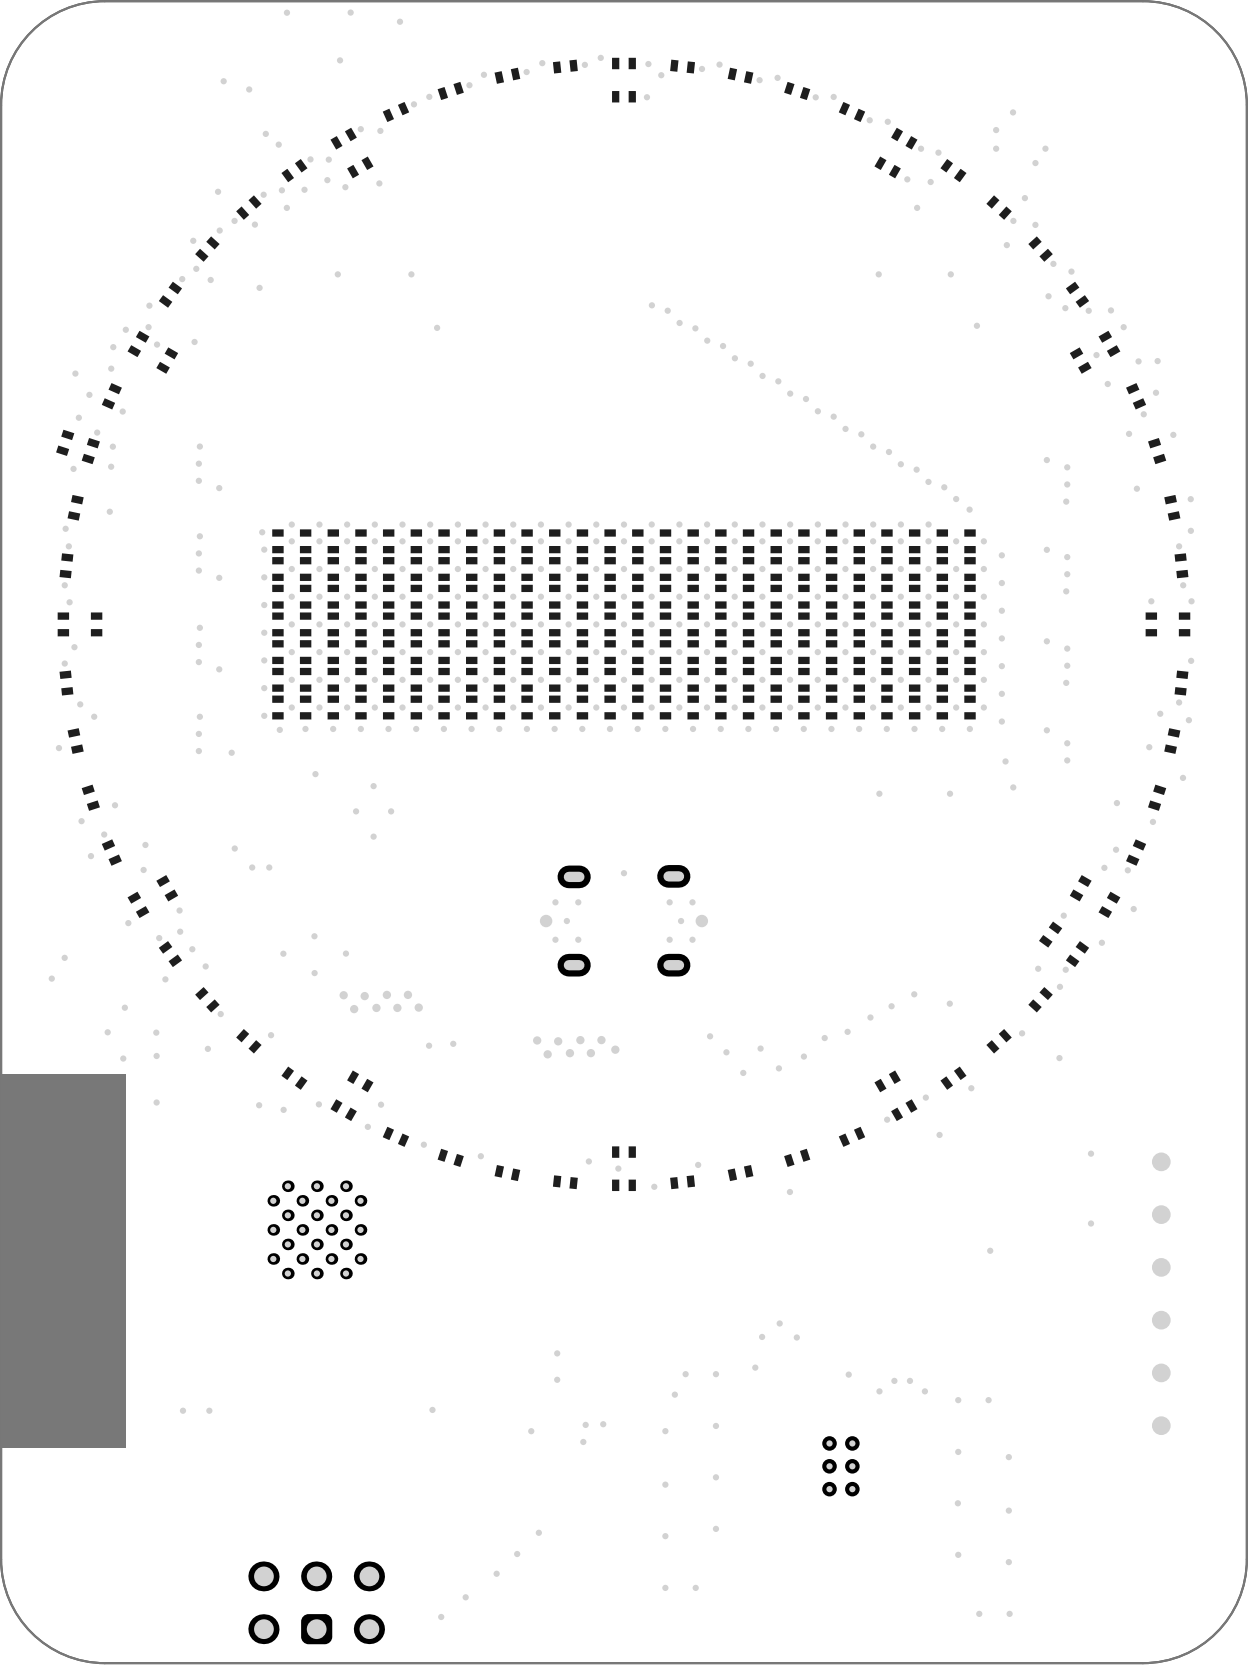
[picture p73: page 4]

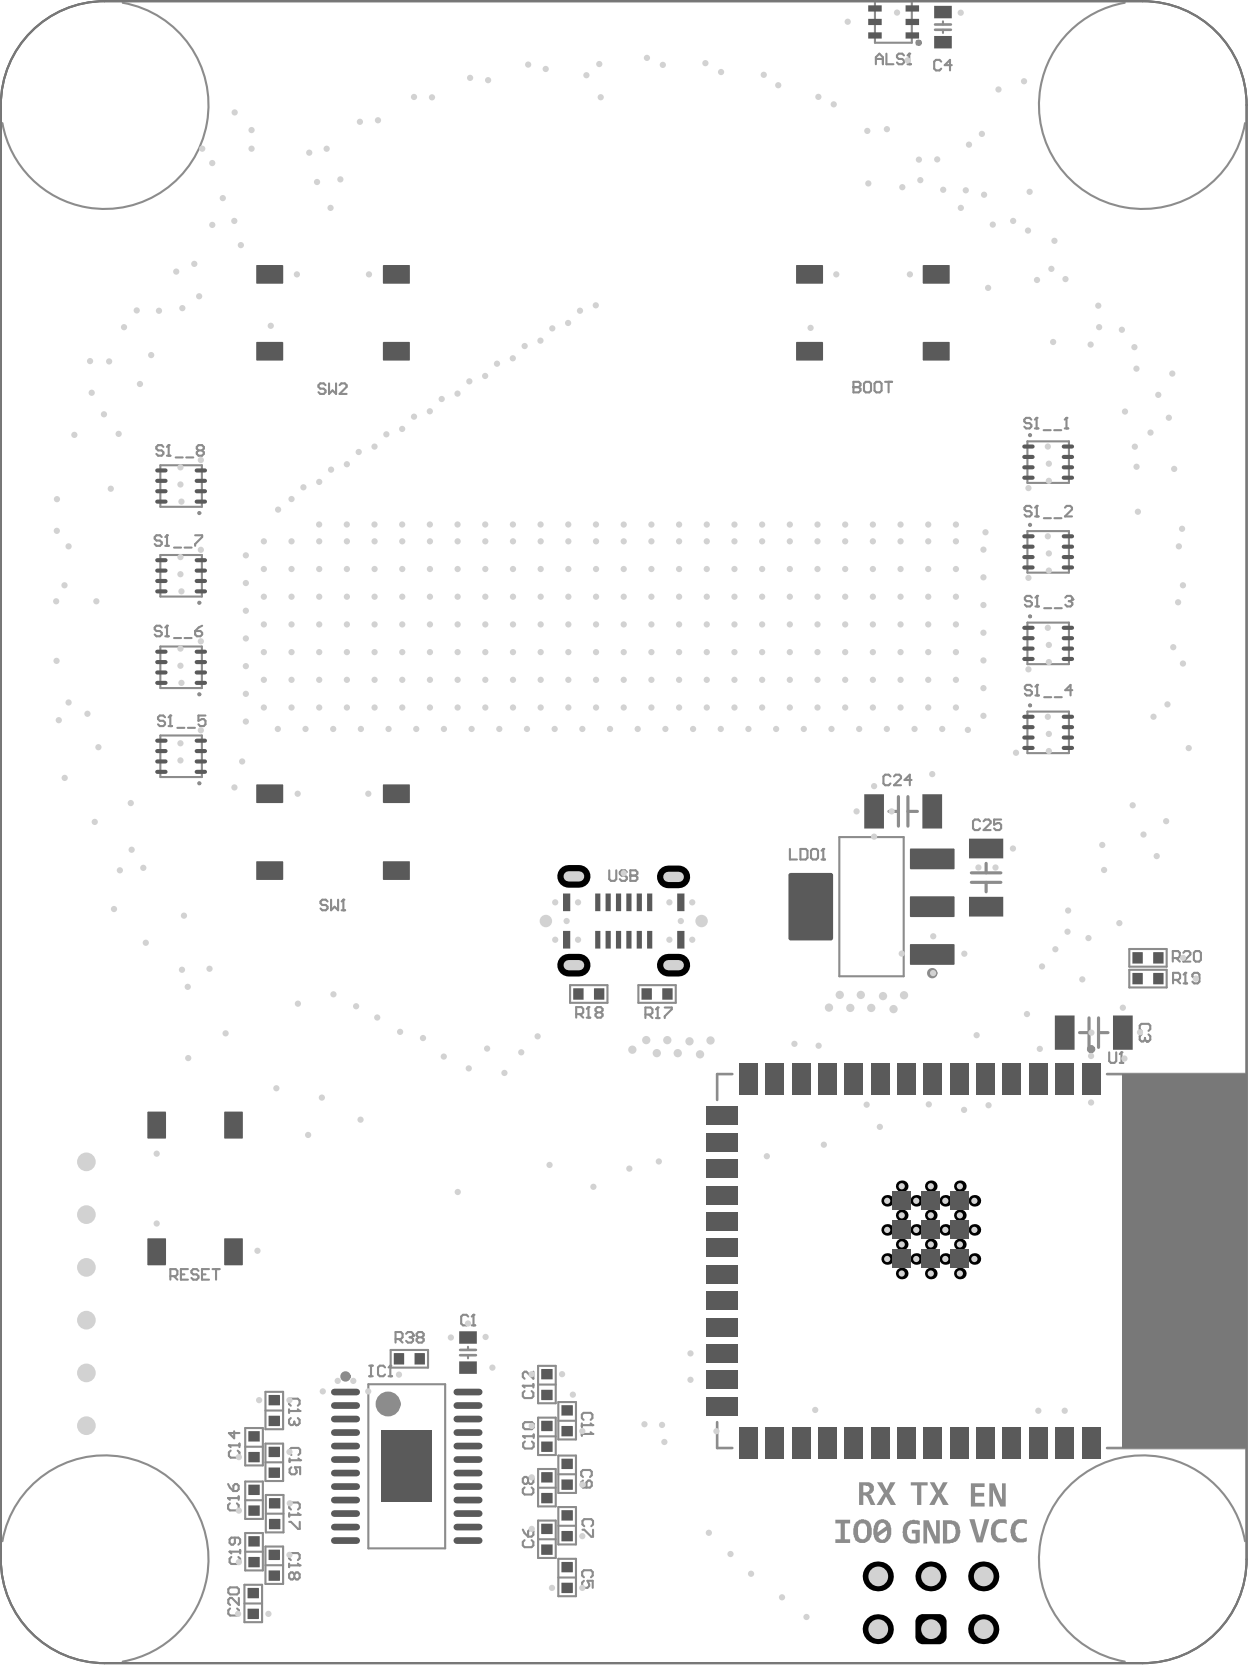
[picture p74: page 5]

# Electrical Rules Check Report

Class | Document | Message Successful Compile for clock_led.PrjPcb
Friday 31 Oct 2025 9:56:07 PM | Page 1 of 1

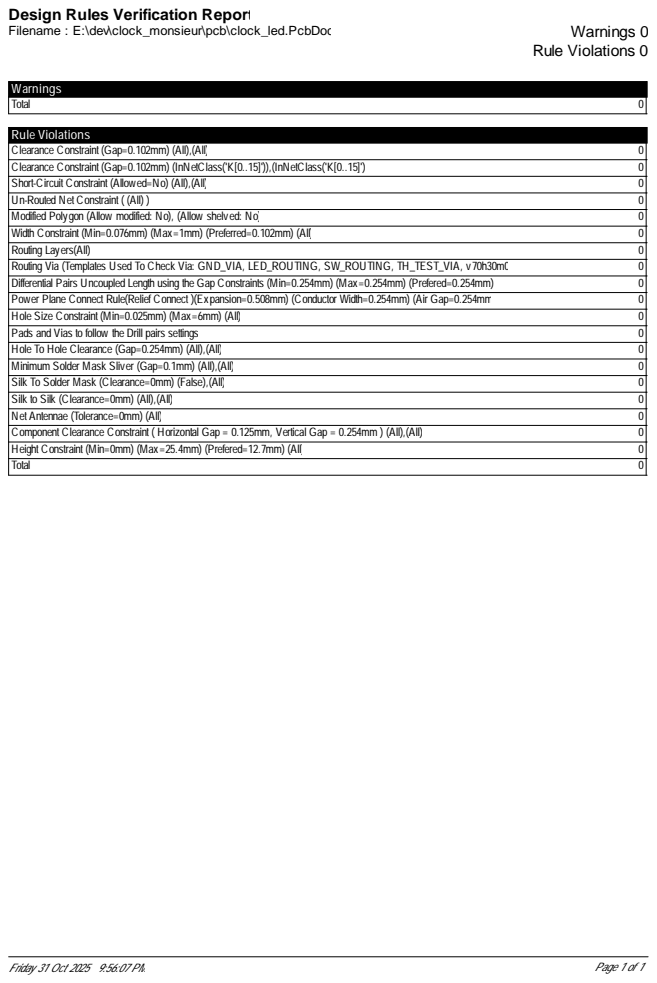
[picture p75: page 7]

Design Rules Verification Report
