cskilbeck/clock_monsieur/(list of files, drawings)

Other design files:
pcb/clock_led.PcbDoc
pcb/clock_led.PcbLib
pcb/clock_led.PrjPcb
pcb/clock_led.SchDoc
pcb/clock_led.SchLib
pcb/clock_led_dual_switch.SchDoc
pcb/clock_led_face.SchDoc
pcb/clock_led_panel.PcbDoc
