cskilbeck/clock_monsieur/firmware/main/linked_list.h

//////////////////////////////////////////////////////////////////////

#pragma once

//////////////////////////////////////////////////////////////////////
// Deal with MSVC internal compiler error, this can be removed when a fix is available

#pragma push_macro("VC_WORKAROUND")
#undef VC_WORKAROUND
#if defined(_MSC_VER)
#define VC_WORKAROUND NODE
#else
#define VC_WORKAROUND (list_node<T> T::*)nullptr != NODE
#endif

#include <functional>

//////////////////////////////////////////////////////////////////////

namespace chs
{

    //////////////////////////////////////////////////////////////////////
    // base list node class, 2 pointers

    template <typename T> struct list_node_base
    {
        T *next;
        T *prev;
    };

    //////////////////////////////////////////////////////////////////////
    // base node is wrapped so we can get the offset to it

    template <typename T> struct list_node
    {
        list_node_base<T> node;
    };

    //////////////////////////////////////////////////////////////////////
    // template base

    template <typename T, list_node<T> T::*NODE, bool is_member> class list_base
    {
    };

    //////////////////////////////////////////////////////////////////////
    // specialization for instances using list_node as member field

    template <typename T, list_node<T> T::*NODE> class list_base<T, NODE, true> : protected list_node<T>
    {
    protected:
        static size_t offset()
        {
            list_node<T> *b = &(((T *)0)->*NODE);
            return size_t(&b->node);
        }

        typedef list_base<T, NODE, true> list_type;
    };

    //////////////////////////////////////////////////////////////////////
    // specialization for instances deriving from list_node

    template <typename T, list_node<T> T::*NODE> class list_base<T, NODE, false> : protected list_node<T>
    {
        static_assert(!std::is_polymorphic<T>::value, "polymorphic! use the member-node version");

    protected:
        static size_t offset()
        {
            list_node_base<T> T::*n = static_cast<list_node_base<T> T::*>(&T::node);
            return (size_t)(&(((T *)0)->*n));
        }
        typedef list_base<T, NODE, false> list_type;
    };

    //////////////////////////////////////////////////////////////////////

    template <typename T, list_node<T> T::*NODE = nullptr> class linked_list : protected list_base<T, NODE, VC_WORKAROUND>
    {
    public:
        //////////////////////////////////////////////////////////////////////

        using list_base<T, NODE, VC_WORKAROUND>::offset;
        using list_base<T, NODE, VC_WORKAROUND>::node;

        //////////////////////////////////////////////////////////////////////

        typedef linked_list<T, NODE> list_t;

        typedef T *ptr;
        typedef T *pointer;
        typedef T const *const_ptr;
        typedef T const *const_pointer;
        typedef T &ref;
        typedef T &reference;
        typedef T const &const_ref;
        typedef T const &const_reference;

        //////////////////////////////////////////////////////////////////////

#if !defined(_CHS_LINKED_LIST_DONT_DEFINE_STL_ITERATORS_)

        // typedef std::iterator<std::bidirectional_iterator_tag, T> iterator_base;

        //////////////////////////////////////////////////////////////////////

        struct const_iterator
        {
            const_iterator(const_ptr t) : p(t)
            {
            }
            const_iterator(const_iterator const &o) : p(o.p)
            {
            }
            const_iterator const &operator=(const_iterator const &o)
            {
                p = o.p;
                return *this;
            }
            const_iterator &operator++()
            {
                p = get_node(p).next;
                return *this;
            }
            const_iterator &operator--()
            {
                p = get_node(p).prev;
                return *this;
            }
            bool operator==(const_iterator const &o)
            {
                return p == o.p;
            }
            bool operator!=(const_iterator const &o)
            {
                return p != o.p;
            }
            const_ref operator*()
            {
                return *p;
            }
            const_ptr operator->()
            {
                return p;
            }
            operator ptr()
            {
                return p;
            }

        private:
            const_ptr p;
        };

        //////////////////////////////////////////////////////////////////////

        struct iterator
        {
            iterator(ptr t) : p(t)
            {
            }
            iterator(const_ptr t) : p(t)
            {
            }
            iterator(iterator const &o) : p(o.p)
            {
            }
            iterator const &operator=(const_iterator const &o)
            {
                p = o.p;
                return *this;
            }
            iterator const &operator=(iterator const &o)
            {
                p = o.p;
                return *this;
            }
            iterator &operator++()
            {
                p = get_node(p).next;
                return *this;
            }
            iterator &operator--()
            {
                p = get_node(p).prev;
                return *this;
            }
            bool operator==(iterator const &o)
            {
                return p == o.p;
            }
            bool operator!=(iterator const &o)
            {
                return p != o.p;
            }
            ref operator*()
            {
                return *p;
            }
            ptr operator->()
            {
                return p;
            }
            operator ptr()
            {
                return p;
            }
            ptr get() const
            {
                return p;
            }

        private:
            ptr p;
        };

        //////////////////////////////////////////////////////////////////////

        struct const_reverse_iterator
        {
            const_reverse_iterator(const_ptr t) : p(t)
            {
            }
            const_reverse_iterator(const_reverse_iterator const &o) : p(o.p)
            {
            }
            const_reverse_iterator const &operator=(const_reverse_iterator const &o)
            {
                p = o.p;
                return o;
            }
            const_reverse_iterator &operator++()
            {
                p = get_node(p).prev;
                return *this;
            }
            const_reverse_iterator &operator--()
            {
                p = get_node(p).next;
                return *this;
            }
            bool operator==(const_reverse_iterator const &o)
            {
                return p == o.p;
            }
            bool operator!=(const_reverse_iterator const &o)
            {
                return p != o.p;
            }
            const_ref operator*()
            {
                return *p;
            }
            const_ptr operator->()
            {
                return p;
            }
            operator ptr()
            {
                return p;
            }

        private:
            const_ptr p;
        };

        //////////////////////////////////////////////////////////////////////

        struct reverse_iterator
        {
            reverse_iterator(ptr t) : p(t)
            {
            }
            reverse_iterator(const_ptr t) : p(t)
            {
            }
            reverse_iterator(reverse_iterator const &o) : p(o.p)
            {
            }
            reverse_iterator const &operator=(const_reverse_iterator const &o)
            {
                p = o.p;
                return *this;
            }
            reverse_iterator const &operator=(reverse_iterator const &o)
            {
                p = o.p;
                return *this;
            }
            reverse_iterator &operator++()
            {
                p = get_node(p).prev;
                return *this;
            }
            reverse_iterator &operator--()
            {
                p = get_node(p).next;
                return *this;
            }
            bool operator==(reverse_iterator const &o)
            {
                return p == o.p;
            }
            bool operator!=(reverse_iterator const &o)
            {
                return p != o.p;
            }
            ref operator*()
            {
                return *p;
            }
            ptr operator->()
            {
                return p;
            }
            operator ptr()
            {
                return p;
            }

        private:
            ptr p;
        };

        //////////////////////////////////////////////////////////////////////

        iterator begin()
        {
            return iterator(node.next);
        }
        const_iterator begin() const
        {
            return const_iterator(node.next);
        }

        reverse_iterator rbegin()
        {
            return reverse_iterator(node.prev);
        }
        const_reverse_iterator rbegin() const
        {
            return const_reverse_iterator(node.prev);
        }

        iterator end()
        {
            return iterator(root());
        }
        const_iterator end() const
        {
            return const_iterator(const_root());
        }

        reverse_iterator rend()
        {
            return reverse_iterator(root());
        }
        const_reverse_iterator rend() const
        {
            return const_reverse_iterator(const_root());
        }

        const_iterator cbegin() const
        {
            return const_iterator(node.next);
        }
        const_iterator cend() const
        {
            return const_iterator(const_root());
        }

        const_reverse_iterator crbegin() const
        {
            return const_reverse_iterator(node.prev);
        }
        const_reverse_iterator crend() const
        {
            return const_reverse_iterator(const_root());
        }

#endif    //! defined(_CHS_LINKED_LIST_DONT_DEFINE_STL_ITERATORS_)

        //////////////////////////////////////////////////////////////////////

        typedef list_node_base<T> node_t;
        typedef node_t *node_ptr;
        typedef node_t &node_ref;
        typedef list_node_base<T> const const_node_t;
        typedef const_node_t *const_node_ptr;
        typedef const_node_t &const_node_ref;

    private:
        //////////////////////////////////////////////////////////////////////

        static list_t &transfer(list_t &a, list_t &b)
        {
            if(!a.empty()) {
                T *ot = a.tail();
                T *oh = a.head();
                T *rt = b.root();
                get_node(ot).next = rt;
                get_node(oh).prev = rt;
                get_node(rt).prev = ot;
                get_node(rt).next = oh;
                a.clear();
            } else {
                b.clear();
            }
            return b;
        }

        //////////////////////////////////////////////////////////////////////

        static ptr get_object(node_ptr node)
        {
            return reinterpret_cast<ptr>(reinterpret_cast<char *>(node) - offset());
        }

        //////////////////////////////////////////////////////////////////////

        static node_ref get_node(ptr obj)
        {
            return *reinterpret_cast<node_ptr>(reinterpret_cast<char *>(obj) + offset());
        }

        //////////////////////////////////////////////////////////////////////

        static const_node_ref get_node(const_ptr obj)
        {
            return *reinterpret_cast<const_node_ptr>(reinterpret_cast<char const *>(obj) + offset());
        }

        //////////////////////////////////////////////////////////////////////

        ptr root()
        {
            return reinterpret_cast<ptr>(reinterpret_cast<char *>(&node) - offset());
        }

        //////////////////////////////////////////////////////////////////////

        const_ptr const_root() const
        {
            return reinterpret_cast<const_ptr>(reinterpret_cast<char const *>(&node) - offset());
        }

        //////////////////////////////////////////////////////////////////////

        static ptr get_next(ptr const o)
        {
            return get_node(o).next;
        }

        //////////////////////////////////////////////////////////////////////

        static ptr get_prev(ptr const o)
        {
            return get_node(o).prev;
        }

        //////////////////////////////////////////////////////////////////////

        static void set_next(ptr o, ptr const p)
        {
            get_node(o).next = p;
        }

        //////////////////////////////////////////////////////////////////////

        static void set_prev(ptr o, ptr const p)
        {
            get_node(o).prev = p;
        }

    public:
        //////////////////////////////////////////////////////////////////////

        void clear()
        {
            node.next = root();
            node.prev = root();
        }

        //////////////////////////////////////////////////////////////////////

        void insert_before(ptr obj_before, ptr obj)
        {
            ptr &p = get_node(obj_before).prev;
            node_ref n = get_node(obj);
            get_node(p).next = obj;
            n.prev = p;
            p = obj;
            n.next = obj_before;
        }

        //////////////////////////////////////////////////////////////////////

        void insert_after(ptr obj_after, ptr obj)
        {
            ptr &n = get_node(obj_after).next;
            node_ref p = get_node(obj);
            get_node(n).prev = obj;
            p.next = n;
            n = obj;
            p.prev = obj_after;
        }

        //////////////////////////////////////////////////////////////////////

        ptr remove(ptr obj)
        {
            ptr p = prev(obj);
            ptr n = next(obj);
            get_node(p).next = n;
            get_node(n).prev = p;
            return obj;
        }

        //////////////////////////////////////////////////////////////////////

        void remove_range(ptr f, ptr l)
        {
            ptr op = prev(f);
            ptr on = next(l);
            get_node(op).next = on;
            get_node(on).prev = op;
        }

        //////////////////////////////////////////////////////////////////////

        void move_range_before(ptr where, list_t &other, ptr f, ptr l)
        {
            other.remove_range(f, l);
            ptr p = get_node(where).prev;
            get_node(p).next = f;
            get_node(f).prev = p;
            get_node(where).prev = l;
            get_node(l).next = where;
        }

        //////////////////////////////////////////////////////////////////////

        void move_range_after(ptr where, list_t &other, ptr f, ptr l)
        {
            other.remove_range(f, l);
            ptr p = get_node(where).next;
            get_node(p).prev = l;
            get_node(l).next = p;
            get_node(where).next = f;
            get_node(f).prev = where;
        }

        //////////////////////////////////////////////////////////////////////

        linked_list()
        {
            clear();
        }

        //////////////////////////////////////////////////////////////////////

        explicit linked_list(list_t &other)
        {
            transfer(other, *this);
        }

        //////////////////////////////////////////////////////////////////////

        list_t &operator=(list_t &o)
        {
            return transfer(o, *this);
        }

        //////////////////////////////////////////////////////////////////////

        list_t const &operator=(list_t const &&o) = delete;

        //////////////////////////////////////////////////////////////////////

        list_t &operator=(list_t &&o) = delete;

        //////////////////////////////////////////////////////////////////////

        bool empty() const
        {
            return node.next == const_root();
        }

        //////////////////////////////////////////////////////////////////////

        size_t size() const
        {
            size_t count = 0;
            for(auto const &i : *this) {
                ++count;
            }
            return count;
        }

        //////////////////////////////////////////////////////////////////////

        ptr head()
        {
            return node.next;
        }
        ptr tail()
        {
            return node.prev;
        }

        const_ptr c_head() const
        {
            return node.next;
        }
        const_ptr c_tail() const
        {
            return node.prev;
        }

        ptr next(ptr obj)
        {
            return get_node(obj).next;
        }
        ptr prev(ptr obj)
        {
            return get_node(obj).prev;
        }

        const_ptr c_next(const_ptr obj) const
        {
            return get_node(obj).next;
        }
        const_ptr c_prev(const_ptr obj) const
        {
            return get_node(obj).prev;
        }

        ptr done()
        {
            return root();
        }
        const_ptr c_done() const
        {
            return const_root();
        }

        //////////////////////////////////////////////////////////////////////

        ptr remove(ref obj)
        {
            return remove(&obj);
        }

        void push_back(ref obj)
        {
            insert_before(*root(), obj);
        }
        void push_back(ptr obj)
        {
            insert_before(root(), obj);
        }

        void push_front(ref obj)
        {
            insert_after(*root(), obj);
        }
        void push_front(ptr obj)
        {
            insert_after(root(), obj);
        }

        ptr pop_front()
        {
            return empty() ? nullptr : remove(head());
        }
        ptr pop_back()
        {
            return empty() ? nullptr : remove(tail());
        }

        void insert_before(ref bef, ref obj)
        {
            insert_before(&bef, &obj);
        }
        void insert_after(ref aft, ref obj)
        {
            insert_after(&aft, &obj);
        }

        void remove_range(ref f, ref l)
        {
            remove_range(&f, &l);
        }

        void move_range_before(ref where, list_t &other, ref f, ref l)
        {
            move_range_before(&where, other, &f, &l);
        }

        void move_range_after(ref where, list_t &other, ref f, ref l)
        {
            move_range_after(&where, other, &f, &l);
        }

        //////////////////////////////////////////////////////////////////////

        void append(list_t &other_list)
        {
            if(!other_list.empty()) {
                ptr oh = other_list.head();
                ptr ot = other_list.tail();
                ptr rt = root();
                ptr mt = tail();
                get_node(mt).next = oh;
                get_node(oh).prev = mt;
                get_node(ot).next = rt;
                get_node(rt).prev = ot;
                other_list.clear();
            }
        }

        //////////////////////////////////////////////////////////////////////

        void prepend(list_t &other_list)
        {
            if(!other_list.empty()) {
                ptr oh = other_list.head();
                ptr ot = other_list.tail();
                ptr rt = root();
                ptr mh = head();
                get_node(mh).prev = ot;
                get_node(ot).next = mh;
                get_node(oh).prev = rt;
                get_node(rt).next = oh;
                other_list.clear();
            }
        }

        //////////////////////////////////////////////////////////////////////

        template <typename N> void copy_into(N &n)
        {
            static_assert(!std::is_same<N, list_t>::value, "can't copy to the same type!");
            for(auto &p : *this) {
                n.push_back(p);
            }
        }

        //////////////////////////////////////////////////////////////////////

        void split(ptr obj, list_t &new_list)
        {
            T *prev_obj = prev(obj);
            if(prev_obj == root()) {
                transfer(*this, new_list);
            } else {
                T *new_root = new_list.root();
                T *old_tail = tail();
                T *next_obj = next(obj);
                if(next_obj == root()) {
                    get_node(old_tail).prev = new_root;
                }
                get_node(old_tail).next = new_root;
                get_node(prev_obj).next = root();
                get_node(root()).prev = prev_obj;
                new_list.get_node(new_root).next = obj;
                new_list.get_node(new_root).prev = old_tail;
            }
        }

        //////////////////////////////////////////////////////////////////////
    private:
        static void merge(list_t &left, list_t &right)
        {
            ptr insert_point = right.root();
            ptr run_head = left.head();
            ptr ad = left.done();
            ptr bd = right.done();
            while(run_head != ad) {
                // find where to put a run
                do {
                    insert_point = get_next(insert_point);
                } while(insert_point != bd && *insert_point < *run_head);

                // scanned off the end?
                if(insert_point != bd) {
                    // no, find how long the run should be
                    ptr run_start = run_head;
                    ptr run_end;
                    do {
                        run_end = run_head;
                        run_head = get_next(run_head);
                    } while(run_head != ad && *run_head < *insert_point);

                    // insert it
                    ptr p = get_prev(insert_point);
                    set_prev(run_start, p);
                    set_next(p, run_start);
                    set_prev(insert_point, run_end);
                    set_next(run_end, insert_point);
                } else {    // yes, append remainder
                    ptr ot = left.tail();
                    ptr rt = right.root();
                    ptr mt = right.tail();
                    set_prev(run_head, mt);
                    set_next(mt, run_head);
                    set_prev(rt, ot);
                    set_next(ot, rt);
                    break;
                }
            }
        }

        //////////////////////////////////////////////////////////////////////
        // thanks to the putty guy

        static void merge_sort(list_t &list, size_t size)
        {
            if(size > 2) {
                // scan for midpoint
                size_t left_size = size / 2;
                size_t right_size = size - left_size;
                ptr pm = list.head();
                for(size_t s = 0; s < left_size; ++s) {
                    pm = list.next(pm);
                }

                // split into left, right
                list_t left;
                list_t right;
                ptr lr = left.root();
                ptr rr = right.root();
                ptr ot = list.tail();
                ptr oh = list.head();
                ptr pp = list.get_prev(pm);
                set_prev(lr, pp);
                set_next(lr, oh);
                set_prev(oh, lr);
                set_next(pp, lr);
                set_prev(rr, ot);
                set_next(rr, pm);
                set_prev(pm, rr);
                set_next(ot, rr);

                // sort them
                merge_sort(left, left_size);
                merge_sort(right, right_size);

                // stitch them back together
                merge(right, left);

                // move result back into list
                ot = left.tail();
                oh = left.head();
                lr = list.root();
                set_prev(oh, lr);
                set_next(ot, lr);
                set_prev(lr, ot);
                set_next(lr, oh);
            } else if(size > 1) {
                // dinky list of 2 entries, just fix it
                ptr h = list.head();
                ptr t = list.tail();
                if(*t < *h) {
                    ptr r = list.root();
                    set_next(r, t);
                    set_prev(r, h);
                    set_next(h, r);
                    set_prev(h, t);
                    set_next(t, h);
                    set_prev(t, r);
                }
            }
        }

        //////////////////////////////////////////////////////////////////////
    public:
        void sort()
        {
            merge_sort(*this, size());
        }

        //////////////////////////////////////////////////////////////////////

        void merge_into(list_t &other)
        {
            merge(*this, other);
            clear();
        }

        //////////////////////////////////////////////////////////////////////

        void for_each(std::function<void(T &)> func)
        {
            for(auto i = begin(), _end = end(), n = i; ++n, i != _end; i = n) {
                func(*i);
            }
        }

        //////////////////////////////////////////////////////////////////////

        list_t select(std::function<bool(T &)> func)
        {
            list_t t;
            for(auto i = begin(), _end = end(), n = i; ++n, i != _end; i = n) {
                if(func(*i)) {
                    t.push_back(remove(i));
                }
            }
            return t;
        }

        //////////////////////////////////////////////////////////////////////

        template <class O> ptr find_first_of(O const &t)
        {
            for(auto p = head(); p != done(); p = next(p)) {
                if(*p == t) {
                    return p;
                }
            }
            return nullptr;
        }

        //////////////////////////////////////////////////////////////////////

        template <typename O> ptr find_last_of(O const &t)
        {
            for(auto p = tail(); p != done(); p = prev(p)) {
                if(*p == t) {
                    return p;
                }
            }
            return nullptr;
        }

        //////////////////////////////////////////////////////////////////////

        unsigned remove_if(std::function<bool(ref)> func)
        {
            unsigned total = 0;
            for(auto i = begin(), _end = end(), n = i; ++n, i != _end; i = n) {
                if(func(*i)) {
                    remove(i);
                    ++total;
                }
            }
            return total;
        }

        //////////////////////////////////////////////////////////////////////

        unsigned delete_if(std::function<bool(ref)> func)
        {
            unsigned total = 0;
            for(auto i = begin(), _end = end(), n = i; ++n, i != _end; i = n) {
                if(func(*i)) {
                    remove(i);
                    delete i;
                    ++total;
                }
            }
            return total;
        }

        //////////////////////////////////////////////////////////////////////

        void remove_all()
        {
            clear();
        }

        //////////////////////////////////////////////////////////////////////

        void delete_all()
        {
            while(!empty()) {
                ptr i = pop_front();
                delete i;
            }
        }
    };

    //////////////////////////////////////////////////////////////////////

}    // namespace chs

#if defined(_WIN64)
#pragma warning(push)
#pragma warning(disable : 4602)    // disable spurious warning
#pragma pop_macro("VC_WORKAROUND")
#pragma warning(pop)
#endif
