cskilbeck/clock_monsieur/firmware/main/main.h

#pragma once

#include <time.h>

#include "freertos/event_groups.h"

extern EventGroupHandle_t system_events;

#define SYS_EVENT_BOOT_MSG_COMPLETE BIT0
#define SYS_EVENT_WIFI_CONNECTED BIT1
#define SYS_EVENT_NETWORK_CONNECTED BIT2
#define SYS_EVENT_SNTP_SYNCHRONIZED BIT3
#define SYS_EVENT_GOT_LOCATION BIT4
#define SYS_EVENT_GOT_TIMEZONE BIT5
#define SYS_EVENT_PROVISIONING BIT6
#define SYS_EVENT_BLE_CONNECTED BIT7
#define SYS_EVENT_PROVISIONING_ERROR BIT8
#define SYS_EVENT_PROVISIONING_DONE BIT9
#define SYS_EVENT_NEED_LOCATION BIT10
#define SYS_EVENT_PROVISIONING_IN_PROGRESS BIT11
#define SYS_EVENT_PROVISIONING_GOT_SSID BIT12

#define SYS_EVENT_PROVISIONING_BITS (SYS_EVENT_PROVISIONING_IN_PROGRESS | SYS_EVENT_PROVISIONING_GOT_SSID | SYS_EVENT_BLE_CONNECTED)
