cskilbeck/clock_monsieur/firmware/main/console.cpp

//////////////////////////////////////////////////////////////////////

#include <cstdio>
#include <cstring>
#include <ctype.h>

#include <freertos/FreeRTOS.h>
#include "nvs_flash.h"

#include "util.h"
#include "state.h"
#include "settings.h"
#include "console.h"

LOG_CONTEXT("console");

//////////////////////////////////////////////////////////////////////

console_command_base_t *console_command_base_t::command_list{};

namespace
{
    //////////////////////////////////////////////////////////////////////
    // https://stackoverflow.com/questions/9659697/parse-string-into-array-based-on-spaces-or-double-quotes-strings/9660047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

    template <size_t MAX_ARGS> int parse_args(char *str, char *(&argv)[MAX_ARGS])
    {
        enum state_t
        {
            space,
            quotes,
            word,
        } state = space;

        char *arg = nullptr;
        char quote{};
        int argc = 0;

        auto is_quote = [](int c) { return c == '"' || c == '\''; };

        auto push = [&arg, &argc, &argv, &state](char *p) {
            *p = 0;
            argv[argc++] = arg;
            state = space;
        };

        for(char *p = str; *p != 0; ++p) {
            int c = *p;
            switch(state) {
            case space:
                if(is_quote(c)) {
                    state = quotes;
                    quote = c;
                    arg = p + 1;
                } else if(!isspace(c)) {
                    state = word;
                    arg = p;
                }
                break;

            case quotes:
                if(c == quote) {
                    push(p);
                }
                break;

            case word:
                if(isspace(c)) {
                    push(p);
                }
                break;
            }
            if(argc == MAX_ARGS) {
                return argc;
            }
        }
        if(state != space && arg != nullptr) {
            argv[argc++] = arg;
        }
        return argc;
    }

    //////////////////////////////////////////////////////////////////////

    void console_task(void *pvParameter)
    {
        delay_ms(200);
        LOG_INFO("CONSOLE IS READY");

        char cmd[64];
        int cmdlen = 0;

        char buffer[16];
        printf("> ");
        while(true) {
            if(fgets(buffer, sizeof(buffer), stdin) != NULL) {
                int l = strlen(buffer);
                bool enter = buffer[l - 1] == '\n';
                if(enter) {
                    l -= 1;
                }
                int cmd_remain = sizeof(cmd) - cmdlen - 1;
                if(l >= cmd_remain) {
                    l = cmd_remain;
                }
                char *fragment = cmd + cmdlen;
                memcpy(fragment, buffer, l);
                cmdlen += l;
                cmd[cmdlen] = 0;
                if(enter) {
                    char *argv[16];
                    int argc = parse_args(cmd, argv);
                    printf(">");
                    for(int i = 0; i < argc; ++i) {
                        printf(" %s", argv[i]);
                    }
                    printf("\n");
                    if(argc != 0) {
                        bool found{ false };
                        for(console_command_base_t *c = console_command_base_t::command_list; c != nullptr; c = c->next) {
                            if(strcmp(c->name(), argv[0]) == 0) {
                                c->on_command(argc, argv);
                                found = true;
                                break;
                            }
                        }
                        if(!found) {
                            printf("Unknown command: %s\n", argv[0]);
                        }
                    }
                    cmdlen = 0;
                }
            }
            delay_ms(100);
        }
    }

}    // namespace

//////////////////////////////////////////////////////////////////////

void console_init()
{
    xTaskCreatePinnedToCore(console_task, "console", 3072, NULL, 1, NULL, 0);
}

//////////////////////////////////////////////////////////////////////

struct : console_command_t<"help", "show commands", "command">
{
    void on_command(int argc, char **argv) override
    {
        auto show_commands = []() {
            for(console_command_base_t *c = console_command_base_t::command_list; c != nullptr; c = c->next) {
                printf("%-20s %s\n", c->name(), c->help());
            }
        };
        if(argc == 1) {
            show_commands();
            return;
        }
        if(argc == 2) {
            for(console_command_base_t *c = console_command_base_t::command_list; c != nullptr; c = c->next) {
                if(strcmp(argv[1], c->name()) == 0) {
                    c->usage();
                    return;
                }
            }
            printf("HELP: Unknown command: %s\n", argv[1]);
            show_commands();
        } else {
            usage();
        }
    }
} cmd_help;

//////////////////////////////////////////////////////////////////////

struct : console_command_t<"mem", "show stack and heap usage", "">
{
    void on_command(int argc, char **argv) override
    {
        char buffer[512];
        vTaskList(buffer);
        printf("%s\n", buffer);
        auto x = esp_get_minimum_free_heap_size();
        printf("HEAP: %lu\n", x);
    }
} cmd_mem;

//////////////////////////////////////////////////////////////////////

struct : console_command_t<"factory", "erase NVS partition", "">
{
    void on_command(int argc, char **argv) override
    {
        state_set<factory_reset_state_t>();
    }
} cmd_factory;

//////////////////////////////////////////////////////////////////////

struct : console_command_t<"reset", "reset the ESP32", "">
{
    void on_command(int argc, char **argv) override
    {
        esp_restart();
    }
} cmd_reset;
