cskilbeck/clock_monsieur/firmware/main/ping.cpp

//////////////////////////////////////////////////////////////////////

#include "freertos/FreeRTOS.h"
#include "freertos/task.h"
#include "esp_ping.h"
#include "ping/ping_sock.h"
#include "wifi.h"
#include "ping.h"
#include "util.h"
#include "main.h"

LOG_CONTEXT("ping");

//////////////////////////////////////////////////////////////////////

namespace
{
    int pings;
    int fails;

    //////////////////////////////////////////////////////////////////////

    void ping_end(esp_ping_handle_t hdl, void *args)
    {
        LOG_INFO("PING END");
    }

    //////////////////////////////////////////////////////////////////////

    void ping_success(esp_ping_handle_t hdl, void *args)
    {
        pings += 1;
        LOG_INFO("SUCCESS %d", pings);
        xEventGroupSetBits(system_events, SYS_EVENT_NETWORK_CONNECTED);
    }

    //////////////////////////////////////////////////////////////////////

    void ping_timeout(esp_ping_handle_t hdl, void *args)
    {
        fails += 1;
        LOG_INFO("TIMEOUT %d", fails);
    }

}    // namespace

//////////////////////////////////////////////////////////////////////

esp_err_t do_ping_check()
{
    LOG_INFO("starting");

    xEventGroupWaitBits(system_events, SYS_EVENT_WIFI_CONNECTED, false, true, portMAX_DELAY);

    esp_ping_config_t config{};
    ipaddr_aton("1.1.1.1", &config.target_addr);
    config.count = 10;
    config.interval_ms = 100;
    config.timeout_ms = 3000;
    config.data_size = 64;
    config.tos = 0;
    config.ttl = IP_DEFAULT_TTL;
    config.task_stack_size = ESP_TASK_PING_STACK;
    config.task_prio = 2;
    config.interface = 0;

    esp_ping_callbacks_t callbacks{};
    callbacks.on_ping_end = ping_end;
    callbacks.on_ping_success = ping_success;
    callbacks.on_ping_timeout = ping_timeout;

    esp_ping_handle_t ping_handle{};
    ESP_CHECK(esp_ping_new_session(&config, &callbacks, &ping_handle));

    DEFER(esp_ping_delete_session(ping_handle));

    pings = 0;
    fails = 0;

    ESP_CHECK(esp_ping_start(ping_handle));

    while(fails < 10) {
        LOG_INFO("Waiting for pings");
        EventBits_t b = xEventGroupWaitBits(system_events, SYS_EVENT_NETWORK_CONNECTED, false, true, pdMS_TO_TICKS(5000));
        if((b & SYS_EVENT_NETWORK_CONNECTED) != 0) {
            esp_ping_stop(ping_handle);
            LOG_INFO("Network is up");
            return ESP_OK;
        }
        fails += 1;
    }
    return ESP_ERR_TIMEOUT;
}
