cskilbeck/clock_monsieur/firmware/main/timezone.h

#pragma once

//////////////////////////////////////////////////////////////////////

#include <ctime>
#include "esp_err.h"

//////////////////////////////////////////////////////////////////////

static int constexpr LONGEST_LOCATION_NAME = 30;    // America/Argentina/Buenos_Aires is 30

//////////////////////////////////////////////////////////////////////

void timezone_select_init();
void timezone_select_update();

esp_err_t timezone_set(char const *location);
int timezone_get_offset_seconds(time_t epoch_seconds);
