cskilbeck/clock_monsieur/firmware/main/wifi.h

//////////////////////////////////////////////////////////////////////

#pragma once

//////////////////////////////////////////////////////////////////////

#include <freertos/event_groups.h>

//////////////////////////////////////////////////////////////////////

esp_err_t wifi_init();
char const *wifi_ip_address();
char const *wifi_mac_address();
char const *provisioning_pop();

//////////////////////////////////////////////////////////////////////
