cskilbeck/clock_monsieur/firmware/main/ota.h

//////////////////////////////////////////////////////////////////////

#pragma once

//////////////////////////////////////////////////////////////////////

#include <esp_err.h>

//////////////////////////////////////////////////////////////////////

void ota_init();
