cskilbeck/clock_monsieur/firmware/main/provisioning.h

//////////////////////////////////////////////////////////////////////

#pragma once

//////////////////////////////////////////////////////////////////////

#include <freertos/event_groups.h>

//////////////////////////////////////////////////////////////////////

esp_err_t provisioning_init();
char const *provisioning_pop();

//////////////////////////////////////////////////////////////////////

const int WIFI_CONNECTED_EVENT = BIT0;

extern EventGroupHandle_t wifi_event_group;
