cskilbeck/clock_monsieur/firmware/main/i2c_task.h

//////////////////////////////////////////////////////////////////////

#pragma once

//////////////////////////////////////////////////////////////////////

extern uint8_t brightness;

void i2c_task_start();
