cskilbeck/clock_monsieur/(commit log)

2025-09-27 use new i2c master driver fix tlc5948 functions prepare high side switch functions add gpio_defs.h
    [gpio_defs.h, main.cpp]
2025-09-27 use dma for spi use timer for on_frame use CS for XLAT
2025-09-27 use gptimer for on_frame put spi handler in IRAM re-enable internal I2C pullups? don't bother gpio config XLAT
2025-10-04 drive SPI2 more directly
    [tlc5948_fcntl.xlsx]
2025-10-06 fix wiper display_update() only set_dc()
    [i2c_task.h, main.cpp]
2025-10-06 full framebuffer
2025-10-12 move firmware into firmware folder
    [tlc5948_fcntl.xlsx]
2025-10-12 add pcb
    [clock_led.PrjPcb, clock_led.SchDoc, clock_led.SchLib, clock_led_face.SchDoc, clock_led_switches.SchDoc]
2025-10-16 lux calc in display.cpp fix gpio init ditch display_flip
    [display.cpp, display.h, lux.cpp, main.cpp]
2025-10-17 fix display add button.cpp/h do lux in main not display
    [button.cpp, button.h, display.cpp, gpio_defs.h, main.cpp, wifi.cpp]
2025-10-17 fix backbuffer swapping gamma2_2 no lookup table
    [button.cpp, display.cpp, lux.cpp, main.cpp]
2025-10-19 don't reset wifi credentials
    [main.cpp]
2025-10-23 fix double buffer remove qrcode
    [display.cpp, main.cpp, provisioning.cpp]
2025-11-13 [fw] clock working
    [led_positions.xlsx, partitions.csv]
2025-11-13 [pcb] noodle
    [clock_led.PcbDoc, clock_led.PrjPcb, clock_led.SchDoc, clock_led.SchLib, clock_led_face.SchDoc]
2025-11-14 [fw] fix timezone db api
    [clock_time.cpp, main.cpp]
2025-11-16 fade clock, prepare proper provisioning
    [partitions.csv]
2025-11-19 gen_sec.py works in esp-idf venv button 2 forces provisioning
2025-11-22 ota v0.1
    [clock_led.SchDoc]
2025-11-25 prepare to fix provisioning wait for sntp more correctly
    [clock_time.cpp, provisioning.cpp]
2025-11-29 pcb buttons, sensor, resistors
    [clock_led.PcbDoc, clock_led.PcbLib, clock_led.PrjPcb, clock_led.SchDoc, clock_led.SchLib]
2025-11-29 wait for dst, ota delay fixed
    [clock_time.cpp, ota.cpp]
2025-11-30 pcb noodle
    [clock_led.PcbDoc, clock_led.SchDoc]
2025-12-03 tz noodle delete qr_code_pdf/ prepare to fix settings file format
    [settings.h, timezone.cpp, timezone_data.h]
2025-12-04 settings save/load factory reset
    [clock_time.cpp, main.h, settings.cpp, settings.h, state.cpp, state.h, timezone.cpp]
2025-12-04 68k resistor for ambient photo transistor ota http retry/timeout
    [clock_led.PcbDoc, clock_led.SchDoc, clock_led.SchLib]
2025-12-05 tidy up factory reset animation prep for new hardware fix ping end message auto longest tz location name auto save settings
    [gpio_defs.h, menu.cpp, ota.cpp, ping.cpp, settings.cpp, settings.h, state.cpp]
2025-12-06 narrow font fix delay_ms() menu show ip address
    [graphics.h, menu.cpp, timezone.cpp, util.cpp, wifi.cpp, wifi.h]
2025-12-06 pcb panel
    [clock_led.PcbDoc, clock_led.PrjPcb, clock_led.SchDoc, clock_led_dual_switch.SchDoc, clock_led_panel.PcbDoc]
2025-12-07 pcb panel fix part # for R3 stock: change led driver stock: change high side switch
    [clock_led.PcbDoc, clock_led.PcbLib, clock_led.PrjPcb, clock_led.SchDoc, clock_led.SchLib, clock_led_panel.PcbDoc]
2025-12-15 enclosure for v2
    [back.SLDPRT, clock_led.step, clock_monsieur.SLDASM, enclosure.SLDASM, front.SLDPRT, glass.SLDPRT, screw_st2_2x6_5_c_0.SLDPRT]
2025-12-17 noodle enclosure v2
    [back.SLDPRT, clock_monsieur.SLDASM, enclosure.SLDASM, front.SLDPRT, glass.SLDPRT, screw_st2_2x6_5_c_0.SLDPRT, stand.SLDPRT]
2025-12-18 pcb high side switch part, buttons
    [clock_led.PcbDoc, clock_led.PcbLib, clock_led.SchDoc, clock_led.SchLib, clock_led_dual_switch.SchDoc, clock_led_panel.PcbDoc]
2025-12-19 enclosure JLCPCB06
    [back.SLDPRT, clock_led.step, clock_led_pcb.SLDPRT, clock_monsieur.SLDASM, enclosure.SLDASM, front.SLDPRT, screw_st2_2x6_5_c_0.SLDPRT, stand.SLDPRT]
2025-12-19 production files, PCB tweaks
    [clock_led.PcbDoc]
2025-12-19 font command, tweak fixed brightness
    [clock_time.cpp, lux.cpp, settings.cpp]
2026-01-28 adc for ambient sensor display gpios for JLCPCB08
2026-02-20 fix diodes
    [clock_led.PcbDoc, clock_led.PcbLib, clock_led.SchDoc, clock_led.SchLib]
2026-02-23 old enclosure add buzzer.cpp/h fix state struct buffer
    [back.SLDPRT, clock_led_pcb.SLDPRT, clock_monsieur.SLDASM, enclosure.SLDASM, front.SLDPRT, glass.SLDPRT, stand.SLDPRT]
2026-03-02 buzzer square wave
    [clock_led.PcbDoc, clock_led.SchLib]
2026-03-02 buzzer rmt with adsr
    [buzzer.cpp, buzzer.h, melodies.h]
2026-03-02 add countdown timer
2026-03-06 lower case pin with length 6
2026-03-19 add led_test_state fix ota fail bug update settings defaults
    [menu.cpp, ota.cpp, settings.h, state.cpp, state.h, version.h]
